Fred-Guo0422/H93_LDCU_EOL_TESTER/document/产品图纸/H93_左域控制器LDCU成品接口_20221212.pdf

版本记录 Project | H93 Product | 左域控制器 序号 | 版本 | 描述 | 作者 | 日期 1 | V1.0 | 1,初版整理输出 | 陈武/陈敏其 | 2022/12/15 小鹏汽车

| J1_J2_J4_J5_J10_J11连接器

接插件信息

| 工作电流 | 电源类型 | 常电
| 最大电流 | 持续时间
| 堵转电流(若有） | 持续时间
线束端 | TE:284972-1 TE:06-51061-1 TE:284972-2 TE:1-1718484-1 TE:06-51061-2 TE:114-18721 TE:06-51061-3 TE:284972-3 TE:936619-2 TE:2302454-1 电器端 TE:114-61045 TE:2401924-1 电气信息（12V)

PIN脚定义
序号 | PIN脚号 | 缩写功能 | 功能 | 电流 | 信号去向 | 信号类型 | 备注
Pressfit：2323854-2 连接器：06-51061-1 线端：284972-1(0.64*52)
1 | J1-1 | J_DO_LS_12VPWR2RLY | 500mA | 低边输出
2 | J1-2 | J_DO_LS_REOPRly | 500mA | 低边输出
3 | J1-3 | J_ECANH | 100mA | CAN
4 | J1-4 | J_ECANL | 100mA | CAN
5 | J1-5 | J_DI_SlowChargeWake_HS | 10mA | 高边输入
6 | J1-6 | J_DI_BrakeSw1_HS | 10mA | 高边输入
7 | J1-7 | J_LFDrive_IMMO_N | 2A | 低频天线驱动
8 | J1-8 | J_LFDrive_IMMO_P | 2A | 低频天线驱动
9 | J1-9 | J_LFDrive_PassengerDoor_P | 2A | 低频天线驱动
10 | J1-10 | J_LFDrive_PassengerDoor_N | 2A | 低频天线驱动
11 | J1-11 | J_LFDrive_TailBumper_N | 2A | 低频天线驱动
12 | J1-12 | J_LFDrive_TailBumper_P | 2A | 低频天线驱动
13 | J1-13 | J_LFDrive_Forward_N | 2A | 低频天线驱动
14 | J1-14 | J_DO_LS_12VPower1 | 500mA | 低边输出
15 | J1-15 | J_DO_LS_VaccumPumpRly | 500mA | 低边输出
16 | J1-16 | | 500mA | 低边输出
17 | J1-17 | J_DO_LS_CarpetLight | 500mA | 低边输出
18 | J1-18 | J_DI_QuickChargeWake_HS | 10mA | 高边输入
19 | J1-19 | Sensor_GND | 500mA | GND
20 | J1-20 | NC
21 | J1-21 | Sensor_GND | 500mA | GND
22 | J1-22 | NC
23 | J1-23 | NC
24 | J1-24 | J_LFDrive_DrvDoor_N | 2A | 低频天线驱动
25 | J1-25 | J_LFDrive_DrvDoor_P | 2A | 低频天线驱动
26 | J1-26 | J_LFDrive_Forward_P | 2A | 低频天线驱动
27 | J1-27 | J_PO_DiffuseCeilingLamp | 500mA | 低边输出
28 | J1-28 | Sensor_GND | 500mA | GND
29 | J1-29 | J_DI_DCULifeBeat_Wake_LS | 10mA | 低边输入
30 | J1-30 | J_DI_SRSCrash_LS | 10mA | 低边输入
31 | J1-31 | Sensor_GND | 500mA | GND
32 | J1-32 | Sensor_GND | 500mA | GND
33 | J1-33 | Sensor_GND | 500mA | GND
34 | J1-34 | NC
35 | J1-35 | Sensor_GND | 500mA | GND
36 | J1-36 | Sensor_GND | 500mA | GND
37 | J1-37 | Sensor_GND | 500mA | GND
38 | J1-38 | Sensor_GND | 500mA | GND
39 | J1-39 | J_LFDrive_Trunk_P | 2A | 低频天线驱动
40 | J1-40 | J_DO_LS_CWCEN | 500mA | 低边输出
41 | J1-41 | Sensor_GND | 500mA | GND
42 | J1-42 | Sensor_GND | 500mA | GND
43 | J1-43 | Sensor_GND | 500mA | GND
44 | J1-44 | J_DI_TrunkOpenSw_LS | 10mA | 低边输入
45 | J1-45 | J_DI_RLDoorReleaseSW_LS | 10mA | 低边输入
46 | J1-46 | J_DI_EmergencyAlarmSw_LS | 10mA | 低边输入
47 | J1-47 | J_DI_BrakeSw2_HS | 10mA | 高边输入
48 | J1-48 | NC
49 | J1-49 | NC
50 | J1-50 | Sensor_GND | 500mA | GND
51 | J1-51 | Sensor_GND | 500mA | GND
52 | J1-52 | J_LFDrive_Trunk_N | 2A | 低频天线驱动
Pressfit：2323854-2 连接器：06-51061-2 线端：284972-2(0.64*52)
1 | J2-1 | J_DI_KL15_BackUp_HS | 10mA | 低边输入
2 | J2-2 | J_5V_SensorPower2 | 100mA | 电源输出
3 | J2-3 | J_DO_HS_BMSEmergencyStop | 500mA | 高边输出
4 | J2-4 | J_DO_HS_KL15_BackUp | 1A | KL15电源输出
5 | J2-5 | J_DO_HS_PM2.5_FANCtr | 500mA | 高边输出
6 | J2-6 | J_DO_LS_RLDoorHandleLight | 500mA | 低边输出
7 | J2-7 | J_DI_FLTopLightSw_LS | 10mA | 低边输入
8 | J2-8 | J_AI_EmergencyPowerOff | 50mA | 模拟输入
9 | J2-9 | J_DO_HS_MainPowerWake1 | 1.5A | 高边输出
10 | J2-10 | J_DO_HS_KL15Wake1 | 1.5A | 高边输出

11 | J2-11 | J_AI_SeatRowSecLtSBRSt | 50mA | 模拟输入 12 | J2-12 | J_DO_HS_CDCUWake | 1.5A | 高边输出 13 | J2-13 | J_DO_HS_CDCWake | 1.5A | 高边输出 14 | J2-14 | J_PI_DriveHVIL_Fb | 10mA | PWM输入 15 | J2-15 | Sensor_GND | 500mA | GND 16 | J2-16 | Sensor_GND | 500mA | GND 17 | J2-17 | NC 18 | J2-18 | J_DI_RLTopLightSw_LS | 10mA | 低边输入 19 | J2-19 | J_DI_AeriaReadLampSW_LS | 10mA | 数字输入 20 | J2-20 | J_AI_ThirdRowLtSBRSt | 10mA | 模拟输入 21 | J2-21 | J_DI_BrakeFluidLevel_LS | 10mA | 低边输入 22 | J2-22 | J_DI_ThirdRowBeltMid_LS | 10mA | 数字输入 23 | J2-23 | J_DI_RLVoiceSw_LS | 10mA | 低边输入 24 | J2-24 | J_AI_DrvSeatTemp | 10mA | 模拟输入 25 | J2-25 | J_DO_HS_CameraHeated | 3A | 高边输出 26 | J2-26 | J_DO_HS_MainPowerWake2 | 1.5A | 高边输出 27 | J2-27 | J_PI_ChargeHVIL_Fb | 10mA | PWM输入 28 | J2-28 | NC 29 | J2-29 | Sensor_GND | 500mA | GND 30 | J2-30 | J_DI_RLDoorAjarSW_LS | 10mA | 低边输入 31 | J2-31 | J_DI_RLOutHandle_LS | 10mA | 低边输入 32 | J2-32 | J_DI_ThirdRowBeltLt_LS | 10mA | 数字输入 33 | J2-33 | J_AI_DrvSeatAdjSwBackInc | 10mA | 模拟输入 34 | J2-34 | J_PI_DrvSeatHeightHALLFb | 10mA | PWM输入 35 | J2-35 | J_AI_DrvSeatAdjSwSld | 10mA | 模拟输入 36 | J2-36 | J_AI_AbatVentOpenSw_LS | 10mA | 模拟输入 37 | J2-37 | J_DO_HS_ReverseLamp | 1.5A | 高边输出 38 | J2-38 | J_DO_HS_IntLgthPower | 500mA | 高边输出 39 | J2-39 | J_DO_HS_LampLimpHomeOut | 1A | 高边输出 40 | J2-40 | J_PI_DrvSeatBackIncHALLFb | 10mA | PWM输入 41 | J2-41 | J_PI_AbatVentHALLFb | 10mA | PWM输入 42 | J2-42 | J_PI_RLWindow_HallFb1 | 10mA | PWM输入 43 | J2-43 | J_DI_RLDoorPawlSW_LS | 10mA | 数字输入 44 | J2-44 | J_PI_RLWindow_HallFb2 | 10mA | PWM输入 45 | J2-45 | J_PI_DrvSeatSldHALLFb | 10mA | PWM输入 46 | J2-46 | J_AI_DrvSeatAdjSwHei | 10mA | 模拟输入 47 | J2-47 | J_AI_ASCtrSw | 10mA | 模拟输入 48 | J2-48 | J_AI_DrvSeatAdjSwFrntHei | 10mA | 模拟输入 49 | J2-49 | J_AI_SRLAbatVentSw | 10mA | 模拟输入 50 | J2-50 | J_DO_HS_LCarpetLight | 3.2A | 全桥驱动 51 | J2-51 | J_HBridge_RSHCCtr- | 3.2A | 全桥驱动 52 | J2-52 | J_DO_HS_RDCUWake | 1A | 高边输出 Pressfit：2323881-4, 2323889-2 连接器：114-18721 线端：1-1718484-1(1.5*18+2.8*7) 1 | J4-1 | J_DO_HS_BrakeLamp | 5A | 高边输出 2 | J4-2 | J_DO_HS_IMSPower | 5A | 高边输出 3 | J4-3 | J_Hbridge_DrvSeatFrntHei+ | 20A | 全桥驱动 4 | J4-4 | J_Hbridge_DrvSeatBackInc- | 20A | 全桥驱动 5 | J4-5 | SteeringWheelHeatedReturn | 20A | 全桥驱动 6 | J4-6 | J_HBridge_AbatVentCtr+ | 20A | 全桥驱动 7 | J4-7 | J_HBridge_AbatVentCtr- | 20A | 全桥驱动 8 | J4-8 | J_Hbridge_DrvSeatHei- | 30A | 全桥驱动 9 | J4-9 | J_Hbridge_DrvSeatHei+ | 30A | 全桥驱动 10 | J4-10 | J_HBridge_RLDoorLockCtr+ | 4.4A | PWM全桥驱动 11 | J4-11 | J_HBridge_RLDoorLockCtr- | 4.4A | PWM全桥驱动 12 | J4-12 | J_HBridge_RLHandleCtr- | 1.1A/12A | 全桥驱动 13 | J4-13 | J_HBridge_RLHandleCtr+ | 1.1A/12A | 全桥驱动 14 | J4-14 | Sensor_GND | 500mA | GND 15 | J4-15 | J_DO_HS_LtSlideDoor | 2A/5A | 高边输出 16 | J4-16 | J_DO_HS_MainPowerWake3 | 3A | 高边输出 17 | J4-17 | J_DO_HS_Backlight | 500mA | 高边驱动 18 | J4-18 | J_DO_HS_ATLPower | 2A | 高边驱动 19 | J4-19 | J_Hbridge_EPBCtr+ | 30A | 全桥驱动 20 | J4-20 | J_Hbridge_EPBCtr- | 30A | 全桥驱动 21 | J4-21 | Sensor_GND | 500mA | GND 22 | J4-22 | J_HBridge_FLCinchMotorCtr- | 30A | PWM全桥驱动 23 | J4-23 | J_HBridge_FLCinchMotorCtr+ | 30A | PWM全桥驱动 24 | J4-24 | J_Hbridge_RLWindowCtr+ | 12A/31A | 全桥驱动 25 | J4-25 | J_Hbridge_RLWindowCtr- | 12A/31A | 全桥驱动 Pressfit：2323854-2 连接器：06-51061-3 线端：284972-3(0.64*52) 1 | J5-1 | J_PCANH | 100mA | PCAN_H 2 | J5-2 | J_PO_LS_FLTopLight | 500mA | PWM低边输出 3 | J5-3 | J_PO_LS_FRTopLight | 500mA | PWM低边输出 4 | J5-4 | J_PO_LS_FMTopLight | 500mA | PWM低边输出 5 | J5-5 | J_PO_LS_RLTopLight | 500mA | PWM低边输出 6 | J5-6 | J_PO_LS_TLTopLight | 500mA | PWM低边输出 7 | J5-7 | J_PO_LS_TrunkLight | 500mA | PWM低边输出 8 | J5-8 | J_ICANH | 100mA | ICAN_H 9 | J5-9 | J_ICANL | 100mA | ICNA_L 10 | J5-10 | J_AI_ChargeTemp3 | 10mA | 模拟输入 11 | J5-11 | J_UWBCANH | 100mA | UWBCAN_H 12 | J5-12 | J_UWBCANL | 100mA | UWBCAN_L 13 | J5-13 | J_LIN_LSU/Heated | 50mA | LIN 通讯 14 | J5-14 | J_PCANL | 100mA | PCAN_L 15 | J5-15 | J_DO_HS_IMS_Heated | 3.2A | 全桥驱动 16 | J5-16 | J_PO_ChargeHVILOut | 500mA | PWM输出 17 | J5-17 | Sensor_GND | 500mA | GND 18 | J5-18 | NC 19 | J5-19 | NC 20 | J5-20 | J_DI_FRTopLightSw_LS | 10mA | 低边输入 21 | J5-21 | J_DI_RLChildLockOrDoorOpen_LS | 10mA | 低边输入 22 | J5-22 | NC 23 | J5-23 | J_AI_PDUTempSensor2 | 50mA | 模拟输入 24 | J5-24 | J_AI_ChargeDirectTemp4 | 50mA | 模拟输入 25 | J5-25 | J_LIN_PWS | 50mA | LIN通讯 26 | J5-26 | J_LIN_RFR | 50mA | LIN通讯

27 | J5-27 | J_HBridge_LSHCCtr- | 3.2A | 全桥驱动 28 | J5-28 | J_LIN_FKS | 50mA | LIN通讯 29 | J5-29 | NC 30 | J5-30 | NC 31 | J5-31 | J_DI_RSHCPosSW_LS | 10mA | 低边输入 32 | J5-32 | J_DI_TLTopLightSw_LS | 10mA | 数字输入 33 | J5-33 | NC 34 | J5-34 | J_AI_ChargeDirectTemp3 | 50mA | 模拟输入 35 | J5-35 | J_AI_MotorWaterTempSensorB | 50mA | 模拟输入 36 | J5-36 | J_AI_ChargeTemp2 | 50mA | 模拟输入 37 | J5-37 | J_AI_ChargeDirectTemp2 | 50mA | 模拟输入 38 | J5-38 | J_AI_PDUTempSensor1 | 50mA | 模拟输入 39 | J5-39 | J_AI_AccPositionSensor1 | 50mA | 模拟输入 40 | J5-40 | J_HBridge_LChildLockCtr- | 4.4A/6A | 全桥驱动 41 | J5-41 | J_HBridge_Reserve2- | 1.8A | 全桥驱动 42 | J5-42 | J_5V_SensorPower1 | 100mA | 电源输出 43 | J5-43 | J_DO_HS_HallPower | 500mA | 电源输出 44 | J5-44 | J_5V_SENSOR_POWER3 | 100mA | 电源输出 45 | J5-45 | J_DI_RLHandleExtSw | 10mA | 低边输入 46 | J5-46 | J_PI_PM2.5DendityFb | 10mA | PWM输入 47 | J5-47 | J_AI_AccPositionSensor2 | 50mA | 模拟输入 48 | J5-48 | J_AI_RLWindowCtrSw | 10mA | 模拟输入 49 | J5-49 | J_AI_ChargeDirectTemp1 | 50mA | 模拟输入 50 | J5-50 | J_AI_ChargeTemp1 | 50mA | 模拟输入 51 | J5-51 | J_AI_BatteryWaterTempSensorB | 10mA | 模拟输入 52 | J5-52 | J_DI_MLTopLightSw_LS | 10mA | 数字输入 Pressfit：1823524-2 连接器：114-61045 线端：936619-2(9.5*2) 1 | J10-1 | BAT | 50A | 电源输入 | KL30电源 2 | J10-2 | GND | 50A | 电源接地 | 搭铁接地 2 PIN 2401924-1 | 线端型号：2302454-1 1 | J11_1 | J_PHY_TRX_M | 50mA | 以太网 | 以太网 2 | J11_2 | J_PHY_TRX_P

| J3连接器
接插件信息 | 线束端 | TE:2321525-1
| 电器端 | TE:114-160307-1
电气信息（12V) | 工作电流 | | 电源类型 | 常电
| 最大电流 | | 持续时间
| 堵转电流(若有） | | 持续时间

PIN脚定义

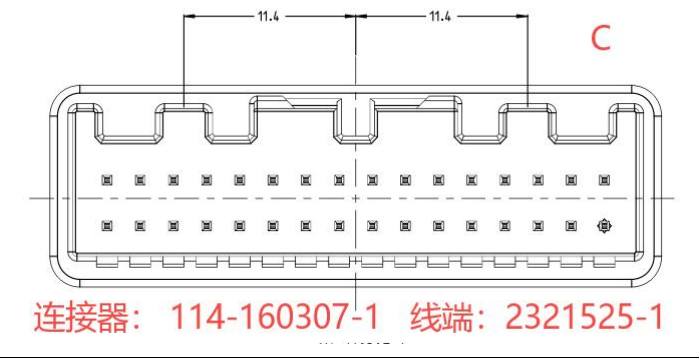
[picture p1: figure]
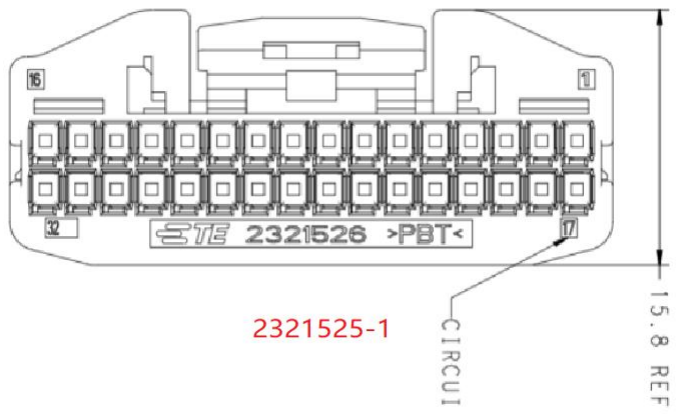
[picture p2: figure]

序号 | PIN脚号 | 缩写功能 | 功能 | 电流 | 信号去向 | 信号类型 | 备注
Pressfit：2323854-2 连接器： 114-160307-1 | 线端：2321525-1(0.64*32)
1 | J3-1 | NC
2 | J3-2 | J_LIN_AGS/EBS | 50mA | | LIN 通信
3 | J3-3 | J_AI_BatteryWaterTempSensorA | 100mA | | 模拟输入
4 | J3-4 | J_AI_VacuumPressSensor | 100mA | | 模拟输入
5 | J3-5 | Sensor_GND | 500mA | | GND
6 | J3-6 | J_5V_SENSOR_POWER2 | 100mA | | 供电输出
7 | J3-7 | J_CCANH | 100mA | | CCAN_H
8 | J3-8 | J_CCANL | 100mA | | CCAN_L
9 | J3-9 | J_AI_MotorWaterTempSensorA | 100mA | | 模拟输入
10 | J3-10 | J_DO_LS_BatteryPumpRly | 500mA | | 低边输出
11 | J3-11 | J_DO_LS_FanRly | 500mA | | 低边输出
12 | J3-12 | J_PO_LS_LCarpetLight | 500mA | | PWM低边输出
13 | J3-13 | J_DO_LS_FEOPRly | 500mA | | 低边输出
14 | J3-14 | J_DO_LS_MotorPumpRly | 500mA | | 低边输出
15 | J3-15 | J_PO_LS_FanSpeedCtr | 500mA | | PWM输出
16 | J3-16 | J_PO_LS_MotorPumpSpeedCtr | 500mA | | PWM输出
17 | J3-17 | Sensor_GND | 500mA | | GND
18 | J3-18 | NC
19 | J3-19 | J_DI_BrakeFluidLevel_LS | 10mA | 数字低边输入
20 | J3-20 | Sensor_GND | 500mA | | GND
21 | J3-21 | NC
22 | J3-22 | NC
23 | J3-23 | Sensor_GND | 500mA | | GND
24 | J3-24 | NC
25 | J3-25 | J_DO_HS_FSRRPower | 2A | | 高边输出
26 | J3-26 | J_PI_AbatVentHALLFb2 | 50mA | | PWM输入
27 | J3-27 | J_PI_FanFb | 100mA | | PWM输入
28 | J3-28 | J_PI_AbatVentHALLFb1 | 50mA | | PWM输入
29 | J3-29 | Sensor_GND | 500mA | | GND
30 | J3-30 | J_PO_DriveHVILOut | 500mA | | PWM输出
31 | J3-31 | J_DI_VacuumPumpRlyFb_HS | 50mA | | 数字输入
32 | J3-32 | J_DO_LS_DeforstrRly | 500mA | | 低边输出

| J8_J9连接器
接插件信息 | 线束端 | TE:2322347-1 TE:2325415-1
| 电器端 | TE:114-101068-1 TE:1379779
电气信息（12V) | 工作电流 | | 电源类型 | 常电
| 最大电流 | | 持续时间
| 堵转电流(若有） | | 持续时间

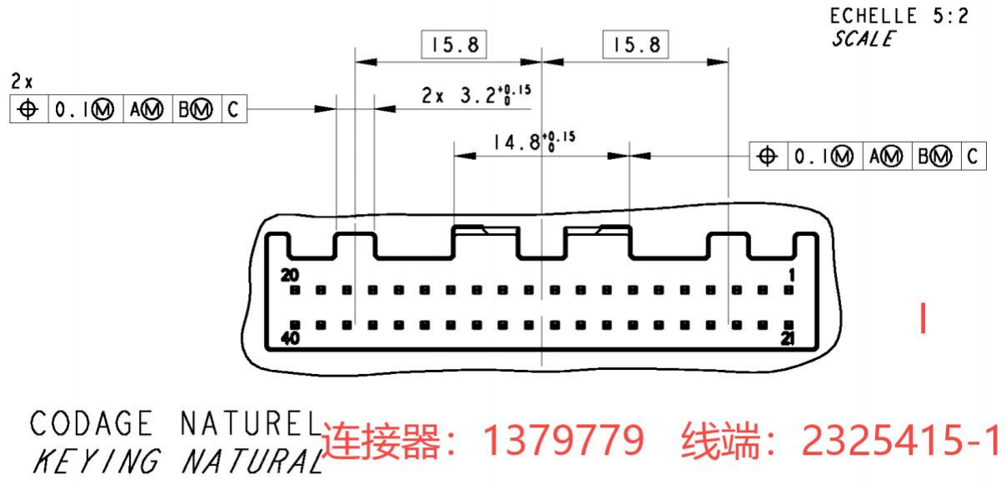
[picture p3: figure]

PIN脚定义

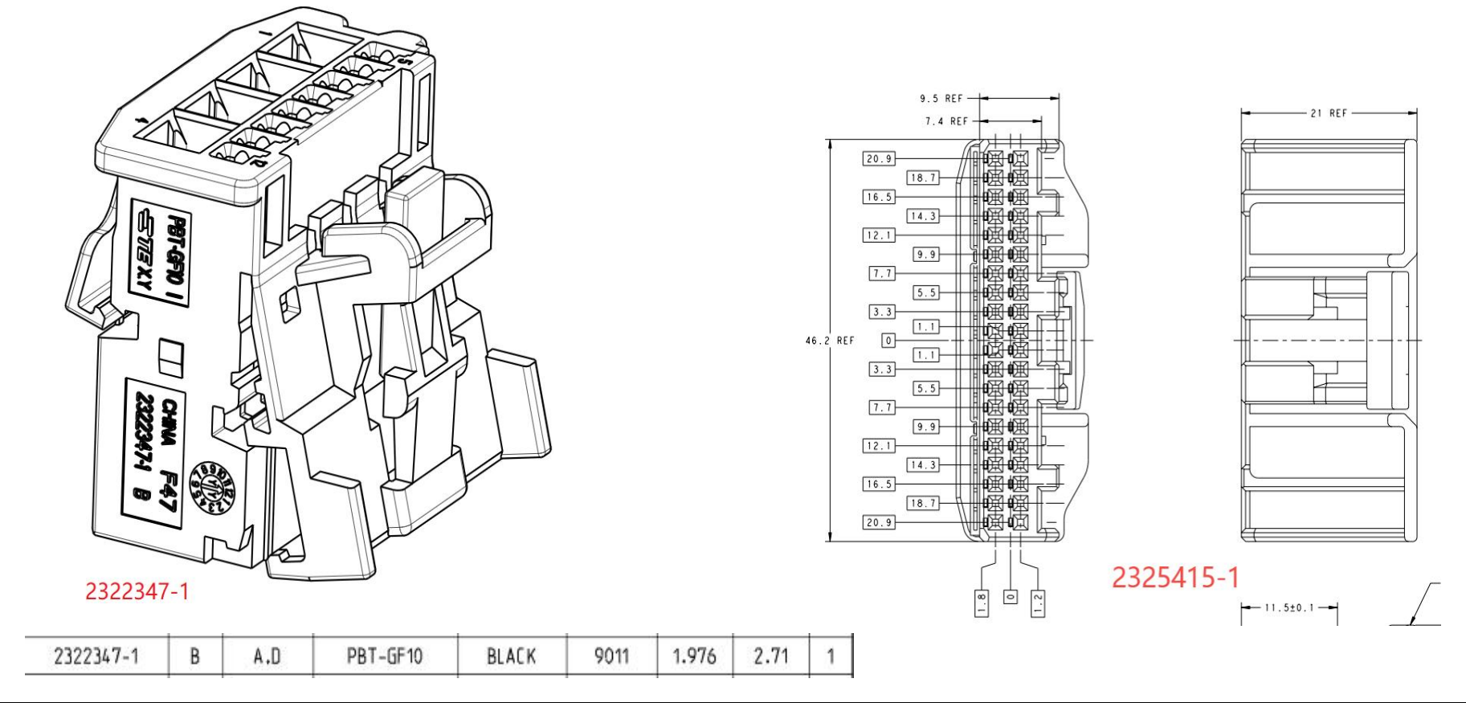
[picture p4: figure]

序号 | PIN脚号 | 缩写功能 | 功能 | 电流 | 信号去向 | 信号类型 | 备注
Pressfit：2323854-2, 2323889-2 连接器：114-101068-1 线端：2322347-1(0.64*8+2.8*4)
1 | J8-1 | J_HBridge_FLHandleCtr+ | 1.1A/12A | 全桥驱动
2 | J8-2 | J_HBridge_FLCWindowCtr- | 12A/31A | 全桥驱动
3 | J8-3 | J_HBridge_FLCWindowCtr+ | 12A/31A | 全桥驱动
4 | J8-4 | J_DO_HS_LeftMirrorHeated | 5A | 高边驱动
5 | J8-5 | J_HBridge_FLHandleCtr- | 1.1A/12A | 全桥驱动
6 | J8-6 | J_HBridge_FMirrorFoldCtr- | 2A | 全桥驱动
7 | J8-7 | J_HBridge_FMirrorFoldCtr+ | 2A | 全桥驱动
8 | J8-8 | J_DO_HS_IntLgthPower | 500mA | 高边驱动
9 | J8-9 | J_HBridge_FMirrorLRCtr- | 2A | 全桥驱动
10 | J8-10 | J_HBridge_FMirrorCtr+ | 2A | 全桥驱动
11 | J8-11 | J_DO_HS_HallPower | 500mA | 高边输出
12 | J8-12 | J_HBridge_FMirrorUDCtr- | 2A | 全桥驱动
Pressfit：2323854-2 连接器：1379779 | 线端：2325415-1(0.64*40)
1 | J9-1 | J_PI_FLWindow_HallFb2 | 10mA | PWM输入
2 | J9-2 | J_DI_FLDoorReleaseSW_LS | 10mA | 低边输入
3 | J9-3 | J_DI_FLOutHandle_LS | 10mA | 低边输入
4 | J9-4 | J_DI_FLDoorLockOrOutHandle_LS | 10mA | 低边输入
5 | J9-5 | J_DO_HS_ATLPower | 2A | 高边输出
6 | J9-6 | J_DO_LS_LBSDLight | 500mA | 低边输出
7 | J9-7 | J_DO_HS_WinLockLight | 500mA | 高边输出
8 | J9-8 | J_PO_LS_LCarpetLight | 500mA | 低边输出
9 | J9-9 | J_DO_LS_LDOWLight | 500mA | 低边输出
10 | J9-10 | J_DO_LS_LFDoorHandleLight | 500mA | 低边输出
11 | J9-11 | J_DO_HS_Backlight | 2A | 高边输出
12 | J9-12 | Sensor_GND | 500mA | GND
13 | J9-13 | Sensor_GND | 500mA | GND
14 | J9-14 | Sensor_GND | 500mA | GND
15 | J9-15 | Sensor_GND | 500mA | GND
16 | J9-16 | Sensor_GND | 500mA | GND
17 | J9-17 | J_AI_LMirrorTemp | 10mA | 模拟输入
18 | J9-18 | J_AI_DRLWindowCtrSw | 10mA | 模拟输入
19 | J9-19 | J_DI_FLGearHomeSW_LS | 10mA | 数字输入
20 | J9-20 | J_HBridge_FLDoorLockCtr+ | 4.4A | PWM全桥驱动
21 | J9-21 | J_PI_FLWindow_HallFb1 | 10mA | PWM 输入
22 | J9-22 | J_DI_FLDoorAjarSW_LS | 10mA | 低边输入
23 | J9-23 | J_5V_SensorPower3 | 100mA | 电源输出
24 | J9-24 | J_DI_CentralOpenLockSw_LS | 10mA | 低边输入
25 | J9-25 | J_DI_CentralCloseLockSw_LS | 10mA | 低边输入
26 | J9-26 | J_DI_LFHandleExtSw | 10mA | 低边输入
27 | J9-27 | J_DI_LFHandleRetSw | 10mA | 低边输入
28 | J9-28 | J_AI_MirrorDirSw | 10mA | 模拟输入
29 | J9-29 | J_DI_FLDoorHomeSwitch_LS | 10mA | 数字输入
30 | J9-30 | J_AI_MirrorSelectSw | 10mA | 模拟输入
31 | J9-31 | J_AI_LMirrorLRPositionFb | 10mA | 模拟输入
32 | J9-32 | J_AI_DRRWindowCtrSw | 10mA | 模拟输入
33 | J9-33 | J_AI_LMirrorUDPositionFb | 10mA | 模拟输入
34 | J9-34 | J_AI_DFRWindowCtrSw | 10mA | 模拟输入
35 | J9-35 | J_AI_DFLWindowCtrSw | 10mA | 模拟输入
36 | J9-36 | J_DI_WinLockSw_LS | 10mA | 低边输入
37 | J9-37 | J_DI_FLDoorPawlSW_LS | 10mA | 数字输入
38 | J9-38 | Sensor_GND | 500mA | GND
39 | J9-39 | J_DI_FLDoorOpenSw_LS | 10mA | 低边输入
40 | J9-40 | J_HBridge_FLDoorLockCtr- | 4.4A | PWM全桥驱动

| J6_J7连接器
接插件信息 | 线束端 | TE:2322347-2 TE:2329592-1
| 电器端 | TE:114-101068-2 TE:114-101074
电气信息（12V) | 工作电流 | | 电源类型 | 常电
| 最大电流 | | 持续时间
| 堵转电流(若有） | | 持续时间

PIN脚定义

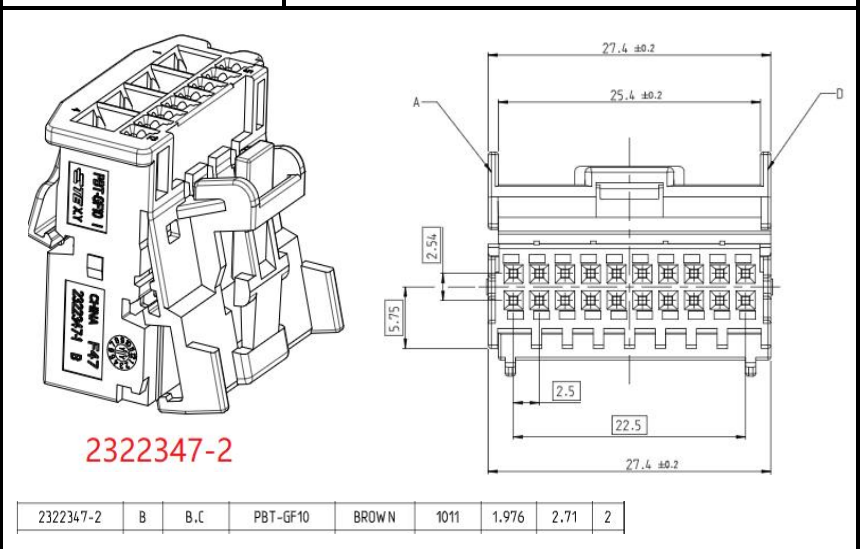
[picture p5: figure]

序号 | PIN脚号 | 缩写功能 | 功能 | 电流 | 信号去向 | 信号类型 | 备注
Pressfit：2323854-2, 2323889-2 连接器：114-101068-2 | 线端：2322347-2(0.64*8+2.8*4)
1 | J6-1 | J_DO_HS_SteeringWheelHeatedCtr | 10A | 高边输出
2 | J6-2 | J_Hbridge_ESCCUUpDown+ | 10A | 全桥驱动
3 | J6-3 | J_Hbridge_ESCCUForwardBackward+ | 10A | 全桥驱动
4 | J6-4 | J_Hbridge_ESCCUCom+ | 10A | 全桥驱动
5 | J6-5 | J_PO_LS_LFootLight | 500mA | 低边驱动
6 | J6-6 | Sensor_GND | 500mA | GND
7 | J6-7 | NC
8 | J6-8 | Sensor_GND | 500mA | GND
9 | J6-9 | J_PI_ESCCUpDown_HallFb | 100mA | PWM输入
10 | J6-10 | J_PI_ESCCUForwardBackward_HallFb | 100mA | PWM输入
11 | J6-11 | J_5V_SENSOR_POWER1 | 100mA | 电源输出
12 | J6-12 | J_AI_GearShift_N2 | 10mA | 模拟输入
Pressfit：2323854-2, 2323889-2 连接器：114-101074 | 线端：2329592-1
1 | J7-1 | J_DO_HS_HallPower | 500mA | 高边输出
2 | J7-2 | J_DO_HS_IntLgthPower | 500mA | 高边输出
3 | J7-3 | Sensor_GND | 500mA | GND
4 | J7-4 | NC
5 | J7-5 | NC
6 | J7-6 | J_AI_GearShift_R2 | 10mA | 模拟输入
7 | J7-7 | J_AI_GearShift_R1 | 10mA | 模拟输入
8 | J7-8 | J_AI_GearShift_N1 | 10mA | 模拟输入
9 | J7-9 | J_AI_GearShift_P1 | 10mA | 模拟输入
10 | J7-10 | J_AI_GearShift_D2 | 10mA | 模拟输入
11 | J7-11 | J_DO_HS_SWSPower | 3A | 高边输出
12 | J7-12 | J_DO_HS_Backlight | 1A | 高边输出
13 | J7-13 | J_DO_HS_ATLPower | 2A | 高边输出
14 | J7-14 | J_AI_SteeringWheelTemp | 10mA | 模拟输入
15 | J7-15 | J_AI_InCarTempSensor | 10mA | 模拟输入
16 | J7-16 | J_AI_AtmosphericPressSensor | 10mA | 模拟输入
17 | J7-17 | J_AI_GearShift_P2 | 10mA | 模拟输入
18 | J7-18 | Sensor_GND | 500mA | GND
19 | J7-19 | Sensor_GND | 500mA | GND
20 | J7-20 | J_AI_GearShift_D1 | 10mA | 模拟输入
