Fred-Guo0422/H93_LDCU_EOL_TESTER/document/产品图纸/H93_左域_LDCU_EOL测试通信协议_V1.5-20230414.pdf

版本记录 Project | H93
Product | 左域
序号 | 版本 | 描述 | 作者 | 日期
1 | V1.0 | 1.初版创建输出 | 陈敏其 | 2022/12/16
2 | V1.1 | 1.增加配置信息 | 陈敏其 | 2023/1/13
3 | V1.2 | 1.更新测试协议项目名称与连接器位置，更新DID内容 | 陈敏其 | 2023/2/22
4 | V1.3 | 1.根据LDCU_EMC_Protocol_SR1.0_202300403修改 | 陈敏其 | 2023/4/6
5 | V1.4 | 1.修正PO部分的start bit协议 | 陈敏其 | 2023/4/12
5 | V1.5 | 1.修正PO部分协议 | 陈敏其 | 2023/4/14

# 小鹏汽车

# H93左域程序烧录流程

小鹏汽车

# 小鹏汽车

# H93左域诊断通信为CANFD

# H93左域PCBA FCT功能测试流程


# 小鹏汽车

# 小鹏汽车

# 基于UDS on CANFD标准进行通信: 1, EOL模式进入: 分别发送10 03和10 60，分别获取到正反馈50 03 XX XX XX XX

# XX XX和50 60 XX XX XX XX XX XX后即进入EOL测试模式 2, 安全访问: 请求Seed: 27 01，正反馈67 01 XX XX XX XX 计算Key 发送Key: 27 02 XX XX XX XX，正反馈67 02

3, RoutineControl通信: 发送请求: 31 01 + RID + Cmd_Data 获取结果: 31 03 + RID 备注: 1) 对于数字输入/模拟输入/PWM 输入等获取结果的，发

# 送命令为31 03 + RID; 2) 对于数字输出/PWM输出/电机控制输

# 出等控制信号输出，发送指令为31 01 + RID + Cmd_Data，RID 和Cmd_Data参考协议部分

# 4, 产品软重启指令11 01需要在Default模式(10 01)下发送; H93左域诊断通信为CANFD

H93左域EOL功能测试流程 基于UDS on CANFD标准进行通信: 1, EOL模式进入: 分别发送10 03和10 60，分别获取到正反馈50 03 XX XX XX XX XX XX和50 60 XX XX XX XX XX XX后即进入EOL测试模式 2, 安全访问: 请求Seed: 27 01，正反馈67 01 XX XX XX XX 计算Key 发送Key: 27 02 XX XX XX XX，正反馈67 02 3, RoutineControl通信: 发送请求: 31 01 + RID + Cmd_Data 获取结果: 31 03 + RID 备注: 1) 对于数字输入/模拟输入/PWM 输入等获取结果的，发 送命令为31 03 + RID; 2) 对于数字输出/PWM输出/电机控制输 出等控制信号输出，发送指令为31 01 + RID + Cmd_Data，RID 和Cmd_Data参考协议部分 4, 产品软重启指令11 01需要在Default模式(10 01)下发送; H93左域诊断通信为CANFD

| H93左域EOL测试通信协议

# 产品参数

CANFD ID: 1,Request: 0x7E0; 2,Response: 0x7E8 参数项目 | DID | UDS服务 | 读写 | 长度(Byte) | 读写格式 (UDS) | 备注
软件版本号 | 0xF189 | 22 | 读 | 17 | 22 F1 89 | 烧录/FCT/EOL 都需要读取
硬件版本号 | 0xF17F | 22 | 读 | 17 | 22 F1 7F | 烧录/FCT/EOL 都需要读取
零件物料号 | 0xF187 | 2E/22 | 读写 | 14 | 写: 2E F1 87 [零件物料号信息 ]; 读: 22 F1 87 | 零件物料号信息只需在程序烧录台写入即可 ，FCT/EOL 不需写入
基础软件版本号 | 0xA5F0 | 22 | 读 | 10 | 22 A5 F0 | 烧录/FCT/EOL 都需要读取
Boot软件版本号 | 0xF180 | 22 | 读 | 17 | 22 F1 80 | 烧录/FCT/EOL 都需要读取
产品序列号 (PCBA条码,16位) | 0xF18C | 2E/22 | 读写 | 16 | 写: 2E F1 8C [产品序列号信息 ]; 读: 22 F1 8C | 产品序列号只需在程序烧录台写入即可 ，FCT/EOL不需写入
ECU下线日期 | 0xF18B | 2E/22 | 读写 | 4 | 写: 2E F1 8B [下线日期信息 ]; 读: 22 F1 8B | 只需在EOL台写入，其他不需要
| 0xA5F5 | 2E/22 | 读写 | 24 | 写: 2E A5 F5 [追溯编码信息 ]; 读: 22 A5 F5 | 日期信息是 BCD码，如20221016则为0x20 0x22 0x10 0x16 追溯编码 只需在EOL台写入，其他不需要
钥匙参数 | 0xCF0A | 2E/22 | 读写 | 4 | 写: 2E CF 0A [钥匙参数值]; 读: 22 CF 0A | 只需在EOL台写入，其他不需要 1,该参数从1开始(假如是第1个产品)，然后实行累加到 65535(假如是第65535个产品)后又重新从 1开 始; 2,发送顺序为 : 0x00(byte0) 0x00(byte1) 0x00(byte2) 0x00(byte3), 例如从0x00 0x00 0x00 0x01; 0x00 0x00 0x00 0x02 ; ... ;0x00 0x00 0xFF 0xFF进行累加,其中前面两个字节是预留的 ， 主要是用到后面两个字节 。
模块配置 | 0xCF08 | 2E/22 | 读写 | 16 | 写: 2E CF 08 [配置信息]; 读: 22 CF 08 | 只需要在烧录工站写入 ，其他不需要 Byte0:0x02 （车型代码：H93国内版） Byte1~Byte15:0x00 1.烧录：烧录完后写入 ，并在重启后读取检查 ； 2.FCT：开始测试时读取检查 ； 3.EOL：开始测试时读取检查 ；
| 0xA5F2 0x0A5F7 | 2E/22 2E/22 | 读写 读写 | 1 1 | 写: 2E A5 F2 [工厂模式值]; 读: 22 A5 F2 写: 2E A5 F7 [状态值]; 读: 22 A5 F7 | 备注：写指令： 2E CF 08 02 00 00 00 00 00 00 00 00 00 00 00 00 00 00 00 工厂模式 只需在FCT和EOL工位写入 1,FCT: 开始测试写入值 1F，并读取检查 ，测试完成后写入值 1E，并读取检查; 2,EOL: 开始测试写入值 1D，并读取检查 ，测试完成后写入值 10，并读取检查; 备注: 读取检查前需要断电重启或者软重启 (11 01); 电源模式状态 只需在EOL工位写入，并且需要在EOL其他功能都测试完后再写入
| | | | | | 1,EOL: 写入值0x00，并读取检查 ; 备注: 读取检查前需要断电重启或者软重启 (11 01);
DTC异常码查询 | DTC码 | 19 | 读 | 3 | 读: 19 04 xx xx xx FF | 只需在EOL工位读取
1,EOL: 读取xx xx xx（DTC码是否报异常 ）; 备注:需要在EOL其他功能都测试完后在读取 ; 0 J_ | J_ | 功能 | IO | Widgets | RID | RoutineControlTy | 长度 | 开始位 | 位长度 | 默认值 | 最小值 | 最大值 | Factor | Offset | 单位 | 周期(ms) | 互锁
0 Digital input | Digital input | Digital input | IO引脚 | pushButton | 0xC080 | 0x3 | 8 | 0 | 0 | 1 | 0 | 0 | 0 | 0 | 0 | - 0 M_DI_Win_RFRLIN_INH_HS | M_DI_Win_RFRLIN_INH_HS | 车窗/RFR LIN唤醒源识别 | J5-25/J5-26 | tableCell | 0xC080 | 0x3 | 8 | 0 | 1 | 0 | 0 | 1 | 1 | 0 | 0 | - 0 M_DI_PWSLIN_Wake_HS | M_DI_PWSLIN_Wake_HS | 左侧智能表面 LIN唤醒源识别 | U17_T642 | tableCell | 0xC080 | 0x3 | 8 | 1 | 1 | 0 | 0 | 1 | 1 | 0 | 0 | - 0 M_DI_ECAN_INH_HS | M_DI_ECAN_INH_HS | 预留CAN唤醒源识别 | J1-3/J1-4 | tableCell | 0xC080 | 0x3 | 8 | 2 | 1 | 0 | 0 | 1 | 1 | 0 | 0 | - 0 M_DI_CCAN_INH_HS | M_DI_CCAN_INH_HS | 预留CAN唤醒源识别 | J3-7/J3-8 | tableCell | 0xC080 | 0x3 | 8 | 3 | 1 | 0 | 0 | 1 | 1 | 0 | 0 | - 0 M_DI_ICAN_INH_HS | M_DI_ICAN_INH_HS | ICAN唤醒源识别 | J5_8/J5_9 | tableCell | 0xC080 | 0x3 | 8 | 4 | 1 | 0 | 0 | 1 | 1 | 0 | 0 | - 0 M_DI_UWBCAN_INH_HS | M_DI_UWBCAN_INH_HS | UWBCAN唤醒源识别 | J5_11/J5_12 | tableCell | 0xC080 | 0x3 | 8 | 5 | 1 | 0 | 0 | 1 | 1 | 0 | 0 | - 0 M_DI_ETNB_INT_LS | M_DI_ETNB_INT_LS | TJA1101中断输出 | U38_T122 | tableCell | 0xC080 | 0x3 | 8 | 6 | 1 | 0 | 0 | 1 | 1 | 0 | 0 | - 0 M_DI_ETH_INH | M_DI_ETH_INH | TJA1101唤醒识别 | U38_T623 | tableCell | 0xC080 | 0x3 | 8 | 7 | 1 | 0 | 0 | 1 | 1 | 0 | 0 | - 0 M_DI_NJJ290C0_INT_LS | M_DI_NJJ290C0_INT_LS | 低频驱动芯片 NJJ290C0中断反馈 ，芯片故障时反馈低电

平

U46_T572 | tableCell | 0xC080 | 0x3 | 8 | 8 | 1 | 0 | 0 | 1 | 1 | 0 | 0 | - 0 M_DI_FS6522_INTB_LS | M_DI_FS6522_INTB_LS | FS6522中断输出引脚 | U42_T353 | tableCell | 0xC080 | 0x3 | 8 | 9 | 1 | 0 | 0 | 1 | 1 | 0 | 0 | - 0 M_DI_L9369ACTOFFLS1A_FB | M_DI_L9369ACTOFFLS1A_FB | 关闭状态检测 | U29_T809 | tableCell | 0xC080 | 0x3 | 8 | 10 | 1 | 0 | 0 | 1 | 1 | 0 | 0 | - 0 M_DI_L9369ACTOFFLS2A_FB | M_DI_L9369ACTOFFLS2A_FB | U29_T914 | tableCell | 0xC080 | 0x3 | 8 | 11 | 1 | 0 | 0 | 1 | 1 | 0 | 0 | - 0 M_DI_RLHandleExtSw | M_DI_RLHandleExtSw | 左后门把手展开开关 | J5-45 | tableCell | 0xC080 | 0x3 | 8 | 12 | 1 | 0 | 0 | 1 | 1 | 0 | 0 | - 0 M_DI_RSHCPosSW_LS | M_DI_RSHCPosSW_LS | 预留 | J5-31 | tableCell | 0xC080 | 0x3 | 8 | 13 | 1 | 0 | 0 | 1 | 1 | 0 | 0 | - 0 M_DI_SRSCrash_LS | M_DI_SRSCrash_LS | 碰撞信号 | J1-30 | tableCell | 0xC080 | 0x3 | 8 | 14 | 1 | 0 | 0 | 1 | 1 | 0 | 0 | - 0 M_DI_AeriaReadLampSW_LS | M_DI_AeriaReadLampSW_LS | 二排左侧航空阅读灯开关 | J2-19 | tableCell | 0xC080 | 0x3 | 8 | 15 | 1 | 0 | 0 | 1 | 1 | 0 | 0 | - 0 M_DI_MLTopLightSw_LS | M_DI_MLTopLightSw_LS | 左中顶灯开关 | J5-52 | tableCell | 0xC080 | 0x3 | 8 | 16 | 1 | 0 | 0 | 1 | 1 | 0 | 0 | - 0 M_DI_DCULifeBeat_Wake_LS | M_DI_DCULifeBeat_Wake_LS | 右域心跳信号采样 | J1-29 | tableCell | 0xC080 | 0x3 | 8 | 17 | 1 | 0 | 0 | 1 | 1 | 0 | 0 | - 0 M_DI_LFHandleExtSw | M_DI_LFHandleExtSw | 左前门把手展开开关 | J9-26 | tableCell | 0xC080 | 0x3 | 8 | 18 | 1 | 0 | 0 | 1 | 1 | 0 | 0 | - 0 M_DI_LFHandleRetSw | M_DI_LFHandleRetSw | 左前门把手回收开关 | J9-27 | tableCell | 0xC080 | 0x3 | 8 | 19 | 1 | 0 | 0 | 1 | 1 | 0 | 0 | - 0 M_DI_VacuumPumpRlyFb_HS | M_DI_VacuumPumpRlyFb_HS | 真空泵继电器反馈 | J3-31 | tableCell | 0xC080 | 0x3 | 8 | 20 | 1 | 0 | 0 | 1 | 1 | 0 | 0 | - 0 M_DI_FLDoorHomeSwitch_LS | M_DI_FLDoorHomeSwitch_LS | 左前门HomeSwitch( 电吸门) | J9-29 | tableCell | 0xC080 | 0x3 | 8 | 21 | 1 | 0 | 0 | 1 | 1 | 0 | 0 | - 0 M_DI_TLTopLightSw_LS | M_DI_TLTopLightSw_LS | 三排顶灯开关 | J5-32 | tableCell | 0xC080 | 0x3 | 8 | 22 | 1 | 0 | 0 | 1 | 1 | 0 | 0 | - 0 M_DI_BrakeFluidLevel_LS | M_DI_BrakeFluidLevel_LS | 制动液位传感器 | J3-19/J2-21 | tableCell | 0xC080 | 0x3 | 8 | 23 | 1 | 0 | 0 | 1 | 1 | 0 | 0 | - 0 M_DI_KL15_BackUp_HS | M_DI_KL15_BackUp_HS | 左域KL15电冗余采样 | J2-1 | tableCell | 0xC080 | 0x3 | 8 | 24 | 1 | 0 | 0 | 1 | 1 | 0 | 0 | - 0 M_DI_CentralOpenLockSw_LS | M_DI_CentralOpenLockSw_LS | 中控解锁开关 | J9-24 | tableCell | 0xC080 | 0x3 | 8 | 25 | 1 | 0 | 0 | 1 | 1 | 0 | 0 | - 0 M_DI_CentralCloseLockSw_LS | M_DI_CentralCloseLockSw_LS | 中控闭锁开关 | J9-25 | tableCell | 0xC080 | 0x3 | 8 | 26 | 1 | 0 | 0 | 1 | 1 | 0 | 0 | - 0 M_DI_FLDoorAjarSW_LS | M_DI_FLDoorAjarSW_LS | 左前门开关状态 或
M_DI_FLDoorLockOrOutHandle_LS | 左前门锁状态 或 左前门半开状态 （电吸门配置 ） | J9-22 | tableCell | 0xC080 | 0x3 | 8 | 27 | 1 | 0 | 0 | 1 | 1 | 0 | 0 | - 0 M_DI_FLDoorLockOrOutHandle_LS
| 左前门外开门把手状态 （电吸门配置 ）
J9-4 | tableCell | 0xC080 | 0x3 | 8 | 28 | 1 | 0 | 0 | 1 | 1 | 0 | 0 | - 0 M_DI_FLDoorReleaseSW_LS | M_DI_FLDoorReleaseSW_LS | 主驾电释放开关信号 | J9-2 | tableCell | 0xC080 | 0x3 | 8 | 29 | 1 | 0 | 0 | 1 | 1 | 0 | 0 | - 0 M_DI_WinLockSwInput_LS | M_DI_WinLockSwInput_LS | 车窗锁止开关 | J9-36 | tableCell | 0xC080 | 0x3 | 8 | 30 | 1 | 0 | 0 | 1 | 1 | 0 | 0 | - 0 M_DI_FLGearHomeSW_LS | M_DI_FLGearHomeSW_LS | 左前门GearHome（电吸门） | J9-19 | tableCell | 0xC080 | 0x3 | 8 | 31 | 1 | 0 | 0 | 1 | 1 | 0 | 0 | - 0 M_DI_BrakeSw1_HS | M_DI_BrakeSw1_HS | 刹车开关 1 | J1-6 | tableCell | 0xC080 | 0x3 | 8 | 32 | 1 | 0 | 0 | 1 | 1 | 0 | 0 | - 0 M_DI_BrakeSw2_HS | M_DI_BrakeSw2_HS | 刹车开关 2 | J1-47 | tableCell | 0xC080 | 0x3 | 8 | 33 | 1 | 0 | 0 | 1 | 1 | 0 | 0 | - 0 M_DI_EmergencyAlarmSw_LS | M_DI_EmergencyAlarmSw_LS | 紧急报警开关 | J1-46 | tableCell | 0xC080 | 0x3 | 8 | 34 | 1 | 0 | 0 | 1 | 1 | 0 | 0 | - 0 M_DI_ThirdRowBeltLt_LS | M_DI_ThirdRowBeltLt_LS | 第三排左侧安全带检测 | J2-32 | tableCell | 0xC080 | 0x3 | 8 | 35 | 1 | 0 | 0 | 1 | 1 | 0 | 0 | - 0 M_DI_RLVoiceSw_LS | M_DI_RLVoiceSw_LS | 预留 | J2-23 | tableCell | 0xC080 | 0x3 | 8 | 36 | 1 | 0 | 0 | 1 | 1 | 0 | 0 | - 0 M_DI_FLTopLightSw_LS | M_DI_FLTopLightSw_LS | 左前顶灯开关 | J2-7 | tableCell | 0xC080 | 0x3 | 8 | 37 | 1 | 0 | 0 | 1 | 1 | 0 | 0 | - 0 M_DI_RLTopLightSw_LS | M_DI_RLTopLightSw_LS | 左后顶灯开关 | J2-18 | tableCell | 0xC080 | 0x3 | 8 | 38 | 1 | 0 | 0 | 1 | 1 | 0 | 0 | - 0 M_DI_FRTopLightSw_LS | M_DI_FRTopLightSw_LS | 右前顶灯开关 | J5-20 | tableCell | 0xC080 | 0x3 | 8 | 39 | 1 | 0 | 0 | 1 | 1 | 0 | 0 | - 0 M_DI_RLDoorReleaseSW_LS | M_DI_RLDoorReleaseSW_LS | 左后内开释放开关 | J1-45 | tableCell | 0xC080 | 0x3 | 8 | 40 | 1 | 0 | 0 | 1 | 1 | 0 | 0 | - 0 M_DI_TrunkOpenSw_LS | M_DI_TrunkOpenSw_LS | 尾门开启开关 | J1-44 | tableCell | 0xC080 | 0x3 | 8 | 41 | 1 | 0 | 0 | 1 | 1 | 0 | 0 | - 0 M_DI_ThirdRowBeltMid_LS | M_DI_ThirdRowBeltMid_LS | 第三排中间安全带检测 | J2-22 | tableCell | 0xC080 | 0x3 | 8 | 42 | 1 | 0 | 0 | 1 | 1 | 0 | 0 | - 0 M_DI_RLDoorAjarSW_LS | M_DI_RLDoorAjarSW_LS | 左后滑移门开关状态 | J2-30 | tableCell | 0xC080 | 0x3 | 8 | 43 | 1 | 0 | 0 | 1 | 1 | 0 | 0 | - 0 M_DI_RLOutHandle_LS | M_DI_RLOutHandle_LS | 左后门外开门把手状态 | J2-31 | tableCell | 0xC080 | 0x3 | 8 | 44 | 1 | 0 | 0 | 1 | 1 | 0 | 0 | - 0 M_DI_RLChildLockOrDoorOpen_LS | M_DI_RLChildLockOrDoorOpen_LS | 儿童锁状态反馈 或

门全开状态 （电吸门 ）

J5-21 | tableCell | 0xC080 | 0x3 | 8 | 45 | 1 | 0 | 0 | 1 | 1 | 0 | 0 | - 0 M_DI_RLDoorPawlSW_LS | M_DI_RLDoorPawlSW_LS | 左后门Pawl（电吸门） | J2-43 | tableCell | 0xC080 | 0x3 | 8 | 46 | 1 | 0 | 0 | 1 | 1 | 0 | 0 | - 0 M_DI_QuickChargeWake_HS | M_DI_QuickChargeWake_HS | 快充唤醒 | J1-18 | tableCell | 0xC080 | 0x3 | 8 | 47 | 1 | 0 | 0 | 1 | 1 | 0 | 0 | - 0 M_DI_SlowChargeWake_HS | M_DI_SlowChargeWake_HS | 慢充唤醒 | J1-5 | tableCell | 0xC080 | 0x3 | 8 | 48 | 1 | 0 | 0 | 1 | 1 | 0 | 0 | - 0 M_DI_FLDoorOpenSw_LS | M_DI_FLDoorOpenSw_LS | 左前门全开状态 （电吸门 ） | J9-39 | tableCell | 0xC080 | 0x3 | 8 | 49 | 1 | 0 | 0 | 1 | 1 | 0 | 0 | - 0 M_DI_FLOutHandle_LS | M_DI_FLOutHandle_LS | 左外门把手开关检测 | J9-3 | tableCell | 0xC080 | 0x3 | 8 | 50 | 1 | 0 | 0 | 1 | 1 | 0 | 0 | - 0 M_DI_FLDoorPawlSW_LS | M_DI_FLDoorPawlSW_LS | 左前门Pawl（电吸门） | J9-37 | tableCell | 0xC080 | 0x3 | 8 | 51 | 1 | 0 | 0 | 1 | 1 | 0 | 0 | - 0 M_DI_MainPowerWake2Fb | M_DI_MainPowerWake2Fb | MainPower2 反馈采样 | J2-26 | tableCell | 0xC080 | 0x3 | 8 | 52 | 1 | 0 | 0 | 1 | 1 | 0 | 0 | - 0 M_DI_MainPowerWake1Fb | M_DI_MainPowerWake1Fb | MainPower1 反馈采样 | J2-9 | tableCell | 0xC080 | 0x3 | 8 | 53 | 1 | 0 | 0 | 1 | 1 | 0 | 0 | - 0
0 Digital output | Digital output | Digital output | IO引脚 | pushButton | 0xC081 | 0x1 | 12 | 0 | 0 | 0 | 0 | 0 | 0 | 0 | 0 | - 0 M_DO_BrakeLampCtr_HS | M_DO_BrakeLampCtr_HS | 制动灯控制 | J4-1 | checkBox | 0xC081 | 0x1 | 12 | 0 | 1 | 0 | 0 | 1 | 1 | 0 | 0 | - 0 M_DO_HS_IMS | M_DO_HS_IMS | 内流媒体后视镜供电 | J4-2 | checkBox | 0xC081 | 0x1 | 12 | 1 | 1 | 0 | 0 | 1 | 1 | 0 | 0 | - 0 M_PO_SteeringWheelHeatedCtr | M_PO_SteeringWheelHeatedCtr | 方向盘加热控制 | J6-1 | checkBox | 0xC081 | 0x1 | 12 | 2 | 1 | 0 | 0 | 1 | 1 | 0 | 0 | - 0 M_DO_SENSOR_POWER1_Disable_HS | M_DO_SENSOR_POWER1_Disable_HS | 加速踏板 1/档位执行器供电控制 | J5-42/J6-11 | checkBox | 0xC081 | 0x1 | 12 | 3 | 1 | 0 | 0 | 1 | 1 | 0 | 0 | - 0 M_DO_SENSOR_POWER2_Disable_HS | M_DO_SENSOR_POWER2_Disable_HS | 加速踏板 2/档位执行器供电控制 | J2-2/J3-6 | checkBox | 0xC081 | 0x1 | 12 | 4 | 1 | 0 | 0 | 1 | 1 | 0 | 0 | - 0 M_DO_SENSOR_POWER3_Disable_HS | M_DO_SENSOR_POWER3_Disable_HS | 后视镜/PM2.5供电控制 | J9-23/J5-44 | checkBox | 0xC081 | 0x1 | 12 | 5 | 1 | 0 | 0 | 1 | 1 | 0 | 0 | - 0 J_DO_HS_MainPowerWake1 | J_DO_HS_MainPowerWake1 | MainPower1 | J2-9 | checkBox | 0xC081 | 0x1 | 12 | 6 | 1 | 0 | 0 | 1 | 1 | 0 | 0 | - 0 J_DO_HS_KL15Wake1 | J_DO_HS_KL15Wake1 | BLS2\MSB\ACU 唤醒 | J2-10 | checkBox | 0xC081 | 0x1 | 12 | 7 | 1 | 0 | 0 | 1 | 1 | 0 | 0 | - 0 J_DO_HS_CDCUWake | J_DO_HS_CDCUWake | CDCU唤醒 | J2-12 | checkBox | 0xC081 | 0x1 | 12 | 8 | 1 | 0 | 0 | 1 | 1 | 0 | 0 | - 0 J_DO_HS_CDCWake | J_DO_HS_CDCWake | CDC唤醒 | J2-13 | checkBox | 0xC081 | 0x1 | 12 | 9 | 1 | 0 | 0 | 1 | 1 | 0 | 0 | - 0 J_DO_SWSPower | J_DO_SWSPower | SWS、EPB开关、阳光传感器供电 | J7-11 | checkBox | 0xC081 | 0x1 | 12 | 10 | 1 | 0 | 0 | 1 | 1 | 0 | 0 | - 0 J_DO_HS_MainPowerWake2 | J_DO_HS_MainPowerWake2 | MainPower2 | J2-26 | checkBox | 0xC081 | 0x1 | 12 | 11 | 1 | 0 | 0 | 1 | 1 | 0 | 0 | - 0 J_DO_HS_CameraHeated | J_DO_HS_CameraHeated | 摄像头加热 | J2-25 | checkBox | 0xC081 | 0x1 | 12 | 12 | 1 | 0 | 0 | 1 | 1 | 0 | 0 | - 0 J_DO_HS_ReverseLamp | J_DO_HS_ReverseLamp | 倒车灯 | J2-37 | checkBox | 0xC081 | 0x1 | 12 | 13 | 1 | 0 | 0 | 1 | 1 | 0 | 0 | - 0 J_DO_HS_IntLgthPower | J_DO_HS_IntLgthPower | 节能输出 | J2-38/J8-8/J7-2 | checkBox | 0xC081 | 0x1 | 12 | 14 | 1 | 0 | 0 | 1 | 1 | 0 | 0 | - 0 J_DO_HS_LampLimpHomeOut | J_DO_HS_LampLimpHomeOut | 近光灯LimpHome | J2-39 | checkBox | 0xC081 | 0x1 | 12 | 15 | 1 | 0 | 0 | 1 | 1 | 0 | 0 | - 0 J_PO_HS_RDCUWake | J_PO_HS_RDCUWake | 右域硬线唤醒 | J2-52 | checkBox | 0xC081 | 0x1 | 12 | 16 | 1 | 0 | 0 | 1 | 1 | 0 | 0 | - 0 J_DO_HS_LtSlideDoor | J_DO_HS_LtSlideDoor | 左侧侧滑门供电 | J4-15 | checkBox | 0xC081 | 0x1 | 12 | 17 | 1 | 0 | 0 | 1 | 1 | 0 | 0 | - 0 J_DO_HS_SeatVentPower | J_DO_HS_SeatVentPower | 座椅通风供电 | J4-16 | checkBox | 0xC081 | 0x1 | 12 | 18 | 1 | 0 | 0 | 1 | 1 | 0 | 0 | - 0 J_DO_HS_ATLPower | J_DO_HS_ATLPower | ATL配电
J_DO_HS_Backlight | 背景灯 | J9-5/J7-13/J4-18 | checkBox | 0xC081 | 0x1 | 12 | 19 | 1 | 0 | 0 | 1 | 1 | 0 | 0 | - 0 J_DO_HS_Backlight
| | J9-11/J7-12/J4-17
J_DO_HS_FSRRPower J_DO_HS_HallPower | 霍尔传感器供电 前毫米波雷达 | J3-25 | checkBox checkBox | 0xC081 0xC081 | 0x1 0x1 | 12 12 | 20 21 | 1 1 | 0 0 | 0 0 | 1 1 | 1 1 | 0 0 | 0 0 | - 0 J_DO_HS_FSRRPower - 0 J_DO_HS_HallPower

J5-43/J8-11/J7-1
checkBox | 0xC081 | 0x1 | 12 | 22 | 1 | 0 | 0 | 1 | 1 | 0 | 0 | - 0 J_DO_HS_LeftMirrorHeated | J_DO_HS_LeftMirrorHeated | 后视镜加热 | J8-4 | checkBox | 0xC081 | 0x1 | 12 | 23 | 1 | 0 | 0 | 1 | 1 | 0 | 0 | - 0 J_DO_LS_7754_Reserve1 | J_DO_LS_7754_Reserve1 | 后油泵继电器 ，预留1 | J1-2 | checkBox | 0xC081 | 0x1 | 12 | 24 | 1 | 0 | 0 | 1 | 1 | 0 | 0 | - 0 J_DO_LS_7754_Reserve2 | J_DO_LS_7754_Reserve2 | 12V取电口（副IP台前），预留2 | J1-16 | checkBox | 0xC081 | 0x1 | 12 | 25 | 1 | 0 | 0 | 1 | 1 | 0 | 0 | - 0 J_DO_LS_12VPWR2RLY | J_DO_LS_12VPWR2RLY | 12V取电口（副IP台后） | J1-1 | checkBox | 0xC081 | 0x1 | 12 | 26 | 1 | 0 | 0 | 1 | 1 | 0 | 0 | - 0 J_DO_LS_7754_Reserve4 | J_DO_LS_7754_Reserve4 | 12V取电口（行李箱），预留4 | J1-14 | checkBox | 0xC081 | 0x1 | 12 | 27 | 1 | 0 | 0 | 1 | 1 | 0 | 0 | - 0 J_DO_LS_VaccumPumpRly | J_DO_LS_VaccumPumpRly | 真空泵继电器 | J1-15 | checkBox | 0xC081 | 0x1 | 12 | 28 | 1 | 0 | 0 | 1 | 1 | 0 | 0 | - 0 J_DO_LS_CarpetLight | J_DO_LS_CarpetLight | 迎宾光毯 | J1-17 | checkBox | 0xC081 | 0x1 | 12 | 29 | 1 | 0 | 0 | 1 | 1 | 0 | 0 | - 0 J_DO_LS_CWCEN | J_DO_LS_CWCEN | CWC使能 | J1-40 | checkBox | 0xC081 | 0x1 | 12 | 30 | 1 | 0 | 0 | 1 | 1 | 0 | 0 | - 0 J_DO_HS_BMSEmergencyStop | J_DO_HS_BMSEmergencyStop | BMS紧急下电 | J2-3 | checkBox | 0xC081 | 0x1 | 12 | 31 | 1 | 0 | 0 | 1 | 1 | 0 | 0 | - 0 J_DO_HS_KL15_BackUp | J_DO_HS_KL15_BackUp | 右域KL15电冗余控制 | J2-4 | checkBox | 0xC081 | 0x1 | 12 | 32 | 1 | 0 | 0 | 1 | 1 | 0 | 0 | - 0 J_DO_HS_PM25FanPower | J_DO_HS_PM25FanPower | PM2.5风扇控制 | J2-5 | checkBox | 0xC081 | 0x1 | 12 | 33 | 1 | 0 | 0 | 1 | 1 | 0 | 0 | - 0 J_DO_LS_REOPRly | J_DO_LS_REOPRly | 后油泵继电器 | J2-6 | checkBox | 0xC081 | 0x1 | 12 | 34 | 1 | 0 | 0 | 1 | 1 | 0 | 0 | - 0 J_DO_LS_FEOPRly | J_DO_LS_FEOPRly | 前油泵继电器 (应该是J_DO_LS_FEOPRly) | J3-13 | checkBox | 0xC081 | 0x1 | 12 | 35 | 1 | 0 | 0 | 1 | 1 | 0 | 0 | - 0 J_DO_LS_12VPower2 | J_DO_LS_12VPower2 | 12V取电口(副IP台前) | J3-16 | checkBox | 0xC081 | 0x1 | 12 | 36 | 1 | 0 | 0 | 1 | 1 | 0 | 0 | - 0 J_DO_LS_FanRly | J_DO_LS_FanRly | 风扇继电器 | J3-11 | checkBox | 0xC081 | 0x1 | 12 | 37 | 1 | 0 | 0 | 1 | 1 | 0 | 0 | - 0 J_DO_LS_BatteryPumpRly | J_DO_LS_BatteryPumpRly | 电池水泵继电器 | J3-10 | checkBox | 0xC081 | 0x1 | 12 | 38 | 1 | 0 | 0 | 1 | 1 | 0 | 0 | - 0 J_DO_LS_MotorPumpRly | J_DO_LS_MotorPumpRly | 电机水泵继电器 | J3-14 | checkBox | 0xC081 | 0x1 | 12 | 39 | 1 | 0 | 0 | 1 | 1 | 0 | 0 | - 0 J_DO_LS_DeforstrRly | J_DO_LS_DeforstrRly | 后除霜继电器 | J3-32 | checkBox | 0xC081 | 0x1 | 12 | 40 | 1 | 0 | 0 | 1 | 1 | 0 | 0 | - 0 J_DO_HS_WinLockLight | J_DO_HS_WinLockLight | 车窗锁止指示灯 | J9-7 | checkBox | 0xC081 | 0x1 | 12 | 41 | 1 | 0 | 0 | 1 | 1 | 0 | 0 | - 0 J_DO_LS_LBSDLight | J_DO_LS_LBSDLight | 左侧BSD灯 | J9-6 | checkBox | 0xC081 | 0x1 | 12 | 42 | 1 | 0 | 0 | 1 | 1 | 0 | 0 | - 0 J_DO_LS_LFDoorHandleLight | J_DO_LS_LFDoorHandleLight | 前门把手灯 | J9-10 | checkBox | 0xC081 | 0x1 | 12 | 43 | 1 | 0 | 0 | 1 | 1 | 0 | 0 | - 0 J_DO_LS_LDOWLight | J_DO_LS_LDOWLight | 左侧DOW灯 | J9-9 | checkBox | 0xC081 | 0x1 | 12 | 44 | 1 | 0 | 0 | 1 | 1 | 0 | 0 | - 0 J_DO_LS_12VPower1 | J_DO_LS_12VPower1 | 12V取电口（行李箱） | J6-5 | checkBox | 0xC081 | 0x1 | 12 | 45 | 1 | 0 | 0 | 1 | 1 | 0 | 0 | - 0 J_PO_DiffuseCeilingLamp | J_PO_DiffuseCeilingLamp | 环绕式漫反射顶棚灯 | J1-27 | checkBox | 0xC081 | 0x1 | 12 | 46 | 1 | 0 | 0 | 1 | 1 | 0 | 0 | - 0
0 Pwm input | Pwm input | Pwm input | IO引脚 | pushButton | 0xC082 | 0x3 | 80 | 0 | 0 | 1 | 0 | 0 | 0 | 0 | 0 | - 0 M_PI_DriveHVILOutFb_Freq | M_PI_DriveHVILOutFb_Freq | 驱动回路高压互锁诊断反馈 _Freq | J3-30 | lineEdit | 0xC082 | 0x3 | 80 | 8 | 16 | 0 | 0 | 65535 | 1.00 | 0 | 0 | - 0 M_PI_DriveHVILOutFb_Duty | M_PI_DriveHVILOutFb_Duty | 驱动回路高压互锁诊断反馈 _Duty | lineEdit | 0xC082 | 0x3 | 80 | 24 | 16 | 0 | 0 | 65535 | 0.10 | 0 | % | 0 | - 0 M_PI_DriveHVIL_Fb_Freq | M_PI_DriveHVIL_Fb_Freq | 驱动回路互锁输入 _Freq | J2-14 | lineEdit | 0xC082 | 0x3 | 80 | 40 | 16 | 0 | 0 | 65535 | 1.00 | 0 | 0 | - 0 M_PI_DriveHVIL_Fb_Duty | M_PI_DriveHVIL_Fb_Duty | 驱动回路互锁输入 _Duty | lineEdit | 0xC082 | 0x3 | 80 | 56 | 16 | 0 | 0 | 65535 | 0.10 | 0 | % | 0 | - 0 M_PI_ChargeHVIL_Fb_Freq | M_PI_ChargeHVIL_Fb_Freq | 充电回路互锁输入 _Freq | J2-27 | lineEdit | 0xC082 | 0x3 | 80 | 72 | 16 | 0 | 0 | 65535 | 1.00 | 0 | 0 | - 0 M_PI_ChargeHVIL_Fb_Duty | M_PI_ChargeHVIL_Fb_Duty | 充电回路互锁输入 _Duty | lineEdit | 0xC082 | 0x3 | 80 | 88 | 16 | 0 | 0 | 65535 | 0.10 | 0 | % | 0 | - 0 M_PI_FanFb_Freq | M_PI_FanFb_Freq | 风扇反馈_Freq | J3-27 | lineEdit | 0xC082 | 0x3 | 80 | 104 | 16 | 0 | 0 | 65535 | 1.00 | 0 | 0 | - 0 M_PI_FanFb_Duty | M_PI_FanFb_Duty | 风扇反馈_Duty | lineEdit | 0xC082 | 0x3 | 80 | 120 | 16 | 0 | 0 | 65535 | 0.10 | 0 | % | 0 | - 0 M_PI_RearAbatVentHALLFb2_Freq | M_PI_RearAbatVentHALLFb2_Freq | 遮阳帘HALL传感器信号2_Freq | J3-26 | lineEdit | 0xC082 | 0x3 | 80 | 136 | 16 | 0 | 0 | 65535 | 1.00 | 0 | 0 | - 0 M_PI_RearAbatVentHALLFb2_Duty | M_PI_RearAbatVentHALLFb2_Duty | 遮阳帘HALL传感器信号2_Duty | lineEdit | 0xC082 | 0x3 | 80 | 152 | 16 | 0 | 0 | 65535 | 0.10 | 0 | % | 0 | - 0 M_PI_RearAbatVentHALLFb1_Freq | M_PI_RearAbatVentHALLFb1_Freq | 遮阳帘HALL传感器信号1_Freq | J3-28 | lineEdit | 0xC082 | 0x3 | 80 | 168 | 16 | 0 | 0 | 65535 | 1.00 | 0 | 0 | - 0 M_PI_RearAbatVentHALLFb1_Duty | M_PI_RearAbatVentHALLFb1_Duty | 遮阳帘HALL传感器信号1_Duty | lineEdit | 0xC082 | 0x3 | 80 | 184 | 16 | 0 | 0 | 65535 | 0.10 | 0 | % | 0 | - 0 M_PI_RLWindow_HallFb1_Freq | M_PI_RLWindow_HallFb1_Freq | 左后玻璃升降电机霍尔反馈 1_Freq | J2-42 | lineEdit | 0xC082 | 0x3 | 80 | 200 | 16 | 0 | 0 | 65535 | 1.00 | 0 | 0 | - 0 M_PI_RLWindow_HallFb1_Duty | M_PI_RLWindow_HallFb1_Duty | 左后玻璃升降电机霍尔反馈 1_Duty | lineEdit | 0xC082 | 0x3 | 80 | 216 | 16 | 0 | 0 | 65535 | 0.10 | 0 | % | 0 | - 0 M_PI_RLWindow_HallFb2_Freq | M_PI_RLWindow_HallFb2_Freq | 左后玻璃升降电机霍尔反馈 2_Freq | J2-44 | lineEdit | 0xC082 | 0x3 | 80 | 232 | 16 | 0 | 0 | 65535 | 1.00 | 0 | 0 | - 0 M_PI_RLWindow_HallFb2_Duty | M_PI_RLWindow_HallFb2_Duty | 左后玻璃升降电机霍尔反馈 2_Duty | lineEdit | 0xC082 | 0x3 | 80 | 248 | 16 | 0 | 0 | 65535 | 0.10 | 0 | % | 0 | - 0 M_PI_PM2_5DendityFb_Freq | M_PI_PM2_5DendityFb_Freq | PM2.5传感器采样 _Freq | J5-46 | lineEdit | 0xC082 | 0x3 | 80 | 264 | 16 | 0 | 0 | 65535 | 1.00 | 0 | 0 | - 0 M_PI_PM2_5DendityFb_Duty | M_PI_PM2_5DendityFb_Duty | PM2.5传感器采样 _Duty | lineEdit | 0xC082 | 0x3 | 80 | 280 | 16 | 0 | 0 | 65535 | 0.10 | 0 | % | 0 | - 0 M_PI_DrvSeatSldHALLFb_Freq | M_PI_DrvSeatSldHALLFb_Freq | 主驾座椅滑轨调节位置采样 _Freq | J2-45 | lineEdit | 0xC082 | 0x3 | 80 | 296 | 16 | 0 | 0 | 65535 | 1.00 | 0 | 0 | - 0 M_PI_DrvSeatSldHALLFb_Duty | M_PI_DrvSeatSldHALLFb_Duty | 主驾座椅滑轨调节位置采样 _Duty | lineEdit | 0xC082 | 0x3 | 80 | 312 | 16 | 0 | 0 | 65535 | 0.10 | 0 | % | 0 | - 0 M_PI_DrvSeatHeightHALLFb_Freq | M_PI_DrvSeatHeightHALLFb_Freq | 主驾座椅高度调节位置采样 _Freq | J2-34 | lineEdit | 0xC082 | 0x3 | 80 | 328 | 16 | 0 | 0 | 65535 | 1.00 | 0 | 0 | - 0 M_PI_DrvSeatHeightHALLFb_Duty | M_PI_DrvSeatHeightHALLFb_Duty | 主驾座椅高度调节位置采样 _Duty | lineEdit | 0xC082 | 0x3 | 80 | 344 | 16 | 0 | 0 | 65535 | 0.10 | 0 | % | 0 | - 0 M_PI_DrvSeatBackIncHALLFb_Freq | M_PI_DrvSeatBackIncHALLFb_Freq | 主驾座椅靠背角度调节位置采样 _Freq | J2-40 | lineEdit | 0xC082 | 0x3 | 80 | 360 | 16 | 0 | 0 | 65535 | 1.00 | 0 | 0 | - 0 M_PI_DrvSeatBackIncHALLFb_Duty | M_PI_DrvSeatBackIncHALLFb_Duty | 主驾座椅靠背角度调节位置采样 _Duty | lineEdit | 0xC082 | 0x3 | 80 | 376 | 16 | 0 | 0 | 65535 | 0.10 | 0 | % | 0 | - 0 M_PI_AbatVentHALLFb_Freq | M_PI_AbatVentHALLFb_Freq | HALL传感器信号 （预留1）_Freq | J2-41 | lineEdit | 0xC082 | 0x3 | 80 | 392 | 16 | 0 | 0 | 65535 | 1.00 | 0 | 0 | - 0 M_PI_AbatVentHALLFb_Duty | M_PI_AbatVentHALLFb_Duty | HALL传感器信号 （预留1）_Duty | lineEdit | 0xC082 | 0x3 | 80 | 408 | 16 | 0 | 0 | 65535 | 0.10 | 0 | % | 0 | - 0 M_PI_ESCCUForwardBackward_HallFb_Freq | M_PI_ESCCUForwardBackward_HallFb_Freq | 电调管柱前后调节电机霍尔反馈 _Freq | J6-10 | lineEdit | 0xC082 | 0x3 | 80 | 424 | 16 | 0 | 0 | 65535 | 1.00 | 0 | 0 | - 0 M_PI_ESCCUForwardBackward_HallFb_Duty | M_PI_ESCCUForwardBackward_HallFb_Duty | 电调管柱前后调节电机霍尔反馈 _Duty | lineEdit | 0xC082 | 0x3 | 80 | 440 | 16 | 0 | 0 | 65535 | 0.10 | 0 | % | 0 | - 0 M_PI_ESCCUpDown_HallFb_Freq | M_PI_ESCCUpDown_HallFb_Freq | 电调管柱上下调节电机霍尔反馈 _Freq | J6-9 | lineEdit | 0xC082 | 0x3 | 80 | 456 | 16 | 0 | 0 | 65535 | 1.00 | 0 | 0 | - 0 M_PI_ESCCUpDown_HallFb_Duty | M_PI_ESCCUpDown_HallFb_Duty | 电调管柱上下调节电机霍尔反馈 _Duty | lineEdit | 0xC082 | 0x3 | 80 | 472 | 16 | 0 | 0 | 65535 | 0.10 | 0 | % | 0 | - 0 M_PI_FLWindow_HallFb1_Freq | M_PI_FLWindow_HallFb1_Freq | 主驾玻璃升降电机霍尔反馈 1_Freq | J9-21 | lineEdit | 0xC082 | 0x3 | 80 | 488 | 16 | 0 | 0 | 65535 | 1.00 | 0 | 0 | - 0 M_PI_FLWindow_HallFb1_Duty | M_PI_FLWindow_HallFb1_Duty | 主驾玻璃升降电机霍尔反馈 1_Duty | lineEdit | 0xC082 | 0x3 | 80 | 504 | 16 | 0 | 0 | 65535 | 0.10 | 0 | % | 0 | - 0 M_PI_FLWindow_HallFb2_Freq | M_PI_FLWindow_HallFb2_Freq | 主驾玻璃升降电机霍尔反馈 2_Freq | J9-1 | lineEdit | 0xC082 | 0x3 | 80 | 520 | 16 | 0 | 0 | 65535 | 1.00 | 0 | 0 | - 0 M_PI_FLWindow_HallFb2_Duty | M_PI_FLWindow_HallFb2_Duty | 主驾玻璃升降电机霍尔反馈 2_Duty | lineEdit | 0xC082 | 0x3 | 80 | 536 | 16 | 0 | 0 | 65535 | 0.10 | 0 | % | 0 | - 0 M_PI_ChargeHVILOutFb_Freq | M_PI_ChargeHVILOutFb_Freq | 充电回路互锁霍尔反馈 _Freq | J5-16 | lineEdit | 0xC082 | 0x3 | 80 | 552 | 16 | 0 | 0 | 65535 | 1.00 | 0 | 0 | - 0 M_PI_ChargeHVILOutFb_Duty | M_PI_ChargeHVILOutFb_Duty | 充电回路互锁霍尔反馈 _Duty | lineEdit | 0xC082 | 0x3 | 80 | 568 | 16 | 0 | 0 | 65535 | 0.10 | 0 | % | 0 | - 0
0 Pwm output | Pwm output | Pwm output | IO引脚 | pushButton | 0xC083 | 0x1 | 70 | 0 | 0 | 0 | 0 | 0 | 0 | 0 | 0 | - 0 J_PO_LS_LCarpetLight_Freq | J_PO_LS_LCarpetLight_Freq | 左侧迎宾光毯 _Freq | J3-12 | horizontalSlider | 0xC083 | 0x1 | 70 | 8 | 16 | 0 | 0 | 65535 | 1 | 0 | Hz | 0 | - 0 J_PO_LS_LCarpetLight_Duty | J_PO_LS_LCarpetLight_Duty | 左侧迎宾光毯 _Duty | horizontalSlider | 0xC083 | 0x1 | 70 | 16 | 8 | 0 | 0 | 255 | 1 | 0 | % | 0 | - 0 J_PO_LS_FanSpeedCtr_Freq | J_PO_LS_FanSpeedCtr_Freq | 风扇转速控制 _Freq | J3-15 | horizontalSlider | 0xC083 | 0x1 | 70 | 56 | 16 | 0 | 0 | 65535 | 1 | 0 | Hz | 0 | - 0 J_PO_LS_FanSpeedCtr_Duty | J_PO_LS_FanSpeedCtr_Duty | 风扇转速控制 _Duty | horizontalSlider | 0xC083 | 0x1 | 70 | 64 | 8 | 0 | 0 | 255 | 1 | 0 | % | 0 | - 0 J_PO_LS_BatteryPumpSpeedCtr_Freq | J_PO_LS_BatteryPumpSpeedCtr_Freq | 电池水泵转速控制 _Freq | J9-8 | horizontalSlider | 0xC083 | 0x1 | 70 | 80 | 16 | 0 | 0 | 65535 | 1 | 0 | Hz | 0 | - 0 J_PO_LS_BatteryPumpSpeedCtr_Duty | J_PO_LS_BatteryPumpSpeedCtr_Duty | 电池水泵转速控制 _Duty | horizontalSlider | 0xC083 | 0x1 | 70 | 88 | 8 | 0 | 0 | 255 | 1 | 0 | % | 0 | - 0 J_PO_TLTopLightt_Freq | J_PO_TLTopLightt_Freq | 三排左顶灯 _Freq | J5-6 | horizontalSlider | 0xC083 | 0x1 | 70 | 104 | 16 | 0 | 0 | 65535 | 1 | 0 | Hz | 0 | - 0 J_PO_TLTopLight_Duty | J_PO_TLTopLight_Duty | 三排左顶灯 _Duty | horizontalSlider | 0xC083 | 0x1 | 70 | 112 | 8 | 0 | 0 | 255 | 1 | 0 | % | 0 | - 0 J_PO_LS_FMTopLight_Freq | J_PO_LS_FMTopLight_Freq | 中前顶灯_Freq | J5-4 | horizontalSlider | 0xC083 | 0x1 | 70 | 128 | 16 | 0 | 0 | 65535 | 1 | 0 | Hz | 0 | - 0 J_PO_LS_FMTopLight_Duty | J_PO_LS_FMTopLight_Duty | 中前顶灯_Duty | horizontalSlider | 0xC083 | 0x1 | 70 | 136 | 8 | 0 | 0 | 255 | 1 | 0 | % | 0 | - 0 J_PO_LS_FRTopLight_Freq | J_PO_LS_FRTopLight_Freq | 右前顶灯控制 _Freq | J5-3 | horizontalSlider | 0xC083 | 0x1 | 70 | 152 | 16 | 0 | 0 | 65535 | 1 | 0 | Hz | 0 | - 0 J_PO_LS_FRTopLight_Duty | J_PO_LS_FRTopLight_Duty | 右前顶灯控制 _Duty | horizontalSlider | 0xC083 | 0x1 | 70 | 160 | 8 | 0 | 0 | 255 | 1 | 0 | % | 0 | - 0 J_PO_LS_TrunkLight_Freq | J_PO_LS_TrunkLight_Freq | 行李箱灯控制 _Freq | J5-7 | horizontalSlider | 0xC083 | 0x1 | 70 | 176 | 16 | 0 | 0 | 65535 | 1 | 0 | Hz | 0 | - 0 J_PO_LS_TrunkLight_Duty | J_PO_LS_TrunkLight_Duty | 行李箱灯控制 _Duty | horizontalSlider | 0xC083 | 0x1 | 70 | 184 | 8 | 0 | 0 | 255 | 1 | 0 | % | 0 | - 0 J_PO_LS_RLTopLight_Freq | J_PO_LS_RLTopLight_Freq | 左后顶灯控制 _Freq | J5-5 | horizontalSlider | 0xC083 | 0x1 | 70 | 200 | 16 | 0 | 0 | 65535 | 1 | 0 | Hz | 0 | - 0 J_PO_LS_RLTopLight_Duty | J_PO_LS_RLTopLight_Duty | 左后顶灯控制 _Duty | horizontalSlider | 0xC083 | 0x1 | 70 | 208 | 8 | 0 | 0 | 255 | 1 | 0 | % | 0 | - 0 J_PO_LS_FLTopLight_Freq | J_PO_LS_FLTopLight_Freq | 左前顶灯控制 _Freq | J5-2 | horizontalSlider | 0xC083 | 0x1 | 70 | 224 | 16 | 0 | 0 | 65535 | 1 | 0 | Hz | 0 | - 0 J_PO_LS_FLTopLight_Duty | J_PO_LS_FLTopLight_Duty | 左前顶灯控制 _Duty | horizontalSlider | 0xC083 | 0x1 | 70 | 232 | 8 | 0 | 0 | 255 | 1 | 0 | % | 0 | - 0 M_PO_DriveHVILCtr_Freq | M_PO_DriveHVILCtr_Freq | 驱动回路高压互锁输出 _Freq | J3-30 | horizontalSlider | 0xC083 | 0x1 | 70 | 248 | 16 | 0 | 0 | 65535 | 1 | 0 | Hz | 0 | - 0 M_PO_DriveHVILCtr_Duty | M_PO_DriveHVILCtr_Duty | 驱动回路高压互锁输出 _Duty | horizontalSlider | 0xC083 | 0x1 | 70 | 256 | 8 | 0 | 0 | 255 | 1 | 0 | % | 0 | - 0 M_PO_ChargeHVILOut_Freq | M_PO_ChargeHVILOut_Freq | 充电回路互锁输出使能 _Freq | J5-16 | horizontalSlider | 0xC083 | 0x1 | 70 | 272 | 16 | 0 | 0 | 65535 | 1 | 0 | Hz | 0 | - 0 M_PO_ChargeHVILOut_Duty | M_PO_ChargeHVILOut_Duty | 充电回路互锁输出使能 _Duty | horizontalSlider | 0xC083 | 0x1 | 70 | 280 | 8 | 0 | 0 | 255 | 1 | 0 | % | 0 | - 0
0 | 小鹏汽车

0 Analog input | Analog input | Analog input | IO引脚 | pushButton | 0xC084 | 0x3 | 220 | 0 | 0 | 1 | 0 | 0 | 0 | 0 | 0 | - 0 M_AI_FS6522_MUXOUT | M_AI_FS6522_MUXOUT | 通过SPI配置反馈不同状态 | U42_T355 | lineEdit | 0xC084 | 0x3 | 220 | 8 | 16 | 0 | 0 | 65535 | 1 | 0 | 100 | - 0 M_AI_Seat_CSO1 | M_AI_Seat_CSO1 | 主驾座椅控制电流反馈采样 1 | U45_T416 | lineEdit | 0xC084 | 0x3 | 220 | 24 | 16 | 0 | 0 | 65535 | 1 | 0 | 100 | - 0 M_AI_ESCCU_CSO2 | M_AI_ESCCU_CSO2 | 电调管柱电流反馈采样 | U45_T418 | lineEdit | 0xC084 | 0x3 | 220 | 40 | 16 | 0 | 0 | 65535 | 1 | 0 | 100 | - 0 M_AI_TLE92108_CSO1 | M_AI_TLE92108_CSO1 | 遮阳帘/左前车窗控制电流反馈 | U63_T468 | lineEdit | 0xC084 | 0x3 | 220 | 56 | 16 | 0 | 0 | 65535 | 1 | 0 | 100 | - 0 M_AI_TLE92108_CSO2 | M_AI_TLE92108_CSO2 | 电吸门/左后车窗控制电流反馈 | U63_T470 | lineEdit | 0xC084 | 0x3 | 220 | 72 | 16 | 0 | 0 | 65535 | 1 | 0 | 100 | - 0 M_AI_BrakeLamp_HeatCurrent | M_AI_BrakeLamp_HeatCurrent | 制动灯/摄像头加热电流检测 | U43_T752 | lineEdit | 0xC084 | 0x3 | 220 | 88 | 16 | 0 | 0 | 65535 | 1 | 0 | 100 | - 0 M_AI_SteeringWheelHeated_CurrentFb | M_AI_SteeringWheelHeated_CurrentFb | 方向盘加热电流检测 | U8_T28 | lineEdit | 0xC084 | 0x3 | 220 | 104 | 16 | 0 | 0 | 65535 | 1 | 0 | 100 | - 0 M_AI_5V_SENSOR_POWER1_FB | M_AI_5V_SENSOR_POWER1_FB | 加速踏板 1/档位执行器供电反馈 | J5-42或J6-11 | lineEdit | 0xC084 | 0x3 | 220 | 120 | 16 | 0 | 0 | 65535 | 1 | 0 | 100 | - 0 M_AI_5V_SENSOR_POWER2_FB | M_AI_5V_SENSOR_POWER2_FB | 加速踏板 2/档位执行器供电反馈 | J2-2或J3-6 | lineEdit | 0xC084 | 0x3 | 220 | 136 | 16 | 0 | 0 | 65535 | 1 | 0 | 100 | - 0 M_AI_5V_SENSOR_POWER3_FB | M_AI_5V_SENSOR_POWER3_FB | 后视镜/PM2.5供电反馈 | J9-23或J5-44 | lineEdit | 0xC084 | 0x3 | 220 | 152 | 16 | 0 | 0 | 65535 | 1 | 0 | 100 | - 0 M_AI_DoorLock_Current | M_AI_DoorLock_Current | 诊断反馈 | J4-10/J4-11 | lineEdit | 0xC084 | 0x3 | 220 | 168 | 16 | 0 | 0 | 65535 | 1 | 0 | 100 | - 0 M_AI_LSHCCtr_Current | M_AI_LSHCCtr_Current | 诊断反馈 | J5-15 | lineEdit | 0xC084 | 0x3 | 220 | 184 | 16 | 0 | 0 | 65535 | 1 | 0 | 100 | - 0 M_AI_RSHCCtr_Current | M_AI_RSHCCtr_Current | 诊断反馈 | J2-50 | lineEdit | 0xC084 | 0x3 | 220 | 200 | 16 | 0 | 0 | 65535 | 1 | 0 | 100 | - 0 M_AI_ChildLock_Current | M_AI_ChildLock_Current | 诊断反馈 | J5-40/J5-41 | lineEdit | 0xC084 | 0x3 | 220 | 216 | 16 | 0 | 0 | 65535 | 1 | 0 | 100 | - 0 M_AI_FLHandle_Current | M_AI_FLHandle_Current | 诊断反馈 | J8-1/J8-5 | lineEdit | 0xC084 | 0x3 | 220 | 232 | 16 | 0 | 0 | 65535 | 1 | 0 | 100 | - 0 M_AI_RLHandle_Current | M_AI_RLHandle_Current | 诊断反馈 | J4-12/J4-13 | lineEdit | 0xC084 | 0x3 | 220 | 248 | 16 | 0 | 0 | 65535 | 1 | 0 | 100 | - 0 M_AI_FMirrorFold_Current | M_AI_FMirrorFold_Current | 诊断反馈 | J8-6/J8-7 | lineEdit | 0xC084 | 0x3 | 220 | 264 | 16 | 0 | 0 | 65535 | 1 | 0 | 100 | - 0 M_AI_FLDoorLock_Current | M_AI_FLDoorLock_Current | 诊断反馈 | J9-20/J9-40 | lineEdit | 0xC084 | 0x3 | 220 | 280 | 16 | 0 | 0 | 65535 | 1 | 0 | 100 | - 0 M_AI_VBAT | M_AI_VBAT | BAT电池电压反馈 | T823 | lineEdit | 0xC084 | 0x3 | 220 | 296 | 16 | 0 | 0 | 65535 | 1 | 0 | 100 | - 0 M_AI_DrvSeatAdjSwSld | M_AI_DrvSeatAdjSwSld | 主驾座椅滑轨调节开关 | J2-35 | lineEdit | 0xC084 | 0x3 | 220 | 312 | 16 | 0 | 0 | 65535 | 1 | 0 | 100 | - 0 M_AI_DrvSeatAdjSwHei | M_AI_DrvSeatAdjSwHei | 主驾座椅高度调节开关 | J2-46 | lineEdit | 0xC084 | 0x3 | 220 | 328 | 16 | 0 | 0 | 65535 | 1 | 0 | 100 | - 0 M_AI_DrvSeatAdjSwBackInc | M_AI_DrvSeatAdjSwBackInc | 主驾座椅靠背调节开关 | J2-33 | lineEdit | 0xC084 | 0x3 | 220 | 344 | 16 | 0 | 0 | 65535 | 1 | 0 | 100 | - 0 M_AI_AbatVentOpenSw_LS | M_AI_AbatVentOpenSw_LS | 遮阳帘打开开关信号 | J2-36 | lineEdit | 0xC084 | 0x3 | 220 | 360 | 16 | 0 | 0 | 65535 | 1 | 0 | 100 | - 0 M_AI_SteeringWheelTemp | M_AI_SteeringWheelTemp | 方向盘加热温度检测 | J7-14 | lineEdit | 0xC084 | 0x3 | 220 | 376 | 16 | 0 | 0 | 65535 | 1 | 0 | 100 | - 0 M_AI_InCarTempSensoR | M_AI_InCarTempSensoR | 车内温度传感器 | J7-15 | lineEdit | 0xC084 | 0x3 | 220 | 392 | 16 | 0 | 0 | 65535 | 1 | 0 | 100 | - 0 M_AI_MotorWaterTempSensorA | M_AI_MotorWaterTempSensorA | 电驱回路水温传感器 | J3-9 | lineEdit | 0xC084 | 0x3 | 220 | 408 | 16 | 0 | 0 | 65535 | 1 | 0 | 100 | - 0 M_AI_ThirdRowLtSBRSt | M_AI_ThirdRowLtSBRSt | 三排左侧 SBR检测 | J2-20 | lineEdit | 0xC084 | 0x3 | 220 | 424 | 16 | 0 | 0 | 65535 | 1 | 0 | 100 | - 0 M_AI_SeatRowSecLtSBRSt | M_AI_SeatRowSecLtSBRSt | 左后座占位开关 | J2-11 | lineEdit | 0xC084 | 0x3 | 220 | 440 | 16 | 0 | 0 | 65535 | 1 | 0 | 100 | - 0 M_AI_BatteryWaterTempSensorA | M_AI_BatteryWaterTempSensorA | 电池回路水温传感器 | J3-3 | lineEdit | 0xC084 | 0x3 | 220 | 456 | 16 | 0 | 0 | 65535 | 1 | 0 | 100 | - 0 M_AI_VacuumPressSensor | M_AI_VacuumPressSensor | 预留 | J3-4 | lineEdit | 0xC084 | 0x3 | 220 | 472 | 16 | 0 | 0 | 65535 | 1 | 0 | 100 | - 0 M_AI_EmergencyPowerOff | M_AI_EmergencyPowerOff | 紧急下电检测 | J2-8 | lineEdit | 0xC084 | 0x3 | 220 | 488 | 16 | 0 | 0 | 65535 | 1 | 0 | 100 | - 0 M_AI_BAT_VBATPullUp_FB | M_AI_BAT_VBATPullUp_FB | 上拉电压检测 | T896 | lineEdit | 0xC084 | 0x3 | 220 | 504 | 16 | 0 | 0 | 65535 | 1 | 0 | 100 | - 0 M_AI_GearShift_P1 | M_AI_GearShift_P1 | P档 | J7-9 | lineEdit | 0xC084 | 0x3 | 220 | 520 | 16 | 0 | 0 | 65535 | 1 | 0 | 100 | - 0 M_AI_GearShift_P2 | M_AI_GearShift_P2 | P档 | J7-17 | lineEdit | 0xC084 | 0x3 | 220 | 536 | 16 | 0 | 0 | 65535 | 1 | 0 | 100 | - 0 M_AI_GearShift_N1 | M_AI_GearShift_N1 | N档 | J7-8 | lineEdit | 0xC084 | 0x3 | 220 | 552 | 16 | 0 | 0 | 65535 | 1 | 0 | 100 | - 0 M_AI_GearShift_N2 | M_AI_GearShift_N2 | N档 | J6-12 | lineEdit | 0xC084 | 0x3 | 220 | 568 | 16 | 0 | 0 | 65535 | 1 | 0 | 100 | - 0 M_AI_GearShift_R1 | M_AI_GearShift_R1 | R档 | J7-7 | lineEdit | 0xC084 | 0x3 | 220 | 584 | 16 | 0 | 0 | 65535 | 1 | 0 | 100 | - 0 M_AI_GearShift_R2 | M_AI_GearShift_R2 | R档 | J7-6 | lineEdit | 0xC084 | 0x3 | 220 | 600 | 16 | 0 | 0 | 65535 | 1 | 0 | 100 | - 0 M_AI_GearShift_D1 | M_AI_GearShift_D1 | D档 | J7-20 | lineEdit | 0xC084 | 0x3 | 220 | 616 | 16 | 0 | 0 | 65535 | 1 | 0 | 100 | - 0 M_AI_GearShift_D2 | M_AI_GearShift_D2 | D档 | J7-10 | lineEdit | 0xC084 | 0x3 | 220 | 632 | 16 | 0 | 0 | 65535 | 1 | 0 | 100 | - 0 M_AI_AtmosphericPressSensor | M_AI_AtmosphericPressSensor | 预留 | J7-16 | lineEdit | 0xC084 | 0x3 | 220 | 648 | 16 | 0 | 0 | 65535 | 1 | 0 | 100 | - 0 M_AI_MirrorSelectSw | M_AI_MirrorSelectSw | 后视镜选择开关 | J9-30 | lineEdit | 0xC084 | 0x3 | 220 | 664 | 16 | 0 | 0 | 65535 | 1 | 0 | 100 | - 0 M_AI_LMirrorUDPositionFb | M_AI_LMirrorUDPositionFb | 左外后视镜上下位置采样 | J9-33 | lineEdit | 0xC084 | 0x3 | 220 | 680 | 16 | 0 | 0 | 65535 | 1 | 0 | 100 | - 0 M_AI_LMirrorLRPositionFb | M_AI_LMirrorLRPositionFb | 左外后视镜左右位置采样 | J9-31 | lineEdit | 0xC084 | 0x3 | 220 | 696 | 16 | 0 | 0 | 65535 | 1 | 0 | 100 | - 0 M_AI_MirrorDirSw | M_AI_MirrorDirSw | 后视镜方向调节开关 | J9-28 | lineEdit | 0xC084 | 0x3 | 220 | 712 | 16 | 0 | 0 | 65535 | 1 | 0 | 100 | - 0 M_AI_DFLWindowCtrSw | M_AI_DFLWindowCtrSw | 主驾玻璃升降开关 -左前 | J9-35 | lineEdit | 0xC084 | 0x3 | 220 | 728 | 16 | 0 | 0 | 65535 | 1 | 0 | 100 | - 0 M_AI_DRLWindowCtrSw | M_AI_DRLWindowCtrSw | 主驾玻璃升降开关 -左后 | J9-18 | lineEdit | 0xC084 | 0x3 | 220 | 744 | 16 | 0 | 0 | 65535 | 1 | 0 | 100 | - 0 M_AI_DRRWindowCtrSw | M_AI_DRRWindowCtrSw | 主驾玻璃升降开关 -右后 | J9-32 | lineEdit | 0xC084 | 0x3 | 220 | 760 | 16 | 0 | 0 | 65535 | 1 | 0 | 100 | - 0 M_AI_DFRWindowCtrSw | M_AI_DFRWindowCtrSw | 主驾玻璃升降开关 -右前 | J9-34 | lineEdit | 0xC084 | 0x3 | 220 | 776 | 16 | 0 | 0 | 65535 | 1 | 0 | 100 | - 0 M_AI_SRLAbatVentSw | M_AI_SRLAbatVentSw | 二排左侧遮阳帘升降开关 | J2-49 | lineEdit | 0xC084 | 0x3 | 220 | 792 | 16 | 0 | 0 | 65535 | 1 | 0 | 100 | - 0 M_AI_DrvSeatAdjSwFrntHei | M_AI_DrvSeatAdjSwFrntHei | 主驾座椅俯仰调节开关 | J2-48 | lineEdit | 0xC084 | 0x3 | 220 | 808 | 16 | 0 | 0 | 65535 | 1 | 0 | 100 | - 0 M_AI_ASCtrSw | M_AI_ASCtrSw | 悬挂开关 | J2-47 | lineEdit | 0xC084 | 0x3 | 220 | 824 | 16 | 0 | 0 | 65535 | 1 | 0 | 100 | - 0 M_AI_RLWindowCtrSw | M_AI_RLWindowCtrSw | 左后玻璃升降开关 | J5-48 | lineEdit | 0xC084 | 0x3 | 220 | 840 | 16 | 0 | 0 | 65535 | 1 | 0 | 100 | - 0 M_AI_ChargeDirectTemp1 | M_AI_ChargeDirectTemp1 | 直流充电口温度 1 | J5-49 | lineEdit | 0xC084 | 0x3 | 220 | 856 | 16 | 0 | 0 | 65535 | 1 | 0 | 100 | - 0 M_AI_ChargeDirectTemp2 | M_AI_ChargeDirectTemp2 | 直流充电口温度 2 | J5-37 | lineEdit | 0xC084 | 0x3 | 220 | 872 | 16 | 0 | 0 | 65535 | 1 | 0 | 100 | - 0 M_AI_ChargeDirectTemp3 | M_AI_ChargeDirectTemp3 | 直流充电口温度 3 | J5-34 | lineEdit | 0xC084 | 0x3 | 220 | 888 | 16 | 0 | 0 | 65535 | 1 | 0 | 100 | - 0 M_AI_ChargeDirectTemp4 | M_AI_ChargeDirectTemp4 | 直流充电口温度 4 | J5-24 | lineEdit | 0xC084 | 0x3 | 220 | 904 | 16 | 0 | 0 | 65535 | 1 | 0 | 100 | - 0 M_AI_PDUTempSensor1 | M_AI_PDUTempSensor1 | PDU温度传感器 1 | J5-38 | lineEdit | 0xC084 | 0x3 | 220 | 920 | 16 | 0 | 0 | 65535 | 1 | 0 | 100 | - 0 M_AI_PDUTempSensor2 | M_AI_PDUTempSensor2 | PDU温度传感器 2 | J5-23 | lineEdit | 0xC084 | 0x3 | 220 | 936 | 16 | 0 | 0 | 65535 | 1 | 0 | 100 | - 0 M_AI_ChargeTemp1 | M_AI_ChargeTemp1 | 交流充电口温度 1 | J5-50 | lineEdit | 0xC084 | 0x3 | 220 | 952 | 16 | 0 | 0 | 65535 | 1 | 0 | 100 | - 0 M_AI_ChargeTemp2 | M_AI_ChargeTemp2 | 交流充电口温度 2 | J5-36 | lineEdit | 0xC084 | 0x3 | 220 | 968 | 16 | 0 | 0 | 65535 | 1 | 0 | 100 | - 0 M_AI_RLSeatTemp | M_AI_RLSeatTemp | 交流充电口温度 3 | J5-10 | lineEdit | 0xC084 | 0x3 | 220 | 984 | 16 | 0 | 0 | 65535 | 1 | 0 | 100 | - 0 M_AI_AccPositionSensor1 | M_AI_AccPositionSensor1 | 加速踏板位置采样 1 | J5-39 | lineEdit | 0xC084 | 0x3 | 220 | 1000 | 16 | 0 | 0 | 65535 | 1 | 0 | 100 | - 0 M_AI_AccPositionSensor2 | M_AI_AccPositionSensor2 | 加速踏板位置采样 2 | J5-47 | lineEdit | 0xC084 | 0x3 | 220 | 1016 | 16 | 0 | 0 | 65535 | 1 | 0 | 100 | - 0 M_AI_BatteryWaterTempSensorB | M_AI_BatteryWaterTempSensorB | 电池水温传感器信号 B | J5-51 | lineEdit | 0xC084 | 0x3 | 220 | 1032 | 16 | 0 | 0 | 65535 | 1 | 0 | 100 | - 0 M_AI_MotorWaterTempSensorB | M_AI_MotorWaterTempSensorB | 电机水温传感器信号 B | J5-35 | lineEdit | 0xC084 | 0x3 | 220 | 1048 | 16 | 0 | 0 | 65535 | 1 | 0 | 100 | - 0 M_AI_DrvSeatTemp | M_AI_DrvSeatTemp | 主驾座椅温度采样 | J2-24 | lineEdit | 0xC084 | 0x3 | 220 | 1064 | 16 | 0 | 0 | 65535 | 1 | 0 | 100 | - 0 M_AI_WINDOW_CURRENT1 | M_AI_WINDOW_CURRENT1 | 左前车窗电流检测 | J8-2/J8-3 | lineEdit | 0xC084 | 0x3 | 220 | 1080 | 16 | 0 | 0 | 65535 | 1 | 0 | 100 | - 0 M_AI_WINDOW_CURRENT2 | M_AI_WINDOW_CURRENT2 | 左后车窗电流检测 | J4-24/J4-25 | lineEdit | 0xC084 | 0x3 | 220 | 1096 | 16 | 0 | 0 | 65535 | 1 | 0 | 100 | - 0 Hardware_version_AI1 | Hardware_version_AI1 | 硬件版本识别 | T933 | lineEdit | 0xC084 | 0x3 | 220 | 1112 | 16 | 0 | 0 | 65535 | 1 | 0 | 100 | - 0 Hardware_version_AI2 | Hardware_version_AI2 | 硬件版本识别 | T935 | lineEdit | 0xC084 | 0x3 | 220 | 1128 | 16 | 0 | 0 | 65535 | 1 | 0 | 100 | - 0 M_AI_LMirrorTemp | M_AI_LMirrorTemp | 后视镜加热温度检测 | J9-17 | lineEdit | 0xC084 | 0x3 | 220 | 1144 | 16 | 0 | 0 | 65535 | 1 | 0 | 100 | - 0000 Motor Control | Motor Control | Motor Control | IO引脚 | pushButton | 0xC085 | 0x1 | 8 | 0 | 0 | 0 | 0 | 0 | 0 | 0 | 500 | - 0 J_Hbridge_EPBCtr | J_Hbridge_EPBCtr | EPB电机 | J4-19/J4 -20 | interlockCheckBox | 0xC085 | 0x1 | 8 | 0 | 2 | 0 | 0 | 3 | 1 | 0 | 500 | Lock 0 J_HBridge_RLDoorLockCtr | J_HBridge_RLDoorLockCtr | 左后门锁电机 | J4-10/J4 -11 | interlockCheckBox | 0xC085 | 0x1 | 8 | 2 | 2 | 0 | 0 | 3 | 1 | 0 | 500 | Lock 0 J_HBridge_LChildLockCtr | J_HBridge_LChildLockCtr | 左儿童锁电机 | J5-40/J5 -41 | interlockCheckBox | 0xC085 | 0x1 | 8 | 4 | 2 | 0 | 0 | 3 | 1 | 0 | 500 | - 0 J_HBridge_FLHandleCtr | J_HBridge_FLHandleCtr | 左前门把手电机 | J8-1/J8-5 | interlockCheckBox | 0xC085 | 0x1 | 8 | 6 | 2 | 0 | 0 | 3 | 1 | 0 | 500 | - 0 J_HBridge_FLDoorLockCtr | J_HBridge_FLDoorLockCtr | 左前门锁电机 | J9-20/J9 -40 | interlockCheckBox | 0xC085 | 0x1 | 8 | 8 | 2 | 0 | 0 | 3 | 1 | 0 | 500 | - 0 J_HBridge_RLHandleCtr | J_HBridge_RLHandleCtr | 左后门把手电机 (RLHandle) | J4-12/J4 -13 | interlockCheckBox | 0xC085 | 0x1 | 8 | 10 | 2 | 0 | 0 | 3 | 1 | 0 | 500 | - 0 J_HBridge_FMirrorFoldCtr | J_HBridge_FMirrorFoldCtr | 后视镜折叠电机 (FMirrorFold) | J8-6/J8-7 | interlockCheckBox | 0xC085 | 0x1 | 8 | 12 | 2 | 0 | 0 | 3 | 1 | 0 | 500 | - 0 J_HBridge_LCarpetLight | J_HBridge_LCarpetLight | 迎宾光毯 | J2-50 | interlockCheckBox | 0xC085 | 0x1 | 8 | 14 | 2 | 0 | 0 | 3 | 1 | 0 | 500 | Lock 0 J_HBridge_IMS_Heated | J_HBridge_IMS_Heated | IMS加热 | J5-15 | interlockCheckBox | 0xC085 | 0x1 | 8 | 16 | 2 | 0 | 0 | 3 | 1 | 0 | 500 | Lock 0 J_HBridge_FMirrorUDCtr | J_HBridge_FMirrorUDCtr | 左外后视镜上下调节 | J8-10/J8-12 | interlockCheckBox | 0xC085 | 0x1 | 8 | 18 | 2 | 0 | 0 | 3 | 1 | 0 | 500 | - 0 J_HBridge_FMirrorLRCtr | J_HBridge_FMirrorLRCtr | 左外后视镜左右调节 | J8-9/J8-10 | interlockCheckBox | 0xC085 | 0x1 | 8 | 20 | 2 | 0 | 0 | 3 | 1 | 0 | 500 | - 0 J_Hbridge_RearAbatVentCtr | J_Hbridge_RearAbatVentCtr | 电动遮阳帘调节 | J4-6/J4-7 | interlockCheckBox | 0xC085 | 0x1 | 8 | 22 | 2 | 0 | 0 | 3 | 1 | 0 | 500 | - 0 J_Hbridge_ESCCUForwardBackward | J_Hbridge_ESCCUForwardBackward | 电调管柱上下 | J6-2/J6-4 | interlockCheckBox | 0xC085 | 0x1 | 8 | 24 | 2 | 0 | 0 | 3 | 1 | 0 | 500 | - 0 J_Hbridge_ESCCUUpDown | J_Hbridge_ESCCUUpDown | 电调管柱左右 | J6-4/J4-3 | interlockCheckBox | 0xC085 | 0x1 | 8 | 26 | 2 | 0 | 0 | 3 | 1 | 0 | 500 0 J_Hbridge_SteeringWheelHeatedReturn | J_Hbridge_SteeringWheelHeatedReturn | 座椅加热反馈 | J4-5(预留)/J6-3 | interlockCheckBox | 0xC085 | 0x1 | 8 | 28 | 2 | 0 | 0 | 3 | 1 | 0 | 500 0 J_Hbridge_SteeringWheelHeatedReturn_Reverse | J_Hbridge_SteeringWheelHeatedReturn_Reverse | 预留 | interlockCheckBox | 0xC085 | 0x1 | 8 | 30 | 2 | 0 | 0 | 3 | 1 | 0 | 500 0 J_Hbridge_DrvSeatBackInc | J_Hbridge_DrvSeatBackInc | 预留 | interlockCheckBox | 0xC085 | 0x1 | 8 | 32 | 2 | 0 | 0 | 3 | 1 | 0 | 500 | - 0 J_Hbridge_DrvSeatHei | J_Hbridge_DrvSeatHei | 预留 | J4-8/J4-9 | interlockCheckBox | 0xC085 | 0x1 | 8 | 34 | 2 | 0 | 0 | 3 | 1 | 0 | 500 | - 0 J_HBridge_FLCWindowCtr | J_HBridge_FLCWindowCtr | 左前车窗调节 | J8-2/J8-3 | interlockCheckBox | 0xC085 | 0x1 | 8 | 36 | 2 | 0 | 0 | 3 | 1 | 0 | 500 | - 0 J_HBridge_FLCinchMotorCtr | J_HBridge_FLCinchMotorCtr | 主驾电吸门控制 | J4-22/J4 -23 | interlockCheckBox | 0xC085 | 0x1 | 8 | 38 | 2 | 0 | 0 | 3 | 1 | 0 | 500 | - 0 J_Hbridge_RLWindowCtr | J_Hbridge_RLWindowCtr | 左后车窗控制 | J4-24/J4 -25 | interlockCheckBox | 0xC085 | 0x1 | 8 | 40 | 2 | 0 | 0 | 3 | 1 | 0 | 500 | - 0 FMirrorUDCtr_EN | FMirrorUDCtr_EN | 控制左外后视镜上下调节使能 | J8-10/J8-12 | checkBox | 0xC085 | 0x1 | 8 | 60 | 1 | 0 | 0 | 1 | 1 | 0 | 500 | - 0 FMirrorLRCtr_EN | FMirrorLRCtr_EN | 控制左外后视镜左右调节使能 | J8-9/J8-10 | checkBox | 0xC085 | 0x1 | 8 | 61 | 1 | 0 | 0 | 1 | 1 | 0 | 500 | - 0 ESCCUUDCtrl_EN | ESCCUUDCtrl_EN | 控制电调管柱上下使能 （使能为1） | J6-2/J6-4 | checkBox | 0xC085 | 0x1 | 8 | 62 | 1 | 0 | 0 | 1 | 1 | 0 | 500 | - 0 ESCCULRCtrl_EN | ESCCULRCtrl_EN | 控制电调管柱左右使能 （使能为1） | J6-4/J4-3 | checkBox | 0xC085 | 0x1 | 8 | 63 | 1 | 0 | 0 | 1 | 1 | 0 | 500 | - 000 Eeprom write | Eeprom write | Eeprom write | IO引脚 | pushButton | 0xC086 | 0x1 | 1 | 0 | 0 | 0 | 0 | 0 | 0 | 0 | 0 | - 0 Eeprom Write | Eeprom Write | Eeprom write | horizontalSlider | 0xC086 | 0x1 | 1 | 0 | 8 | 0 | 0 | 255 | 1 | 0 | 0 | Lock 00 Eeprom read | Eeprom read | Eeprom read | IO引脚 | pushButton | 0xC086 | 0x3 | 1 | 0 | 0 | 0 | 0 | 0 | 0 | 0 | 0 | - 0 Eeprom Read | Eeprom Read | Eeprom read | lineEdit | 0xC086 | 0x3 | 1 | 0 | 8 | 0 | 0 | 255 | 1 | 0 | 0 | Lock 00 EMMC write | EMMC write | EMMC write | IO引脚 | pushButton | 0xC087 | 0x1 | 1 | 0 | 0 | 0 | 0 | 0 | 0 | 0 | 0 | - 0 EMMC Write | EMMC Write | EMMC write | horizontalSlider | 0xC087 | 0x1 | 1 | 0 | 8 | 0 | 0 | 255 | 1 | 0 | 0 | Lock 00 EMMC read | EMMC read | EMMC read | IO引脚 | pushButton | 0xC087 | 0x3 | 1 | 0 | 0 | 0 | 0 | 0 | 0 | 0 | 0 | - 0 EMMC Read | EMMC Read | EMMC read | lineEdit | 0xC087 | 0x3 | 1 | 0 | 8 | 0 | 0 | 255 | 1 | 0 | 0 | Lock 00 Dac Control | Dac Control | Dac Control | IO引脚 | pushButton | 0xC088 | 0x1 | 2 | 0 | 0 | 0 | 0 | 0 | 0 | 0 | 0 | - 0 DAC Control | DAC Control | DAC Control | horizontalSlider | 0xC088 | 0x1 | 2 | 8 | 16 | 0 | 0 | 1023 | 1 | 0 | 0 | Lock 00 RKE Control | RKE Control | RKE Control | IO引脚 | pushButton | 0xC089 | 0x1 | 1 | 0 | 0 | 0 | 0 | 0 | 0 | 0 | 0 | - 0 RKE_Channel_1 | RKE_Channel_1 | 低频通道1 | checkBox | 0xC089 | 0x1 | 1 | 0 | 1 | 0 | 0 | 1 | 1 | 0 | 0 | - 0 RKE_Channel_2 | RKE_Channel_2 | 低频通道2 | checkBox | 0xC089 | 0x1 | 1 | 1 | 1 | 0 | 0 | 1 | 1 | 0 | 0 | - 0 RKE_Channel_3 | RKE_Channel_3 | 低频通道3 | checkBox | 0xC089 | 0x1 | 1 | 2 | 1 | 0 | 0 | 1 | 1 | 0 | 0 | - 0 RKE_Channel_4 | RKE_Channel_4 | 低频通道4 | checkBox | 0xC089 | 0x1 | 1 | 3 | 1 | 0 | 0 | 1 | 1 | 0 | 0 | - 0 RKE_Channel_5 | RKE_Channel_5 | 低频通道5 | checkBox | 0xC089 | 0x1 | 1 | 4 | 1 | 0 | 0 | 1 | 1 | 0 | 0 | - 0 RKE_Channel_6 | RKE_Channel_6 | 低频通道6 | checkBox | 0xC089 | 0x1 | 1 | 5 | 1 | 0 | 0 | 1 | 1 | 0 | 0 | - 00 Lin Control | Lin Control | Lin Control | IO引脚 | 0xC08A | 0x1 | 1 | 0 | 0 | 0 | 0 | 0 | 0 | 0 | 0 | - 0 Lin channel 1 Control | Lin channel 1 Control | Lin通道1开关 | 0xC08A | 0x1 | 1 | 0 | 1 | 0 | 0 | 1 | 1 | 0 | 0 | - 0 Lin channel 2 Control | Lin channel 2 Control | Lin通道2开关 | 0xC08A | 0x1 | 1 | 1 | 1 | 0 | 0 | 1 | 1 | 0 | 0 | - 0 Lin channel 3 Control | Lin channel 3 Control | Lin通道3开关 | 0xC08A | 0x1 | 1 | 2 | 1 | 0 | 0 | 1 | 1 | 0 | 0 | - 0 Lin channel 4 Control | Lin channel 4 Control | Lin通道4开关 | 0xC08A | 0x1 | 1 | 3 | 1 | 0 | 0 | 1 | 1 | 0 | 0 | - 0 Lin channel 5 Control | Lin channel 5 Control | Lin通道5开关 | 0xC08A | 0x1 | 1 | 4 | 1 | 0 | 0 | 1 | 1 | 0 | 0 | - 0 Lin channel 6 Control | Lin channel 6 Control | Lin通道6开关 | 0xC08A | 0x1 | 1 | 5 | 1 | 0 | 0 | 1 | 1 | 0 | 0 | - 00 Lin Result | Lin Result | Lin Result | IO引脚 | 0xC08A | 0x3 | 1 | 0 | 0 | 0 | 0 | 0 | 0 | 0 | 0 | - 0 Lin channel 1 Result | Lin channel 1 Result | Lin通道1结果 | 0xC08A | 0x3 | 1 | 0 | 1 | 0 | 0 | 3 | 1 | 0 | 0 | - 0 Lin channel 2 Result | Lin channel 2 Result | Lin通道2结果 | 0xC08A | 0x3 | 1 | 1 | 1 | 0 | 0 | 3 | 1 | 0 | 0 | - 0 Lin channel 3 Result | Lin channel 3 Result | Lin通道3结果 | 0xC08A | 0x3 | 1 | 2 | 1 | 0 | 0 | 3 | 1 | 0 | 0 | - 0 Lin channel 4 Result | Lin channel 4 Result | Lin通道4结果 | 0xC08A | 0x3 | 1 | 3 | 1 | 0 | 0 | 3 | 1 | 0 | 0 | - 0 Lin channel 5 Result | Lin channel 5 Result | Lin通道5结果 | 0xC08A | 0x3 | 1 | 4 | 1 | 0 | 0 | 3 | 1 | 0 | 0 | - 0 Lin channel 6 Result | Lin channel 6 Result | Lin通道6结果 | 0xC08A | 0x3 | 1 | 5 | 1 | 0 | 0 | 3 | 1 | 0 | 0 | - 00 LIN1_set_id | LIN1_set_id | tableCell | 0xC080 | 0x3 | 8 | 0 | 1 | 0 | 0 | 1 | 1 | 0 | 0 | - 0 LIN1_set_data | LIN1_set_data | tableCell | 0xC080 | 0x3 | 8 | 0 | 1 | 0 | 0 | 1 | 1 | 0 | 0 | - 0 LIN2_set_id | LIN2_set_id | tableCell | 0xC080 | 0x3 | 8 | 0 | 1 | 0 | 0 | 1 | 1 | 0 | 0 | - 0 LIN2_set_data | LIN2_set_data | tableCell | 0xC080 | 0x3 | 8 | 0 | 1 | 0 | 0 | 1 | 1 | 0 | 0 | - 0 LIN1_get_data | LIN1_get_data | tableCell | 0xC080 | 0x3 | 8 | 0 | 1 | 0 | 0 | 1 | 1 | 0 | 0 | - 0 LIN2_get_data | LIN2_get_data | tableCell | 0xC080 | 0x3 | 8 | 0 | 1 | 0 | 0 | 1 | 1 | 0 | 0 | - 0 CAN2_set_id1 | CAN2_set_id1 | tableCell | 0xC080 | 0x3 | 8 | 0 | 1 | 0 | 0 | 1 | 1 | 0 | 0 | - 0 CAN2_set_id2 | CAN2_set_id2 | tableCell | 0xC080 | 0x3 | 8 | 0 | 1 | 0 | 0 | 1 | 1 | 0 | 0 | - 0 CAN2_have_id1 | CAN2_have_id1 | tableCell | 0xC080 | 0x3 | 8 | 0 | 1 | 0 | 0 | 1 | 1 | 0 | 0 | - 0 CAN2_have_id2 | CAN2_have_id2 | tableCell | 0xC080 | 0x3 | 8 | 0 | 1 | 0 | 0 | 1 | 1 | 0 | 0 | - 0 Internet_UDP_data | Internet_UDP_data | tableCell | 0xC080 | 0x3 | 8 | 0 | 1 | 0 | 0 | 1 | 1 | 0 | 0 | -
