Fred-Guo0422/H93_LDCU_EOL_TESTER/document/H93_LDCU/H93_LDCU_负载板原理图/XP-LRCU-L LoadBox(20230307_zb)BOM.xls

Sheet: BOM Report
Bill of Materials |  |  | XP-LRCU-L LoadBox(20230307_zb))).PcbDoc]
Source Data From: |  | XP-LRCU-L LoadBox(20230307_zb)
Project: |  | XP-LRCU-L LoadBox(20230307_zb).PrjPcb
Variant: |  | None
Creation Date: | 2023/3/8 | 11:21:13
Print Date:
 |  |  |  |  |  | 备注 | 采购数量
Footprint | Comment | LibRef | Designator | Description | Quantity
5.08mm-2-bend | 5.08mm | CON2-3.81 | J1, J2, J4 |  | 3 | 采购 | 10
T24X2-bend | T24X2 | T24X2 | J1-1 |  | 1 | 采购 | 2
T2X2-bend | T2X2 | T2X2 | J1-2 |  | 1 | 采购 | 2
T18X2-bend | T18X2 | T18X2 | J2-1 |  | 1 | 采购 | 2
T8X2-BEND | T8X2 | T8X2 | J2-2 |  | 1 | 采购 | 2
3.81mm-12 | CON 3.81 | CON12-2.54 | J3 |  | 1 | 采购 | 20
T16X2-BEND | T16X2 | T16X2 | J3-1 |  | 1 | 采购 | 2
3.81mm-5 | 3.81mm connector | CON5-3.81 | J3-2 |  | 1 | 采购 | 10
T13X2-bend | T13X2 | IDC13X2 | J4-1 |  | 1 | 采购 | 2
3.81mm-3 | 3.81 connector | CON3-3.81 | J5 |  | 1 | 采购 | 10
T14X2-bend | T14X2 | T14X2 | J5-1 |  | 1 | 采购 | 2
T12X2-bend | T12X2 | T12X2 | J5-2, JP5 |  | 2 | 采购 | 4
3.81mm-4-bend | 3.81MM | CON4-3.81 | J5-3 |  | 1 | 采购 | 2
T6X2-bend | T6X2 | T6X2 | J6 |  | 1 | 采购 | 2
T10X2-bend | T10X2 | IDC10X2 | J7 |  | 1 | 采购 | 2
3.81MM-10 | 3.81mm CONN | CON10-3.81 | J8, J12 |  | 2 | 采购 | 20
T7X2-bend | T7X2 | IDC7X2 | J8-1 |  | 1 | 采购 | 2
T20X2-bend | T20X2 | IDC20X2 | J9 |  | 1 | 采购 | 2
5.08mm-2-bend | 3.81mm | CON2-3.81 | J10 |  | 1 | 采购 | 10
3.81mm-6 | 3.81mm connector | CON6-3.81 | J11 |  | 1 | 采购 | 10
3.81mm-7 | 3.81 | CON7-3.96 | J13 |  | 1 | 采购 | 10
3.81mm-9 | 3.81MM | CON9-3.81 | J14 |  | 1 | 采购 | 10
IDC20 | IDC10X2 | IDC10X2 | JP1, JP3, JP4, JP7, JP10 |  | 5 | 采购 | 12
IDC34 | IDC17X2 | IDC17X2 | JP2, JP8 |  | 2 | 采购 | 5
IDC14 | IDC7X2 | IDC7X2 | JP6 |  | 1 | 采购 | 5
IDC30 | IDC15X2 | IDC15X2 | JP9, JP11 |  | 2 | 采购 | 5
3.81mm-2 | 3.81mm | CON2-3.81 | JP12 |  | 1 | 库存 | /
3.81mm-3 | Comment |  | P1 |  | 1 | 库存 | /
d2pak | NTD3055L104T4G | MOSFT-N | Q1 |  | 1 | 采购 | 3
AXIAL-1W | 1K | RES1 | R1 |  | 1 | 采购 | 100
AXIAL-0.25W | 2.7K/1% | RES1 | R2, R3, R4, R5, R6, R16, R29, R30, R41, R46, R50, R57, R65, R80, R81, R82, R83, R84, R85, R86, R120, R121, R122, R123, R124, R125, R126, R127, R127A, R142, R143, R144, R145, R146, R147, R148, R149, R150, R151, R152, R153, R153a, R153b, R153c, R180 |  | 45 | 采购 | 100
AXIAL-0.25W | 1K/1% | RES1 | R7, R14, R17, R31, R32, R33, R34, R38, R39, R43, R44, R48, R53, R61, R68, R87, R88, R91, R94, R96, R99, R102, R105, R107, R109, R111, R114, R116, R118, R119, R134, R136, R154, R159, R164, R166, R168a, R170, R172, R174, R181 |  | 41 | 采购 | 100
立式1 | 60R/10W | R | R8, R9, R10, R11, R19, R20, R21, R22, R23, R24, R25, R26, R27, R28, R76, R77, R78, R79, R89, R90, R90a, R128, R129, R130, R131, R132, R155, R156 |  | 28 | 采购 | 56
AXIAL-0.25W | 0R | RES1 | R12, R52, R54, R56, R58, R60, R62, R64, R110, R139, R140, R141, R160, R161, R162, R163 |  | 16 | 采购 | 50
AXIAL-1W | 390R/1W | RES1 | R13 |  | 1 | 采购 | 10
AXIAL-0.25W | 10K | RES1 | R15 |  | 1 | 采购 | 100
AXIAL-0.25W | 499R | RES1 | R35, R36, R40, R92, R112, R165, R167, R168b, R169, R171, R173, R175 |  | 12 | 采购 | 50
AXIAL-0.25W | 2.7K/1% | RES1 | R37 |  | 1 | 采购 | /
AXIAL-0.25W | 5.1K | RES1 | R42, R101, R117, R133, R135 |  | 5 | 采购 | 30
AXIAL-0.25W | 1.2K | RES1 | R45, R49, R55, R63, R70, R72, R74, R168 |  | 8 | 采购 | 30
AXIAL-0.25W | 634R | RES1 | R47, R51, R59, R66, R71, R73, R75 |  | 7 | 采购 | 30
AXIAL-0.25W | 3.3K | RES1 | R93, R95, R97, R104, R106, R108, R113, R115 |  | 8 | 采购 | 30
AXIAL-0.25W | 2.47K | RES1 | R158 |  | 1 | 采购 | 20
 |  |  |  |  | 214
Approved |  | Notes

Sheet: Project Information
Project Full Path | F:\工作\方案\上海捷普\202212\Covidien_Polaris\MT9S6NNV01_LVDS_Adapter_REV1\LVDS adapter board\optimize version-v2\LVDS adapter board_v2.PrjPcb
Project Filename | LVDS adapter board_v2.PrjPcb
Variant Name | None
Data-Source Filename | MT9S6(20221203_ZB).PcbDoc
Data-Source Full Path | F:\工作\方案\上海捷普\202212\Covidien_Polaris\MT9S6NNV01_LVDS_Adapter_REV1\LVDS adapter board\optimize version-v2\MT9S6(20221203_ZB).PcbDoc
Title | Bill of Materials For PCB Document [MT9S6(20221203_ZB).PcbDoc]
Total Quantity | 69
Report Time | 16:21:17
Report Date | 2022/12/5
Report Date & Tine | 2022/12/5 16:21:17
Output Name | Bill of Materials
Output Type | BOM_PartType
Output Generator Name | BOM
Output Generator Description | Bill of Materials
