Fred-Guo0422/H93_LDCU_EOL_TESTER/ConfigFiles/H93_LDCU_V1.4_0416.xlsx

Sheet: All PIN
PIN | Function | Current | singal type | remark | 负载信息 | 备注 | 电流 (A) | DUT测试状态 | 状态1下限 | 状态1上限 | 状态2下限 | 状态2上限 | 状态3下限 | 状态3上限 | 状态4下限 | 状态4上限 | 状态5下限 | 状态5上限 | VAVE删除信号测试
J1-01 | J_DO_LS_ 12VPWR2RLY | 500mA | DO-L | 预留 | 2.74K 上拉至VBAT | 检测输出： 低有效 | 0.004 | 状态1： 输出关断 状态2： 输出打开 | VBAT-0.5 | VBAT+0.5 | 0 | 0.5 | V
J1-02 | J_DO_LS_REOPRly | 500mA | DO-L | 后油泵继电器 | 2.74K 上拉至VBAT | 检测输出： 低有效 | 0.004 | 状态1： 输出打开 状态2： 输出关断 | 0 | 0.5 | VBAT-0.5 | VBAT+0.5 | V
J1-03 | J_ECANH | 100mA | CAN | ICAN（FD） | CAN卡 CAN1H
J1-04 | J ECANL | 100mA | CAN |  | CAN卡 CAN1L
J1-05 | J_DI_SlowChargeWake_HS | 10mA | DI-H | 预留 | 状态1： 悬空 状态2： VBAT | 提供数字量 |  | 状态1： 悬空 状态2： VBAT | 0 | 0 | 1 | 1 | 状态值
J1-06 | J_DI_BrakeSw 1_HS | 10mA | DI-H | 制动开关信号1 | 状态1： VBAT 状态2： 悬空 | 提供数字量 |  | 状态1： VBAT 状态2： 悬空 | 1 | 1 | 0 | 0 | 状态值
J1-07 | J LFDrive IMMO N | 2A | 低频天线驱动 | 预留
J1-08 | J_LFDrive_IMMO_P | 2A | 低频天线驱动 | 预留
J1-09 | J LFDrive PassengerDoor P | 2A | 低频天线驱动 | 预留
J1-010 | J_LFDrive_PassengerDoor_N | 2A | 低频天线驱动 | 预留
J1-011 | J_LFDrive_TailBumper_N | 2A | 低频天线驱动 | 预留
J1-012 | J LFDrive TailBumper P | 2A | 低频天线驱动 | 预留
J1-013 | J_LFDrive_Forward_N | 2A | 低频天线驱动 | 预留
J1-014 | J_DO_LS_ 12VPower1 | 500mA | DO-L | 12V取电口（行李箱） | 2.74K 上拉至VBAT | 检测输出： 低有效 | 0.004 | 状态1： 输出打开 状态2： 输出关断 | 0 | 0.5 | VBAT-0.5 | VBAT+0.5 | V
J1-015 | J_DO_LS_VaccumPumpRly | 500mA | DO-L | 预留 | 2.74K 上拉至VBAT | 检测输出： 低有效 | 0.004 | 状态1： 输出关断 状态2： 输出打开 | VBAT-0.5 | VBAT+0.5 | 0 | 0.5 | V
J1-016 | J_DO_LS_ 12VPower2 | 500mA | DO-L | 12V取电口（副IP台前） | 2.74K 上拉至VBAT | 检测输出： 低有效 | 0.004 | 状态1： 输出打开 状态2： 输出关断 | 0 | 0.5 | VBAT-0.5 | VBAT+0.5 | V
J1-017 | J_DO_LS_CarpetLight | 500mA | DO-L | 预留 | 2.74K 上拉至VBAT | 检测输出： 低有效 | 0.004 | 状态1： 输出关断 状态2： 输出打开 | VBAT-0.5 | VBAT+0.5 | 0 | 0.5 | V
J1-018 | J_DI_QuickChargeWake_HS | 10mA | DI-H | 预留 | 状态1： 悬空 状态2： VBAT | 提供数字量 |  | 状态1： 悬空 状态2： VBAT | 0 | 0 | 1 | 1 | 状态值
J1-019 | Sensor_GND | 500mA | GND | 预留
J1 21 | Sensor GND | 500mA | GND | 预留
J1-024 | J LFDrive DrvDoor N | 2A | 低频天线驱动 | 预留
J1-025 | J_LFDrive_DrvDoor_P | 2A | 低频天线驱动 | 预留
J1-026 | J LFDrive Forward P | 2A | 低频天线驱动 | 预留
J1-027 | J_PO_DiffuseCeilingLamp | 500mA | PWM-OUT | 预留 | 2.74K 上拉至VBAT | 检测输出： 占空比与频率 | 0.004 | 状态1： 25% 状态2： 75% | 99 | 101 | 99 | 101 | （频率）
J1-028 | Sensor_GND | 500mA | GND | 预留
J1-029 | J_DI_DCULifeBeat_Wake | 10mA | DI-L | 右域唤醒/心跳采样 | 状态1： GND 状态2： 悬空 | 提供数字量 |  | 状态1： GND 状态2： 悬空 | 0 | 0 | 1 | 1 | 状态值
J1-030 | J_DI_SRSCrash | 10mA | DI-L | 碰撞信号采集 | 状态1： 悬空 状态2： GND | 提供数字量 |  | 状态1： 悬空 状态2： GND | 1 | 1 | 0 | 0 | 状态值
J1-031 | Sensor_GND | 500mA | GND | 预留
J1-032 | Sensor GND | 500mA | GND | 预留
J1-033 | Sensor_GND | 500mA | GND | 预留
J1-035 | Sensor_GND | 500mA | GND | 预留
J1-036 | Sensor GND | 500mA | GND | 预留
J1-037 | Sensor_GND | 500mA | GND | 预留
J1 38 | Sensor GND | 500mA | GND | 紧急下电开关地
J1-039 | J LFDrive Trunk P | 2A | 低频天线驱动 | 预留
J1-040 | J_DO_LS_CWCEN | 500mA | DO-L | 预留 | 2.74K 上拉至VBAT | 检测输出： 低有效 | 0.004 | 状态1： 输出关断 状态2： 输出打开 | VBAT-0.5 | VBAT+0.5 | 0 | 0.5 | V
J1 41 | Sensor GND | 500mA | GND | 预留
J1-042 | Sensor_GND | 500mA | GND | 预留
J1-043 | Sensor_GND | 500mA | GND | 预留
J1-044 | J_DI_TrunkOpenSw_LS | 10mA | DI-L | 尾门开启开关 | 状态1： 悬空 状态2： GND | 提供数字量 |  | 状态1： 悬空 状态2： GND | 1 | 1 | 0 | 0 | 状态值
J1-045 | J_DI_RLDoorReleaseSW_LS | 10mA | DI-L | 预留 | 状态1： GND 状态2： 悬空 | 提供数字量 |  | 状态1： GND 状态2： 悬空 | 0 | 0 | 1 | 1 | 状态值
J1-046 | J_DI_EmergencyAlarmSw_LS | 10mA | DI-L | 紧急报警开关信号采集 | 状态1： 悬空 状态2： GND | 提供数字量 |  | 状态1： 悬空 状态2： GND | 1 | 1 | 0 | 0 | 状态值
J1-047 | J_DI_BrakeSw2_HS | 10mA | DI-H | 制动开关信号2 | 状态1： 悬空 状态2： VBAT | 提供数字量 |  | 状态1： 悬空 状态2： VBAT | 0 | 0 | 1 | 1 | 状态值
J1-050 | Sensor_GND | 500mA | GND | 预留
J1-051 | Sensor_GND | 500mA | GND | 预留
J1-052 | J LFDrive Trunk N | 2A | 低频天线驱动 | 预留
J2-01 | J_DI_KL15_BackUp_HS | 10mA | DI-H | 左域KL15电控制冗余采样 | 状态1： 悬空 状态2： VBAT | 提供数字量 |  | 状态1： 悬空 状态2： VBAT | 0 | 0 | 1 | 1 | 状态值
J2-02 | J_5V_SensorPower2 | 100mA | 5V-OUT | 加速踏板传感器2电源5V+ | 1K 下拉至GND | 检测输出： 5V有效 |  | 状态1： 输出打开 状态2： 输出关断 | 4.9 | 5.1 | 0 | 0.1 | V
回采 | M_AI_5V_SENSOR_POWER2_FB
J2-03 | J_DO_HS_BMSEmergencyStop | 500mA | DO-H | BMS紧急下电 | 2.74K 下拉至GND | 检测输出： 高有效 | 0.004 | 状态1： 输出打开 状态2： 输出关断 | VBAT-0.5 | VBAT+0.5 | 0 | 0.5 | V
J2-04 | J_DO_HS_KL15_BackUp | 1A | DO-H | 右域KL15电控制冗余 | 2.74K 下拉至GND | 检测输出： 高有效 | 0.004 | 状态1： 输出关断 状态2： 输出打开 | 0 | 0.5 | VBAT-0.5 | VBAT+0.5 | V
J2-05 | J_DO_HS_PM25FanPower | 500mA | DO-H | 预留 | 2.74K 下拉至GND | 检测输出： 高有效 | 0.004 | 状态1： 输出打开 状态2： 输出关断 | VBAT-0.5 | VBAT+0.5 | 0 | 0.5 | V
J2-06 | J_DO_LS_RLDoorHandleLight | 500mA | DO-L | 预留 | 2.74K 上拉至VBAT | 检测输出： 低有效 | 0.004 | 状态1： 输出打开 状态2： 输出关断 | 0 | 0.5 | VBAT-0.5 | VBAT+0.5 | V
J2-07 | J_DI_FLTopLightSw_LS | 10mA | DI-L | 左前顶灯开关 | 状态1： 悬空 状态2： GND | 提供数字量 |  | 状态1： 悬空 状态2： GND | 1 | 1 | 0 | 0 | 状态值
J2-08 | J_AI_EmergencyPowerOff | 50mA | AI | 紧急下电开关 | 电阻型： 状态1： 2.74K 下拉至GND 状态2： 1K 下拉至GND | 提供模拟量 |  | 状态1： 2.74K 下拉至GND 状态2： 1K 下拉至GND | 1.55 | 1.75 | 0.78 | 0.98 | V
J2-09 | J_DO_HS_MainPowerWake 1 | 1.5A | DO-H | MainPower1 | 60R/50W 下拉至GND | 检测输出： 高有效 | 0.2 | 状态1： 输出关断 状态2： 输出打开 | 0 | 0.5 | VBAT-0.5 | VBAT+0.5 | V
回采 | M_DI_MainPowerWake 1Fb |  |  |  |  |  |  | 状态1： 输出关断 状态2： 输出打开 | 0 | 0 | 1 | 1 | 状态值
J2-010 | J_DO_HS_KL15Wake 1 | 1.5A | DO-H | BLS2/MSB/ACU 唤醒 | 60R/50W 下拉至GND | 检测输出： 高有效 | 0.2 | 状态1： 输出打开 状态2： 输出关断 | VBAT-0.5 | VBAT+0.5 | 0 | 0.5 | V
J2-011 | J_AI_SeatRowSecLtSBRSt | 50mA | AI | 预留 | 电阻型： 状态1： 1K 下拉至GND 状态2： 499R 下拉至GND | 提供模拟量 |  | 状态1： 1K 下拉至GND 状态2： 499R 下拉至GND | 1.55 | 1.75 | 1 | 1.2 | V
J2-012 | J_DO_HS_CDCUWake | 1.5A | DO-H | CDCU唤醒 | 60R/50W 下拉至GND | 检测输出： 高有效 | 0.2 | 状态1： 输出打开 状态2： 输出关断 | VBAT-0.5 | VBAT+0.5 | 0 | 0.5 | V
J2-013 | J_DO_HS_CDCWake | 1.5A | DO-H | CDC唤醒 | 60R/50W 下拉至GND | 检测输出： 高有效 | 0.2 | 状态1： 输出关断 状态2： 输出打开 | 0 | 0.5 | VBAT-0.5 | VBAT+0.5 | V
J2-014 | J_PI_DriveHVIL_Fb | 10mA | PWM-IN | 驱动回路HVIL反馈采样 | PWM 高驱 0-VBAT | 提供PWM | 0.02 | 状态1： 25% 状态2： 75% | 99 | 101 | 99 | 101 | （频率Hz）
 |  |  |  |  |  |  |  |  | 24 | 26 | 74 | 76 | （占空比%）
J2-015 | Sensor GND | 500mA | GND | 加速踏板地2
J2-016 | Sensor_GND | 500mA | GND | 传感器GND
J2-018 | J_DI_RLTopLightSw_LS | 10mA | DI-L | 左后顶灯开关 | 状态1： GND 状态2： 悬空 | 提供数字量 |  | 状态1： GND 状态2： 悬空 | 0 | 0 | 1 | 1 | 状态值
J2-019 | J_DI_AeriaReadLampSW_LS | 10mA | DI-L | 预留 | 状态1： 悬空 状态2： GND | 提供数字量 |  | 状态1： 悬空 状态2： GND | 1 | 1 | 0 | 0 | 状态值
J2-020 | J_AI_ThirdRowLtSBRSt | 10mA | AI | 三排左侧SBR检测 | 电阻型： 状态1： 1K 下拉至GND 状态2： 499R 下拉至GND | 提供模拟量 |  | 状态1： 1K 下拉至GND 状态2： 499R 下拉至GND | 2.6 | 2.7 | 1.56 | 1.76 | V
J2-021 | J_DI_BrakeFluidLevel_LS | 10mA | DI-L | 预留 | 状态1： GND 状态2： 悬空 | 提供数字量 |  | 状态1： GND 状态2： 悬空 | 0 | 0 | 1 | 1 | 状态值
J2-022 | J_DI_ThirdRowBeltMid_LS | 10mA | DI-L | 三排中间安全带未系检测 | 状态1： 悬空 状态2： GND | 提供数字量 |  | 状态1： 悬空 状态2： GND | 1 | 1 | 0 | 0 | 状态值
J2-023 | J_DI_RLVoiceSw_LS | 10mA | DI-L | 预留 | 状态1： GND 状态2： 悬空 | 提供数字量 |  | 状态1： GND 状态2： 悬空 | 0 | 0 | 1 | 1 | 状态值
J2-024 | J_AI_DrvSeatTemp | 10mA | AI | 预留 | 电阻型： 状态1： 5.1K 下拉至GND 状态2： 1K 下拉至GND | 提供模拟量 |  | 状态1： 5.1K 下拉至GND 状态2： 1K 下拉至GND | 2.4 | 2.6 | 0.71 | 0.92 | V
J2-025 | J_DO_HS_CameraHeated | 3A | DO-H | 摄像头加热 | 60R/50W 下拉至GND | 检测输出： 高有效 | 0.2 | 状态1： 输出关断 状态2： 输出打开 | 0 | 0.5 | VBAT-0.5 | VBAT+0.5 | V
J2-026 | J_DO_HS_MainPowerWake2 | 1.5A | DO-H | MainPower2 (DC&OBC/EVCC/IPU- F/IPU-R/电子风扇KL87) | 60R/50W 下拉至GND | 检测输出： 高有效 | 0.2 | 状态1： 输出打开 状态2： 输出关断 | VBAT-0.5 | VBAT+0.5 | 0 | 0.5 | V
J2-027 | J_PI_ChargeHVIL_Fb | 10mA | PWM-IN | 预留
回采 | M_DI_MainPowerWake2Fb |  |  |  |  |  |  | 状态1： 输出打开 状态2： 输出关断 | 1 | 1 | 0 | 0 | 状态值
J2-028 | NC |  | NC
J2-029 | Sensor_GND |  | GND
J2-030 | J_DI_RLDoorAjarSW_LS | 10mA | DI-L | 左侧滑门锁状态 | 状态1： GND 状态2： 悬空 | 提供数字量 |  | 状态1： GND 状态2： 悬空 | 0 | 0 | 1 | 1 | 状态值
J2-031 | J_DI_RLOutHandleSW_LS | 10mA | DI-L | 预留 | 状态1： 悬空 状态2： GND | 提供数字量 |  | 状态1： 悬空 状态2： GND | 1 | 1 | 0 | 0 | 状态值
J2-032 | J_DI_RLDoorGearHomeSW_LS | 10mA | DI-L | 三排左侧安全带未系检测 | 状态1： GND 状态2： 悬空 | 提供数字量 |  | 状态1： GND 状态2： 悬空 | 0 | 0 | 1 | 1 | 状态值
J2-033 | J_AI_DrvSeatAdjSwBackInc | 10mA | AI | 预留 | 电阻型： 默认悬空 状态1： 1.2K 下拉至GND 状态2： 634R 下拉至GND | 提供模拟量 |  | 状态1： 1.2K 下拉至GND 状态2： 634R 下拉至GND | 1.85 | 2.05 | 1.33 | 1.53 | V
J2-034 | J_PI_DrvSeatHeightHALLFb | 10mA | PWM-IN | 预留 | PWM 高驱 上拉电阻为392R | 提供PWM 0-VBAT | 0.04 | 状态1： 25% 状态2： 75% | 99 | 101 | 99 | 101 | （频率）
 |  |  |  |  |  |  |  |  | 24 | 26 | 74 | 76 | （占空比）
 |  |  |  |  |  |  |  |  | VBAT-0.5 | VBAT+0.5 | VBAT-0.5 | VBAT+0.5 | （高电平）
 |  |  |  |  |  |  |  |  | 0 | 0.5 | 0 | 0.5 | （低电平）
J2-035 | J_AI_DrvSeatAdjSwSld | 10mA | AI | 预留 | 电阻型： 默认悬空 状态1： 1.2K 下拉至GND 状态2： 634R 下拉至GND | 提供模拟量 |  | 状态1： 1.2K 下拉至GND 状态2： 634R 下拉至GND | 1.85 | 2.05 | 1.33 | 1.53 | V
J2-036 | J_AI_AbatVentOpenSw_LS | 10mA | AI | 预留 | 电阻型： 默认悬空 状态1： 1.2K 下拉至GND 状态2： 634R 下拉至GND | 提供模拟量 |  | 状态1： 1.2K 下拉至GND 状态2： 634R 下拉至GND | 1.85 | 2.05 | 1.33 | 1.53 | V
J2-037 | J_DO_HS_ReverseLamp | 1.5A | DO-H | 倒车灯控制 | 60R/50W 下拉至GND | 检测输出： 高有效 | 0.2 | 状态1： 输出打开 状态2： 输出关断 | VBAT-0.5 | VBAT+0.5 | 0 | 0.5 | V
J2-038 | J_DO_HS_IntLgthPower | 500mA | DO-H | 行李箱灯节能输出、 中前顶灯节能 输出 | 60R/50W 下拉至GND | 检测输出： 高有效 | 0.2 | 状态1： 输出关断 状态2： 输出打开 | 0 | 0.5 | VBAT-0.5 | VBAT+0.5 | V
J2-039 | J_DO_HS_LampLimpHomeOut | 1A | DO-H | 近光灯LimpHome控制 | 60R/50W 下拉至GND | 检测输出： 高有效 | 0.2 | 状态1： 输出打开 状态2： 输出关断 | VBAT-0.5 | VBAT+0.5 | 0 | 0.5 | V
J2-040 | J_PI_DrvSeatBackIncHALLFb | 10mA | PWM-IN | 预留 | PWM 高驱 上拉电阻为392R | 提供PWM 0-VBAT | 0.02 | 状态1： 25% 状态2： 75% | 99 | 101 | 99 | 101 | （频率）
 |  |  |  |  |  |  |  |  | 24 | 26 | 74 | 76 | （占空比）
J2-041 | J_PI_AbatVentHALLFb | 10mA | PWM-IN | 预留 | PWM 高驱 上拉电阻为392R | 提供PWM 0-VBAT | 0.02 | 状态1： 25% 状态2： 75% | 99 | 101 | 99 | 101 | （频率）
 |  |  |  |  |  |  |  |  | 24 | 26 | 74 | 76 | （占空比）
J2-042 | J_PI_RLWindow_HallFb 1 | 10mA | PWM-IN | 左后玻璃升降电机霍尔反馈1 | PWM 高驱 0-VBAT (三线霍尔） | 提供PWM 0-VBAT | 0.02 | 状态1： 25% 状态2： 75% | 99 | 101 | 99 | 101 | （频率）
 |  |  |  |  |  |  |  |  | 24 | 26 | 74 | 76 | （占空比）
J2-043 | J_DI_RLDoorPawlSW_LS | 10mA | DI-L | 预留 | 状态1： 悬空 状态2： GND | 提供数字量 |  | 状态1： 悬空 状态2： GND | 1 | 1 | 0 | 0 | 状态值
J2-044 | J_PI_RLWindow_HallFb2 | 10mA | PWM-IN | 左后玻璃升降电机霍尔反馈2 | PWM 高驱 0-VBAT (三线霍尔） | 提供PWM 0-VBAT | 0.02 | 状态1： 25% 状态2： 75% | 99 | 101 | 99 | 101 | （频率）
 |  |  |  |  |  |  |  |  | 24 | 26 | 74 | 76 | （占空比）
J2-045 | J_PI_DrvSeatSldHALLFb | 10mA | PWM-IN | 预留 | PWM 高驱 上拉电阻为392R | 提供PWM 0-VBAT | 0.04 | 状态1： 25% 状态2： 75% | 99 | 101 | 99 | 101 | （频率）
 |  |  |  |  |  |  |  |  | 24 | 26 | 74 | 76 | （占空比）
 |  |  |  |  |  |  |  |  | VBAT-0 5 | VBAT+0 5 | VBAT-0 5 | VBAT+0 5 | （高电平）
 |  |  |  |  |  |  |  |  | 0 | 0.5 | 0 | 0.5 | （低电平）
J2-046 | J_AI_DrvSeatAdjSwHei | 10mA | AI | 预留 | 电阻型： 默认悬空 状态1： 1.2K 下拉至GND 状态2： 634R 下拉至GND | 提供模拟量 |  | 状态1： 1.2K 下拉至GND 状态2： 634R 下拉至GND | 1.85 | 2.05 | 1.33 | 1.53 | V
J2-047 | J_AI_ASCtrSw | 10mA | AI | 悬架升降开关信号 | 电阻型： 默认悬空 状态1： 1.2K 下拉至GND 状态2： 634R 下拉至GND | 提供模拟量 |  | 状态1： 1.2K 下拉至GND 状态2： 634R 下拉至GND | 1.85 | 2.05 | 1.33 | 1.53 | V
J2-048 | J_AI_DrvSeatAdjSwFrntHei | 10mA | AI | 预留 | 电阻型： 默认悬空 状态1： 1.2K 下拉至GND 状态2： 634R 下拉至GND | 提供模拟量 |  | 状态1： 1.2K 下拉至GND 状态2： 634R 下拉至GND | 1.85 | 2.05 | 1.33 | 1.53 | V
J2-049 | J_AI_SRLAbatVentSw | 10mA | AI | 预留 | 电阻型： 默认悬空 状态1： 1.2K 下拉至GND 状态2： 634R 下拉至GND | 提供模拟量 |  | 状态1： 1.2K 下拉至GND 状态2： 634R 下拉至GND | 1.85 | 2.05 | 1.33 | 1.53 | V
J2-050 | J_DO_HS_LCarpetLight | 3.2A | 全桥驱动 | 左侧迎宾光毯供电 | 10R/100W 下拉至GND | 检测输出： 高有效 | 1.2 | 状态1： 输出打开 状态2： 输出关断 | VBAT-0.5 | VBAT+0.5 | 0 | 0.5 | V
J2-051 | J_HBridge_RSHCCtr- | 3.2A | 全桥驱动 | 预留
J2-052 | J_DO_HS_RDCUWake | 1A | DO-H | 右域硬线唤醒/Lifebeat | 10R/100W 下拉至GND | 检测输出： 高有效 | 1.2 | 状态1： 输出关断 状态2： 输出打开 | 0 | 0.5 | VBAT-0.5 | VBAT+0.5 | V
J4-01 | J_DO_HS_BrakeLamp | 5A | DO-H | 制动灯控制 | 10R/100W 下拉至GND | 检测输出： 高有效 | 1.2 | 状态1： 输出打开 状态2： 输出关断 | VBAT-0.5 | VBAT+0.5 | 0 | 0.5 | V
回采 | M_AI_BrakeLamp_HeatCurrent
J4-02 | J_DO_HS_IMSPower | 5A | DO-H | 内流媒体后视镜供电 | 10R/100W 下拉至GND | 检测输出： 高有效 | 1.2 | 状态1： 输出关断 状态2： 输出打开 | 0 | 0.5 | VBAT-0.5 | VBAT+0.5 | V
J4-03 | J_Hbridge_ESCCUForwardBackward+ | 20A | 全桥驱动 | 管柱前后调节电机正
J4-04 | J_Hbridge_DrvSeatBackInc- | 20A | 全桥驱动 | 预留
J4-05 | SteeringWheelHeatedReturn | 20A | 全桥驱动 | 预留 | 10R/100W 下拉至GND | 检测输出： 高有效 | 1.2 | 状态1： 输出打开 状态2： 输出关断 | VBAT-0.5 | VBAT+0.5 | 0 | 0.5 | V
J4-06 | J_HBridge_RearAbatVentCtr+ | 20A | 全桥驱动 | 后遮阳帘电机正 | 10R/100W | 检测输出： 状态1： 高电平 状态2： 低电平 状态3： 低电平 | 1.2 | 状态1： 正转 状态2： 反转 状态3： 刹车 | VBAT-0.5 | VBAT+0.5 | 0 | 0.5 | 0 | 0.5 | V
J4-07 | J_HBridge_RearAbatVentCtr- | 20A | 全桥驱动 | 后遮阳帘电机负 |  | 检测输出： 状态1： 低电平 状态2： 高电平 状态3： 低电平 | 1.2 |  | 0 | 0.5 | VBAT-0.5 | VBAT+0.5 | 0 | 0.5 | V
回采 | M_AI_Seat_CSO1
J4-08 | J_Hbridge_DrvSeatHe | 30A | 全桥驱动 | 预留 | 10R/100W | 检测输出： 状态1： 低电平 状态2： 高电平 状态3： 低电平 | 1.2 | 状态1： 正转 状态2： 刹车 状态3： 反转 | 0 | 0.5 | 0 | 0.5 | VBAT-0.5 | VBAT+0.5 | V
J4-09 | J_Hbridge_DrvSeatHei+ | 30A | 全桥驱动 | 预留 |  | 检测输出： 状态1： 高电平 状态2： 低电平 状态3： 低电平 |  |  | VBAT-0.5 | VBAT+0.5 | 0 | 0.5 | 0 | 0.5 | V
回采 | M_AI_TLE92108_CSO1
J4-010 | J_HBridge_RLDoorLockCtr+ | 4.4A | PWM全桥驱动 | 左后门锁电机正 | 10R/100W | 检测输出： 状态1： 高电平 状态2： 低电平 状态3： 低电平 | 1.2 | 状态1： 门锁正转 状态2： 门锁反转 状态3： 刹车 | VBAT-0.5 | VBAT+0.5 | 0 | 0.5 | 0 | 0.5 | V
J4-011 | J_HBridge_RLDoorLockCtr- | 4.4A | PWM全桥驱动 | 左后门锁电机负 |  | 检测输出： 状态1： 低电平 状态2： 高电平 状态3： 低电平 |  |  | 0 | 0.5 | VBAT-0.5 | VBAT+0.5 | 0 | 0.5 | V
回采 | M_AI_DoorLock_Current
J4-012 | J_HBridge_RLHandleCtr- | 1. 1A/ 12A | 全桥驱动 | 预留 | 10R/100W | 检测输出： 状态1： 低电平 状态2： 高电平 状态3： 低电平 | 1.2 | 状态1： 正转 状态2： 刹车 状态3： 反转 | 0 | 0.5 | 0 | 0.5 | VBAT-0.5 | VBAT+0.5 | V
J4-013 | J_HBridge_RLHandleCtr+ | 1. 1A/ 12A | 全桥驱动 | 预留 |  | 检测输出： 状态1： 高电平 状态2： 低电平 状态3： 低电平 |  |  | VBAT-0.5 | VBAT+0.5 | 0 | 0.5 | 0 | 0.5 | V
回采 | M AI RLHandle Current
J4-014 | Sensor_GND | 500mA | GND | 传感器地
J4-015 | J_DO_HS_LtSlideDoor | 2A/5A | DO-H | 预留 | 60R/50W 下拉至GND | 检测输出： 高有效 | 0.2 | 状态1： 输出打开 状态2： 输出关断 | VBAT-0.5 | VBAT+0.5 | 0 | 0.5 | V
J4-016 | J_DO_HS_SeatVentPower | 3A | DO-H | 预留 | 60R/50W 下拉至GND | 检测输出： 高有效 | 0.2 | 状态1： 输出关断 状态2： 输出打开 | 0 | 0.5 | VBAT-0.5 | VBAT+0.5 | V
J4-017 | J_DO_HS_Backlight | 500mA | DO-H | 紧急报警开关背景灯/前顶灯背光/ 左后顶灯背光 | 60R/50W 下拉至GND | 检测输出： 高有效 | 0.2 | 状态1： 输出打开 状态2： 输出关断 | VBAT-0.5 | VBAT+0.5 | 0 | 0.5 | V
J4-018 | J_DO_HS_ATLPower | 2A | DO-H | ATL供电 | 60R/50W 下拉至GND | 检测输出： 高有效 | 0.2 | 状态1： 输出关断 状态2： 输出打开 | 0 | 0.5 | VBAT-0.5 | VBAT+0.5 | V
J4-019 | J_Hbridge_EPBCtr+ | 30A | 全桥驱动 | EPB左侧卡钳电机正 | 10R/100W | 检测输出： 状态1： 高电平 状态2： 低电平 状态3： 低电平 状态4： 低电平 | 1 2 | 状态1： EPB锁车 状态2： EPB解锁 状态3： EPB刹车 状态4： EPB OFF | VBAT-0.5 | VBAT+0.5 | 0 | 0.5 | 0 | 0.5 | 0 | 0.5 | V
J4-020 | J_Hbridge_EPBCtr- | 30A | 全桥驱动 | EPB左侧卡钳电机负 |  | 检测输出： 状态1： 低电平 状态2： 高电平 状态3： 低电平 状态4： 低电平 |  |  | 0 | 0.5 | VBAT-0.5 | VBAT+0.5 | 0 | 0.5 | 0 | 0.5 | V
J4-021 | Sensor_GND | 500mA | GND | 预留
J4-022 | J_HBridge_FLCinchMotorCt | 30A | 全桥驱动 | 预留 | 6R/50W | 检测输出： 状态1： 高电平 状态2： 低电平 状态3： 低电平 | 2 | 状态1： 反转 状态2： 正转 状态3： 刹车 | VBAT-0.5 | VBAT+0.5 | 0 | 0.5 | 0 | 0.5 | V
J4-023 | J_HBridge_FLCinchMotorCtr+ | 30A | 全桥驱动 |  |  | 检测输出： 状态1： 低电平 状态2： 高电平 状态3： 低电平 |  |  | 0 | 0.5 | VBAT-0.5 | VBAT+0.5 | 0 | 0.5 | V
J4-024 | J_Hbridge_RLWindowCtr+ | 12A/31A | 全桥驱动 | 左后车窗控制正 | 6R/50W | 检测输出： 状态1： 高电平 状态2： 低电平 状态3： 低电平 | 2 | 状态1： 正转 状态2： 反转 状态3： 刹车 | VBAT-0.5 | VBAT+0.5 | 0 | 0.5 | 0 | 0.5 | V
J4-025 | J_Hbridge_RLWindowCtr- | 12A/31A | 全桥驱动 | 左后车窗控制负 |  | 检测输出： 状态1： 低电平 状态2： 高电平 状态3： 低电平 |  |  | 0 | 0.5 | VBAT-0.5 | VBAT+0.5 | 0 | 0.5 | V
回采 | M_AI_WINDOW_CURRENT2
回采 | M AI TLE92108 CSO2
J5-01 | J_PCANH | 100mA | CAN | 预留
J5-02 | J_PO_LS_FLTopLight | 100mA | PWM-OUT | 左前顶灯 | 2.74K 上拉至VBAT | 检测输出： 低有效 | 0.004 | 状态1： 25% 状态2： 75% | 99 | 101 | 99 | 101 | （频率Hz）
 |  |  |  |  |  |  |  |  | 24 | 26 | 74 | 76 | （占空比%）
 |  |  |  |  |  |  |  |  | VBAT-0.5 | VBAT+0.5 | VBAT-0.5 | VBAT+0.5 | （高电平V）
 |  |  |  |  |  |  |  |  | 0 | 0 5 | 0 | 0 5 | （低电平V）
J5-03 | J_PO_LS_FRTopLight | 100mA | PWM-OUT | 右前顶灯 | 2.74K 上拉至VBAT | 检测输出： 低有效 | 0.004 | 状态1： 75% 状态2： 25% | 99 | 101 | 99 | 101 | （频率Hz）
 |  |  |  |  |  |  |  |  | 74 | 76 | 24 | 26 | （占空比%）
 |  |  |  |  |  |  |  |  | VBAT-0 5 | VBAT+0 5 | VBAT-0 5 | VBAT+0 5 | （高电平V）
 |  |  |  |  |  |  |  |  | 0 | 0.5 | 0 | 0.5 | （低电平V）
J5-04 | J_PO_LS_FMTopLight | 500mA | PWM-OUT | 中前顶灯 | 2.74K 上拉至VBAT | 检测输出： 低有效 | 0.004 | 状态1： 25% 状态2： 75% | 99 | 101 | 99 | 101 | （频率Hz）
 |  |  |  |  |  |  |  |  | 24 | 26 | 74 | 76 | （占空比%）
 |  |  |  |  |  |  |  |  | VBAT-0.5 | VBAT+0.5 | VBAT-0.5 | VBAT+0.5 | （高电平V）
 |  |  |  |  |  |  |  |  | 0 | 0 5 | 0 | 0 5 | （低电平V）
J5-05 | J_PO_LS_RLTopLight | 500mA | PWM-OUT | 左后顶灯 | 2.74K 上拉至VBAT | 检测输出： 低有效 | 0.004 | 状态1： 75% 状态2： 25% | 99 | 101 | 99 | 101 | （频率Hz）
 |  |  |  |  |  |  |  |  | 74 | 76 | 24 | 26 | （占空比%）
 |  |  |  |  |  |  |  |  | VBAT-0 5 | VBAT+0 5 | VBAT-0 5 | VBAT+0 5 | （高电平V）
 |  |  |  |  |  |  |  |  | 0 | 0.5 | 0 | 0.5 | （低电平V）
J5-06 | J_PO_LS_TLTopLight | 500mA | PWM-OUT | 三排左顶灯 | 2.74K 上拉至VBAT | 检测输出： 低有效 | 0.004 | 状态1： 25% 状态2： 75% | 99 | 101 | 99 | 101 | （频率Hz）
 |  |  |  |  |  |  |  |  | 24 | 26 | 74 | 76 | （占空比%）
 |  |  |  |  |  |  |  |  | VBAT-0.5 | VBAT+0.5 | VBAT-0.5 | VBAT+0.5 | （高电平V）
 |  |  |  |  |  |  |  |  | 0 | 0.5 | 0 | 0.5 | （低电平V）
J5-07 | J_PO_LS_TrunkLight | 500mA | PWM-OUT | 行李箱灯 | 2.74K 上拉至VBAT | 检测输出： 低有效 | 0.004 | 状态1： 75% 状态2： 25% | 99 | 101 | 99 | 101 | （频率Hz）
 |  |  |  |  |  |  |  |  | 74 | 76 | 24 | 26 | （占空比%）
 |  |  |  |  |  |  |  |  | VBAT-0 5 | VBAT+0 5 | VBAT-0 5 | VBAT+0 5 | （高电平V）
 |  |  |  |  |  |  |  |  | 0 | 0.5 | 0 | 0.5 | （低电平V）
J5-08 | J_ICANH | 100mA | CAN | ICAN（FD） | CAN卡 CAN2H
J5-09 | J ICANL | 100mA | CAN |  | CAN卡 CAN2L
J5-010 | J_AI_ChargeTemp3 | 10mA | AI | 预留 | 电阻型： 状态1： 3.3K 下拉至GND 状态2： 1K 下拉至GND | 提供模拟量 |  | 状态1： 3.3K 下拉至GND 状态2： 1K 下拉至GND | 2.4 | 2.6 | 1.06 | 1.26 | V
J5-011 | J UWBCANH | 100mA | CAN | UWBCAN（FD）
J5-012 | J_UWBCANL | 100mA | CAN
J5-013 | J_LIN_LSU/Heated | 50mA | LIN
J5-014 | J PCANL | 100mA | CAN | PCAN低
J5-015 | J_DO_HS_IMS_Heated | 3.2A | 全桥驱动 | 内流媒体后视镜摄像头加热 | 60R/50W 下拉至GND | 检测输出： 高有效 | 0.2 | 状态1： 输出关断 状态2： 输出打开 | 0 | 0.5 | VBAT-0.5 | VBAT+0.5 | V
J5-016 | J_PO_ChargeHVILOut | 500mA | PWM-OUT | 预留 | 2.74K 下拉至GND | 检测输出： 高有效 | 0.02 | 状态1： 25% 状态2： 75% | 99 | 101 | 99 | 101 | （频率）
J5-017 | Sensor GND | 500mA | GND | 预留
J5-018 | NC |  | NC
J5-019 | NC |  | NC
J5-020 | J_DI_FRTopLightSw_LS | 10mA | DI-L | 右前顶灯开关 | 状态1： GND 状态2： 悬空 | 提供数字量 |  | 状态1： GND 状态2： 悬空 | 0 | 0 | 1 | 1 | 状态值
J5-021 | J_DI_RLChildLockOrDoorOpen_LS | 10mA | DI-L | 预留 | 状态1： 悬空 状态2： GND | 提供数字量 |  | 状态1： 悬空 状态2： GND | 1 | 1 | 0 | 0 | 状态值
J5-022 | NC |  | NC
J5-023 | J_AI_PDUTempSensor2 | 50mA | AI | 预留 | 电阻型： 状态1： 3.3K 下拉至GND 状态2： 1K 下拉至GND | 提供模拟量 |  | 状态1： 3.3K 下拉至GND 状态2： 1K 下拉至GND | 2.4 | 2.6 | 1.06 | 1.26 | V
J5-024 | J_AI_ChargeDirectTemp4 | 50mA | AI | 预留 | 电阻型： 状态1： 3.3K 下拉至GND 状态2： 1K 下拉至GND | 提供模拟量 |  | 状态1： 3.3K 下拉至GND 状态2： 1K 下拉至GND | 2.4 | 2.6 | 1.06 | 1.26 | V
J5-025 | J LIN PWS | 50mA | LIN | 左侧智能表面LIN
J5-026 | J_LIN_RFR | 50mA | LIN | RFR LIN | 接RFR测试模块
J5-027 | J HBridge LSHCCtr- | 3 2A | 全桥驱动 | 预留
J5-028 | J_LIN_FKS | 50mA | LIN | 脚踢传感器LIN
J5-029 | NC |  | NC
J5-030 | NC |  | NC
J5-031 | J_DI_RSHCPosSW_LS | 10mA | DI-L | 预留 | 状态1： 悬空 状态2： GND | 提供数字量 |  | 状态1： 悬空 状态2： GND | 1 | 1 | 0 | 0 | 状态值
J5-032 | J_DI_TLTopLightSw_LS | 10mA | DI-L | 三排左顶灯开关 | 状态1： GND 状态2： 悬空 | 提供数字量 |  | 状态1： GND 状态2： 悬空 | 0 | 0 | 1 | 1 | 状态值
J5-034 | J_AI_ChargeDirectTemp3 | 50mA | AI | 预留 | 电阻型： 状态1： 3.3K 下拉至GND 状态2： 1K 下拉至GND | 提供模拟量 |  | 状态1： 3.3K 下拉至GND 状态2： 1K 下拉至GND | 2.4 | 2.6 | 1.06 | 1.26 | V
J5-035 | J_AI_MotorWaterTempSensorB | 50mA | AI | 电机水温传感器信号B | 电阻型： 状态1： 5.1K 下拉至GND 状态2： 1K 下拉至GND | 提供模拟量 |  | 状态1： 5.1K 下拉至GND 状态2： 1K 下拉至GND | 2.4 | 2.6 | 0.71 | 0.91 | V
J5-036 | J_AI_ChargeTemp2 | 50mA | AI | 交流充电口温度2 | 电阻型： 状态1： 3.3K 下拉至GND 状态2： 1K 下拉至GND | 提供模拟量 |  | 状态1： 3.3K 下拉至GND 状态2： 1K 下拉至GND | 2.4 | 2.6 | 1.06 | 1.26 | V
J5-037 | J_AI_ChargeDirectTemp2 | 50mA | AI | 直流充电口温度2 | 电阻型： 状态1： 3.3K 下拉至GND 状态2： 1K 下拉至GND | 提供模拟量 |  | 状态1： 3.3K 下拉至GND 状态2： 1K 下拉至GND | 2.4 | 2.6 | 1.06 | 1.26 | V
J5-038 | J_AI_PDUTempSensor1 | 50mA | AI | 预留 | 电阻型： 状态1： 3.3K 下拉至GND 状态2： 1K 下拉至GND | 提供模拟量 |  | 状态1： 3.3K 下拉至GND 状态2： 1K 下拉至GND | 2.4 | 2.6 | 1.06 | 1.26 | V
J5-039 | J_AI_AccPositionSensor1 | 50mA | AI | 加速踏板位置采样1 | 电压型： DUT内部330k下拉 状态1： 3.3V 状态2 :1.8V | 提供模拟量 |  | 状态1： 3.3V 状态2 :1.8V | 3.2 | 3.4 | 1.7 | 1.9 | V
J5-040 | J_HBridge_LChildLockCtr- | 1.8A | 全桥驱动 | 预留 | 60R/50W | 检测输出： 状态1： 低电平 状态2： 高电平 状态3： 低电平 | 0.2 | 状态1： 正转 状态2： 刹车 状态3： 反转 | 0 | 0.5 | 0 | 0.5 | VBAT-0.5 | VBAT+0.5 | V
J5-041 | J_HBridge_Reserve2- | 1.8A | 全桥驱动 | 预留 |  | 检测输出： 状态1： 高电平 状态2： 低电平 状态3： 低电平 |  |  | VBAT-0.5 | VBAT+0.5 | 0 | 0.5 | 0 | 0.5 | V
J5-042 | J_5V_SensorPower1 | 100mA | 5V-OUT | 传感器电源1 | 1K 下拉至GND | 检测输出： 5V有效 |  | 状态1： 输出打开 状态2： 输出关断 | 4.9 | 5.1 | 0 | 0.1 | V
J5-043 | J_DO_HS_HallPower | 500mA | DO-H | 左后电动窗/遮阳帘HALL传感器电 源 | 60R/50W 下拉至GND | 检测输出： 高有效 | 0.2 | 状态1： 输出关断 状态2： 输出打开 | 0 | 0.5 | VBAT-0.5 | VBAT+0.5 | V
J5-044 | J_5V_SensorPower3 | 100mA | 5V-OUT | 预留 | 1K 下拉至GND | 检测输出： 5V有效 |  | 状态1： 输出打开 状态2： 输出关断 | 4.9 | 5.1 | 0 | 0.1 | V
J5-045 | J_DI_RLHandleExtSw | 10mA | DI-L | 预留 | 状态1： GND 状态2： 悬空 | 提供数字量 |  | 状态1： GND 状态2： 悬空 | 0 | 0 | 1 | 1 | 状态值
J5-046 | J_PI_PM2.5DendityFb | 10mA | PWM-IN | 预留 | PWM 低驱 | 提供周期1s的PWM波形 | 0.02 | 状态1： 25% 状态2： 75% | 1 | 1 | 1 | 1 | （频率Hz）
 |  |  |  |  |  |  |  |  | 24 | 26 | 74 | 76 | （占空比%）
 |  |  |  |  |  |  |  |  | VBAT-0.5 | VBAT+0.5 | VBAT-0.5 | VBAT+0.5 | （高电平V）
 |  |  |  |  |  |  |  |  | 0 | 0.5 | 0 | 0.5 | （低电平V）
J5-047 | J_AI_AccPositionSensor2 | 50mA | AI | 加速踏板位置采样2 | 电压型： DUT内部330k下拉 状态1： 3.3V 状态2 :1.8V | 提供模拟量 |  | 状态1： 3.3V 状态2 :1.8V | 3.2 | 3.4 | 1.7 | 1.9 | V
J5-048 | J_AI_RLWindowCtrSw | 10mA | AI | 预留 | 电阻型： 状态1： 1K 下拉至GND 状态2： 499R 下拉至GND | 提供模拟量 |  | 状态1： 1K 下拉至GND 状态2： 499R 下拉至GND | 2.4 | 2.6 | 1.56 | 1.76 | V
J5-049 | J_AI_ChargeDirectTemp1 | 50mA | AI | 直流充电口温度1 | 电阻型： 状态1： 3.3K 下拉至GND 状态2： 1K 下拉至GND | 提供模拟量 |  | 状态1： 3.3K 下拉至GND 状态2： 1K 下拉至GND | 2.4 | 2.6 | 1.06 | 1.26 | V
J5-050 | J_AI_ChargeTemp1 | 50mA | AI | 交流充电口温度1 | 电阻型： 状态1： 3.3K 下拉至GND 状态2： 1K 下拉至GND | 提供模拟量 |  | 状态1： 3.3K 下拉至GND 状态2： 1K 下拉至GND | 2.4 | 2.6 | 1.06 | 1.26 | V
J5-051 | J_AI_BatteryWaterTempSensorB | 50mA | AI | 电池水温传感器信号B | 电阻型： 状态1： 5.1K 下拉至GND 状态2： 1K 下拉至GND | 提供模拟量 |  | 状态1： 5.1K 下拉至GND 状态2： 1K 下拉至GND | 2.4 | 2.6 | 0.71 | 0.91 | V
J5-052 | J_DI_MLTopLightSw_LS | 10mA | DI-L | 预留 | 状态1： GND 状态2： 悬空 | 提供数字量 |  | 状态1： GND 状态2： 悬空 | 0 | 0 | 1 | 1 | 状态值
J3-1 | NC |  | NC
J3-2 | J_LIN_AGS/EBS | 50mA | LIN | AGS/EBS/Mot_Pump/Bat_Pump LIN | LIN卡 LIN1
J3-3 | J_AI_BatteryWaterTempSensorA | 100mA | AI | 电池水温传感器信号A | 电阻型： 状态1： 5.1K 下拉至GND 状态2： 1K 下拉至GND | 提供模拟量 |  | 状态1： 5.1K 下拉至GND 状态2： 1K 下拉至GND | 2.4 | 2.6 | 0.71 | 0.91 | V
J3-4 | J_AI_VacuumPressSensor | 100mA | AI | 预留 | 电压型： DUT内部330k下拉 状态1： 3.3V 状态2 :1.8V | 提供模拟量 |  | 状态1： 3.3V 状态2 :1.8V | 3.2 | 3.4 | 1.7 | 1.9 | V
J3 5 | Sensor GND | 500mA | GND | 传感器地
J3-6 | J_5V_SensorPower2 | 100mA | 5V-OUT | 预留 | 1K 下拉至GND | 检测输出： 5V有效 |  | 状态1： 输出打开 状态2： 输出关断 | 4.9 | 5.1 | 0 | 0.1 | V
J3-7 | J_CCANH | 100mA | CAN | ICAN（FD） | CAN卡 CAN3H
J3-8 | J CCANL | 100mA | CAN |  | CAN卡 CAN3L
J3-9 | J_AI_MotorWaterTempSensorA | 100mA | AI | 电机水温传感器信号A | 电阻型： 状态1： 5.1K 下拉至GND 状态2： 1K 下拉至GND | 提供模拟量 |  | 状态1： 5.1K 下拉至GND 状态2： 1K 下拉至GND | 2.4 | 2.6 | 0.71 | 0.91 | V
J3-10 | J_DO_LS_BatteryPumpRly | 500mA | DO-L | 电池水泵继电器 | 2.74K 上拉至VBAT | 检测输出： 低有效 | 0.004 | 状态1： 输出关断 状态2： 输出打开 | VBAT-0.5 | VBAT+0.5 | 0 | 0.5 | V
J3-11 | J_DO_LS_FanRly | 500mA | DO-L | 电子风扇继电器控制 | 2.74K 上拉至VBAT | 检测输出： 低有效 | 0.004 | 状态1： 输出打开 状态2： 输出关断 | 0 | 0.5 | VBAT-0.5 | VBAT+0.5 | V
J3-12 | J_PO_LS_LCarpetLight | 500mA | PWM-OUT | 左侧迎宾光毯 | 2.74K 上拉至VBAT | 检测输出： 占空比与频率 | 0.004 | 状态1： 25% 状态2： 75% | 99 | 101 | 99 | 101 | （频率）
 |  |  |  |  |  |  |  |  | 24 | 26 | 74 | 76 | （占空比）
 |  |  |  |  |  |  |  |  | VBAT-0.5 | VBAT+0.5 | VBAT-0.5 | VBAT+0.5 | （高电平）
 |  |  |  |  |  |  |  |  | 0 | 0 5 | 0 | 0 5 | （低电平）
J3-13 | J_DO_LS_FEOPRly | 500mA | DO-L | 前油泵继电器 | 2.74K 上拉至VBAT | 检测输出： 低有效 | 0.004 | 状态1： 输出打开 状态2： 输出关断 | 0 | 0.5 | VBAT-0.5 | VBAT+0.5 | V
J3-14 | J_DO_LS_MotorPumpRly | 500mA | DO-L | 电机水泵继电器 | 2.74K 上拉至VBAT | 检测输出： 低有效 | 0.004 | 状态1： 输出关断 状态2： 输出打开 | VBAT-0.5 | VBAT+0.5 | 0 | 0.5 | V
J3-15 | J_PO_LS_FanSpeedCtr | 500mA | PWM-OUT | 电子风扇PWM控制 | 2.74K 上拉至VBAT | 检测输出： 占空比与频率 | 0.004 | 状态1： 25% 状态2： 75% | 99 | 101 | 99 | 101 | （频率）
 |  |  |  |  |  |  |  |  | 24 | 26 | 74 | 76 | （占空比）
 |  |  |  |  |  |  |  |  | VBAT-0.5 | VBAT+0.5 | VBAT-0.5 | VBAT+0.5 | （高电平）
 |  |  |  |  |  |  |  |  | 0 | 0.5 | 0 | 0.5 | （低电平）
J3-16 | J_PO_LS_MotorPumpSpeedCtr | 500mA | PWM-OUT | 预留 | 2.74K 上拉至VBAT | 检测输出： 占空比与频率 | 0.004 | 状态1： 25% 状态2： 75% | 99 | 101 | 99 | 101 | （频率）
 |  |  |  |  |  |  |  |  | 24 | 26 | 74 | 76 | （占空比）
 |  |  |  |  |  |  |  |  | VBAT-0.5 | VBAT+0.5 | VBAT-0.5 | VBAT+0.5 | （高电平）
 |  |  |  |  |  |  |  |  | 0 | 0.5 | 0 | 0.5 | （低电平）
J3-17 | Sensor GND | 500mA | GND | 电驱水温传感器地
J3-18 | NC |  | NC
J3-19 | J_DI_BrakeFluidLevel_LS | 10mA | DI-L | 预留 | 状态1： GND 状态2： 悬空 | 提供数字量 |  | 状态1： GND 状态2： 悬空 | 0 | 0 | 1 | 1 | 状态值
J3-20 | Sensor GND | 500mA | GND | 预留
J3-21 | NC |  | NC
J3-22 | NC |  | NC
J3-23 | Sensor_GND | 500mA | GND | 真空压力传感器地
J3-25 | J_DO_HS_FSRRPower | 2A | DO-H | 左前、右前短距毫米波雷达SRR_FL 、 SRR_FR | 60R/50W 下拉至GND | 检测输出： 高有效 | 0.2 | 状态1： 输出关断 状态2： 输出打开 | 0 | 0.5 | VBAT-0.5 | VBAT+0.5 | V
J3-26 | J_PI_RearAbatVentHALLFb2 | 50mA | PWM-IN | 后遮阳帘HALL传感器信号2 | PWM 低驱 | 提供PWM | 0.02 | 状态1： 75% 状态2： 25% | 99 | 101 | 99 | 101 | （频率）
 |  |  |  |  |  |  |  |  | 74 | 76 | 24 | 26 | （占空比）
J3-27 | J_PI_FanFb | 100mA | PWM-IN | 电子风扇诊断 | PWM 低驱 | 提供PWM | 0.02 | 状态1： 25% 状态2： 75% | 99 | 101 | 99 | 101 | （频率）
 |  |  |  |  |  |  |  |  | 24 | 26 | 74 | 76 | （占空比）
J3-28 | J_PI_RearAbatVentHALLFb 1 | 50mA | PWM-IN | 后遮阳帘HALL传感器信号1 | PWM 低驱 | 提供PWM | 0.02 | 状态1： 75% 状态2： 25% | 99 | 101 | 99 | 101 | （频率）
 |  |  |  |  |  |  |  |  | 74 | 76 | 24 | 26 | （占空比）
J3-29 | Sensor_GND | 500mA | GND | 电池水温传感器地
J3-30 | J_PO_DriveHVILOut | 500mA | PWM-OUT | 驱动回路互锁输出 | 2.74K 下拉至GND | 检测输出： 高有效 | 0.02 | 状态1： 25% 状态2： 75% | 99 | 101 | 99 | 101 | （频率）
 |  |  |  |  |  |  |  |  | 24 | 26 | 74 | 76 | （占空比）
回采 | M_PI_DriveHVILOutFb |  |  |  |  |  |  | 状态1： 25% 状态2： 75% | 99 | 101 | 99 | 101 | （频率）
 |  |  |  |  |  |  |  |  | 24 | 26 | 74 | 76 | （占空比）
J3-31 | J_DI_VacuumPumpRlyFb_HS | 50mA | DI-H | 预留 | 状态1： 悬空 状态2： VBAT | 提供数字量 |  | 状态1： 悬空 状态2： VBAT | 0 | 0 | 1 | 1 | 状态值
J3-32 | J_DO_LS_DeforstrRly | 500mA | DO-L | 后除霜继电器 | 2.74K 上拉至VBAT | 检测输出： 低有效 | 0.004 | 状态1： 输出关断 状态2： 输出打开 | VBAT-0.5 | VBAT+0.5 | 0 | 0.5 | V
J8-01 | J_HBridge_FLHandleCtr+ | 1. 1A/ 12A | 全桥驱动 | 左前门把手电机正 | 10R/100W J8_1与J8_5分别接两端 | 检测输出： 状态1： 高电平 状态2： 低电平 状态3： 低电平 | 1.2 | 状态1： 正转 状态2： 刹车 状态3： 反转 | VBAT-0.5 | VBAT+0.5 | 0 | 0.5 | 0 | 0.5 | V
J8-02 | J_HBridge_FLCWindowCtr- | 12A/31A | 全桥驱动 | 左前车窗控制负 | 6R/50W | 检测输出： 状态1： 低电平 状态2： 高电平 状态3： 低电平 | 2 | 监控纹波电流 | 0 | 0.5 | VBAT-0.5 | VBAT+0.5 | 0 | 0.5 | V
J8-03 | J_HBridge_FLCWindowCtr+ | 12A/31A | 全桥驱动 | 左前车窗控制正 |  | 检测输出： 状态1： 高电平 状态2： 低电平 状态3： 低电平 |  |  | VBAT-0.5 | VBAT+0.5 | 0 | 0.5 | 0 | 0.5 | V
回采 | M_AI_WINDOW_CURRENT1
J8-04 | J_DO_HS_LeftMirrorHeated | 5A | DO-H | 左外后视镜加热 | 60R/50W 下拉至GND | 检测输出： 高有效 | 0.2 | 状态1： 输出打开 状态2： 输出关断 | VBAT-0.5 | VBAT+0.5 | 0 | 0.5 | V
J8-05 | J_HBridge_FLHandleCtr- | 1. 1A/ 12A | 全桥驱动 | 左前门把手电机负 | 10R/100W J8_1与J8_5分别接两端 | 检测输出： 状态1： 低电平 状态2： 高电平 状态3： 低电平 | 1.2 | 0 | 0.5 | 0 | 0.5 | VBAT-0.5 | VBAT+0.5 | V
回采 | M AI FLHandle Current
J8-06 | J_HBridge_FMirrorFoldCtr- | 2A | 全桥驱动 | 左外后视镜折叠电机负 | 60R/50W | 检测输出： 状态1： 低电平 状态2： 高电平 状态3： 低电平 | 0.2 | 状态1： 正转 状态2： 刹车 状态3： 反转 | 0 | 0.5 | 0 | 0.5 | VBAT-0.5 | VBAT+0.5 | V
J8-07 | J_HBridge_FMirrorFoldCtr+ | 2A | 全桥驱动 | 左外后视镜折叠电机正 |  | 检测输出： 状态1： 高电平 状态2： 低电平 状态3： 低电平 |  |  | VBAT-0.5 | VBAT+0.5 | 0 | 0.5 | 0 | 0.5 | V
回采 | M AI FMirrorFold Current
J8-08 | J_DO_HS_IntLgthPower | 500mA | DO-H | 左侧BSD灯节能输出 | 60R/50W 下拉至GND | 检测输出： 高有效 | 0.2 | 状态1： 输出打开 状态2： 输出关断 | VBAT-0.5 | VBAT+0.5 | 0 | 0.5 | V
J8-09 | J_HBridge_FMirrorLRCtr- | 2A | 全桥驱动 | 左外后视镜面左右调节 | 2.74K J8_10与J8-09分别接两端 | 检测输出： 状态1： 上下正转 高电平 状态2： 刹车 低电平 状态3： 上下反转 低电平 状态4： 左右正转 低电平 状态5： 左右反转 高电平 | 0.2 | 建议测试状态流程： 1>2>3>2>4>2>5 状态1： 上下正转 状态2： 上下反转 状态3： 刹车 状态4： 左右正转 状态5： 左右反转 | VBAT-0.5 | VBAT+0.5 | 0 | 0.5 | 0 | 0.5 | 0 | 0.5 | VBAT-0.5 | VBAT+0.5 | V
J8-010 | J_HBridge_FMirrorCtr+ | 2A | 全桥驱动 | 左外后视镜面调节公共端 | 2.74K J8_10与J8_19/J8_12分别接两端 | 检测输出： 状态1： 上下正转 高电平 状态2： 刹车 低电平 状态3： 上下反转 低电平 状态4： 左右正转 高电平 状态5： 左右反转 低电平 |  |  | VBAT-0.5 | VBAT+0.5 | 0 | 0.5 | 0 | 0.5 | VBAT-0.5 | VBAT+0.5 | 0 | 0.5 | V
J8-012 | J_HBridge_FMirrorUDCtr- | 2A | 全桥驱动 | 左外后视镜上下调节 | 2.74K J8_10与J8-012分别接两端 | 检测输出： 状态1： 上下正转 低电平 状态2： 刹车 低电平 状态3： 上下反转 高电平 状态4： 左右正转 高电平 状态5： 左右反转 低电平 | 0.2 |  | 0 | 0.5 | 0 | 0.5 | VBAT-0.5 | VBAT+0.5 | VBAT-0.5 | VBAT+0.5 | 0 | 0.5 | V
J8-011 | J_DO_HS_HallPower | 500mA | DO-H | 主驾电动窗霍尔传感器供电 | 60R/50W 下拉至GND | 检测输出： 高有效 | 0.2 | 状态1： 输出打开 状态2： 输出关断 | VBAT-0.5 | VBAT+0.5 | 0 | 0.5 | V
J9-01 | J_PI_FLWindow_HallFb2 | 10mA | PWM-IN | 主驾玻璃升降电机霍尔反馈2 | PWM 高驱 0-VBAT (三线霍尔） | 提供PWM 0-VBAT | 0.02 | 状态1： 25% 状态2： 75% | 99 | 101 | 99 | 101 | （频率）
 |  |  |  |  |  |  |  |  | 24 | 26 | 74 | 76 | （占空比）
J9-02 | J_DI_FLDoorReleaseSW_LS | 10mA | DI-L | 主驾电释放开关信号 | 状态1： GND 状态2： 悬空 | 提供数字量 |  | 状态1： GND 状态2： 悬空 | 0 | 0 | 1 | 1 | 状态值
J9-03 | J_DI_FLOutHandle_LS | 10mA | DI-L | 左外开门把手开关 | 状态1： 悬空 状态2： GND | 提供数字量 |  | 状态1： 悬空 状态2： GND | 1 | 1 | 0 | 0 | 状态值
J9-04 | J_DI_FLDoorUnlockSW_LS | 10mA | DI-L | 主驾Unlock信号 | 状态1： GND 状态2： 悬空 | 提供数字量 |  | 状态1： GND 状态2： 悬空 | 0 | 0 | 1 | 1 | 状态值
J9-05 | J_DO_HS_ATLPower | 2A | DO-H | ATL供电 | 60R/50W 下拉至GND | 检测输出： 高有效 | 0.2 | 状态1： 输出打开 状态2： 输出关断 | VBAT-0.5 | VBAT+0.5 | 0 | 0.5 | V
J9-06 | J_DO_LS_LBSDLight | 500mA | DO-L | 左侧BSD灯 | 2.74K 上拉至VBAT | 检测输出： 低有效 | 0.004 | 状态1： 输出打开 状态2： 输出关断 | 0 | 0.5 | VBAT-0.5 | VBAT+0.5 | V
J9-07 | J_DO_HS_WinLockLight | 500mA | DO-H | 中控车窗锁止指示灯 | 2.74K 下拉至GND | 检测输出： 高有效 | 0.004 | 状态1： 输出打开 状态2： 输出关断 | VBAT-0.5 | VBAT+0.5 | 0 | 0.5 | V
J9-09 | J_DO_LS_LDOWLight | 500mA | DO-L | 预留 | 2.74K 上拉至VBAT | 检测输出： 低有效 | 0.004 | 状态1： 输出关断 状态2： 输出打开 | VBAT-0.5 | VBAT+0.5 | 0 | 0.5 | V
J9-010 | J_DO_LS_LFDoorHandleLight | 500mA | DO-L | 预留 | 2.74K 上拉至VBAT | 检测输出： 低有效 | 0.004 | 状态1： 输出打开 状态2： 输出关断 | 0 | 0.5 | VBAT-0.5 | VBAT+0.5 | V
J9-011 | J_DO_HS_Backlight | 2A | DO-H | 背主驾电动窗开关背光 | 60R/50W 下拉至GND | 检测输出： 高有效 | 0.2 | 状态1： 输出关断 状态2： 输出打开 | 0 | 0.5 | VBAT-0.5 | VBAT+0.5 | V
J9-012 | Sensor_GND | 500mA | GND | 主驾电动窗霍尔传感器共地
J9-013 | Sensor_GND | 500mA | GND | 左前门把手开关共地
J9-014 | Sensor_GND | 500mA | GND | 左后视镜模拟地
J9-015 | Sensor GND | 500mA | GND
J9-016 | Sensor_GND | 500mA | GND
J9-017 | J_AI_LMirrorTemp | 10mA | AI | 左外后视镜加热温度反馈 | 电阻型： 状态1： 1K 下拉至GND 状态2： 499R 下拉至GND | 提供模拟量 |  | 状态1： 1K 下拉至GND 状态2： 499R 下拉至GND | 1.55 | 1.75 | 1 | 1.2 | V
J9-018 | J_AI_DRLWindowCtrSw | 10mA | AI | 主驾玻璃升降开关_左后 | 电阻型： 状态1： 1K 下拉至GND 状态2： 499R 下拉至GND | 提供模拟量 |  | 状态1： 1K 下拉至GND 状态2： 499R 下拉至GND | 2.4 | 2.6 | 1.56 | 1.76 | V
J9-019 | J_DI_FLDoorGearUnlockSW_LS | 10mA | DI-L | 主驾GearUnlock信号 | 状态1： 悬空 状态2： GND | 提供数字量 |  | 状态1： 悬空 状态2： GND | 1 | 1 | 0 | 0 | 状态值
J9-020 | J_HBridge_FLDoorLockCtr+ | 4.4A | 全桥驱动 | 左前门锁电机正 | 10R/100W | 检测输出： 状态1： 高电平 状态2： 低电平 状态3： 低电平 | 1 2 | 状态1： 正转 状态2： 刹车 状态3： 反转 | VBAT-0.5 | VBAT+0.5 | 0 | 0.5 | VBAT-0.5 | VBAT+0.5 | V
J9-040 | J_HBridge_FLDoorLockCtr- | 4.4A | 全桥驱动 | 左前门锁电机负 |  | 检测输出： 状态1： 低电平 状态2： 高电平 状态3： 低电平 |  |  | 0 | 0.5 | 0 | 0.5 | 0 | 0.5 | V
回采 | M_AI_FLDoorLock_Current
J9-021 | J_PI_FLWindow_HallFb 1 | 10mA | PWM-IN | 主驾玻璃升降电机霍尔反馈1 | PWM 高驱 0-VBAT (三线霍尔） | 提供PWM 0-VBAT | 0.02 | 状态1： 25% 状态2： 75% | 99 | 101 | 99 | 101 | （频率）
 |  |  |  |  |  |  |  |  | 24 | 26 | 74 | 76 | （占空比）
J9-022 | J_DI_FLDoorAjarSW_LS | 10mA | DI-L | 主驾Ajar信号 | 状态1： GND 状态2： 悬空 | 提供数字量 |  | 状态1： GND 状态2： 悬空 | 0 | 0 | 1 | 1 | 状态值
J9-023 | J_5V_SensorPower3 | 100mA | 5V-OUT | 传感器电源3 | 1K 下拉至GND | 检测输出： 5V有效 |  | 状态1： 输出打开 状态2： 输出关断 | 4.9 | 5.1 | 0 | 0.1 | V
回采 | M_AI_5V_SENSOR_POWER3_FB
J9-024 | J_DI_CentralOpenLockSw_LS | 10mA | DI-L | 中控解锁开关 | 状态1： 悬空 状态2： GND | 提供数字量 |  | 状态1： 悬空 状态2： GND | 1 | 1 | 0 | 0 | 状态值
J9-025 | J_DI_CentralCloseLockSw_LS | 10mA | DI-L | 中控闭锁开关 | 状态1： GND 状态2： 悬空 | 提供数字量 |  | 状态1： GND 状态2： 悬空 | 0 | 0 | 1 | 1 | 状态值
J9-026 | J_DI_LFHandleExtSw | 10mA | DI-L | 左前门把手展开开关 | 状态1： 悬空 状态2： GND | 提供数字量 |  | 状态1： 悬空 状态2： GND | 1 | 1 | 0 | 0 | 状态值
J9-027 | J_DI_LFHandleRetSw | 10mA | DI-L | 左前门把手回收开关 | 状态1： GND 状态2： 悬空 | 提供数字量 |  | 状态1： GND 状态2： 悬空 | 0 | 0 | 1 | 1 | 状态值
J9-028 | J_AI_MirrorDirSw | 10mA | AI | 预留 | 电阻型： 默认悬空 状态1： 1.2K 下拉至GND 状态2： 634R 下拉至GND | 提供模拟量 |  | 状态1： 1.2K 下拉至GND 状态2： 634R 下拉至GND | 1.7 | 1.9 | 1.18 | 1.38 | V
J9-029 | J_DI_FLDoorHomeSwitch_LS | 10mA | DI-L | 预留 | 状态1： GND 状态2： 悬空 | 提供数字量 |  | 状态1： GND 状态2： 悬空 | 0 | 0 | 1 | 1 | 状态值
J9-030 | J_AI_MirrorSelectSw | 10mA | AI | 预留 | 电阻型： 状态1： 1K 下拉至GND 状态2： 499R 下拉至GND | 提供模拟量 |  | 状态1： 1K 下拉至GND 状态2： 499R 下拉至GND | 2.4 | 2.6 | 1.56 | 1.76 | V
J9-031 | J_AI_LMirrorLRPositionFb | 10mA | AI | 左外后视镜左右镜面位置采样 | 电压型： DUT内部330k下拉 状态1： 3.3V 状态2 :1.8V | 提供模拟量 |  | 状态1： 3.3V 状态2 : 1.8V | 3.2 | 3.4 | 1.7 | 1.9 | V
J9-032 | J_AI_DRRWindowCtrSw | 10mA | AI | 主驾玻璃升降开关_右后 | 电阻型： 状态1： 1K 下拉至GND 状态2： 499R 下拉至GND | 提供模拟量 |  | 状态1： 1K 下拉至GND 状态2： 499R 下拉至GND | 2.4 | 2.6 | 1.56 | 1.76 | V
J9-033 | J_AI_LMirrorUDPositionFb | 10mA | AI | 左外后视镜上下镜面位置采样 | 电压型： DUT内部330k下拉 状态1： 3.3V 状态2 :1.8V | 提供模拟量 |  | 状态1： 3.3V 状态2 : 1.8V | 3.2 | 3.4 | 1.7 | 1.9 | V
J9-034 | J_AI_DFRWindowCtrSw | 10mA | AI | 主驾玻璃升降开关_右前 | 电阻型： 状态1： 1K 下拉至GND 状态2： 499R 下拉至GND | 提供模拟量 |  | 状态1： 1K 下拉至GND 状态2： 499R 下拉至GND | 2.4 | 2.6 | 1.56 | 1.76 | V
J9-035 | J_AI_DFLWindowCtrSw | 10mA | AI | 主驾玻璃升降开关_左前 | 电阻型： 状态1： 1K 下拉至GND 状态2： 499R 下拉至GND | 提供模拟量 |  | 状态1： 1K 下拉至GND 状态2： 499R 下拉至GND | 2.4 | 2.6 | 1.56 | 1.76 | V
J9-036 | J_DI_WinLockSw_LS | 10mA | DI-L | 中控车窗锁止开关 | 状态1： GND 状态2： 悬空 | 提供数字量 |  | 状态1： GND 状态2： 悬空 | 0 | 0 | 1 | 1 | 状态值
J9-037 | J_DI_FLDoorPawlSW_LS | 10mA | DI-L | 主驾棘爪信号 | 状态1： 悬空 状态2： GND | 提供数字量 |  | 状态1： 悬空 状态2： GND | 1 | 1 | 0 | 0 | 状态值
J9-038 | Sensor_GND | 500mA | GND | 主驾电动窗开关共地
J9-039 | J_DI_FLDoorOpenSw_LS | 10mA | DI-L | 主驾门全开信号 | 状态1： GND 状态2： 悬空 | 提供数字量 |  | 状态1： GND 状态2： 悬空 | 0 | 0 | 1 | 1 | 状态值
J6-01 | J_PO_HS_SteeringWheelHeatedCtr | 10A | DO-H | 方向盘加热 | 10R/100W 下拉至GND | 检测输出： 高有效 | 1.2 | 状态1： 10% 状态2： 100% | 9 | 11 | 99 | 101 | （频率）
 |  |  |  |  |  |  |  |  | 24 | 26 | 74 | 76 | （占空比）
 |  |  |  |  |  |  |  |  | VBAT-0.5 | VBAT+0.5 | VBAT-0.5 | VBAT+0.5 | （高电平）
 |  |  |  |  |  |  |  |  | 0 | 0.5 | 0 | 0.5 | （低电平）
回采 | M_AI_SteeringWheelHeated_CurrentFb
J6-02 | J_Hbridge_ESCCUUpDown+ | 10A | 全桥驱动 | 管柱上下调节电机正 | 10R/100W J6-02与J6-04分别接两端 | 检测输出： 状态1： 上下正转 高电平 状态2： 刹车 低电平 状态3： 上下反转 低电平 状态4： 前后正转 低电平 状态5： 前后反转 高电平 | 1.2 | 建议测试状态流程： 1>2>3>2>4>2>5 状态1： 上下正转 状态2： 上下反转 状态3： 刹车 状态4： 前后正转 状态5： 前后反转 | VBAT-0.5 | VBAT+0.5 | 0 | 0.5 | 0 | 0.5 | 0 | 0.5 | VBAT-0.5 | VBAT+0.5 | V
J6-04 | J_Hbridge_ESCCUCom+ | 16A | PWM全桥驱动 | 管柱调节电机公共端 |  | 检测输出： 状态1： 上下正转 高电平 状态2： 刹车 低电平 状态3： 上下反转 低电平 状态4： 前后正转 高电平 状态5： 前后反转 低电平 |  |  | 0 | 0.5 | 0 | 0.5 | VBAT-0.5 | VBAT+0.5 | 0 | 0.5 | VBAT-0.5 | VBAT+0.5 | V
J4-03 | J_Hbridge_ESCCUForwardBackward+ | 10A | 全桥驱动 | 管柱前后调节电机正 | 10R/100W J4-03与J6-04分别接两端 | 检测输出： 状态1： 上下正转 低电平 状态2： 刹车 低电平 状态3： 上下反转 高电平 状态4： 前后正转 高电平 状态5： 前后反转 低电平 | 1.2 |  | 0 | 0.5 | 0 | 0.5 | VBAT-0.5 | VBAT+0.5 | VBAT-0.5 | VBAT+0.5 | 0 | 0.5 | V
回采 | M AI ESCCU CSO2
J6-03 | J_SteeringWheelHeatedReturn | 20A | 全桥驱动 | 方向盘加热return | 10R/100W 下拉至GND | 检测输出： 高有效 | 1.2 | 状态1： 输出打开 状态2： 输出关断 | VBAT-0.5 | VBAT+0.5 | 0 | 0.5 | V
J6-05 | J_PO_LS_LFootLight | 500mA | DO-L | 预留 | 2.74K 上拉至VBAT | 检测输出： 占空比与频率 | 0.004 | 状态1： 25% 状态2： 75% | 99 | 101 | 99 | 101 | （频率）
 |  |  |  |  |  |  |  |  | 24 | 26 | 74 | 76 | （占空比）
 |  |  |  |  |  |  |  |  | VBAT-0 5 | VBAT+0 5 | VBAT-0 5 | VBAT+0 5 | （高电平）
 |  |  |  |  |  |  |  |  | 0 | 0.5 | 0 | 0.5 | （低电平）
J6-06 | Sensor_GND | 500mA | GND | 管柱霍尔传感器GND
J6-07 | NC |  | NC
J6-08 | Sensor_GND | 500mA | GND
J6-09 | J_PI_ESCCUpDown_HallFb | 100mA | PWM-IN | 管柱上下调节HALL传感器信号 | PWM 高驱 上拉电阻为392R | 提供PWM 0-VBAT | 0.02 | 状态1： 25% 状态2： 75% | 99 | 101 | 99 | 101 | （频率）
 |  |  |  |  |  |  |  |  | 24 | 26 | 74 | 76 | （占空比）
J6-010 | J_PI_ESCCUForwardBackward_HallFb | 100mA | PWM-IN | 管柱前后调节HALL传感器信号 | PWM 高驱 上拉电阻为392R | 提供PWM 0-VBAT | 0.02 | 状态1： 75% 状态2： 25% | 99 | 101 | 99 | 101 | （频率）
 |  |  |  |  |  |  |  |  | 74 | 76 | 24 | 26 | （占空比）
J6-011 | J_5V_SensorPower1 | 100mA | 5V-OUT | 预留 | 1K 下拉至GND | 检测输出： 5V有效 |  | 状态1： 输出打开 状态2： 输出关断 | 4.9 | 5.1 | 0 | 0.1 | V
回采 | M_AI_5V_SENSOR_POWER1_FB
J6-012 | J_AI_GearShift_N2 | 10mA | AI | 预留 | 电阻型： 状态1： 2.74K 下拉至GND 状态2： 1K 下拉至GND | 提供模拟量 |  | 状态1： 2.74K 下拉至GND 状态2： 1K 下拉至GND | 2.4 | 2.6 | 1.25 | 1.45 | V
J7-01 | J_DO_HS_HallPower | 500mA | DO-H | 管柱HALL传感器电源 | 60R/50W 下拉至GND | 检测输出： 高有效 | 0.2 | 状态1： 输出打开 状态2： 输出关断 | VBAT-0.5 | VBAT+0.5 | 0 | 0.5 | V
J7-02 | J_DO_HS_IntLgthPower | 500mA | DO-H | 节能输出 | 60R/50W 下拉至GND | 检测输出： 高有效 | 0.2 | 状态1： 输出关断 状态2： 输出打开 | 0 | 0.5 | VBAT-0.5 | VBAT+0.5 | V
J7-03 | Sensor_GND | 500mA | GND | 车内温度传感器地
J7-06 | J_AI_GearShift_R2 | 10mA | AI | 预留 | 电阻型： 状态1： 2.74K 下拉至GND 状态2： 1K 下拉至GND | 提供模拟量 |  | 状态1： 2.74K 下拉至GND 状态2： 1K 下拉至GND | 2.4 | 2.6 | 1.25 | 1.45 | V
J7-07 | J_AI_GearShift_R1 | 10mA | AI | 预留 | 电阻型： 状态1： 2.74K 下拉至GND 状态2： 1K 下拉至GND | 提供模拟量 |  | 状态1： 2.74K 下拉至GND 状态2： 1K 下拉至GND | 2.4 | 2.6 | 1.25 | 1.45 | V
J7-08 | J_AI_GearShift_N1 | 10mA | AI | 预留 | 电阻型： 状态1： 2.74K 下拉至GND 状态2： 1K 下拉至GND | 提供模拟量 |  | 状态1： 2.74K 下拉至GND 状态2： 1K 下拉至GND | 2.4 | 2.6 | 1.25 | 1.45 | V
J7-09 | J_AI_GearShift_P1 | 10mA | AI | 预留 | 电阻型： 状态1： 1K 下拉至GND 状态2： 499R 下拉至GND | 提供模拟量 |  | 状态1： 1K 下拉至GND 状态2： 499R 下拉至GND | 2.4 | 2.6 | 1.56 | 1.76 | V
J7-010 | J_AI_GearShift_D2 | 10mA | AI | 预留
J7-011 | J_DO_HS_SWSPower | 3A | DO-H | SWS/MFS/左智能表面供电 | 60R/50W 下拉至GND | 检测输出： 高有效 | 0.2 | 状态1： 输出打开 状态2： 输出关断 | VBAT-0.5 | VBAT+0.5 | 0 | 0.5 | V
J7-012 | J_DO_HS_Backlight | 1A | DO-H | 预留 | 60R/50W 下拉至GND | 检测输出： 高有效 | 0.2 | 状态1： 输出关断 状态2： 输出打开 | 0 | 0.5 | VBAT-0.5 | VBAT+0.5 | V
J7-013 | J_DO_HS_ATLPower | 2A | DO-H | ATL供电 | 60R/50W 下拉至GND | 检测输出： 高有效 | 0.2 | 状态1： 输出打开 状态2： 输出关断 | VBAT-0.5 | VBAT+0.5 | 0 | 0.5 | V
J7-014 | J_AI_SteeringWheelTemp | 10mA | AI | 方向盘温度传感器 | 电阻型： 状态1： 2.74K 下拉至GND 状态2： 1K 下拉至GND | 提供模拟量 |  | 状态1： 2.74K 下拉至GND 状态2： 1K 下拉至GND | 2.4 | 2.6 | 1.25 | 1.45 | V
J7-015 | J_AI_InCarTempSensor | 10mA | AI | 预留 | 电阻型： 状态1： 2.74K 下拉至GND 状态2： 1K 下拉至GND | 提供模拟量 |  | 状态1： 2.74K 下拉至GND 状态2： 1K 下拉至GND | 2.4 | 2.6 | 1.25 | 1.45 | V
J7-016 | J_AI_AtmosphericPressSensor | 10mA | AI | 预留 | 电压型： DUT内部330k下拉 状态1： 3.3V 状态2 :1.8V | 提供模拟量 |  | 状态1： 3.3V 状态2 : 1.8V | 3.2 | 3.4 | 1.7 | 1.9 | V
J7-017 | J_AI_GearShift_P2 | 10mA | AI | 预留 | 电阻型： 状态1： 1K 下拉至GND 状态2： 499R 下拉至GND | 提供模拟量 |  | 状态1： 1K 下拉至GND 状态2： 499R 下拉至GND | 2.4 | 2.6 | 1.56 | 1.76 | V
J7-018 | Sensor_GND | 500mA | GND | 方向盘加热温度传感器地
J7-019 | Sensor_GND | 500mA | GND | 档位传感器地
J7-020 | J_AI_GearShift_D1 | 10mA | AI | 预留 | 电阻型： 状态1： 2.74K 下拉至GND 状态2： 1K 下拉至GND | 提供模拟量 |  | 状态1： 2.74K 下拉至GND 状态2： 1K 下拉至GND | 2.4 | 2.6 | 1.25 | 1.45 | V
回采 | M AI BAT VBATPullUp FB
回采 | M_AI_FS6522_MUXOUT
回采 | M AI BAT

Sheet: DI
PIN | Function | singal type | remark | Load | StartBit | Unload | Loading | State1_info | relay | LoadboxCMD_State1 | State2_info | relay | LoadboxCMD_State2 | StepEnable | ParallelTest
 |  |  |  |  |  |  |  |  | State1 UnLoad |  |  | State2 Load
J1-018 | J_DI_QuickChargeWake_HS | DI-H | 预留 | 状态1： 悬空 状态2： VBAT | 47 | 0 | 1 | NC | N/C | 5MSET0000000000000000$ | To VAT | B2,K4 | 5MSET0001000000000000$ | 1 | 0
J1-029 | J_DI_DCULifeBeat_Wake | DI-L | 右域唤醒/心跳采样 | 状态2： 悬空 状态1： GND | 17 | 1 | 0 | NC | N/C | DREST$ | To GND | B10,J3A,PIN1 | D1CH01$ | 1 | 0
J1-030 | J_DI_SRSCrash | DI-L | 碰撞信号采集 | 状态1： 悬空 状态2： GND | 14 | 1 | 0 | NC | N/C | 8MSET0000000000000000$ | To GND | B5,K1 | 8MSET1000000000000000$ | 1 | 0
J1-044 | J_DI_TrunkOpenSw_LS | DI-L | 尾门开启开关 | 状态1： 悬空 状态2： GND | 41 | 1 | 0 | NC | N/C | DREST$ | To GND | B10,J3A,PIN2 | D1CH02$ | 1 | 0
J1-045 | J_DI_RLDoorReleaseSW_LS | DI-L | 预留 | 状态1： 悬空 状态2： GND | 40 | 1 | 0 | NC | N/C | 8MSET0000000000000000$ | To GND | B5,K2 | 8MSET0100000000000000$ | 1 | 0
J1-046 | J_DI_EmergencyAlarmSw_LS | DI-L | 紧急报警开关信号采集 | 状态1： 悬空 状态2： GND | 34 | 1 | 0 | NC | N/C | DREST$ | To GND | B10,J3A,PIN3 | D1CH03$ | 1 | 0
J1-047 | J_DI_BrakeSw2_HS | DI-H | 制动开关信号2 | 状态1： 悬空 状态2： VBAT | 33 | 0 | 1 | NC | N/C | 5MSET0000000000000000$ | To VAT | B2,K5 | 5MSET0000100000000000$ | 1 | 0
J1-05 | J_DI_SlowChargeWake_HS | DI-H | 预留 | 状态1： 悬空 状态2： VBAT | 48 | 1 | 0 | NC | N/C | 5MSET0000000000000000$ | To VAT | B2,K3 | 5MSET0010000000000000$ | 1 | 0
J1-06 | J_DI_BrakeSw 1_HS | DI-H | 制动开关信号1 | 状态1： 悬空 状态2： VBAT | 32 | 0 | 1 | NC | N/C | 5MSET0000000000000000$ | To VAT | B2,K1 | 5MSET1000000000000000$ | 0 | 0
J2-01 | J_DI_KL15_BackUp_HS | DI-H | 左域KL15电控制冗余采样 | 状态1： 悬空 状态2： VBAT | 24 | 0 | 1 | NC | N/C | 5MSET0000000000000000$ | To VAT | B2,K2 | 5MSET0100000000000000$ | 0 | 0
J2-018 | J_DI_RLTopLightSw_LS | DI-L | 左后顶灯开关 | 状态1： 悬空 状态2： GND | 38 | 1 | 0 | NC | N/C | BMSET0000000000000000$ | To GND | B8,K1 | BMSET1000000000000000$ | 1 | 0
J2-019 | J_DI_AeriaReadLampSW_LS | DI-L | 预留 | 状态1： 悬空 状态2： GND | 15 | 1 | 0 | NC | N/C | BMSET0000000000000000$ | To GND | B8,K2 | BMSET0100000000000000$ | 1 | 0
J2-021 | J_DI_BrakeFluidLevel_LS | DI-L | 预留 | 状态1： 悬空 状态2： GND | 23 | 1 | 0 | NC | N/C | BMSET0000000000000000$ | To GND | B8,K2 | BMSET0100000000000000$ | 1 | 0
J2-022 | J_DI_ThirdRowBeltMid_LS | DI-L | 三排中间安全带未系检测 | 状态1： 悬空 状态2： GND | 42 | 1 | 0 | NC | N/C | BMSET0000000000000000$ | To GND | B8,K3 | BMSET0010000000000000$ | 1 | 0
J2-023 | J_DI_RLVoiceSw_LS | DI-L | 预留 | 状态1： 悬空 状态2： GND | 36 | 1 | 0 | NC | N/C | BMSET0000000000000000$ | To GND | B8,K3 | BMSET0010000000000000$ | 1 | 0
J2-030 | J_DI_RLDoorAjarSW_LS | DI-L | 左侧滑门锁状态 | 状态1： 悬空 状态2： GND | 43 | 1 | 0 | NC | N/C | DREST$ | To GND | B10,J3A,PIN4 | D1CH04$ | 1 | 0
J2-031 | J_DI_RLOutHandleSW_LS | DI-L | 预留 | 状态1： 悬空 状态2： GND | 44 | 1 | 0 | NC | N/C | BMSET0000000000000000$ | To GND | B8,K4 | BMSET0001000000000000$ | 1 | 0
J2-032 | J_DI_RLDoorGearHomeSW_LS | DI-L | 三排左侧安全带未系检测 | 状态1： 悬空 状态2： GND | 35 | 1 | 0 | NC | N/C | BMSET0000000000000000$ | To GND | B8,K5 | BMSET0000100000000000$ | 1 | 0
J2-043 | J_DI_RLDoorPawlSW_LS | DI-L | 预留 | 状态1： 悬空 状态2： GND | 46 | 1 | 0 | NC | N/C | BMSET0000000000000000$ | To GND | B8,K5 | BMSET0000100000000000$ | 1 | 0
J2-07 | J_DI_FLTopLightSw_LS | DI-L | 左前顶灯开关 | 状态1： 悬空 状态2： GND | 37 | 1 | 0 | NC | N/C | BMSET0000000000000000$ | To GND | B8,K1 | BMSET1000000000000000$ | 1 | 0
J3-19 | J_DI_BrakeFluidLevel_LS | DI-L | 预留 | 状态1： 悬空 状态2： GND | 23 | 1 | 0 | NC | N/C | 8MSET0000000000000000$ | To GND | B5,K3 | 8MSET0010000000000000$ | 1 | 0
J3-31 | J_DI_VacuumPumpRlyFb_HS | DI-H | 预留 | 状态1： 悬空 状态2： VBAT | 20 | 0 | 1 | NC | N/C | 5MSET0000000000000000$ | To VAT | B2,K6 | 5MSET0000010000000000$ | 1 | 0
J5-020 | J_DI_FRTopLightSw_LS | DI-L | 右前顶灯开关 | 状态1： 悬空 状态2： GND | 39 | 1 | 0 | NC | N/C | BMSET0000000000000000$ | To GND | B8,K6 | BMSET0000010000000000$ | 1 | 0
J5-021 | J_DI_RLChildLockOrDoorOpen_LS | DI-L | 预留 | 状态1： 悬空 状态2： GND | 45 | 1 | 0 | NC | N/C | BMSET0000000000000000$ | To GND | B8,K7 | BMSET0000001000000000$ | 1 | 0
J5-031 | J_DI_RSHCPosSW_LS | DI-L | 预留 | 状态1： 悬空 状态2： GND | 13 | 1 | 0 | NC | N/C | BMSET0000000000000000$ | To GND | B8,K7 | BMSET0000001000000000$ | 1 | 0
J5-032 | J_DI_TLTopLightSw_LS | DI-L | 三排左顶灯开关 | 状态1： 悬空 状态2： GND | 22 | 1 | 0 | NC | N/C | BMSET0000000000000000$ | To GND | B8,K8 | BMSET0000000100000000$ | 1 | 0
J5-045 | J_DI_RLHandleExtSw | DI-L | 预留 | 状态1： 悬空 状态2： GND | 12 | 1 | 0 | NC | N/C | BMSET0000000000000000$ | To GND | B8,K8 | BMSET0000000100000000$ | 1 | 0
J5-052 | J_DI_MLTopLightSw_LS | DI-L | 预留 | 状态1： 悬空 状态2： GND | 16 | 1 | 0 | NC | N/C | BMSET0000000000000000$ | To GND | B8,K9 | BMSET0000000010000000$ | 1 | 0
J9-019 | J_DI_FLDoorGearUnlockSW_LS | DI-L | 主驾GearUnlock信号 | 状态1： 悬空 状态2： GND | 31 | 1 | 0 | NC | N/C | BMSET0000000000000000$ | To GND | B8,K12 | BMSET0000000000010000$ | 1 | 0
J9-02 | J_DI_FLDoorReleaseSW_LS | DI-L | 主驾电释放开关信号 | 状态1： 悬空 状态2： GND | 29 | 1 | 0 | NC | N/C | DREST$ | To GND | B10,J3A,PIN7 | D1CH07$ | 1 | 0
J9-022 | J_DI_FLDoorAjarSW_LS | DI-L | 主驾Ajar信号 | 状态1： 悬空 状态2： GND | 27 | 1 | 0 | NC | N/C | DREST$ | To GND | B10,J3A,PIN10 | D1CH10$ | 1 | 0
J9-024 | J_DI_CentralOpenLockSw_LS | DI-L | 中控解锁开关 | 状态1： 悬空 状态2： GND | 25 | 1 | 0 | NC | N/C | DREST$ | To GND | B10,J3A,PIN11 | D1CH11$ | 1 | 0
J9-025 | J_DI_CentralCloseLockSw_LS | DI-L | 中控闭锁开关 | 状态1： 悬空 状态2： GND | 26 | 1 | 0 | NC | N/C | DREST$ | To GND | B10,J3A,PIN12 | D1CH12$ | 1 | 0
J9-026 | J_DI_LFHandleExtSw | DI-L | 左前门把手展开开关 | 状态1： 悬空 状态2： GND | 18 | 1 | 0 | NC | N/C | BMSET0000000000000000$ | To GND | B8,K14 | BMSET0000000000000100$ | 1 | 0
J9-027 | J_DI_LFHandleRetSw | DI-L | 左前门把手回收开关 | 状态1： 悬空 状态2： GND | 19 | 1 | 0 | NC | N/C | BMSET0000000000000000$ | To GND | B8,K14 | BMSET0000000000000100$ | 1 | 0
J9-029 | J_DI_FLDoorHomeSwitch_LS | DI-L | 预留 | 状态1： 悬空 状态2： GND | 21 | 1 | 0 | NC | N/C | BMSET0000000000000000$ | To GND | B8,K15 | BMSET0000000000000010$ | 1 | 0
J9-03 | J_DI_FLOutHandle_LS | DI-L | 左外开门把手开关 | 状态1： 悬空 状态2： GND | 50 | 1 | 0 | NC | N/C | DREST$ | To GND | B10,J3A,PIN8 | D1CH08$ | 1 | 0
J9-036 | J_DI_WinLockSw_LS | DI-L | 中控车窗锁止开关 | 状态1： 悬空 状态2： GND | 30 | 1 | 0 | NC | N/C | BMSET0000000000000000$ | To GND | B8,K15 | BMSET0000000000000010$ | 1 | 0
J9-037 | J_DI_FLDoorPawlSW_LS | DI-L | 主驾棘爪信号 | 状态1： 悬空 状态2： GND | 51 | 1 | 0 | NC | N/C | BMSET0000000000000000$ | To GND | B8,K16 | BMSET0000000000000001$ | 1 | 0
J9-039 | J_DI_FLDoorOpenSw_LS | DI-L | 主驾门全开信号 | 状态1： 悬空 状态2： GND | 49 | 1 | 0 | NC | N/C | BMSET0000000000000000$ | To GND | B8,K16 | BMSET0000000000000001$ | 1 | 0
J9-04 | J_DI_FLDoorUnlockSW_LS | DI-L | 主驾Unlock信号 | 状态1： 悬空 状态2： GND | 28 | 1 | 0 | NC | N/C | DREST$ | To GND | B10,J3A,PIN9 | D1CH09$ | 1 | 0

Sheet: AI
PIN | Function | Singal Type | remark | Loadinfo | StartBit | DUT_CMD | LoadboxCMD_0 | state1_info | relay | LoadboxCMD_1 | State1_LSL | State1_USL | state2_info | relay | LoadBoxCMD_2 | State2_LSL | Sate2_USL | StepEnable | ParallelTest
J7-014 | J_AI_SteeringWheelTemp | AI | 方向盘温度传感器 | Type=电阻型 状态1:2.74K 下拉至GND 状态2:1K 下拉至GND | 368 | 04 31 03 C0 84 CC CC CC | 4MSET0000000000000000$ | 2.74K To GND | B1,K8 | 4MSET0000000100000000$ | 2.4 | 2.6 | 1K to GND | B1,K16 | 4MSET0000000000000001$ | 1.25 | 1.45 | 1 | 0
J7-08 | J_AI_GearShift_N1 | AI | 预留 | Type=电阻型 状态1:2.74K 下拉至GND 状态2:1K 下拉至GND | 544 | 04 31 03 C0 84 CC CC CC | 4MSET0000000000000000$ | 2.74K To GND | B1,K7 | 4MSET0000001000000000$ | 2.4 | 2.6 | 1K to GND | B1,K15 | 4MSET0000000000000010$ | 1.25 | 1.45 | 1 | 0
J7-09 | J_AI_GearShift_P1 | AI | 预留 | Type=电阻型 状态1:1K 下拉至GND 状态2:499R 下拉至GND | 512 | 04 31 03 C0 84 CC CC CC | 4MSET0000000000000000$ | 1K to GND | B1,K7 | 4MSET0000001000000000$ | 2.4 | 2.6 | 499R to GND | B1,K15 | 4MSET0000000000000010$ | 1.56 | 1.76 | 1 | 0
J2-049 | J_AI_SRLAbatVentSw | AI | 预留 | Type=电阻型 默认悬空 状态1:1.2K 下拉至GND 状态2:634R 下拉至GND | 784 | 04 31 03 C0 84 CC CC CC | 4MSET0000000000000000$ | 1.2K to GND | B1,K6 | 4MSET0000010000000000$ | 1.96 | 2.16 | 634R to GND | B1,K14 | 4MSET0000000000000100$ | 1.53 | 1.73 | 1 | 0 | 已经改规格
J7-07 | J_AI_GearShift_R1 | AI | 预留 | Type=电阻型 状态1:2.74K 下拉至GND 状态2:1K 下拉至GND | 576 | 04 31 03 C0 84 CC CC CC | 4MSET0000000000000000$ | 2.74K To GND | B1,K6 | 4MSET0000010000000000$ | 2.4 | 2.6 | 1K to GND | B1,K14 | 4MSET0000000000000100$ | 1.25 | 1.45 | 1 | 0
J2-047 | J_AI_ASCtrSw | AI | 悬架升降开关信号 | Type=电阻型 默认悬空 状态1:1.2K 下拉至GND 状态2:634R 下拉至GND | 816 | 04 31 03 C0 84 CC CC CC | DREST$ | 1.2K to GND | B10,J3A,PIN5 | D1CH05$ | 1.96 | 2.16 | 634R to GND | B10,J3A,PIN6 | D1CH06$ | 1.53 | 1.73 | 1 | 0 | 已经改规格
J2-048 | J_AI_DrvSeatAdjSwFrntHei | AI | 预留 | Type=电阻型 默认悬空 状态1:1.2K 下拉至GND 状态2:634R 下拉至GND | 800 | 04 31 03 C0 84 CC CC CC | 4MSET0000000000000000$ | 1.2K to GND | B1,K5 | 4MSET0000100000000000$ | 1.96 | 2.16 | 634R to GND | B1,K13 | 4MSET0000000000001000$ | 1.53 | 1.73 | 1 | 0 | 已经改规格
J2-036 | J_AI_AbatVentOpenSw_LS | AI | 预留 | Type=电阻型 默认悬空 状态1:1.2K 下拉至GND 状态2:634R 下拉至GND | 352 | 04 31 03 C0 84 CC CC CC | 4MSET0000000000000000$ | 1.2K to GND | B1,K4 | 4MSET0001000000000000$ | 1.96 | 2.16 | 634R to GND | B1,K12 | 4MSET0000000000010000$ | 1.53 | 1.73 | 1 | 0 | 已经改规格
J2-046 | J_AI_DrvSeatAdjSwHei | AI | 预留 | Type=电阻型 默认悬空 状态1:1.2K 下拉至GND 状态2:634R 下拉至GND | 320 | 04 31 03 C0 84 CC CC CC | 4MSET0000000000000000$ | 1.2K to GND | B1,K4 | 4MSET0001000000000000$ | 1.96 | 2.16 | 634R to GND | B1,K12 | 4MSET0000000000010000$ | 1.53 | 1.73 | 1 | 0 | 已经改规格
J2-033 | J_AI_DrvSeatAdjSwBackInc | AI | 预留 | Type=电阻型 默认悬空 状态1:1.2K 下拉至GND 状态2:634R 下拉至GND | 336 | 04 31 03 C0 84 CC CC CC | 4MSET0000000000000000$ | 1.2K to GND | B1,K2 | 4MSET0100000000000000$ | 1.96 | 2.16 | 634R to GND | B1,K11 | 4MSET0000000000100000$ | 1.53 | 1.73 | 1 | 0 | 已经改规格
J2-035 | J_AI_DrvSeatAdjSwSld | AI | 预留 | Type=电阻型 默认悬空 状态1:1.2K 下拉至GND 状态2:634R 下拉至GND | 304 | 04 31 03 C0 84 CC CC CC | 4MSET0000000000000000$ | 1.2K to GND | B1,K3 | 4MSET0010000000000000$ | 1.96 | 2.16 | 634R to GND | B1,K11 | 4MSET0000000000100000$ | 1.53 | 1.73 | 1 | 0 | 已经改规格
J2-020 | J_AI_ThirdRowLtSBRSt | AI | 三排左侧SBR检测 | Type=电阻型 状态1:1K 下拉至GND 状态2:499R 下拉至GND | 416 | 04 31 03 C0 84 CC CC CC | 4MSET0000000000000000$ | 1K to GND | B1,K2 | 4MSET0100000000000000$ | 2.4 | 2.6 | 499R to GND | B1,K9 | 4MSET0000000010000000$ | 1.56 | 1.76 | 1 | 0 | 已经改规格
J2-024 | J_AI_DrvSeatTemp | AI | 预留 | Type=电阻型状态1:5.1K 下拉至GND状态2:1K 下拉至GND | 1056 | 04 31 03 C0 84 CC CC CC | 4MSET0000000000000000$ | 5.1K To GND | B1,K3 | 4MSET0010000000000000$ | 2.4 | 2.6 | 1K to GND | B1,K10 | 4MSET0000000001000000$ | 0.71 | 0.92 | 1 | 0
J2-011 | J_AI_SeatRowSecLtSBRSt | AI | 预留 | Type=电阻型 状态1:1K 下拉至GND状态2:499R 下拉至GND | 432 | 04 31 03 C0 84 CC CC CC | 4MSET0000000000000000$ | 1K to GND | B1,K1 | 4MSET1000000000000000$ | 1.55 | 1.75 | 499R to GND | B1,K9 | 4MSET0000000001000000$ | 1 | 1.2 | 1 | 0
J2-08 | J_AI_EmergencyPowerOff | AI | 紧急下电开关 | Type=电阻型状态1:2.74K 下拉至GND状态2:1K 下拉至GND | 480 | 04 31 03 C0 84 CC CC CC | 4MSET0000000000000000$ | 2.74K To GND | B1,K1 | 4MSET1000000000000000$ | 1.55 | 1.75 | 1K to GND | B1,K9 | 4MSET0000000010000000$ | 0.78 | 0.98 | 1 | 0
J6-012 | J_AI_GearShift_N2 | AI | 预留 | Type=电阻型状态1:2.74K 下拉至GND状态2:1K 下拉至GND | 560 | 04 31 03 C0 84 CC CC CC | 6MSET0000000000000000$ | 2.74K To GND | B3.K14 | 6MSET0000000000000100$ | 2.4 | 2.6 | 1K to GND | B4.K14 | 7MSET0000000000000100$ | 1.25 | 1.45 | 1 | 0
J9-034 | J_AI_DFRWindowCtrSw | AI | 主驾玻璃升降开关_右前 | Type=电阻型状态1:1K 下拉至GND状态2:499R 下拉至GND | 768 | 04 31 03 C0 84 CC CC CC | 6MSET0000000000000000$ | 1K to GND | B3.K13 | 6MSET0000000000001000$ | 2.4 | 2.6 | 499R to GND | B4.K13 | 7MSET0000000000001000$ | 1.56 | 1.76 | 1 | 0
J9-035 | J_AI_DFLWindowCtrSw | AI | 主驾玻璃升降开关_左前 | Type=电阻型状态1:1K 下拉至GND状态2:499R 下拉至GND | 720 | 04 31 03 C0 84 CC CC CC | 6MSET0000000000000000$ | 1K to GND | B3.K13 | 6MSET0000000000001000$ | 2.4 | 2.6 | 499R to GND | B4.K13 | 7MSET0000000000001000$ | 1.56 | 1.76 | 1 | 0
J9-030 | J_AI_MirrorSelectSw | AI | 预留 | Type=电阻型 状态1:1K 下拉至GND 状态2:499R 下拉至GND | 656 | 04 31 03 C0 84 CC CC CC | 6MSET0000000000000000$ | 1K to GND | B3.K12 | 6MSET0000000000010000$ | 1.55 | 1.75 | 499R to GND | B4.K12 | 7MSET0000000000010000$ | 1 | 1.2 | 1 | 0
J9-032 | J_AI_DRRWindowCtrSw | AI | 主驾玻璃升降开关_右后 | Type=电阻型 状态1:1K 下拉至GND 状态2:499R 下拉至GND | 752 | 04 31 03 C0 84 CC CC CC | 6MSET0000000000000000$ | 1K to GND | B3.K12 | 6MSET0000000000010000$ | 2.4 | 2.6 | 499R to GND | B4.K12 | 7MSET0000000000010000$ | 1.56 | 1.76 | 1 | 0
J9-018 | J_AI_DRLWindowCtrSw | AI | 主驾玻璃升降开关_左后 | Type=电阻型 状态1:1K 下拉至GND 状态2:499R 下拉至GND | 736 | 04 31 03 C0 84 CC CC CC | 6MSET0000000000000000$ | 1K to GND | B3.K11 | 6MSET0000000000100000$ | 2.4 | 2.6 | 499R to GND | B4.K11 | 7MSET0000000000100000$ | 1.56 | 1.76 | 1 | 0
J9-028 | J_AI_MirrorDirSw | AI | 预留 | Type=电阻型 默认悬空 状态1:1.2K 下拉至GND 状态2:634R 下拉至GND | 704 | 04 31 03 C0 84 CC CC CC | 6MSET0000000000000000$ | 1.2K to GND | B3.K11 | 6MSET0000000000100000$ | 1.7 | 1.9 | 634R to GND | B4.K11 | 7MSET0000000000100000$ | 1.18 | 1.38 | 1 | 0
J3-9 | J_AI_MotorWaterTempSensorA | AI | 电机水温传感器信号A | Type=电阻型 状态1:5.1K 下拉至GND 状态2:1K 下拉至GND | 400 | 04 31 03 C0 84 CC CC CC | 6MSET0000000000000000$ | 5.1K To GND | B3.K10 | 6MSET0000000001000000$ | 2.4 | 2.6 | 1K to GND | B4.K10 | 7MSET0000000001000000$ | 0.71 | 0.91 | 1 | 0
J9-017 | J_AI_LMirrorTemp | AI | 左外后视镜加热温度反馈 | Type=电阻型 状态1:1K 下拉至GND 状态2:499R 下拉至GND | 1136 | 04 31 03 C0 84 CC CC CC | 6MSET0000000000000000$ | 1K to GND | B3.K10 | 6MSET0000000001000000$ | 1.55 | 1.75 | 499R to GND | B4.K10 | 7MSET0000000001000000$ | 1 | 1.2 | 1 | 0
J3-3 | J_AI_BatteryWaterTempSensorA | AI | 电池水温传感器信号A | Type=电阻型 状态1:5.1K 下拉至GND 状态2:1K 下拉至GND | 448 | 04 31 03 C0 84 CC CC CC | 6MSET0000000000000000$ | 5.1K To GND | B3.K9 | 6MSET0000000010000000$ | 2.4 | 2.6 | 1K to GND | B4.K9 | 7MSET0000000010000000$ | 0.71 | 0.91 | 1 | 0
J7-020 | J_AI_GearShift_D1 | AI | 预留 | Type=电阻型 状态1:2.74K 下拉至GND 状态2:1K 下拉至GND | 608 | 04 31 03 C0 84 CC CC CC | 6MSET0000000000000000$ | 2.7K To GND | B3,K9 | 6MSET0000000010000000$ | 2.4 | 2.6 | 1K to GND | B4,K9 | 7MSET0000000010000000$ | 1.25 | 1.45 | 1 | 0
J7-017 | J_AI_GearShift_P2 | AI | 预留 | Type=电阻型 状态1:1K 下拉至GND 状态2:499R 下拉至GND | 528 | 04 31 03 C0 84 CC CC CC | 6MSET0000000000000000$ | 1K to GND | B3,K8 | 6MSET0000000100000000$ | 2.4 | 2.6 | 499R to GND | B4,K8 | 7MSET0000000100000000$ | 1.56 | 1.76 | 1 | 0
J7-015 | J_AI_InCarTempSensor | AI | 预留 | Type=电阻型 状态1:2.74K 下拉至GND 状态2:1K 下拉至GND | 384 | 04 31 03 C0 84 CC CC CC | 6MSET0000000000000000$ | 2.7K To GND | B3,K7 | 6MSET0000001000000000$ | 2.4 | 2.6 | 1K to GND | B4,K7 | 7MSET0000001000000000$ | 1.25 | 1.45 | 1 | 0
J5-050 | J_AI_ChargeTemp1 | AI | 交流充电口温度1 | Type=电阻型 状态1:3.3K 下拉至GND 状态2:1K 下拉至GND | 944 | 04 31 03 C0 84 CC CC CC | 6MSET0000000000000000$ | 3.3K To GND | B3.K6 | 6MSET0000010000000000$ | 2.4 | 2.6 | 1K to GND | B4.K6 | 7MSET0000010000000000$ | 1.06 | 1.26 | 1 | 0
J5-051 | J_AI_BatteryWaterTempSensorB | AI | 电池水温传感器信号B | Type=电阻型 状态1:5.1K 下拉至GND 状态2:1K 下拉至GND | 1024 | 04 31 03 C0 84 CC CC CC | 6MSET0000000000000000$ | 5.1K To GND | B3.K6 | 6MSET0000010000000000$ | 2.4 | 2.6 | 1K to GND | B4.K6 | 7MSET0000010000000000$ | 0.71 | 0.91 | 1 | 0
J5-048 | J_AI_RLWindowCtrSw | AI | 预留 | Type=电阻型 状态1:1K 下拉至GND 状态2:499R 下拉至GND | 832 | 04 31 03 C0 84 CC CC CC | 6MSET0000000000000000$ | 1K to GND | B3.K5 | 6MSET0000100000000000$ | 2.4 | 2.6 | 499R to GND | B4.K5 | 7MSET0000100000000000$ | 1.56 | 1.76 | 1 | 0
J5-049 | J_AI_ChargeDirectTemp1 | AI | 直流充电口温度1 | Type=电阻型 状态1:3.3K 下拉至GND 状态2:1K 下拉至GND | 848 | 04 31 03 C0 84 CC CC CC | 6MSET0000000000000000$ | 3.3K To GND | B3.K5 | 6MSET0000100000000000$ | 2.4 | 2.6 | 1K to GND | B4.K5 | 7MSET0000100000000000$ | 1.06 | 1.26 | 1 | 0
J5-037 | J_AI_ChargeDirectTemp2 | AI | 直流充电口温度2 | Type=电阻型 状态1:3.3K 下拉至GND 状态2:1K 下拉至GND | 864 | 04 31 03 C0 84 CC CC CC | 6MSET0000000000000000$ | 3.3K To GND | B3.K4 | 6MSET0001000000000000$ | 2.4 | 2.6 | 1K to GND | B4.K4 | 7MSET0001000000000000$ | 1.06 | 1.26 | 1 | 0
J5-038 | J_AI_PDUTempSensor1 | AI | 预留 | Type=电阻型 状态1:3.3K 下拉至GND 状态2:1K 下拉至GND | 912 | 04 31 03 C0 84 CC CC CC | 6MSET0000000000000000$ | 3.3K To GND | B3.K4 | 6MSET0001000000000000$ | 2.4 | 2.6 | 1K to GND | B4.K4 | 7MSET0001000000000000$ | 1.06 | 1.26 | 1 | 0
J5-035 | J_AI_MotorWaterTempSensorB | AI | 电机水温传感器信号B | Type=电阻型 状态1:5.1K 下拉至GND 状态2:1K 下拉至GND | 1040 | 04 31 03 C0 84 CC CC CC | 6MSET0000000000000000$ | 5.1K To GND | B3.K3 | 6MSET0010000000000000$ | 2.4 | 2.6 | 1K to GND | B4.K3 | 7MSET0010000000000000$ | 0.71 | 0.91 | 1 | 0
J5-036 | J_AI_ChargeTemp2 | AI | 交流充电口温度2 | Type=电阻型 状态1:3.3K 下拉至GND 状态2:1K 下拉至GND | 960 | 04 31 03 C0 84 CC CC CC | 6MSET0000000000000000$ | 3.3K To GND | B3.K3 | 6MSET0010000000000000$ | 2.4 | 2.6 | 1K to GND | B4.K3 | 7MSET0010000000000000$ | 1.06 | 1.26 | 1 | 0
J5-024 | J_AI_ChargeDirectTemp4 | AI | 预留 | Type=电阻型 状态1:3.3K 下拉至GND 状态2:1K 下拉至GND | 896 | 04 31 03 C0 84 CC CC CC | 6MSET0000000000000000$ | 3.3K To GND | B3.K2 | 6MSET0100000000000000$ | 2.4 | 2.6 | 1K to GND | B4.K2 | 7MSET0100000000000000$ | 1.06 | 1.26 | 1 | 0
J5-034 | J_AI_ChargeDirectTemp3 | AI | 预留 | Type=电阻型 状态1:3.3K 下拉至GND 状态2:1K 下拉至GND | 880 | 04 31 03 C0 84 CC CC CC | 6MSET0000000000000000$ | 3.3K To GND | B3.K2 | 6MSET0100000000000000$ | 2.4 | 2.6 | 1K to GND | B4.K2 | 7MSET0100000000000000$ | 1.06 | 1.26 | 1 | 0 | 状态1电压偏高
J5-010 | J_AI_ChargeTemp3 | AI | 预留 | Type=电阻型 状态1:3.3K 下拉至GND 状态2:1K 下拉至GND | 976 | 04 31 03 C0 84 CC CC CC | 6MSET0000000000000000$ | 3.3K To GND | B3.K1 | 6MSET1000000000000000$ | 1.86 | 2.06 | 1K to GND | B4.K1 | 7MSET1000000000000000$ | 0.72 | 0.92 | 1 | 0
J5-023 | J_AI_PDUTempSensor2 | AI | 预留 | Type=电阻型 状态1:3.3K 下拉至GND 状态2:1K 下拉至GND | 928 | 04 31 03 C0 84 CC CC CC | 6MSET0000000000000000$ | 3.3K To GND | B3.K1 | 6MSET1000000000000000$ | 2.4 | 2.6 | 1K to GND | B4.K1 | 7MSET1000000000000000$ | 1.06 | 1.26 | 1 | 0
~~J7-010~~ | ~~J_AI_GearShift_D2~~ | ~~AI~~ | ~~预留~~ |  | ~~624~~ | ~~04 31 03 C0 84 CC CC CC~~ | ~~4MSET0000000000000000$~~ |  | ~~B1,K8~~ | ~~4MSET0000000100000000$~~ |  |  |  | ~~B1,K16~~ | ~~4MSET0000000000000001$~~ |  |  | 0 | 0 | 预留不测试
J7-06 | J_AI_GearShift_R2 | AI | 预留 | 电阻型： 状态1： 2.74K 下拉至GND 状态2： 1K 下拉至GND | 592 | ~~04 31 03 C0 84 CC CC CC~~ | ~~4MSET0000000000000000$~~ | 2.74K To GND | B3,K7 | 6MSET0000001000000000$ | 2.4 | 2.6 | 1K to GND | B4,K7 | 7MSET0000001000000000$ | 1.25 | 1.45 | 1 | 0

Sheet: AI_VolType
PIN | Function | Singal Type | remark | Loadinfo | StartBit | DUT_CMD | LoadboxCMD_0 | state1_info | relay | LoadboxCMD_1 | State1_LSL | State1_USL | state2_info | relay | LoadBoxCMD_2 | State2_LSL | Sate2_USL | StepEnable | ParallelTest
J3-4 | J_AI_VacuumPressSensor | AI | 预留 | 电压型： DUT内部330k下拉 状态1： 3.3V 状态2 :1.8V | 464 | 04 31 03 C0 84 CC CC CC | AMSET0010000000000000$ | to DC 3.3V | B7,K5 | AMSET0000100000000000$ | 3.2 | 3.4 | to DC 1.8V | B7,K5 | AMSET0000100000000000$ | 1.7 | 1.9 | 1 | 0
J5-039 | J_AI_AccPositionSensor1 | AI | 加速踏板位置采样1 | 电压型： DUT内部330k下拉 状态1： 3.3V 状态2 :1.8V | 992 | 5 31 03 C0 84 CC CC CC | AMSET0000010000000000$ | to DC 3.3V | B7,K3 | AMSET0010000000000000$ | 3.2 | 3.4 | to DC 1.8V | B7,K3 | AMSET0010000000000000$ | 1.7 | 1.9 | 1 | 0
J5-047 | J_AI_AccPositionSensor2 | AI | 加速踏板位置采样2 | 电压型： DUT内部330k下拉 状态1： 3.3V 状态2 :1.8V | 1008 | 6 31 03 C0 84 CC CC CC | AMSET0001000000000000$ | to DC 3.3V | B7,K4 | AMSET0001000000000000$ | 3.2 | 3.4 | to DC 1.8V | B7,K4 | AMSET0001000000000000$ | 1.7 | 1.9 | 1 | 0
J9-031 | J_AI_LMirrorLRPositionFb | AI | 左外后视镜左右镜面位置采样 | 电压型:DUT内部330k下拉 状态1:3.3V 状态2 :1.8V | 688 | 8 31 03 C0 84 CC CC CC | AMSET1000000000000000$ | to DC 3.3V | B7,K6 | AMSET0000010000000000$ | 3.2 | 3.4 | to DC 1.8V | B7,K6 | AMSET0000010000000000$ | 1.7 | 1.9 | 1 | 0
J7-016 | J_AI_AtmosphericPressSensor | AI | 预留 | 电压型:DUT内部330k下拉 状态1:3.3V 状态2 :1.8V | 640 | 9 31 03 C0 84 CC CC CC | AMSET1000000000000000$ | to DC 3.3V | B7,K1 | AMSET1000000000000000$ | 3.2 | 3.4 | to DC 1.8V | B7,K1 | AMSET1000000000000000$ | 1.7 | 1.9 | 1 | 0
J9-033 | J_AI_LMirrorUDPositionFb | AI | 左外后视镜上下镜面位置采样 | 电压型： DUT内部330k下拉 状态1： 3.3V 状态2 :1.8V | 672 | 8 31 03 C0 84 CC CC CC | AMSET1000000000000000$ | to DC 3.3V | B7,K7 | AMSET0000001000000000$ | 3.2 | 3.4 | to DC 1.8V | B7,K7 | AMSET0000001000000000$ | 1.7 | 1.9 | 1 | 0

Sheet: PWM_IN
PIN | Function | singal type | remark | 负载信息 | SetFreq | DUT_Command | LoadboxReset | LoadBox_CMD | SingleCH | Freq_Start_bit | Duty_Start_bit | Set_duty | Freq_LSL | Freq_USL | duty_LSL | duty_USL | Set_duty | Freq_LSL | Freq_USL | duty_LSL | duty_USL | StepEnable | ParallelTest | Internal Acqu | StartBit | USL | LSL
J2-027 | J_PI_ChargeHVIL_Fb | PWM-IN | PWM-IN | 预留 | 100 | 04 31 03 C0 82 CC CC CC | AREST$ | CMSET0100000000000000$ | AMSET0000000000000001$ | 64 | 80 | 75 | 99 | 101 | -99999 | 99999 | 25 | 99 | 101 | -99999 | 99999 | 1 | 0
J3-27_PL | J_PI_FanFb | PWM-IN | 电子风扇诊断 | PWM 低驱 | 100 | 04 31 03 C0 82 CC CC CC | CMSET0000000000000000$ | CMSET0000000000100000$ | AMSET0000000000000010$ | 96 | 112 | 25 | 99 | 101 | 24 | 26 | 75 | 99 | 101 | 74 | 76 | 1 | 0
J3-26_PL | J_PI_RearAbatVentHALLFb2 | PWM-IN | 后遮阳帘HALL传感器信号2 | PWM 低驱 | 100 | 04 31 03 C0 82 CC CC CC | CMSET0000000000000000$ | CMSET0000000001000000$ | AMSET0000000000000010$ | 128 | 144 | 25 | 99 | 101 | 24 | 26 | 75 | 99 | 101 | 74 | 76 | 1 | 0
J3-28_PL | J_PI_RearAbatVentHALLFb 1 | PWM-IN | 后遮阳帘HALL传感器信号1 | PWM 低驱 | 100 | 04 31 03 C0 82 CC CC CC | CMSET0000000000000000$ | CMSET0000000000010000$ | AMSET0000000000000010$ | 160 | 176 | 25 | 99 | 101 | 24 | 26 | 75 | 99 | 101 | 74 | 76 | 1 | 0
J2-042_PL | J_PI_RLWindow_HallFb 1 | PWM-IN | 左后玻璃升降电机霍尔反馈1 | PWM 高驱 0-VBAT (三线霍尔） | 100 | 04 31 03 C0 82 CC CC CC | CMSET0000000000000000$ | CMSET0000010000000000$ | AMSET0000000000000010$ | 192 | 208 | 25 | 99 | 101 | 24 | 26 | 75 | 99 | 101 | 74 | 76 | 1 | 0
J2-044 | J_PI_RLWindow_HallFb2 | PWM-IN | 左后玻璃升降电机霍尔反馈2 | PWM 高驱 0-VBAT (三线霍尔） | 100 | 04 31 03 C0 82 CC CC CC | CMSET0000000000000000$ | CMSET0000001000000000$ | AMSET0000000000000001$ | 224 | 240 | 75 | 99 | 101 | -99999 | 99999 | 25 | 99 | 101 | -99999 | 99999 | 1 | 0
J5-046_PL | J_PI_PM2.5DendityFb | PWM-IN | 预留 | PWM 低驱 | 100 | 04 31 03 C0 82 CC CC CC | CMSET0000000000000000$ | CMSET0000000010000000$ | AMSET0000000000000001$ | 256 | 272 | 25 | 0 | 1 | 24 | 26 | 75 | 0 | 1 | 74 | 76 | 1 | 0 |  |  |  |  | 无法测试到
J2-045 | J_PI_DrvSeatSldHALLFb | PWM-IN | 预留 | PWM 高驱 上拉电阻为392R | 100 | 04 31 03 C0 82 CC CC CC | CMSET0000000000000000$ | CMSET0000000100000000$ | AMSET0000000000000001$ | 288 | 304 | 75 | 99 | 101 | -99999 | 99999 | 25 | 99 | 101 | -99999 | 99999 | 1 | 0 |  |  |  |  | 峰值电压4V只有25%
J2-034 | J_PI_DrvSeatHeightHALLFb | PWM-IN | 预留 | PWM 高驱 上拉电阻为392R | 100 | 04 31 03 C0 82 CC CC CC | CMSET0000000000000000$ | CMSET0010000000000000$ | AMSET0000000000000001$ | 328 | 344 | 75 | 99 | 101 | -99999 | 99999 | 25 | 99 | 101 | -99999 | 99999 | 1 | 0
J2-040 | J_PI_DrvSeatBackIncHALLFb | PWM-IN | 预留 | PWM 高驱 上拉电阻为392R | 100 | 04 31 03 C0 82 CC CC CC | CMSET0000000000000000$ | CMSET0001000000000000$ | AMSET0000000000000001$ | 352 | 368 | 75 | 99 | 101 | -99999 | 99999 | 25 | 99 | 101 | -99999 | 99999 | 1 | 0
J2-041 | J_PI_AbatVentHALLFb | PWM-IN | 预留 | PWM 高驱 上拉电阻为392R | 100 | 04 31 03 C0 82 CC CC CC | CMSET0000000000000000$ | CMSET0000100000000000$ | AMSET0000000000000001$ | 384 | 400 | 75 | 99 | 101 | -99999 | 99999 | 25 | 99 | 101 | -99999 | 99999 | 1 | 0
J6-010 | J_PI_ESCCUForwardBackward_HallFb | PWM-IN | 管柱前后调节HALL传感器信号 | PWM 高驱 上拉电阻为392R | 100 | 04 31 03 C0 82 CC CC CC | CMSET0000000000000000$ | CMSET0000000000001000$ | AMSET0000000000000001$ | 416 | 432 | 75 | 99 | 101 | -99999 | 99999 | 25 | 99 | 101 | -99999 | 99999 | 1 | 0 |  |  |  |  | 待客户确认
J6-09 | J_PI_ESCCUpDown_HallFb | PWM-IN | 管柱上下调节HALL传感器信号 | PWM 高驱 上拉电阻为392R | 100 | 04 31 03 C0 82 CC CC CC | CMSET0000000000000000$ | CMSET0000000000000100$ | AMSET0000000000000001$ | 448 | 464 | 75 | 99 | 101 | -99999 | 99999 | 25 | 99 | 101 | -99999 | 99999 | 1 | 0
J9-021_PL | J_PI_FLWindow_HallFb 1 | PWM-IN | 主驾玻璃升降电机霍尔反馈1 | PWM 高驱 0-VBAT (三线霍尔） | 100 | 04 31 03 C0 82 CC CC CC | CMSET0000000000000000$ | CMSET0000000000000010$ | AMSET0000000000000010$ | 480 | 496 | 25 | 99 | 101 | 24 | 26 | 75 | 99 | 101 | 74 | 76 | 1 | 0
J9-01_PL | J_PI_FLWindow_HallFb2 | PWM-IN | 主驾玻璃升降电机霍尔反馈2 | PWM 高驱 0-VBAT (三线霍尔） | 100 | 04 31 03 C0 82 CC CC CC | CMSET0000000000000000$ | CMSET0000000000000001$ | AMSET0000000000000010$ | 512 | 528 | 25 | 99 | 101 | 24 | 26 | 75 | 99 | 101 | 74 | 76 | 1 | 0
~~J5-16~~ | ~~J_PO_ChargeHVILOut~~ | ~~PWM-IN~~ | ~~主驾玻璃升降电机霍尔反馈2~~ | ~~PWM 高驱 0-VBAT (三线霍尔）~~ | ~~100~~ | ~~04 31 03 C0 82 CC CC CC~~ | ~~CMSET0000000000000000$~~ | ~~CMSET0000000000000001$~~ | AMSET0000000000000001$ | ~~512~~ | ~~528~~ | ~~75~~ | ~~99~~ | ~~101~~ | ~~-99999~~ | ~~99999~~ | ~~25~~ | ~~99~~ | ~~101~~ | ~~-99999~~ | ~~99999~~ | ~~0~~ | ~~0~~
J2-014 | J_PI_DriveHVIL_Fb | PWM-IN | 驱动回路HVIL反馈采样 | PWM 高驱 0-VBAT | 100 | 04 31 03 C0 82 CC CC CC | CMSET0000000000000000$ | CMSET1000000000000000$ | AMSET0000000000000001$ | 32 | 48 | 75 | 99 | 101 | -99999 | 99999 | 25 | 99 | 101 | -99999 | 99999 | 1 | 0

Sheet: DO
PIN | Function | singal type | remark | Load | StartBit | LoadboxCMD | DMM_CH | Off_LSL | Off_USL | On_LSL | On_USL | StepEnable | ParallelTest | Internal_acqu | Internal_Enabel | Acqu_type | Start_Bit | Curr_USL | Curr_LSL | Remark
J4-01 | J_DO_HS_BrakeLamp | DO-H | 制动灯控制 | 10R/100W 下拉至GND | 0 | N/A | 213 | 0 | 0.5 | 13 | 14 | 1 | 0 | M_AI_BrakeLamp_HeatCurrent | 1 |  | 80 | 0 | 0 | 关不掉
J4-02 | J_DO_HS_IMSPower | DO-H | 内流媒体后视镜供电 | 10R/100W 下拉至GND | 1 | N/A | 214 | 0 | 0.5 | 13 | 14 | 1 | 0 | NA | 0
J7-011 | J_DO_HS_SWSPower | DO-H | SWS/MFS/左智能表面供电 | 60R/50W 下拉至GND | 10 | 91CH26$ | 124 | 0 | 0.5 | 13 | 14 | 1 | 0 | NA | 0
J2-026 | J_DO_HS_MainPowerWake2 | DO-H | MainPower2 (DC&OBC/EVCC/IPU-F/IPU-R/电子风扇KL87) | 60R/50W 下拉至GND | 11 | 91CH17$ | 124 | 0 | 0.5 | 13 | 14 | 1 | 0 | M_DI_MainPowerWake2Fb | 0 | DI | 52 | 1 | 1
J2-025 | J_DO_HS_CameraHeated | DO-H | 摄像头加热 | 60R/50W 下拉至GND | 12 | 91CH16$ | 124 | 0 | 0.5 | 13 | 14 | 1 | 0 | NA | 0
J2-037 | J_DO_HS_ReverseLamp | DO-H | 倒车灯控制 | 60R/50W 下拉至GND | 13 | 91CH18$ | 124 | 0 | 0.5 | 13 | 14 | 1 | 0 | NA | 0
J2-038 | J_DO_HS_IntLgthPower | DO-H | 行李箱灯节能输出、 中前顶灯节能输出 | 60R/50W 下拉至GND | 14 | 91CH19$ | 124 | 0 | 0.5 | 13 | 14 | 1 | 0 | NA | 0
J7-02 | J_DO_HS_IntLgthPower | DO-H | 节能输出 | 60R/50W 下拉至GND | 14 | 91CH25$ | 124 | 0 | 0.5 | 13 | 14 | 1 | 0 | NA | 0
J8-08 | J_DO_HS_IntLgthPower | DO-H | 左侧BSD灯节能输出 | 60R/50W 下拉至GND | 14 | N/A | 233 | 0 | 0.5 | 13 | 14 | 1 | 0 | NA | 0
J2-039 | J_DO_HS_LampLimpHomeOut | DO-H | 近光灯LimpHome控制 | 60R/50W 下拉至GND | 15 | 91CH20$ | 124 | 0 | 0.5 | 13 | 14 | 1 | 0 | NA | 0
J2-052 | J_DO_HS_RDCUWake | DO-H | 右域硬线唤醒/Lifebeat | 10R/100W 下拉至GND | 16 | 91CH23$ | 124 | 0 | 0.5 | 13 | 14 | 1 | 0 | NA | 0
J4-015 | J_DO_HS_LtSlideDoor | DO-H | 预留 | 60R/50W 下拉至GND | 17 | N/A | 217 | 0 | 0.5 | 13 | 14 | 1 | 0 | NA | 0
J4-016 | J_DO_HS_SeatVentPower | DO-H | 预留 | 60R/50W 下拉至GND | 18 | N/A | 218 | 0 | 0.5 | 13 | 14 | 1 | 0 | NA | 0
J4-018 | J_DO_HS_ATLPower | DO-H | ATL供电 | 60R/50W 下拉至GND | 19 | N/A | 220 | 0 | 0.5 | 13 | 14 | 1 | 0 | NA | 0
J7-013 | J_DO_HS_ATLPower | DO-H | ATL供电 | 60R/50W 下拉至GND | 19 | 91CH28$ | 124 | 0 | 0.5 | 13 | 14 | 1 | 0 | NA | 0
J9-05 | J_DO_HS_ATLPower | DO-H | ATL供电 | 60R/50W 下拉至GND | 19 | N/A | 116 | 0 | 0.5 | 13 | 14 | 1 | 0 | NA | 0
J6-01 | J_PO_HS_SteeringWheelHeatedCtr | 方向盘加热 | 预留 | 10R/100W 下拉至GND | 2 | 91CH02$ | 124 | 0 | 0.1 | 13 | 14 | 1 | 0 | M_AI_SteeringWheelHeated_CurrentFb | 1 | AI | 96 | 0 | 0
J4-017 | J_DO_HS_Backlight | DO-H | 紧急报警开关背景灯/前顶灯背光/左后顶灯背光 | 60R/50W 下拉至GND | 20 | N/A | 219 | 0 | 0.5 | 13 | 14 | 1 | 0 | NA | 0
J7-012 | J_DO_HS_Backlight | DO-H | 预留 | 60R/50W 下拉至GND | 20 | 91CH27$ | 124 | 0 | 0.5 | 13 | 14 | 1 | 0 | NA | 0
J9-011 | J_DO_HS_Backlight | DO-H | 背主驾电动窗开关背光 | 60R/50W 下拉至GND | 20 | N/A | 122 | 0 | 0.5 | 13 | 14 | 1 | 0 | NA | 0
J3-25 | J_DO_HS_FSRRPower | DO-H | 左前、右前短距毫米波雷达SRR_FL、 SRR_FR | 60R/50W 下拉至GND | 21 | N/A | 229 | 0 | 0.5 | 13 | 14 | 1 | 0 | NA | 0
J7-01 | J_DO_HS_HallPower | DO-H | 管柱HALL传感器电源 | 60R/50W 下拉至GND | 22 | 91CH24$ | 124 | 0 | 0.5 | 13 | 14 | 1 | 0 | NA | 0
J5-043 | J_DO_HS_HallPower | DO-H | 左后电动窗/遮阳帘HALL传感器电源 | 60R/50W 下拉至GND | 22 | N/A | 211 | 0 | 0.5 | 13 | 14 | 1 | 0 | NA | 0
J8-011 | J_DO_HS_HallPower | DO-H | 主驾电动窗霍尔传感器供电 | 60R/50W 下拉至GND | 22 | N/A | 234 | 0 | 0.5 | 13 | 14 | 1 | 0 | NA | 0
J8-04 | J_DO_HS_LeftMirrorHeated | DO-H | 左外后视镜加热 | 60R/50W 下拉至GND | 23 | N/A | 232 | 0 | 0.5 | 13 | 14 | 1 | 0 | NA | 0
J1-02 | J_DO_LS_REOPRly | DO-L | 后油泵继电器 | 2.74K 上拉至VBAT | 24 | 91CH29$ | 124 | 13 | 14 | 0 | 0.5 | 1 | 0 | NA | 0
J1-016 | J_DO_LS_ 12VPower2 | DO-L | 12V取电口（副IP台前） | 2.74K 上拉至VBAT | 25 | N/A | 238 | 13 | 14 | 0 | 0.5 | 1 | 0 | NA | 0 |  |  |  |  | 上拉后系统报错
J1-01 | J_DO_LS_ 12VPWR2RLY | DO-L | 预留 | 2.74K 上拉至VBAT | 26 | N/A | 235 | 13 | 14 | 0 | 0.5 | 1 | 0 | NA | 0
J1-014 | J_DO_LS_ 12VPower1 | DO-L | 12V取电口（行李箱） | 2.74K 上拉至VBAT | 27 | N/A | 236 | 13 | 14 | 0 | 0.5 | 1 | 0 | NA | 0
J1-015 | J_DO_LS_VaccumPumpRly | DO-L | 预留 | 2.74K 上拉至VBAT | 28 | N/A | 237 | 13 | 14 | 0 | 0.5 | 1 | 0 | NA | 0
J1-017 | J_DO_LS_CarpetLight | DO-L | 预留 | 2.74K 上拉至VBAT | 29 | N/A | 239 | 13 | 14 | 0 | 0.5 | 1 | 0 | NA | 0 |  |  |  |  | 输出10V
J5-042 | J_5V_SensorPower1 | 5V-OUT | 传感器电源1 | 1K 下拉至GND | 3 | N/A | 210 | 4.9 | 5.1 | 0 | 0.5 | 1 | 0 | NA | 0
J6-011 | J_5V_SensorPower1 | 5V-OUT | 预留 | 1K 下拉至GND | 3 | 91CH05$ | 124 | 4.9 | 5.1 | 0 | 0.5 | 1 | 0 | M_AI_5V_SENSOR_POWER1_FB | 1 | AI | 112
J1-040 | J_DO_LS_CWCEN | DO-L | 预留 | 2.74K 上拉至VBAT | 30 | 91CH01$ | 124 | 13 | 14 | 0 | 0.5 | 1 | 0 | NA | 0
J2-03 | J_DO_HS_BMSEmergencyStop |  |  |  | 31 | 91CH08$ | 124 | 0 | 0.5 | 13 | 14 | 1 | 0 | NA | 0
J2-04 | J_DO_HS_KL15_BackUp |  | 右域KL15电控制冗余 | 2.74K 下拉至GND | 32 | 91CH09$ | 124 | 0 | 0.5 | 13 | 14 | 1 | 0 | NA | 0
J2-05 | J_DO_HS_PM25FanPower | DO-H | 预留 | 2.74K 下拉至GND | 33 | 91CH10$ | 124 | 0 | 0.5 | 13 | 14 | 1 | 0 | NA | 0
J2-06 | J_DO_LS_RLDoorHandleLight | DO-L | 预留 | 2.74K 上拉至VBAT | 34 | 91CH11$ | 124 | 13 | 14 | 0 | 0.5 | 1 | 0 | NA | 0
J3-13 | J_DO_LS_FEOPRly | DO-L | 前油泵继电器 | 2.74K 上拉至VBAT | 35 | N/A | 225 | 13 | 14 | 0 | 0.5 | 1 | 0 | NA | 0
J3-16 | J_PO_LS_MotorPumpSpeedCtr | PWM-OUT | 预留 | 2.74K 上拉至VBAT | 36 | N/A | 228 | 13 | 14 | 0 | 0.5 | 1 | 0 | NA | 0
J3-11 | J_DO_LS_FanRly | DO-L | 电子风扇继电器控制 | 2.74K 上拉至VBAT | 37 | N/A | 223 | 13 | 14 | 0 | 0.5 | 1 | 0 | NA | 0
J3-10 | J_DO_LS_BatteryPumpRly | DO-L | 电池水泵继电器 | 2.74K 上拉至VBAT | 38 | N/A | 222 | 13 | 14 | 0 | 0.5 | 1 | 0 | NA | 0
J3-14 | J_DO_LS_MotorPumpRly | DO-L | 电机水泵继电器 | 2.74K 上拉至VBAT | 39 | N/A | 226 | 13 | 14 | 0 | 0.5 | 1 | 0 | NA | 0
J2-02 | J_5V_SensorPower2 | 5V-OUT | 加速踏板传感器2电源5V+ | J_5V_SensorPower2 | 4 | 91CH07$ | 124 | 4.9 | 5.1 | 0 | 0.5 | 1 | 0 | M_AI_5V_SENSOR_POWER2_FB | 1 | AI | 128 | 0 | 0
J3-6 | J_5V_SensorPower2 | 5V-OUT | 预留 | 1K 下拉至GND | 4 | N/A | 221 | 4.9 | 5.1 | 0 | 0.5 | 1 | 0 | NA | 0
J3-32 | J_DO_LS_DeforstrRly | DO-L | 后除霜继电器 | 2.74K 上拉至VBAT | 40 | N/A | 231 | 13 | 14 | 0 | 0.5 | 1 | 0 | NA | 0
J9-07 | J_DO_HS_WinLockLight | DO-H | 中控车窗锁止指示灯 | 2.74K 下拉至GND | 41 | N/A | 118 | 0 | 0.1 | 13 | 14 | 1 | 0 | NA | 0
J9-06 | J_DO_LS_LBSDLight | DO-L | 左侧BSD灯 | 2.74K 上拉至VBAT | 42 | N/A | 117 | 13 | 14 | 0 | 0.5 | 1 | 0 | NA | 0
J9-010 | J_DO_LS_LFDoorHandleLight | DO-L | 预留 | 2.74K 上拉至VBAT | 43 | N/A | 121 | 13 | 14 | 0 | 0.5 | 1 | 0 | NA | 0
J9-09 | J_DO_LS_LDOWLight | DO-L | 预留 | 2.74K 上拉至VBAT | 44 | N/A | 119 | 13 | 14 | 0 | 0.5 | 1 | 0 | NA | 0
J6-05 | J_PO_LS_LFootLight |  | 预留 | 2.74K 上拉至VBAT | 45 | 91CH06$ | 124 | 13 | 14 | 0 | 0.5 | 1 | 0 | NA | 0
J5-044 | J_5V_SensorPower3 | 5V-OUT | 预留 | 1K 下拉至GND | 5 | N/A | 212 | 4.9 | 5.1 | 0 | 0.5 | 1 | 0 |  | 0
J9-023 | J_5V_SensorPower3 | 5V-OUT | 传感器电源3 | 1K 下拉至GND | 5 | N/A | 123 | 4.9 | 5.1 | 0 | 0.5 | 1 | 0 | M_AI_5V_SENSOR_POWER3_FB | 1 | AI | 144 | 1 | 1
J2-09 | J_DO_HS_MainPowerWake 1 | DO-H | MainPower1 | 60R/50W 下拉至GND | 6 | 91CH12$ | 124 | 0 | 0.5 | 13 | 14 | 1 | 0 | M_DI_MainPowerWake1Fb | 1 | DI | 53 | 1 | 1
J2-010 | J_DO_HS_KL15Wake 1 | DO-H | BLS2/MSB/ACU 唤醒 | 60R/50W 下拉至GND | 7 | 91CH13$ | 124 | 0 | 0.5 | 13 | 14 | 1 | 0 | NA | 0
J2-012 | J_DO_HS_CDCUWake | DO-H | CDCU唤醒 | 60R/50W 下拉至GND | 8 | 91CH14$ | 124 | 0 | 0.5 | 13 | 14 | 1 | 0 | NA | 0
J2-013 | J_DO_HS_CDCWake | DO-H | CDC唤醒 | 60R/50W 下拉至GND | 9 | 91CH15$ | 124 | 0 | 0.5 | 13 | 14 | 1 | 0 | NA | 0
J1-027 | J_PO_DiffuseCeilingLamp | PWM-OUT | 预留 | 2.74K 上拉至VBAT | 46 | N/A | 240 | 13 | 14 | 0 | 0.5 | 1 | 0 | NA | 0

Sheet: PWM_OUT
PIN | Function | singal type | remark | 负载信息 | DUT测试状态 | StartBit | DMM_CH | DMM Slot | DUT_CMD_STATE1 | Feq_LSL | Feq_USL | duty_LSL | duty_USL | DUT_CMD_STATE2 | Feq_LSL | Feq_USL | duty_LSL | duty_USL | StepEnable
J9-08 | J_PO_LS_LCarpetLight | PWM-OUT | 预留 | 2.74K 上拉至VBAT | 状态1： 25% 状态2： 75% | 72 | 119 | Slot1,PIN37 | 00 64 19 | 99 | 101 | 24 | 27 | 00 64 4B | 99 | 101 | 73 | 77 | 1
J5-07 | J_PO_LS_TrunkLight | PWM-OUT | 行李箱灯 | 2.74K 上拉至VBAT | 状态1： 75% 状态2： 25% | 168 | 206 | Slot2,PIN6 | 00 64 19 | 99 | 101 | 24 | 27 | 00 64 4B | 99 | 101 | 73 | 77 | 1
J5-06 | J_PO_LS_TLTopLight | PWM-OUT | 三排左顶灯 | 2.74K 上拉至VBAT | 状态1： 25% 状态2： 75% | 96 | 205 | Slot2,PIN5 | 00 64 19 | 99 | 101 | 24 | 27 | 00 64 4B | 99 | 101 | 73 | 77 | 1
J5-05 | J_PO_LS_RLTopLight | PWM-OUT | 左后顶灯 | 2.74K 上拉至VBAT | 状态1： 75% 状态2： 25% | 192 | 204 | Slot2,PIN4 | 00 64 19 | 99 | 101 | 24 | 27 | 00 64 4B | 99 | 101 | 73 | 77 | 1
J5-04 | J_PO_LS_FMTopLight | PWM-OUT | 中前顶灯 | 2.74K 上拉至VBAT | 状态1： 25% 状态2： 75% | 120 | 203 | Slot2,PIN3 | 00 64 19 | 99 | 101 | 24 | 27 | 00 64 4B | 99 | 101 | 73 | 77 | 1
J5-03 | J_PO_LS_FRTopLight | PWM-OUT | 右前顶灯 | 2.74K 上拉至VBAT | 状态1： 75% 状态2： 25% | 144 | 202 | Slot2,PIN2 | 00 64 19 | 99 | 101 | 24 | 27 | 00 64 4B | 99 | 101 | 73 | 77 | 1
J5-02 | J_PO_LS_FLTopLight | PWM-OUT | 左前顶灯 | 2.74K 上拉至VBAT | 状态1： 25% 状态2： 75% | 216 | 201 | Slot2,PIN1 | 64 00 19 | 99 | 101 | 24 | 27 | 00 64 4B | 99 | 101 | 73 | 77 | 1
J5-016 | J_PO_ChargeHVILOut | PWM-OUT | 预留 | 2.74K 下拉至GND | 状态1： 25% 状态2： 75% | 264 | 209 | Slot2,PIN9 | 00 64 19 | 99 | 101 | -999 | 999 | 00 64 4B | 99 | 101 | -999 | 999 | 1 | 负载表不测占空比，负载电阻不对
J3-30 | J_PO_DriveHVILOut | PWM-OUT | 驱动回路互锁输出 | 2.74K 下拉至GND | 状态1： 25% 状态2： 75% | 240 | 230 | Slot2,PIN31 | 00 64 19 | 99 | 101 | 24 | 27 | 00 64 4B | 99 | 101 | 73 | 77 | 1 | 占空比不对
J3-15 | J_PO_LS_FanSpeedCtr | PWM-OUT | 电子风扇PWM控制 | 2.74K 上拉至VBAT | 状态1： 25% 状态2： 75% | 48 | 227 | Slot2,PIN28 | 00 64 19 | 99 | 101 | 24 | 27 | 00 64 4B | 99 | 101 | 73 | 77 | 1
J3-12 | J_PO_LS_LCarpetLight | PWM-OUT | 左侧迎宾光毯 | 2.74K 上拉至VBAT | 状态1： 25% 状态2： 75% | 0 | 224 | Slot2,PIN24 | 00 64 19 | 99 | 101 | 24 | 27 | 00 64 4B | 99 | 101 | 73 | 77 | 1

Sheet: FULL_Bridge_Briver
PIN | Function | singal type | remark | Startbit | bit wide | DUTCMD | LSL | USL | DUTCMD | LSL | USL | DUTCMD | LSL | USL | LoadBox_CMD | DAQ6510-7702_CH | DMM Slot & PIN | StepEnable | ParallelTest | Internal_acqu | Internal_acqu_Enable | acqu_type | Start_Bit | Curr_USL1 | Curr_LSL1 | Curr_USL2 | Curr_LSL2 | Reark
 |  |  |  |  |  | Start1 Forward turn |  |  | Start2 reverse turn |  |  | Start3 brake |  |  |  |  |  |  |  | 内部回采
0 | 1 | 2 | 3 | 4 | 5 | 6 | 7 | 8 | 9 | 10 | 11 | 12 | 13 | 14 | 15 | 16 | 17 | 18 | 19 | 20 | 21 | 22 | 23 | 24 | 25 | 26 | 27 | 28
J4-06 & J4-07 | J_HBridge_RearAbatVentCtr+ J_HBridge_RearAbatVentCtr- | full bridge driver | 后遮阳帘电机正 后遮阳帘电机负 | 22 | 2 | 1 | 12 | 14 | 2 | -14 | -12 | 3 | 0 | 0.5 | N/A | 102 | Slot1，PIN3|Slot1，PIN4 | 1 | 0 | M_AI_Seat_CSO1 | 1 | AI | 16 | 0 | 0 | 0 | 0 | 未定义的规格
J4-010&J4-011 | J_HBridge_RLDoorLockCtr+ J_HBridge_RLDoorLockCtr- | full bridge driver | 左后门锁电机正 左后门锁电机负 | 2 | 2 | 1 | 12 | 14 | 2 | -14 | -12 | 3 | 0 | 0.5 | N/A | 104 | Slot1，PIN7|Slot1，PIN8 | 1 | 0 | M_AI_DoorLock_Current | 1 | AI | 160 | 0 | 0 | 0 | 0 | 未定义的规格
J4-012&J4-013 | J_HBridge_RLHandleCtr- J_HBridge_RLHandleCtr+ | full bridge driver | 预留 | 10 | 2 | 1 | -14 | -12 | 2 | 12 | 14 | 3 | 0 | 0.5 | N/A | 105 | Slot1，PIN9|Slot1，PIN10 | 1 | 0 | M_AI_RLHandle_Current | 1 | AI | 240 | 0 | 0 | 0 | 0 | 未定义的规格
J4-019&J4-020 | J_Hbridge_EPBCtr+ J_Hbridge_EPBCtr- | full bridge driver | EPB左侧卡钳电机正 EPB左侧卡钳电机负 | 0 | 2 | 1 | 12 | 14 | 2 | -14 | -12 | 3 | 0 | 0.5 | N/A | 106 | Slot1，PIN1Slot1，PIN12 | 1 | 0 | M_AI_TLE92108_CSO1 | 1 | AI | 48 | 0 | 0 | 0 | 0 | 未定义的规格
J4-024&J4-025 | J_Hbridge_RLWindowCtr+ J_Hbridge_RLWindowCtr- | full bridge driver | 左后车窗控制正 左后车窗控制负 | 40 | 2 | 1 | 12 | 14 | 2 | -14 | -12 | 3 | 0 | 0.5 | N/A | 108 | Slot1，PIN1Slot1，PIN16 | 1 | 0 | M_AI_WINDOW_CURRENT2 | 1 | AI | 1088 | 0 | 0 | 0 | 0 | 未定义的规格
J8-01&J8-05 | J_HBridge_FLHandleCtr+ J_HBridge_FLHandleCtr- | full bridge driver | 左前门把手电机正 左前门把手电机负 | 6 | 2 | 1 | 12 | 14 | 2 | -14 | -12 | 3 | 0 | 0.5 | N/A | 109 | Slot1，PIN17|Slot1，PIN18 | 1 | 0 | M_AI_FLHandle_Current | 1 | AI | 224 | 0 | 0 | 0 | 0 | 未定义的规格
J8-02&J8-03 | J_HBridge_FLCWindowCtr- J_HBridge_FLCWindowCtr+ | full bridge driver | 左前车窗控制负 左前车窗控制正 | 36 | 2 | 1 | -14 | -12 | 2 | 12 | 14 | 3 | 0 | 0.5 | N/A | 110 | Slot1，PIN19|Slot1，PIN20 | 1 | 0 | M_AI_WINDOW_CURRENT1 | 1 | AI | 1072 | 0 | 0 | 0 | 0 | 未定义的规格
J8-06&J8-07 | J_HBridge_FMirrorFoldCtr- J_HBridge_FMirrorFoldCtr+ | full bridge driver | 左外后视镜折叠电机负 左外后视镜折叠电机正 | 12 | 2 | 1 | -14 | -12 | 2 | 12 | 14 | 3 | 0 | 0.5 | N/A | 111 | Slot1，PIN21|Slot1，PIN22 | 1 | 0 | M_AI_FMirrorFold_Current | 1 | AI | 256 | 0 | 0 | 0 | 0 | 未定义的规格
J9-020&J9-040 | J_HBridge_FLDoorLockCtr+ J_HBridge_FLDoorLockCtr- | full bridge driver | 左前门锁电机正 | 8 | 2 | 1 | 12 | 14 | 2 | -14 | -12 | 3 | 0 | 0.5 | N/A | 114 | Slot1，PIN27|Slot1，PIN28 | 1 | 0 | M_AI_FLDoorLock_Current | 1 | AI | 272 | 0 | 0 | 0 | 0 | 未定义的规格
J5-040&J5-041 | J_HBridge_LChildLockCtr- J_HBridge_Reserve2- | full bridge driver | 预留 | 4 | 2 | 1 | 12 | 14 | 2 | -14 | -12 | 3 | 0 | 0.5 | N/A | 101 | Slot1，PIN1|Slot1，PIN2 | 1 | 0 | NA | 0
J4-022&J4-023 | J_HBridge_FLCinchMotorCt J_HBridge_FLCinchMotorCtr+ | full bridge driver | 预留 | 38 | 2 | 1 | -14 | -12 | 2 | 12 | 14 | 3 | 0 | 0.5 | N/A | 107 | Slot1，PIN13|Slot1，PIN14 | 1 | 0 | NA | 0
J4-08&J4-09 | J_Hbridge_DrvSeatHe J_Hbridge_DrvSeatHei+ | full bridge driver | 预留 | 34 | 2 | 1 | -14 | -12 | 2 | 12 | 14 | 3 | 0 | 0.5 | N/A | 103 | Slot1，PIN5|Slot1，PIN6 | 1 | 0 | NA | 0
~~J8-09&J8-010~~ | ~~J_HBridge_FMirrorLRCtr- J_HBridge_FMirrorCtr+ J_HBridge_FMirrorUDCtr-~~ | ~~full bridge driver~~ | ~~左外后视镜面左右调节 左外后视镜面调节公共端 左外后视镜上下调节~~ | ~~20~~ | ~~2~~ | ~~1~~ | ~~-14~~ | ~~-12~~ | ~~2~~ | ~~12~~ | ~~14~~ | ~~3~~ | ~~0~~ | ~~0.5~~ | ~~N/A~~ | ~~112~~ | ~~Slot1，PIN23 Slot1，PIN24 Slot1，PIN25~~ | ~~0~~ | ~~0~~ | NA | 0 |  |  |  |  |  |  | ~~专用命令测试在脚步中~~
~~J8-012&J8-010~~ | ~~J_HBridge_FMirrorLRCtr- J_HBridge_FMirrorCtr+ J_HBridge_FMirrorUDCtr-~~ | ~~full bridge driver~~ | ~~左外后视镜面左右调节 左外后视镜面调节公共端 左外后视镜上下调节~~ | ~~18~~ | ~~2~~ | ~~1~~ | ~~12~~ | ~~14~~ | ~~2~~ | ~~-14~~ | ~~-12~~ | ~~3~~ | ~~0~~ | ~~0.5~~ | ~~N/A~~ | ~~113~~ | ~~Slot1，PIN23 Slot1，PIN24 Slot1，PIN25~~ | ~~0~~ | ~~0~~ | NA | 0 |  |  |  |  |  |  | ~~专用命令测试在脚步中~~
~~J6-02&J6-04~~ | ~~J_Hbridge_ESCCUUpDown+ J_Hbridge_ESCCUCom+ J_Hbridge_ESCCUForwardBackward+~~ | ~~full bridge driver~~ | ~~管柱上下调节电机正 管柱调节电机公共端 管柱前后调节电机正~~ | ~~24~~ | ~~2~~ | ~~1~~ | ~~12~~ | ~~14~~ | ~~2~~ | ~~-14~~ | ~~-12~~ | ~~3~~ | ~~0~~ | ~~0.5~~ | ~~N/A~~ | ~~115~~ | ~~Slot1，PIN29 Slot1，PIN30 Slot2，PIN15~~ | ~~0~~ | ~~0~~ | NA | 0 |  |  |  |  |  |  | ~~专用命令测试在脚步中~~
~~J6-04&J4-03~~ | ~~J_Hbridge_ESCCUUpDown+ J_Hbridge_ESCCUCom+ J_Hbridge_ESCCUForwardBackward+~~ | ~~full bridge driver~~ | ~~管柱上下调节电机正 管柱调节电机公共端 管柱前后调节电机正~~ | ~~26~~ | ~~2~~ | ~~1~~ | ~~12~~ | ~~14~~ | ~~2~~ | ~~-14~~ | ~~-12~~ | ~~3~~ | ~~0~~ | ~~0.5~~ | ~~N/A~~ | ~~125~~ | ~~Slot1，PIN29 Slot1，PIN30 Slot2，PIN15~~ | ~~0~~ | ~~0~~ | ~~M_AI_ESCCU_CSO2~~ | ~~0~~ | AI | ~~40~~
J4-05&J6-03 | J_SteeringWheelHeatedReturn | full bridge driver | 方向盘加热return | 28 | 2 | 1 | 12 | 14 | 2 | -14 | -12 | 3 | 0 | 0.5 | 91CH03$ | B6,JP3A_PIN3 | Slot1，PIN47 | 0 | 0 | NA | 0 |  |  |  |  |  |  | 协议中为H_bridge 负载表为DO

Sheet: Waken_Sleep
Pin Num | function | singal type | remark | LoadBoxSW | SleepCurrent_USL
J1-3_J1-4 | ECAN |  | ECAN |  | 0.02
J3-8_J3-7 | CCAN |  | CCAN |  | 0.02
J5-8_J5-9 | ICAN |  | ICAN |  | 0.02
J5-11_J5-12 | UWBCAN |  | UWBCAN |  | 0.02
J5 25 | J_LIN_PWS |  | J_LIN_PWS |  | 0.02
J5-26 | J_LIN_RFR |  | J_LIN_RFR |  | 0.02
J1-6 | J_DI_BrakeSw1_HS | 数字输入-高 | BLS1开关 |  | 0.02
J9-2 | J_DI_DriveDoorReleaseSW_LS | 数字输入-低 | 左前吸合门： Auto Reset |  | 0.02
J9-4 | J_DI_FLDoorUnlockSW_LS | 数字输入-低 | 主驾Unlock信号 |  | 0.02
J9-22 | J_DI_FLDoorAjarSW_LS | 数字输入-低 | 主驾Ajar信号 |  | 0.02
J9-24 | J_DI_CentralOpenLockSw_LS | 数字输入-低 | 中控解锁开关 |  | 0.02
J9-25 | J_DI_CentralCloseLockSw_LS | 数字输入-低 | 中控闭锁开关 |  | 0.02
J9-22 | J_DI_FLDoorAjarSW_LS | 数字输入-低 | 左前门开关 |  | 0.02
J1-46 | J DI EmergencyAlarmSw LS | 数字输入-低 | 紧急报警开关信号采集 |  | 0.02
J9-3 | J DI FLOutHandle LS | 数字输入-低 | 左外开门把手 |  | 0.02
J1-29 | J DI DCULifeBeat Wake | 数字输入-低 | 右域唤醒/心跳采样 |  | 0.02
J2-30 | J DI RLDoorAjarSW LS | 数字输入-低 | 左侧滑门锁状态 |  | 0.02
J1-44 | J_DI_TrunkOpenSw_LS | 数字输入-低 | 尾门开启开关 |  | 0.02
J2-47 | J_AI_ASCtrSw | 模拟输入 | 悬架升降开关信号 |  | 0.02

Sheet: VOl_Test
Singal | Test Pint | LSL | USL | DMM Slot | CH
VAUX 5V | T333 | 4.9 | 5.1
VCCA 5V | T367 | 4 9 | 5 1
VPRE | T328 | 6.4 | 6.6
3V3 | T369 | 3 2 | 3 4
VBAT0 | T23 | Vbat-0.55 | Vbat
VBAT_PullUp | T220 | Vbat-0 75 | Vbat
VBAT_Driver | T312 | Vbat-0.55 | Vbat
1 09V | T905 | 1 | 1 15
U35 VDD | T713 | 2.87 | 3.17
U36 VDD | T703 | 2.87 | 3.17
U34 VDD | T692 | 2 87 | 3 17

Sheet: 回踩(新增加)
Pin | info | CMD | Pin Type | Type | StaartBit
J2-2 | J_5V_SensorPower2 | M_AI_5V_SENSOR_POWER2_FB |  | AI | 136 | 没有测试LIMIT
J2-26 | J_PI_ChargeHVIL_Fb | M_DI_MainPowerWake2Fb |  | DI | 52
J2-9 | J_DO_HS_MainPowerWake1 | M_DI_MainPowerWake1Fb |  | DI | 53
J3-30 | J_PO_DriveHVILOut | M_PI_DriveHVILOutFb |  | PWM IN | 已测
J4-1 | J_DO_HS_BrakeLamp | M_AI_BrakeLamp_HeatCurrent |  | U43_T752/AI | 88
J4-11/J4-10 | J_HBridge_RLDoorLockCtr- | M_AI_DoorLock_Current |  | AI | 168
J4-13 | J_HBridge_RLHandleCtr+ | M_AI_RLHandle_Current |  | AI | 248
 |  | M_AI_TLE92108_CSO2 |  | AI | 72
J4-25 | J_Hbridge_RLWindowCtr- | M_AI_WINDOW_CURRENT2 |  | AI | 1096
J4-3 | J_Hbridge_ESCCUForwardBackward+ | M_AI_ESCCU_CSO2 |  | AI | 40
J4-7 | J_HBridge_RearAbatVentCtr- | M_AI_Seat_CSO1 |  | AI | 24
J4-9 | J_Hbridge_DrvSeatHei+ | M_AI_TLE92108_CSO1 |  | AI | 56
J6-1 | J_PO_HS_SteeringWheelHeatedCtr | M_AI_SteeringWheelHeated_CurrentFb |  | AI | 104
J6-11 | J_5V_SensorPower1 | M_AI_5V_SENSOR_POWER1_FB |  | AI | 120
J8-3 | J_HBridge_FLCWindowCtr+ | M_AI_WINDOW_CURRENT1 |  | AI | 1080
J8-5 | J_HBridge_FLHandleCtr- | M_AI_FLHandle_Current |  | AI | 232
J8-7 | J_HBridge_FMirrorFoldCtr+ | M_AI_FMirrorFold_Current |  | AI | 264
J9-23 | J_5V_SensorPower3 | M_AI_5V_SENSOR_POWER3_FB |  | AI | 152
J9-40 | J_HBridge_FLDoorLockCtr- | M_AI_FLDoorLock_Current |  |  | 280
 | 未定义测试条件 | M_AI_BAT |  |  |  | 未定义测试条件
 | 未定义测试条件 | M_AI_BAT_VBATPullUp_FB |  |  | 504
 | 未定义测试条件 | M_AI_FS6522_MUXOUT |  |  | 8
