Fred-Guo0422/H93_LDCU_EOL_TESTER/document/产品图纸/H93_LDCU_Debug_Testlist.xls

Sheet: H93_LDCU_Debug
序号 | 测序项目 | 测序子项目 | 长度 | 发送请求 | 正反馈 | 测试类型 | 延时/ms | 期望值 | PromptDialogBox | TestTime | TestResult | 有效长度 | 指令重发机制 | Global | 配置 | CAN通道 | Unit | 备注
1 | SN扫描 | SN长度 |  |  | 66 66 66 | Number | 0 | (24/24) |  |  |  | (0/1) | 0 | TNum0 |  |  |  | 提取数值用于后边测试项目比较，目前只支持20个参数的Number Global数组。
2 |  | SN规则 |  |  |  | String | 0 | (91104/91104) |  |  |  | (1/5)
3 |  | SN |  |  |  | String | 0 | (){24/24} |  |  |  | (6/24) |  | TStr1 |  |  |  | 提取字符串用于后边测试项目比较，目前只支持20个参数的String Global数组。
4 | 电源开启 |  |  |  | 66 66 66 01 | String | 0 |  |  |  |  |  | 0 |  | VISA0:13.5V:2A |  |  | 电源配置有三个参数：1.VISA的index，2.设置电压，3.限制电流，中间用英文“:”分开，首位不能缺省，其他位缺省默认设置为0。电源有5种设置，分别为：电源开启、电源关闭、电源读取包含（电压（单位0.1mV）、电流（单位0.1mA）、功率（单位0.1mP）），每个参数有效长度必须为4。
5 | 延时 |  |  |  | 66 66 66 | Number | 0 | () |  |  |  | (0/4) | 0 | :x/1000 | Delay:5000ms |  | s | delay时间为ms。
6 | 电源读取 | 电源电压 |  |  | 66 66 66 01 | Number | 0 | (13.4000/13.6000) |  |  |  | (0/4) | 0 | :x/10000 | VISA0 |  | mV | 可将读取结果通过数学公式之后再输出，公式前面的“:”必须带上，但是“:”前可缺省。
7 |  | 电源电流 |  |  |  | Number | 0 | (0.2000/0.5000) |  |  |  | (4/4) |  | TNum1:x/10000 | VISA0 |  | A | 提取数值用于后边测试项目比较，目前只支持20个参数的Number Global数组，可支持将测试结果增加运算后再输出，然后再赋予到Global数组。中间用“:”分开，数学公式可缺省。
8 |  | 电源功率 |  |  |  | Number | 0 | (3.0000/6.0000) |  |  |  | (8/4) |  | TNum2:x/10000 | VISA0 |  | P
9 | 进入10 01 |  |  | 10 01 | 50 01 | String | 20 |  |  |  |  |  | 2
10 | 进入10 03 |  |  | 10 03 | 50 03 | String | 20 |  |  |  |  |  | 2
11 | 获取基础软件版本号 |  |  | 22 A5 F0 | 62 A5 F0 | String | 20 | (V50.00.000) |  |  |  | (0/10) | 2
12 | 获取Boot软件版本号 |  |  | 22 F1 80 | 62 F1 80 | String | 20 | (9110400HA10001B.G) |  |  |  | (0/17) | 2
13 | 进入10 60 |  |  | 10 60 | 50 60 | String | 20 |  |  |  |  |  | 2
14 | 进入27 01 |  |  | 27 01 | 67 01 | String | 20 |  |  |  |  |  | 2
15 | 进入27 02 |  |  | 27 02 00 01 02 03 | 67 02 | String | 20 |  |  |  |  |  | 2
16 | 写入A5F2 |  |  | 2E A5 F2 1F | 6E A5 F2 | String | 20 |  |  |  |  |  | 2
17 | 写入A5F2 |  |  | 2E A5 F2 10 | 6E A5 F2 | String | 20 |  |  |  |  |  | 2
18 | 写入PCBA码 |  |  | 2E F1 8C | 6E F1 8C | String | 20 |  |  |  |  |  | 2
19 | 写小鹏零件号 |  |  | 2E F1 87 | 6E F1 87 | String | 20 |  |  |  |  |  | 2
20 | 写入追溯码 |  |  | 2E A5 F5 | 6E A5 F5 | String | 20 |  |  |  |  |  | 2
21 | 写入钥匙参数 |  |  | 2E CF 0A 00 00 00 01 | 6E CF 0A | String | 20 |  |  |  |  |  | 2
22 | 写入ECU下线日期 |  |  | 2E F1 8B | 6E F1 8B | String | 20 |  |  |  |  |  | 2
23 | 写入模块配置 |  |  | 2E CF 08 | 6E CF 08 | String | 20 |  |  |  |  |  | 2
24 | 写入电源模式状态 |  |  | 2E A5 F7 00 | 6E A5 F7 | String | 20 |  |  |  |  |  | 2
25 | 进入10 01 |  |  | 10 01 | 50 01 | String | 20 |  |  |  |  |  | 2
26 | 软重启 |  |  | 11 01 | 51 01 | String | 20 |  |  |  |  |  | 0
27 | 检查A5F2 |  |  | 22 A5 F2 | 62 A5 F2 | Number | 20 | (16/16) |  |  |  | (0/1) | 2
28 | 获取软件版本号 |  |  | 22 F1 89 | 62 F1 89 | String | 20 | (9110400HA10001B50) |  |  |  | (0/17) | 2
29 | 获取硬件版本号 |  |  | 22 F1 7F | 62 F1 7F | String | 20 | (9110400HA10001H.F) |  |  |  | (0/17) | 2
30 | 获取小鹏零件号 |  |  | 22 F1 87 | 62 F1 87 | String | 20 | (9110400HA10001) |  |  |  | (0/14) | 2
31 | 获取PCBA码 |  |  | 22 F1 8C | 62 F1 8C | String | 20 | (){16/16} |  |  |  | (0/16) | 2
32 | 获取ECU下线日期 |  |  | 22 F1 8B | 62 F1 8B | NorString | 20 | (){4/8} |  |  |  | (0/4) | 2
33 | 获取追溯码 |  |  | 22 A5 F5 | 62 A5 F5 | String | 20 | (){24/24} |  |  |  | (0/24) | 2 | TStr2
34 | 获取钥匙参数 |  |  | 22 CF 0A | 62 CF 0A | Number | 20 | (0/65535) |  |  |  | (0/4) | 2
35 | 获取电源模式状态 |  |  | 22 A5 F7 | 62 A5 F7 | Number | 20 | (0/0) |  |  |  | (0/1) | 2
36 | 获取模块配置 |  |  | 22 CF 08 | 62 CF 08 | Number | 20 | (2/2) |  |  |  | (0/1) | 2
37 | 比较Str_输入SN_PCBA读取 |  |  |  |  | CString | 0 |  |  |  |  |  | 0 | Str1=Str2 |  |  |  | Str比较包含三种情况：1.Str1=Str2，表示两个Str相等；Str1>Str2，表示Str1包含或等于Str2；Str1<Str2，表示Str2包含或等于Str1。备注：测试项目命名只要保持前面“比较Str”5个字符串是一致即可。
38 | 比较Num_Num0_Num1 |  |  |  |  | CNumber | 0 | (-100/100) |  |  |  |  | 0 | (sqrt(Num0)*Num1)/(Num0-Num1) |  |  |  | Num比较可以使用任何labview支持的数学公式，比例sin、cos、abs、sqrt、（）等，但不支持位运算。数学公式中的输入参数可用global中的元素index表示，例如Num0表示Global中的index为0的参数，这里比较Num只会计算，不支持计算后再把结果赋予到Global。备注：测试项目命名只要保持前面“比较Num”5个字符串是一致即可。
39 | AI检测 | AI8 | T | 31 03 C0 84 | 71 03 C0 84 | Number | 200 | (0/14) |  |  |  | (0/2) | 2 | :x/1000
40 |  | AI24 |  |  |  | Number | 0 | (0/14) |  |  |  | (2/2) |  | :x/1000
41 |  | AI40 |  |  |  | Number | 0 | (0/14) |  |  |  | (4/2) |  | :x/1000
42 |  | AI56 |  |  |  | Number | 0 | (0/14) |  |  |  | (6/2) |  | :x/1000
43 |  | AI72 |  |  |  | Number | 0 | (0/14) |  |  |  | (8/2) |  | :x/1000
44 |  | AI88 |  |  |  | Number | 0 | (0/14) |  |  |  | (10/2) |  | :x/1000
45 |  | AI104 |  |  |  | Number | 0 | (0/14) |  |  |  | (12/2) |  | :x/1000
46 |  | AI120 |  |  |  | Number | 0 | (0/14) |  |  |  | (14/2) |  | :x/1000
47 |  | AI136 |  |  |  | Number | 0 | (0/14) |  |  |  | (16/2) |  | :x/1000
48 |  | AI152 |  |  |  | Number | 0 | (0/14) |  |  |  | (18/2) |  | :x/1000
49 |  | AI168 |  |  |  | Number | 0 | (0/14) |  |  |  | (20/2) |  | :x/1000
50 |  | AI184 |  |  |  | Number | 0 | (0/14) |  |  |  | (22/2) |  | :x/1000
51 |  | AI200 |  |  |  | Number | 0 | (0/14) |  |  |  | (24/2) |  | :x/1000
52 |  | AI216 |  |  |  | Number | 0 | (0/14) |  |  |  | (26/2) |  | :x/1000
53 |  | AI232 |  |  |  | Number | 0 | (0/14) |  |  |  | (28/2) |  | :x/1000
54 |  | AI248 |  |  |  | Number | 0 | (0/14) |  |  |  | (30/2) |  | :x/1000
55 |  | AI264 |  |  |  | Number | 0 | (0/14) |  |  |  | (32/2) |  | :x/1000
56 |  | AI280 |  |  |  | Number | 0 | (0/14) |  |  |  | (34/2) |  | :x/1000
57 |  | AI296 |  |  |  | Number | 0 | (0/14) |  |  |  | (36/2) |  | :x/1000
58 |  | AI312 |  |  |  | Number | 0 | (0/14) |  |  |  | (38/2) |  | :x/1000
59 |  | AI328 |  |  |  | Number | 0 | (0/14) |  |  |  | (40/2) |  | :x/1000
60 |  | AI344 |  |  |  | Number | 0 | (0/14) |  |  |  | (42/2) |  | :x/1000
61 |  | AI360 |  |  |  | Number | 0 | (0/14) |  |  |  | (44/2) |  | :x/1000
62 |  | AI376 |  |  |  | Number | 0 | (0/14) |  |  |  | (46/2) |  | :x/1000
63 |  | AI392 |  |  |  | Number | 0 | (0/14) |  |  |  | (48/2) |  | :x/1000
64 |  | AI408 |  |  |  | Number | 0 | (0/14) |  |  |  | (50/2) |  | :x/1000
65 |  | AI424 |  |  |  | Number | 0 | (0/14) |  |  |  | (52/2) |  | :x/1000
66 |  | AI440 |  |  |  | Number | 0 | (0/14) |  |  |  | (54/2) |  | :x/1000
67 |  | AI456 |  |  |  | Number | 0 | (0/14) |  |  |  | (56/2) |  | :x/1000
68 |  | AI472 |  |  |  | Number | 0 | (0/14) |  |  |  | (58/2) |  | :x/1000
69 |  | AI488 |  |  |  | Number | 0 | (0/14) |  |  |  | (60/2) |  | :x/1000
70 |  | AI504 |  |  |  | Number | 0 | (0/14) |  |  |  | (62/2) |  | :x/1000
71 |  | AI520 |  |  |  | Number | 0 | (0/14) |  |  |  | (64/2) |  | :x/1000
72 |  | AI536 |  |  |  | Number | 0 | (0/14) |  |  |  | (66/2) |  | :x/1000
73 |  | AI552 |  |  |  | Number | 0 | (0/14) |  |  |  | (68/2) |  | :x/1000
74 |  | AI568 |  |  |  | Number | 0 | (0/14) |  |  |  | (70/2) |  | :x/1000
75 |  | AI584 |  |  |  | Number | 0 | (0/14) |  |  |  | (72/2) |  | :x/1000
76 |  | AI600 |  |  |  | Number | 0 | (0/14) |  |  |  | (74/2) |  | :x/1000
77 |  | AI616 |  |  |  | Number | 0 | (0/14) |  |  |  | (76/2) |  | :x/1000
78 |  | AI632 |  |  |  | Number | 0 | (0/14) |  |  |  | (78/2) |  | :x/1000
79 |  | AI648 |  |  |  | Number | 0 | (0/14) |  |  |  | (80/2) |  | :x/1000
80 |  | AI664 |  |  |  | Number | 0 | (0/14) |  |  |  | (82/2) |  | :x/1000
81 |  | AI680 |  |  |  | Number | 0 | (0/14) |  |  |  | (84/2) |  | :x/1000
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
498 | 开启LIN |  |  | 31 01 C0 8A 08 | 71 01 C0 8A | String | 20 |  |  |  |  |  | 2
499 | 读取LIN结果 |  |  | 31 03 C0 8A | 71 03 C0 8A | Number | 20 | () |  |  |  | (0/1) | 2
500 | 配置天线 |  |  | 31 01 C0 8F 01 | 71 01 C0 8F | String | 20 |  |  |  |  |  | 2
501 | 低频测试_场强 | 读取IMMO天线低频测试场强 |  | 31 03 C0 8F | 71 03 C0 8F | Number | 200 | (300/3200) |  |  |  | (1/2) | 2 | :x/1000
502 |  | 读取行李箱内天线低频测试场强 |  |  |  | Number | 0 | (300/3200) |  |  |  | (3/2) |  | :x/1000
503 |  | 读取后保天线低频测试场强 |  |  |  | Number | 0 | (300/3200) |  |  |  | (5/2) |  | :x/1000
504 |  | 读取扫描钥匙结果 |  |  |  | Number | 0 | (1/1) |  |  |  | (0/1) |  | :x/1000
505 | 进入10 01 |  |  | 10 01 | 50 01 | String | 20 |  |  |  |  |  | 2
506 | 970004故障查询 | Bit0 |  | 19 04 97 00 04 FF | 59 04 97 00 04 | Number | 20 | (0/0) |  |  |  | (0/0.125) | 2
507 |  | Bit3 |  |  |  | Number |  | (0/0) |  |  |  | (0.375/0.125) | 2
508 | 970104故障查询 | Bit0 |  | 19 04 97 01 04 FF | 59 04 97 01 04 | Number | 20 | (0/0) |  |  |  | (0/0.125) | 2
509 |  | Bit3 |  |  |  | Number |  | (0/0) |  |  |  | (0.375/0.125) | 2
510 | 进入10 01 |  |  | 10 01 | 50 01 | String | 20 |  |  |  |  |  | 2
511 | 电源关闭 |  |  |  | 66 66 66 01 | String | 0 |  |  |  |  |  | 0 |  | VISA0

Sheet: config
[项目配置]
RequestID | 7E0
ResponseID | 7E8
PN | 9110400HA10001
ModuleID | 2
[CAN通用配置]
CAN卡型号 | USBCANFD-200U
索引 | 0
通道 | 0
CAN协议 | 1
数据域波特率 | 2000000
仲裁域波特率 | 500000
[VISA_Port]
DC_Power
PowerMeter
Eload
Backup1
Backup2
Backup3

Sheet: Sheet1
A1 |  | DI |  |  | PI |  | number | name | DO |  | MO |  |  | L_PO(30%) |  | L_PO(70%)
0 | (0/2) | 0 | 0 | (0/0.125) | 8 | PI8_Freq | 1 | PI8_Freq | 0 | 31 01 C0 81 01 00 00 00 00 00 00 00 00 00 00 00 | 0 | 1 | 31 01 C0 85 01 00 00 00 00 00 00 00 | 8 | 31 01 C0 83 00 64 1E 00 00 00 00 00 00 00 00 00 00 00 00 00 00 00 00 00 00 00 00 00 00 00 00 00 00 00 00 00 00 00 00 00 00 00 00 00 00 00 00 00 00 00 00 00 00 00 00 00 00 00 00 00 00 00 00 00 00 00 00 00 00 00 00 00 00 00 | 8 | 31 01 C0 83 00 64 46 00 00 00 00 00 00 00 00 00 00 00 00 00 00 00 00 00 00 00 00 00 00 00 00 00 00 00 00 00 00 00 00 00 00 00 00 00 00 00 00 00 00 00 00 00 00 00 00 00 00 00 00 00 00 00 00 00 00 00 00 00 00 00 00 00 00 00
2 | (2/2) | 1 | 0.125 | (0.125/0.125) | 24 | PI24_Freq | 2 | PI8_Duty | 1 | 31 01 C0 81 02 00 00 00 00 00 00 00 00 00 00 00 |  | 2 | 31 01 C0 85 02 00 00 00 00 00 00 00 | 24 |  | 24
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
192 | (192/2)
194 | (194/2)
196 | (196/2)
198 | (198/2)
200 | (200/2)
202 | (202/2)
204 | (204/2)
206 | (206/2)
208 | (208/2)
210 | (210/2)
212 | (212/2)
214 | (214/2)
216 | (216/2)
218 | (218/2)
192 | (192/2)
193 | (193/2)
194 | (194/2)
195 | (195/2)
196 | (196/2)
197 | (197/2)
198 | (198/2)
199 | (199/2)
200 | (200/2)
201 | (201/2)
202 | (202/2)
203 | (203/2)
204 | (204/2)
205 | (205/2)
206 | (206/2)
207 | (207/2)
208 | (208/2)
209 | (209/2)
210 | (210/2)
211 | (211/2)
212 | (212/2)
213 | (213/2)
214 | (214/2)
215 | (215/2)
216 | (216/2)
217 | (217/2)
218 | (218/2)
219 | (219/2)
220 | (220/2)

Sheet: Sheet2
Q | W | E | T | Y | PO_ | _30% | _70%
1 | 0 | PO_0_30% | T | 31 01 C0 83 00 64 1E 00 00 00 00 00 00 00 00 00 00 00 00 00 00 00 00 00 00 00 00 00 00 00 00 00 00 00 00 00 00 00 00 00 00 00 00 00 00 00 00 00 00 00 00 00 00 00 00 00 00 00 00 00 00 00 00 00 00 00 00 00 00 00 00 00 00 00
2 | 0 | PO_0_70% | T | 31 01 C0 83 00 64 46 00 00 00 00 00 00 00 00 00 00 00 00 00 00 00 00 00 00 00 00 00 00 00 00 00 00 00 00 00 00 00 00 00 00 00 00 00 00 00 00 00 00 00 00 00 00 00 00 00 00 00 00 00 00 00 00 00 00 00 00 00 00 00 00 00 00 00
3 | 1 | PO_1_30% | T | 31 01 C0 83 00 00 00 00 64 1E 00 00 00 00 00 00 00 00 00 00 00 00 00 00 00 00 00 00 00 00 00 00 00 00 00 00 00 00 00 00 00 00 00 00 00 00 00 00 00 00 00 00 00 00 00 00 00 00 00 00 00 00 00 00 00 00 00 00 00 00 00 00 00 00
4 | 1 | PO_1_70% | T | 31 01 C0 83 00 00 00 00 64 46 00 00 00 00 00 00 00 00 00 00 00 00 00 00 00 00 00 00 00 00 00 00 00 00 00 00 00 00 00 00 00 00 00 00 00 00 00 00 00 00 00 00 00 00 00 00 00 00 00 00 00 00 00 00 00 00 00 00 00 00 00 00 00 00
5 | 2 | PO_2_30% | T | 31 01 C0 83 00 00 00 00 00 00 00 64 1E 00 00 00 00 00 00 00 00 00 00 00 00 00 00 00 00 00 00 00 00 00 00 00 00 00 00 00 00 00 00 00 00 00 00 00 00 00 00 00 00 00 00 00 00 00 00 00 00 00 00 00 00 00 00 00 00 00 00 00 00 00
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
46 | 22 | PO_22_70% | T | 31 01 C0 83 00 00 00 00 00 00 00 00 00 00 00 00 00 00 00 00 00 00 00 00 00 00 00 00 00 00 00 00 00 00 00 00 00 00 00 00 00 00 00 00 00 00 00 00 00 00 00 00 00 00 00 00 00 00 00 00 00 00 00 00 00 00 00 00 00 00 00 64 46 00
