Fred-Guo0422/H93_LDCU_EOL_TESTER/document/New folder/负载箱图纸/H93-LRCU-L-LoadBox-Wiringdrawing-20230323.pdf

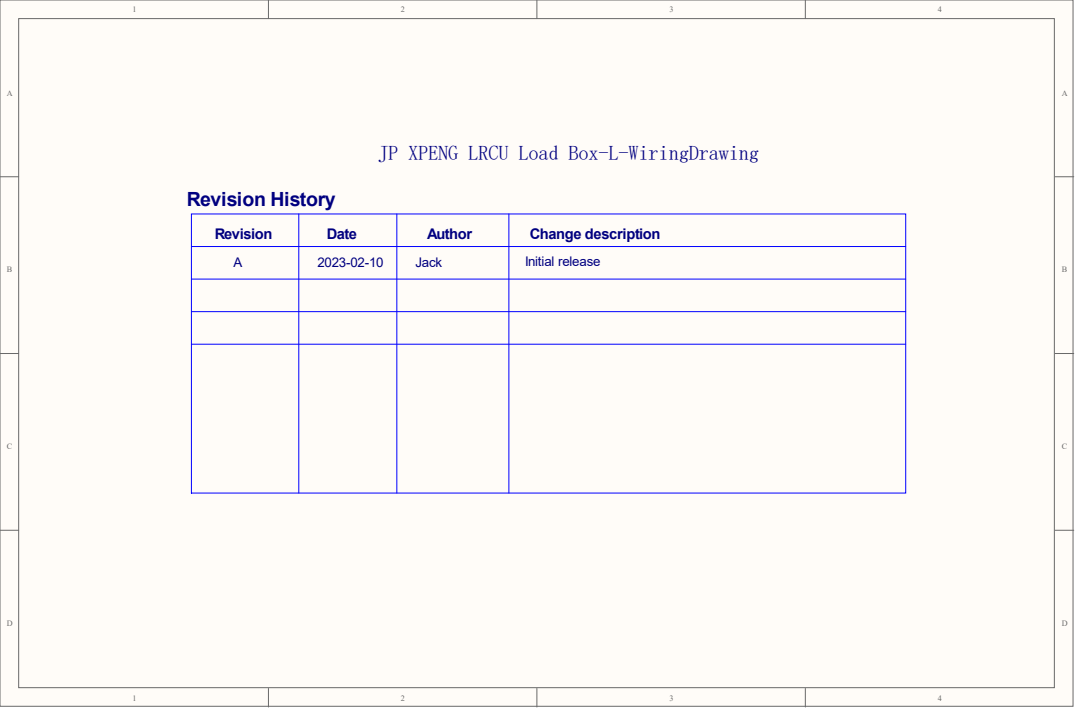
[picture p12: page 1]

JP XPENG LRCU Load Box-L-WiringDrawing

Revision | Date | Author | Change description

A | 2023-02-10 | Jack | Initial release

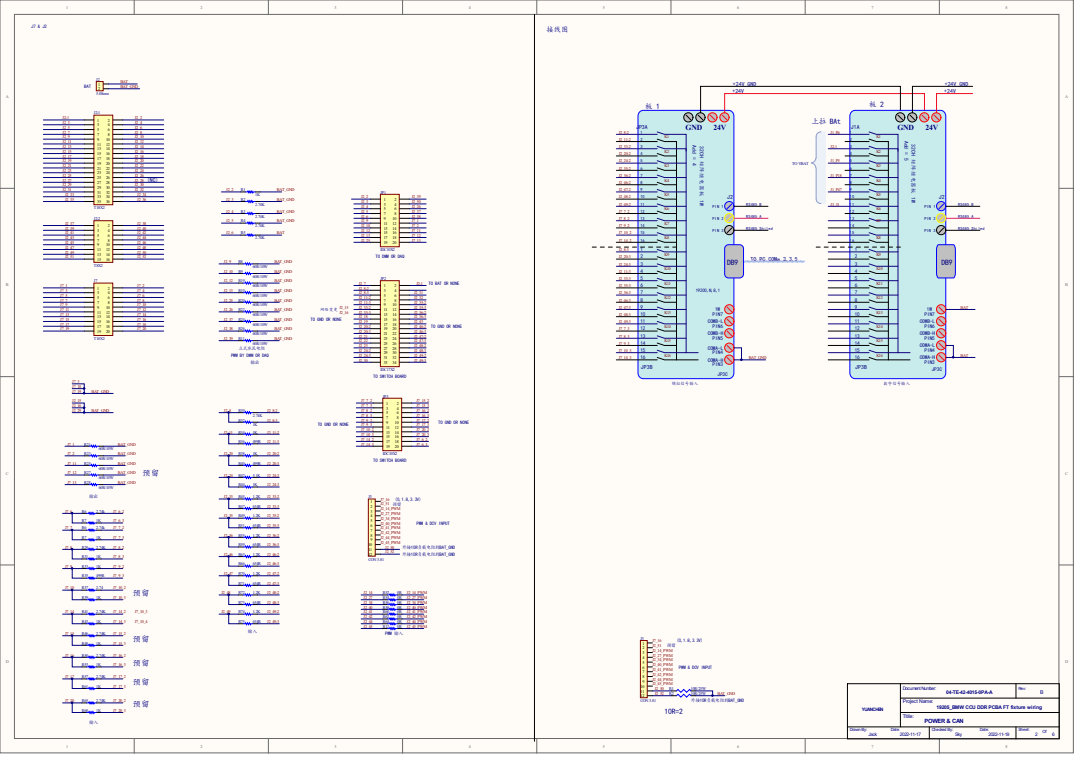
[picture p13: page 2]

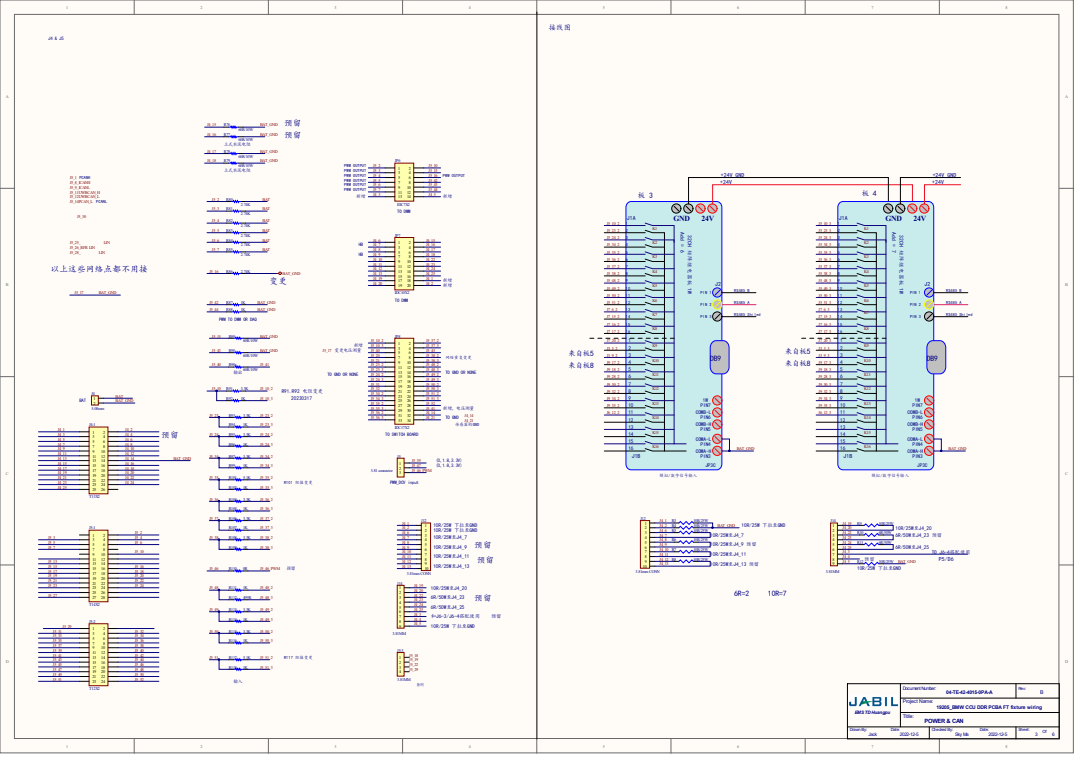
[picture p14: page 3]

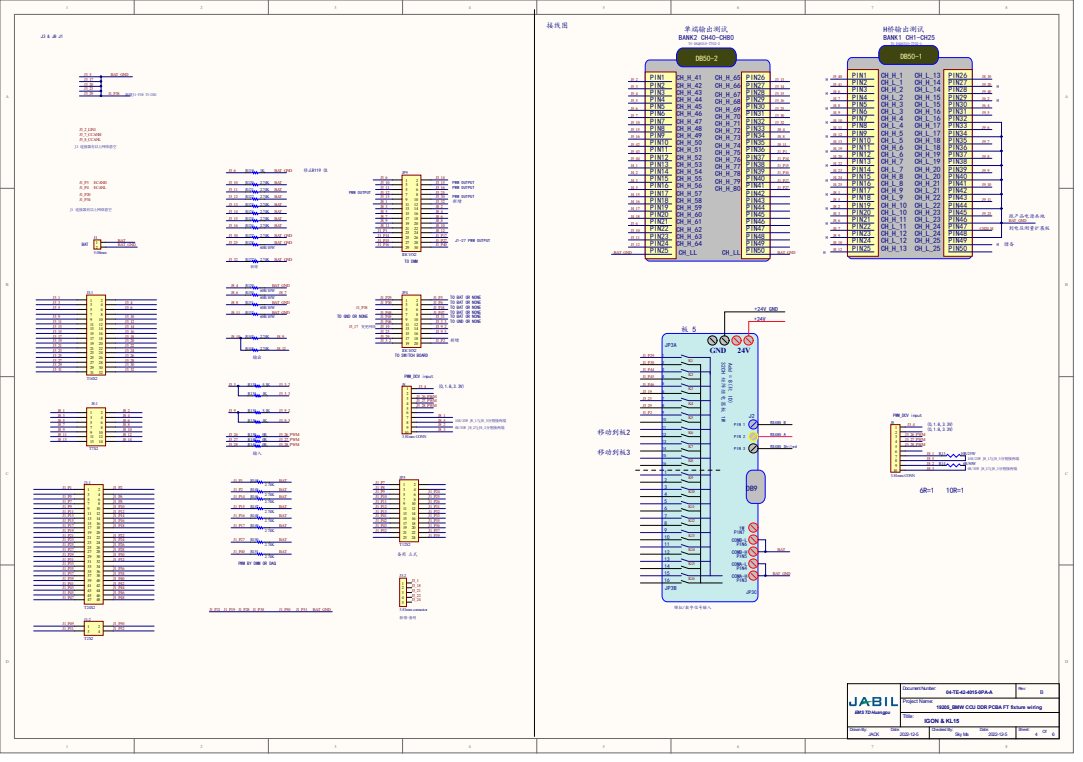
[picture p15: page 4]

_5 _2 _2 _2 新 增 -_2_LIN _7_C CANH _8_C CANL 接 器 有 以上 网 络 悬 空 R 1 JP 9 R 1 R 1 J 3 -1 R 1 | | 试 H | G N D | 桥输 K T O Q P W M J

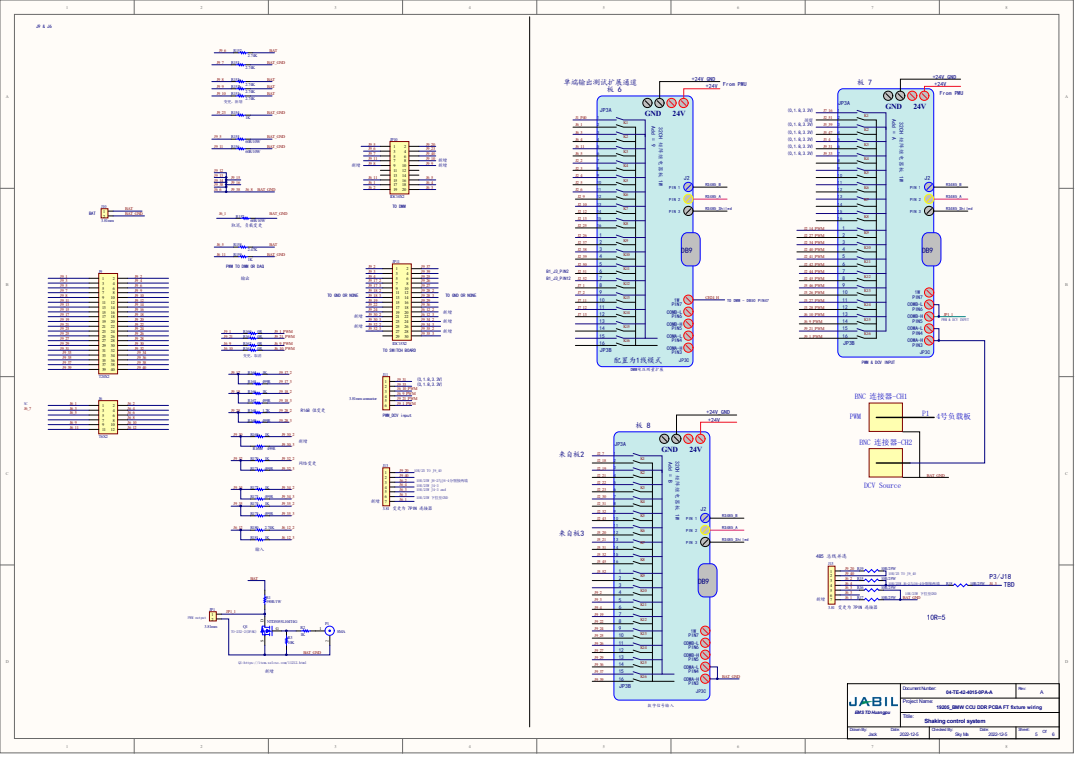
[picture p16: page 5]

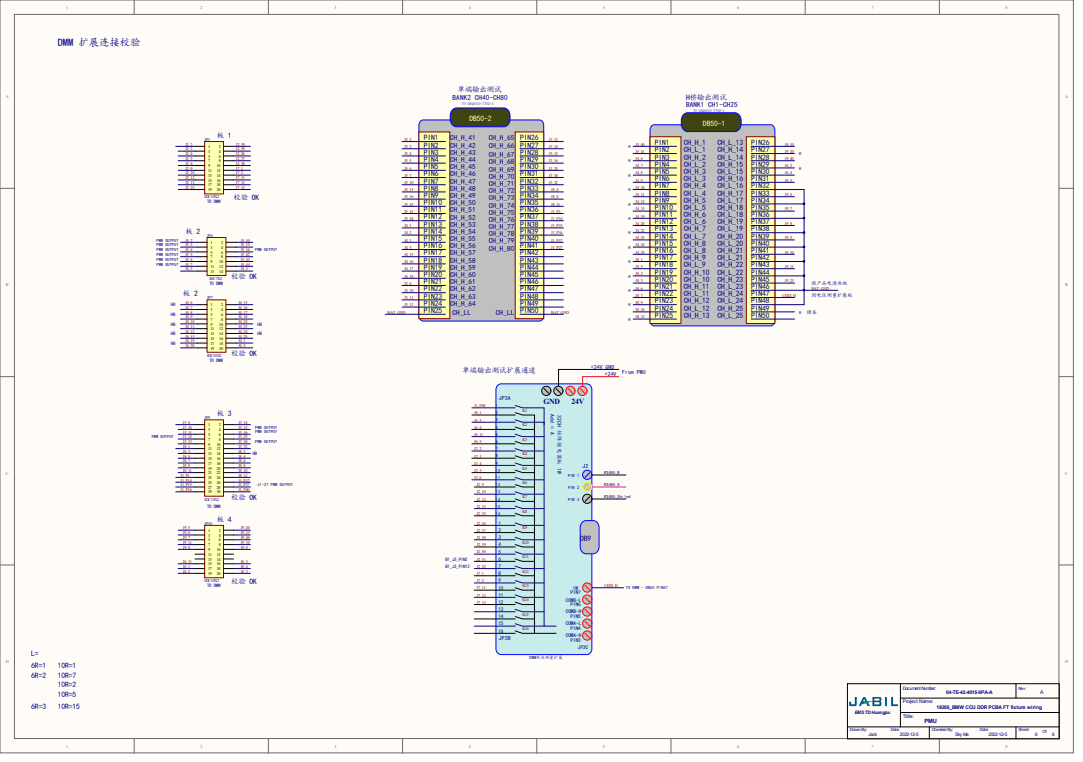
[picture p17: page 6]

19205_BMW CCU DDR PCBA FT fixture wiring
