Fred-Guo0422/H93_LDCU_EOL_TESTER/document/New folder/负载箱图纸/H93-LRCU-R-Loadbox-wiringdrawing 20230324.pdf

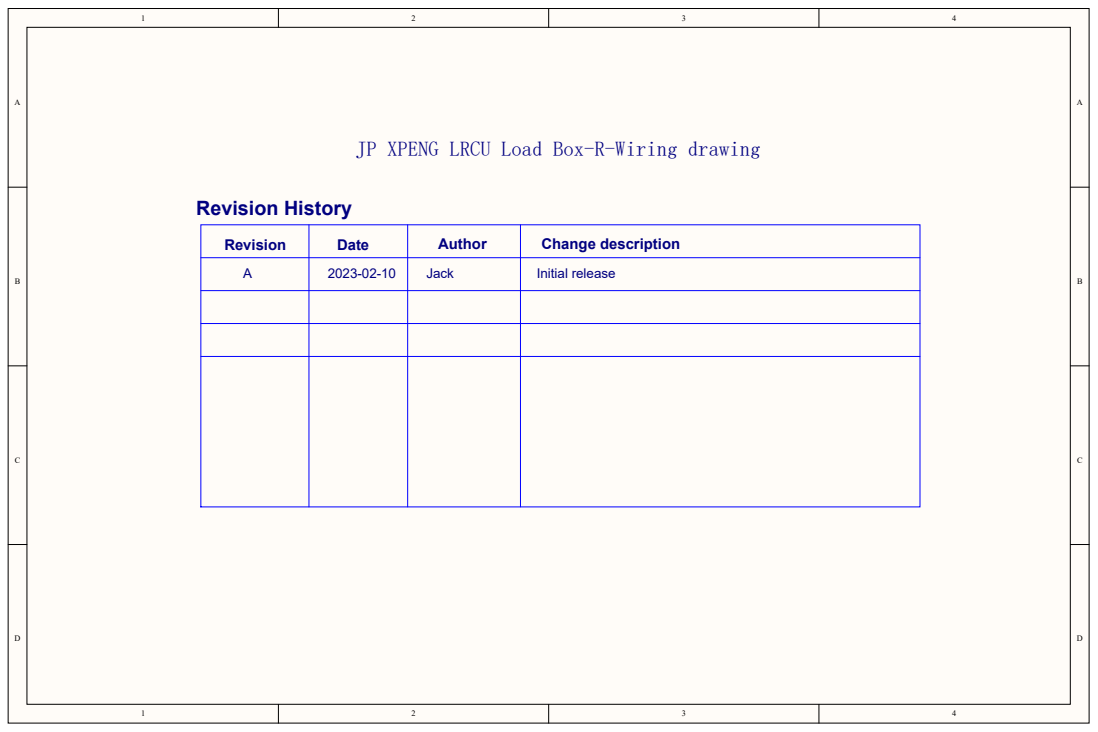
[picture p18: page 1]

JP XPENG LRCU Load Box-R-Wiring drawing

Revision | Date | Author | Change description

A | 2023-02-10 | Jack | Initial release

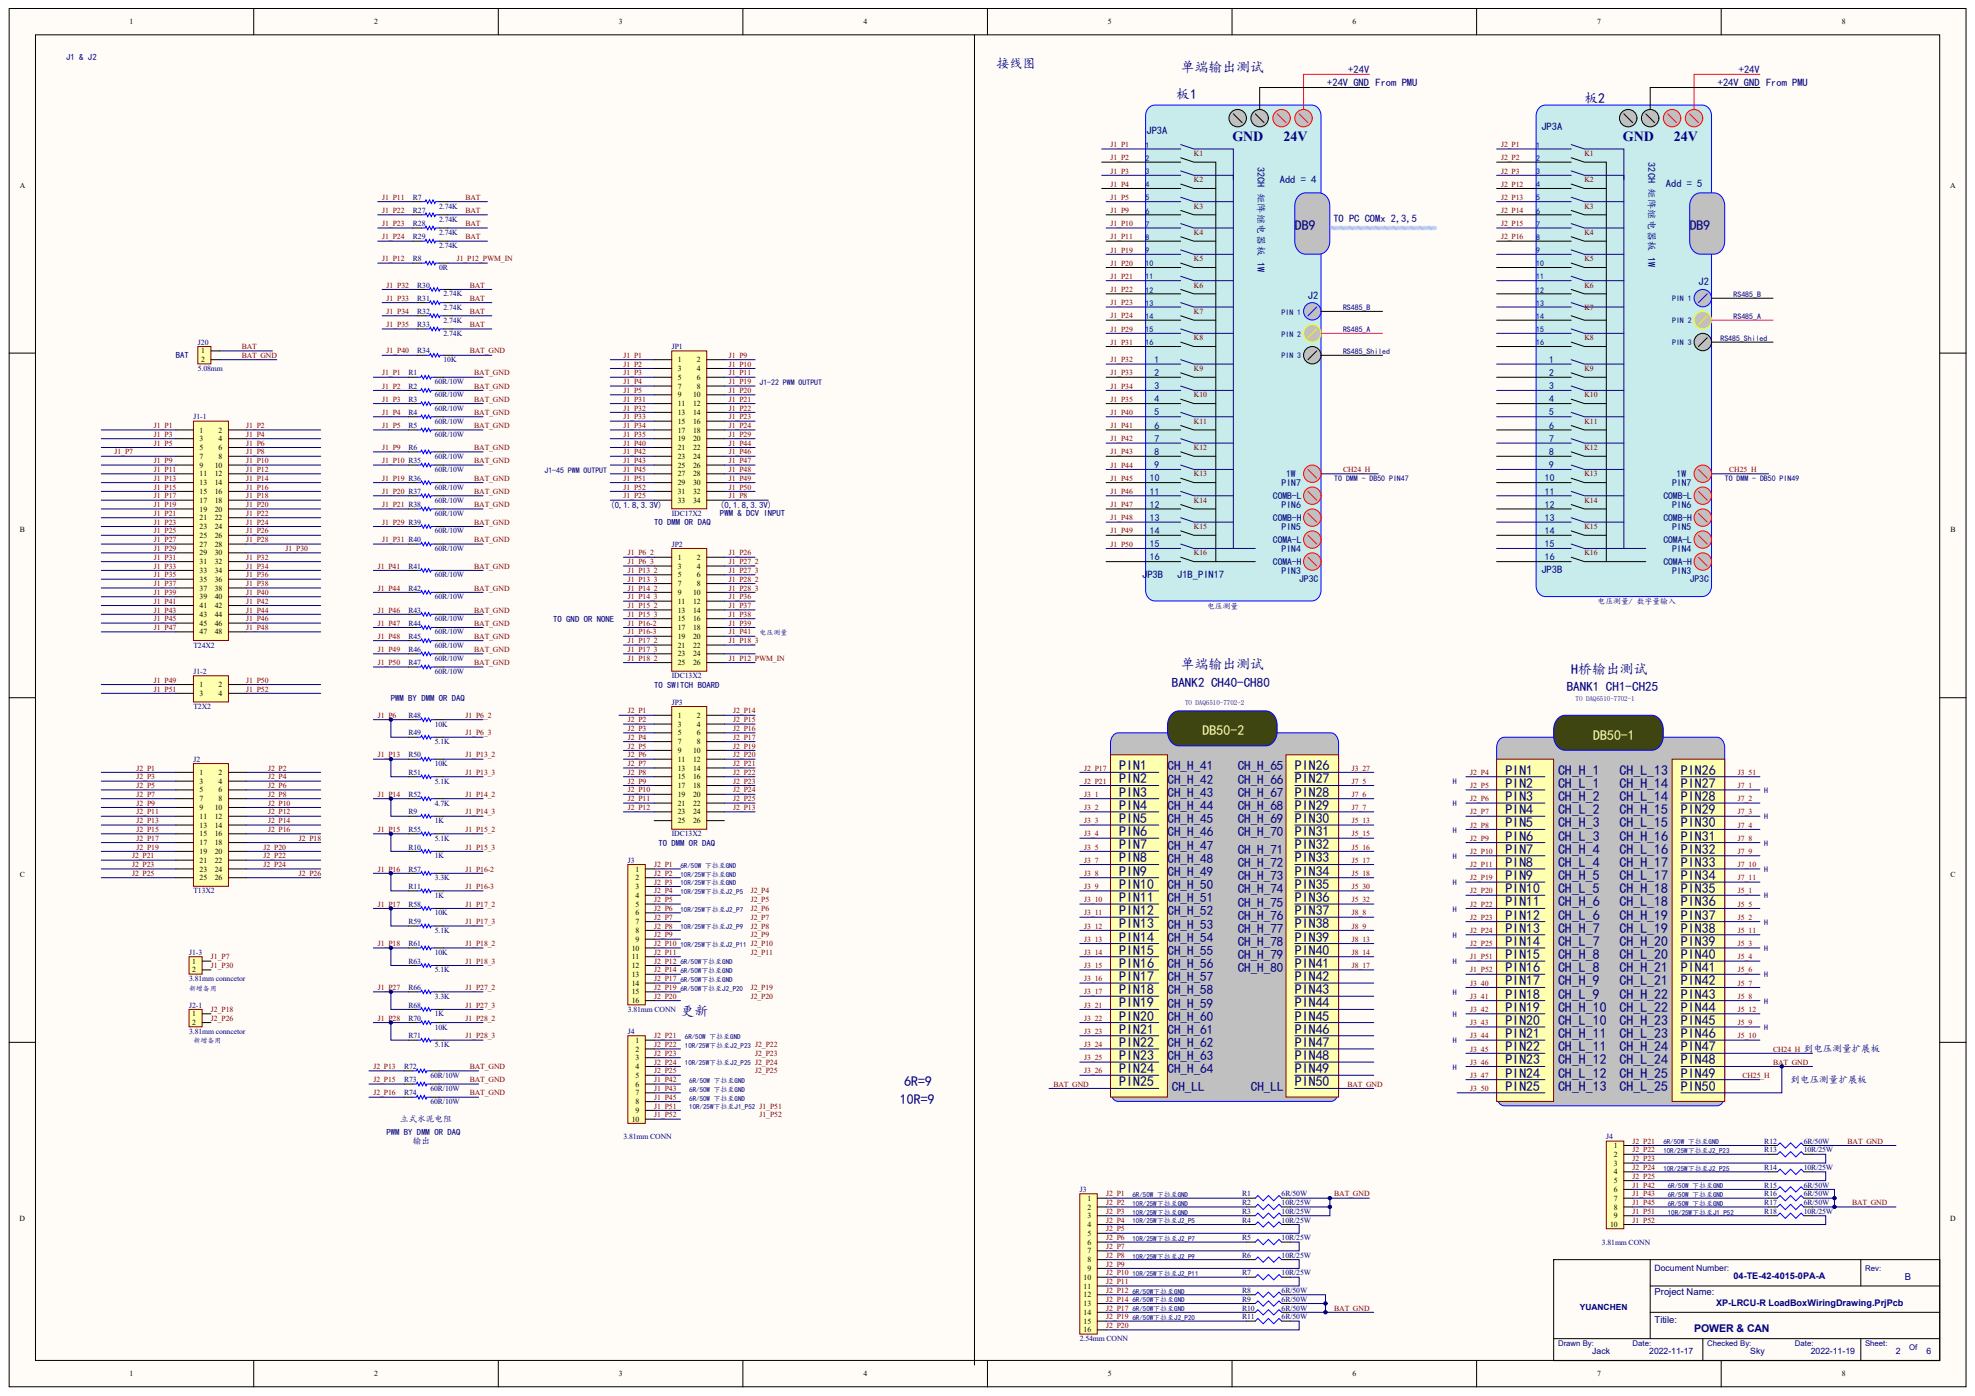
[picture p19: page 2]

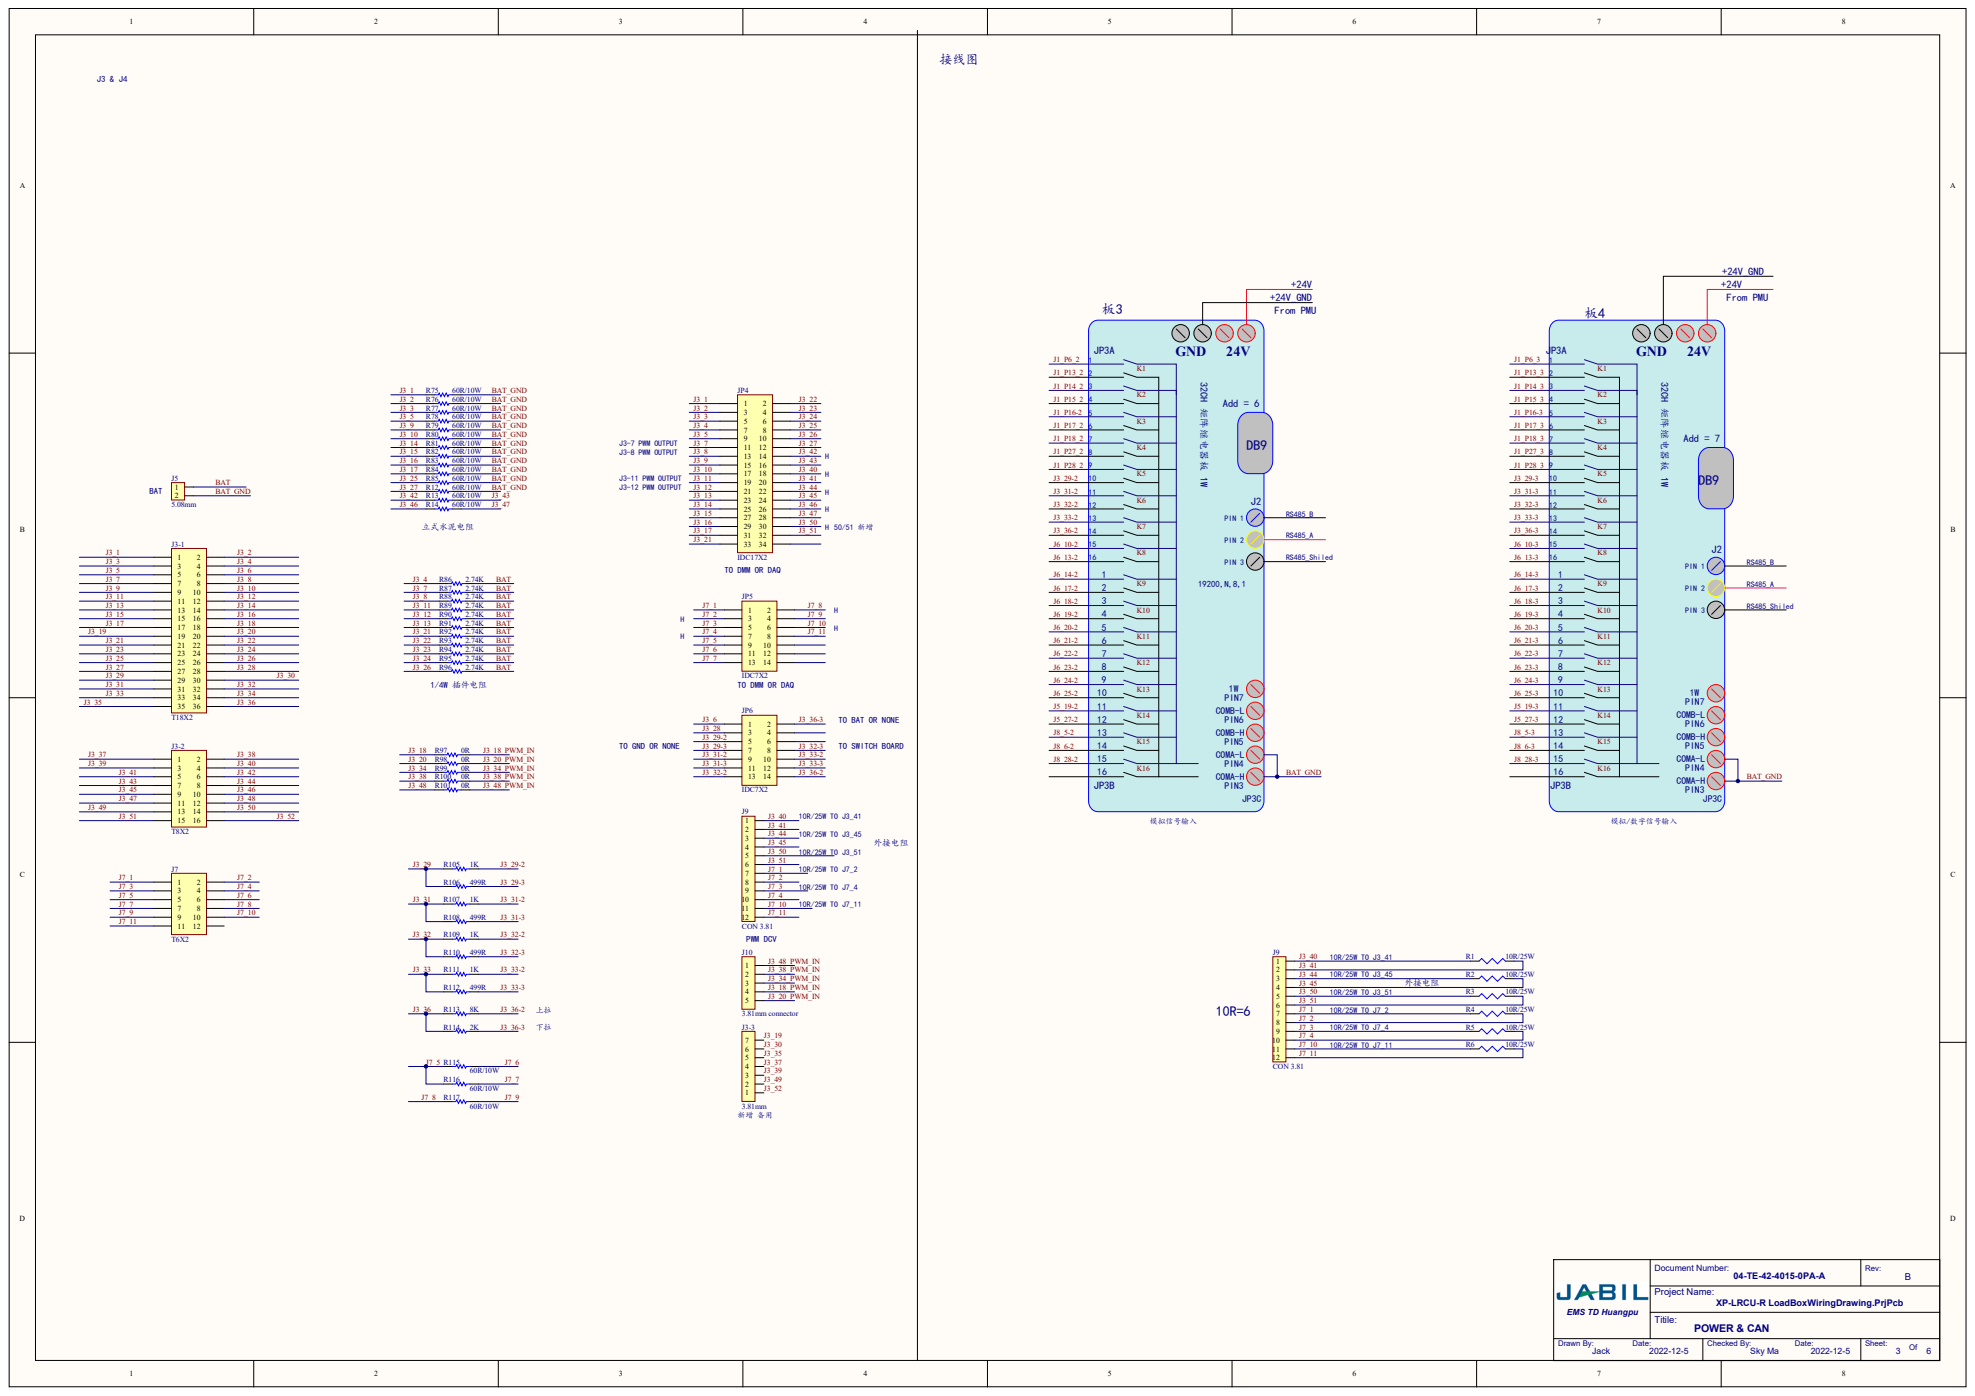
[picture p20: page 3]

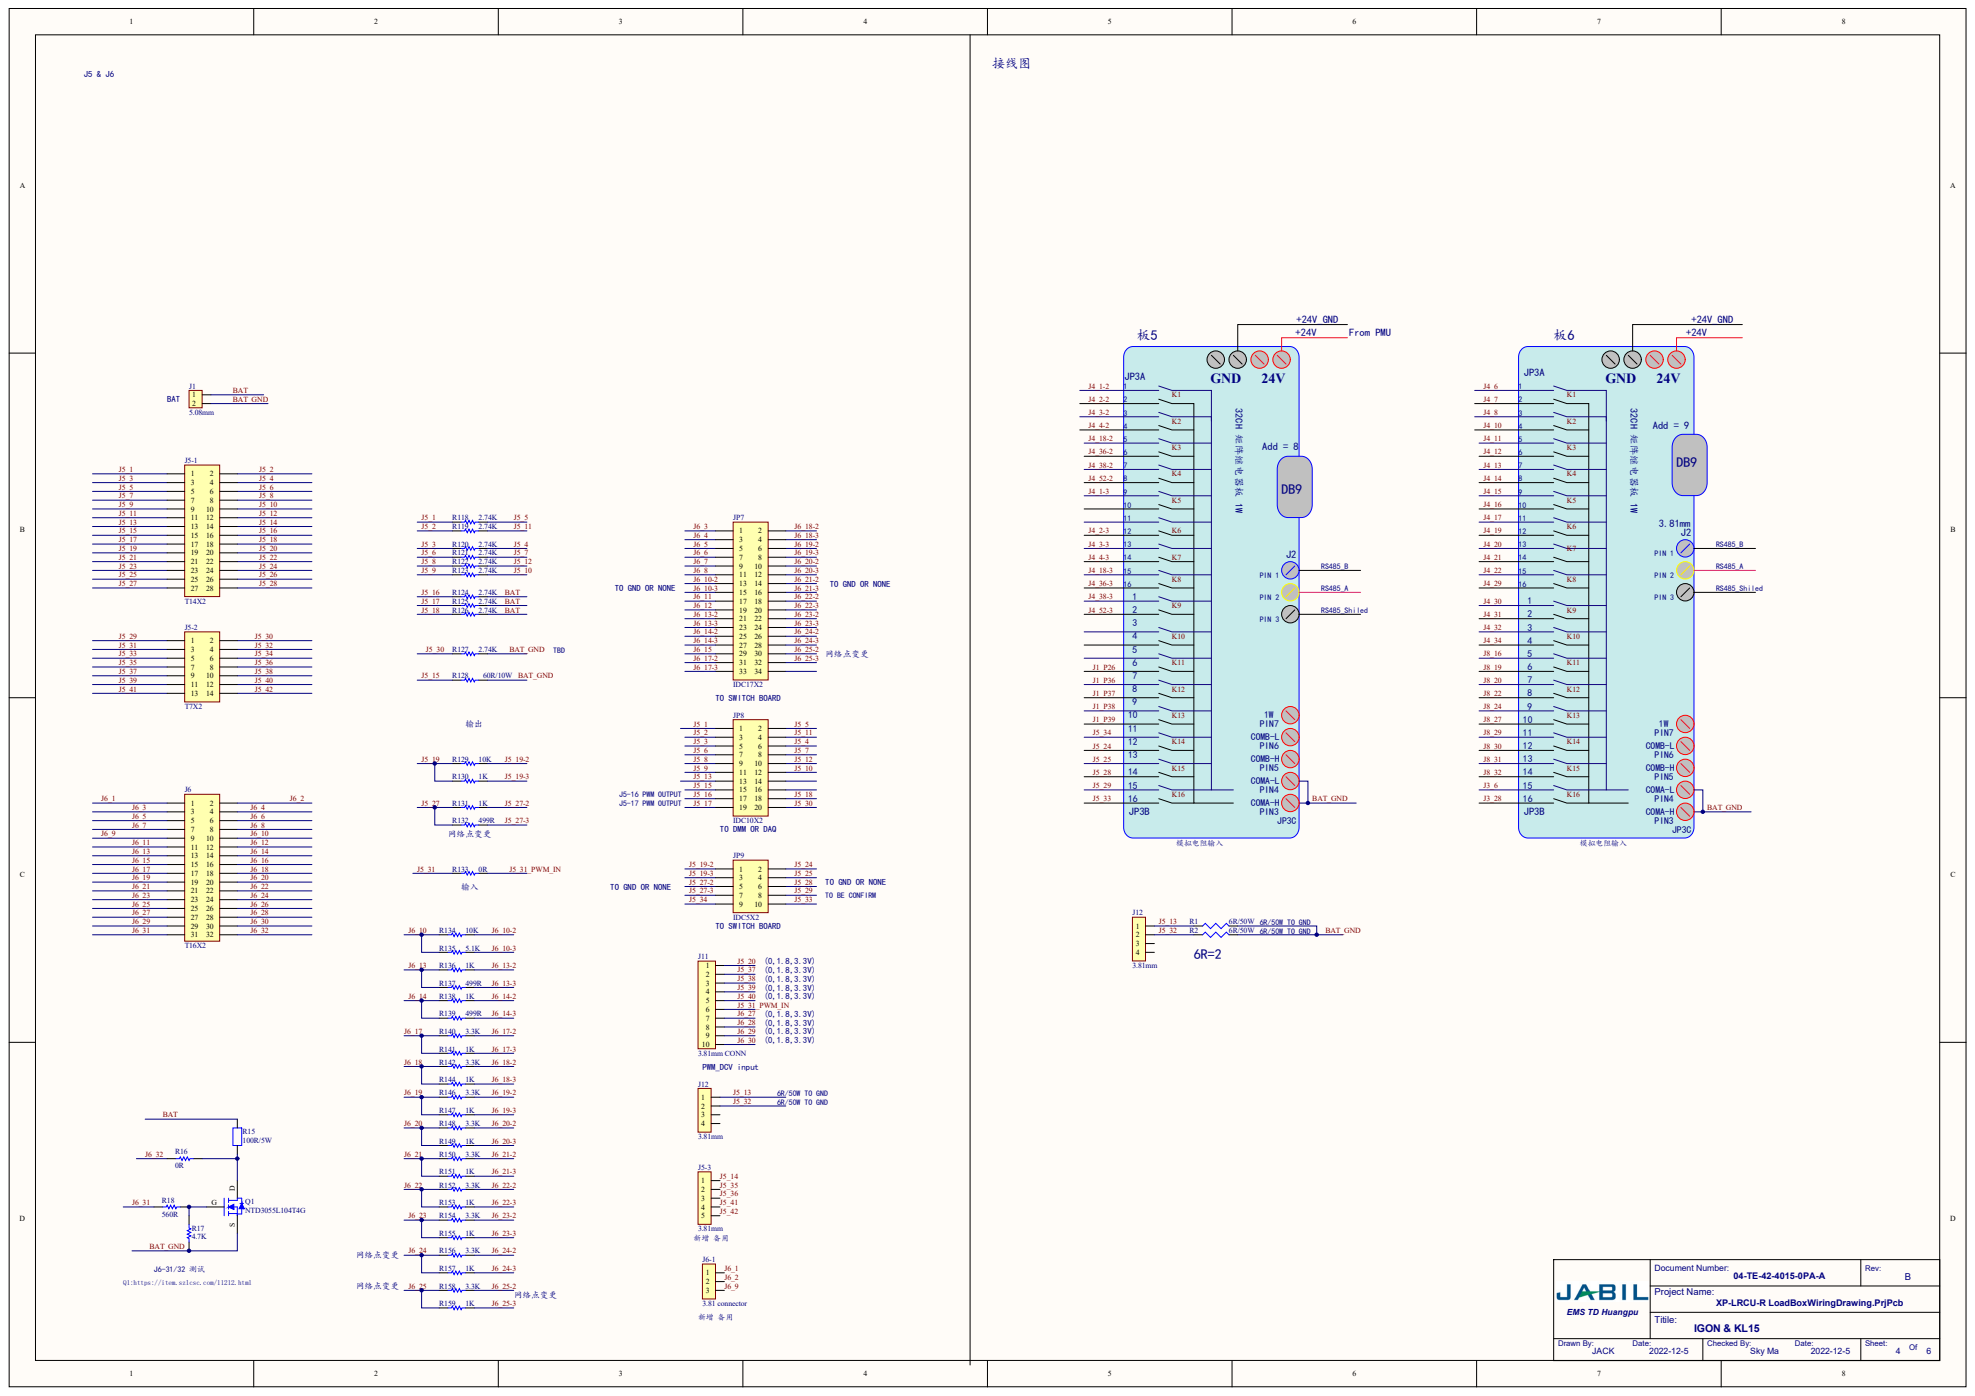
[picture p21: page 4]

Q1:https://item.szlcsc.com/11212.html

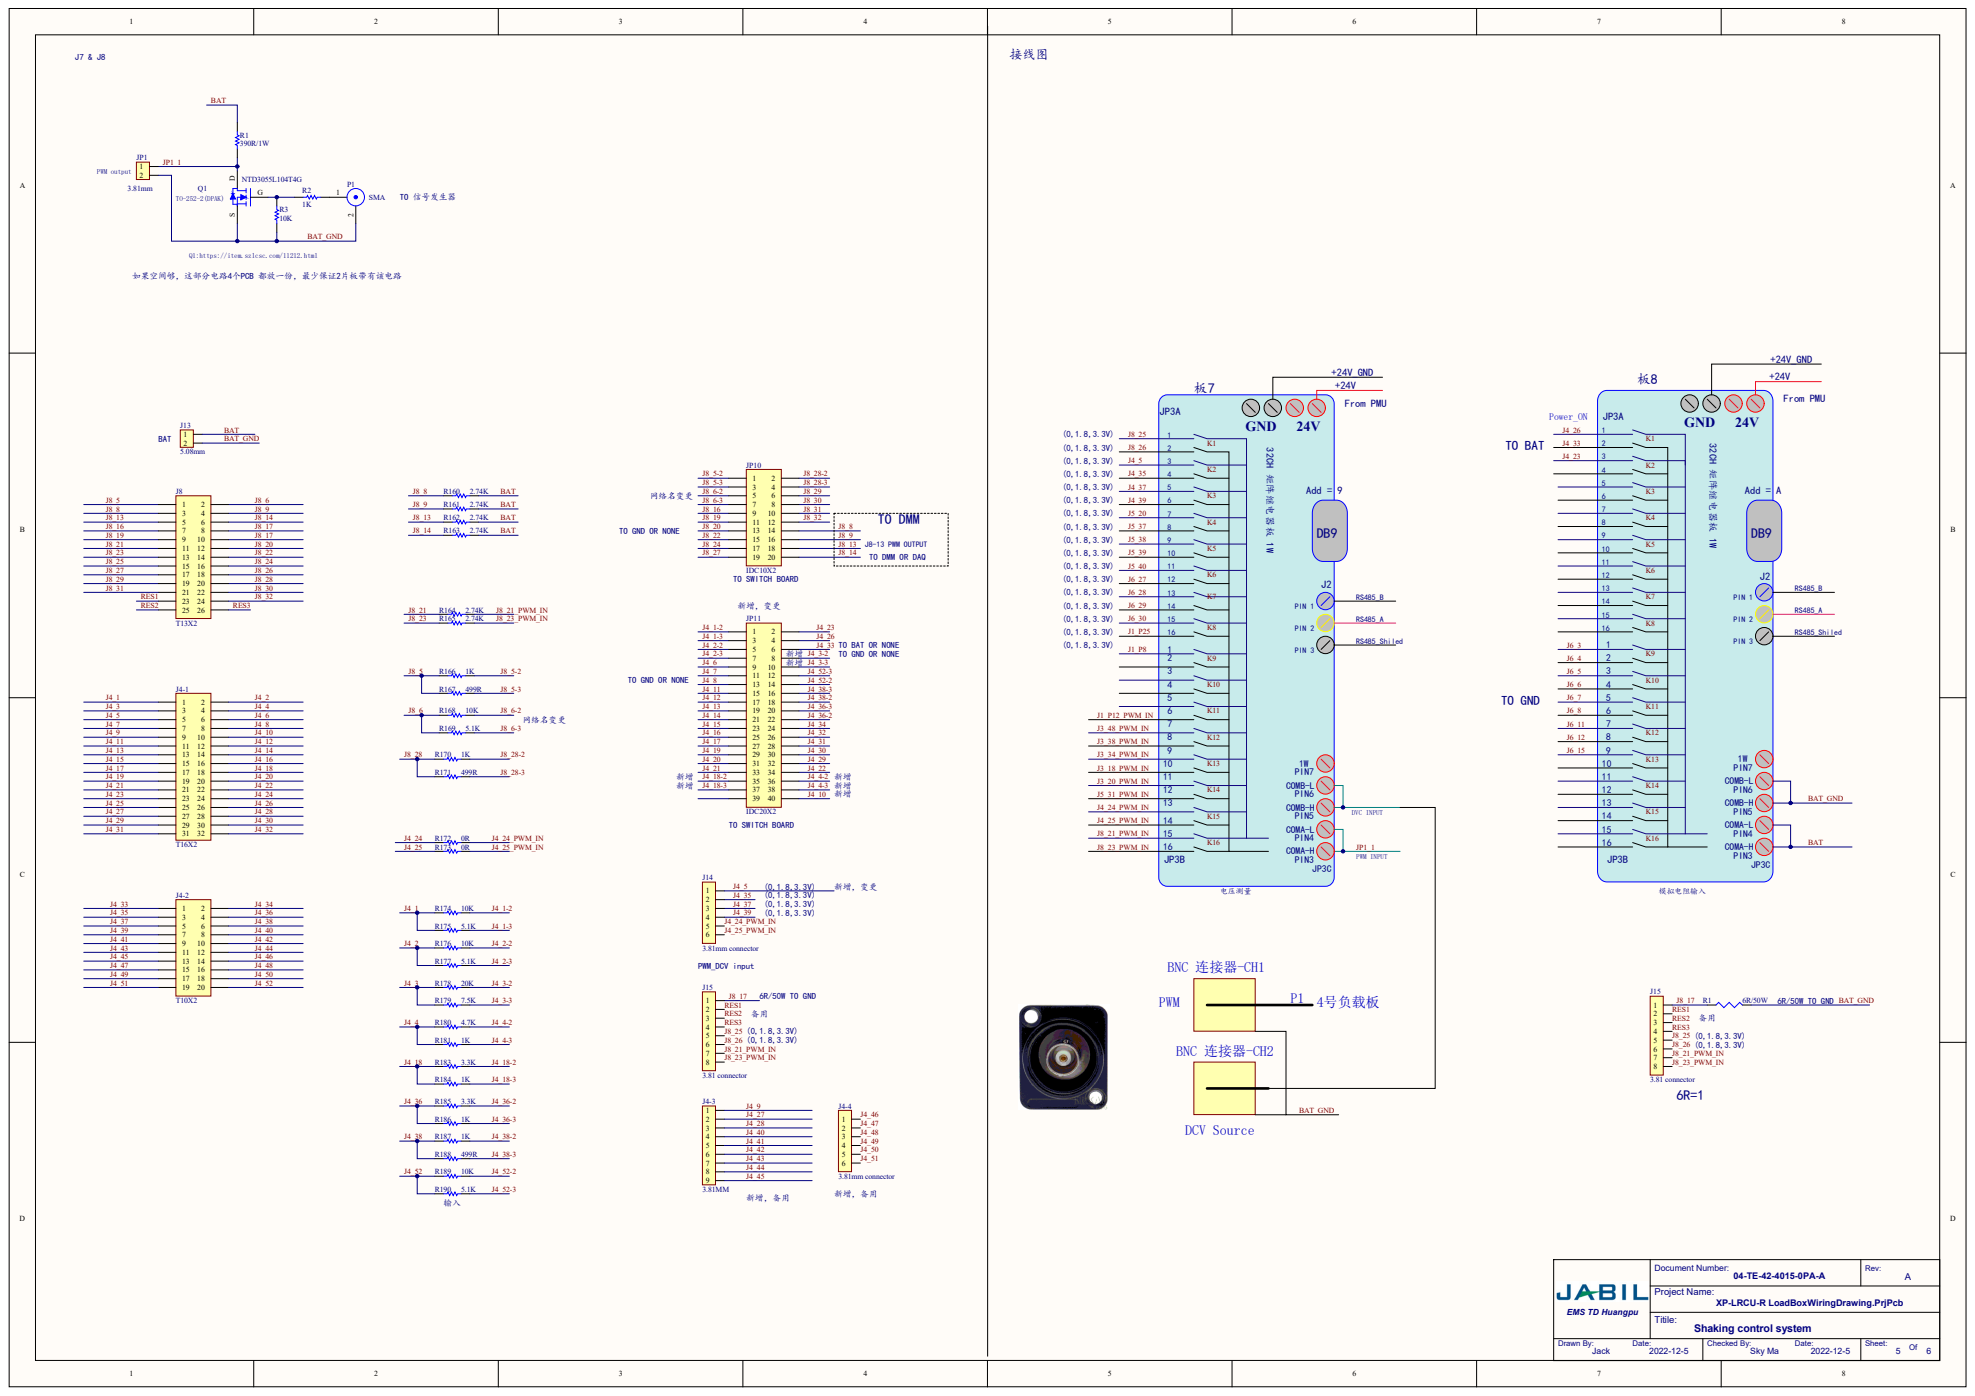
[picture p22: page 5]

Q1:https://item.szlcsc.com/11212.html

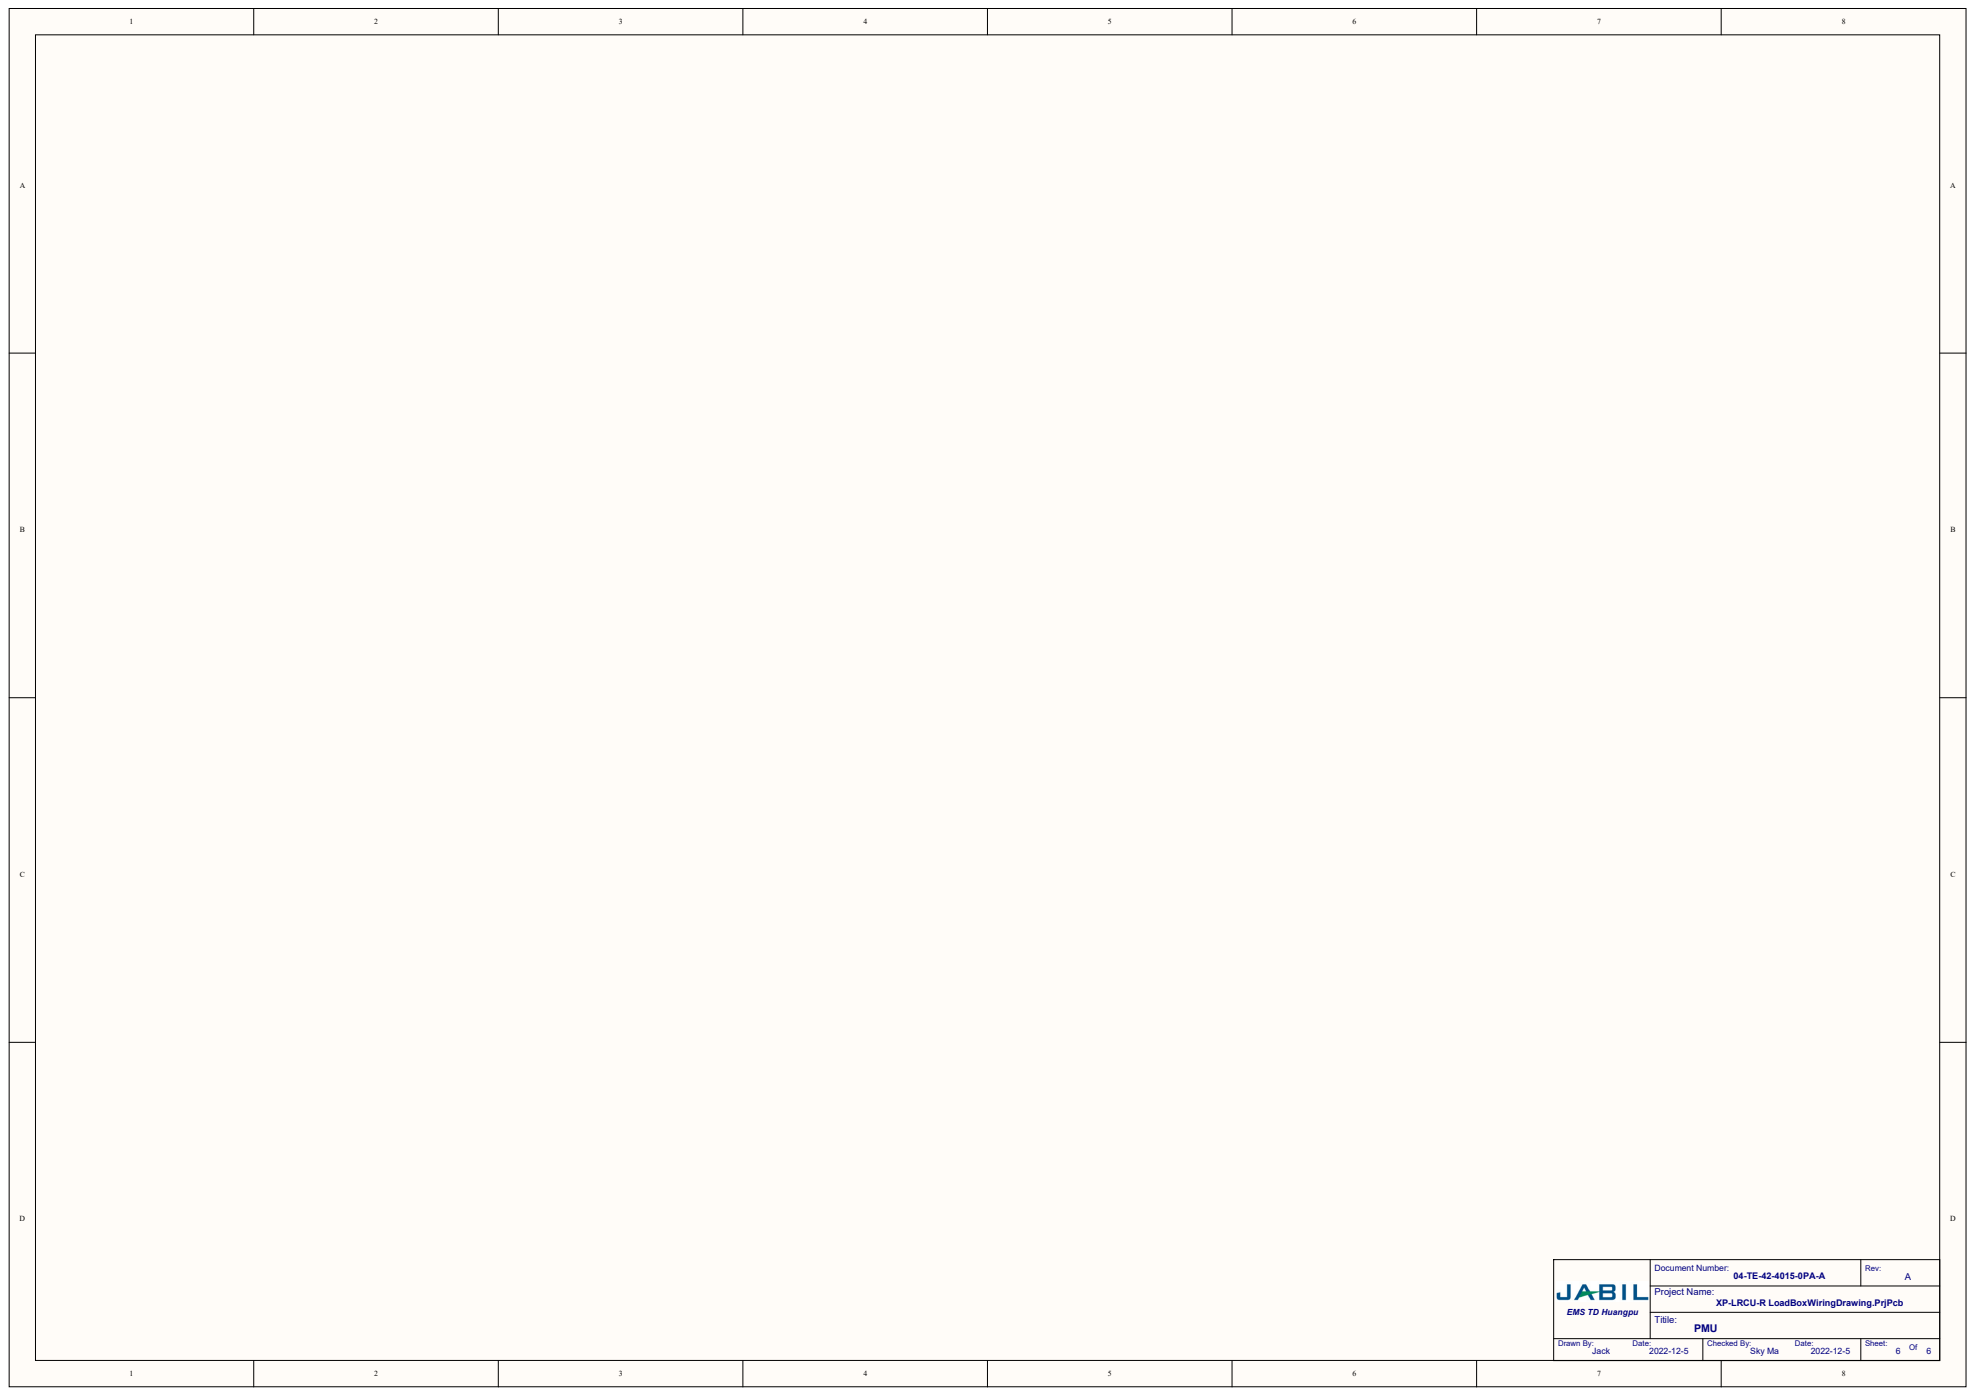
[picture p23: page 6]

XP-LRCU-R LoadBoxWiringDrawing.PrjPcb
