Fred-Guo0422/H93_LDCU_EOL_TESTER/document/H93_LDCU/LoadBox-L-wiring drawing/LoadBox-L-wiring drawing/L-06-HI_Load switch 230413.pdf

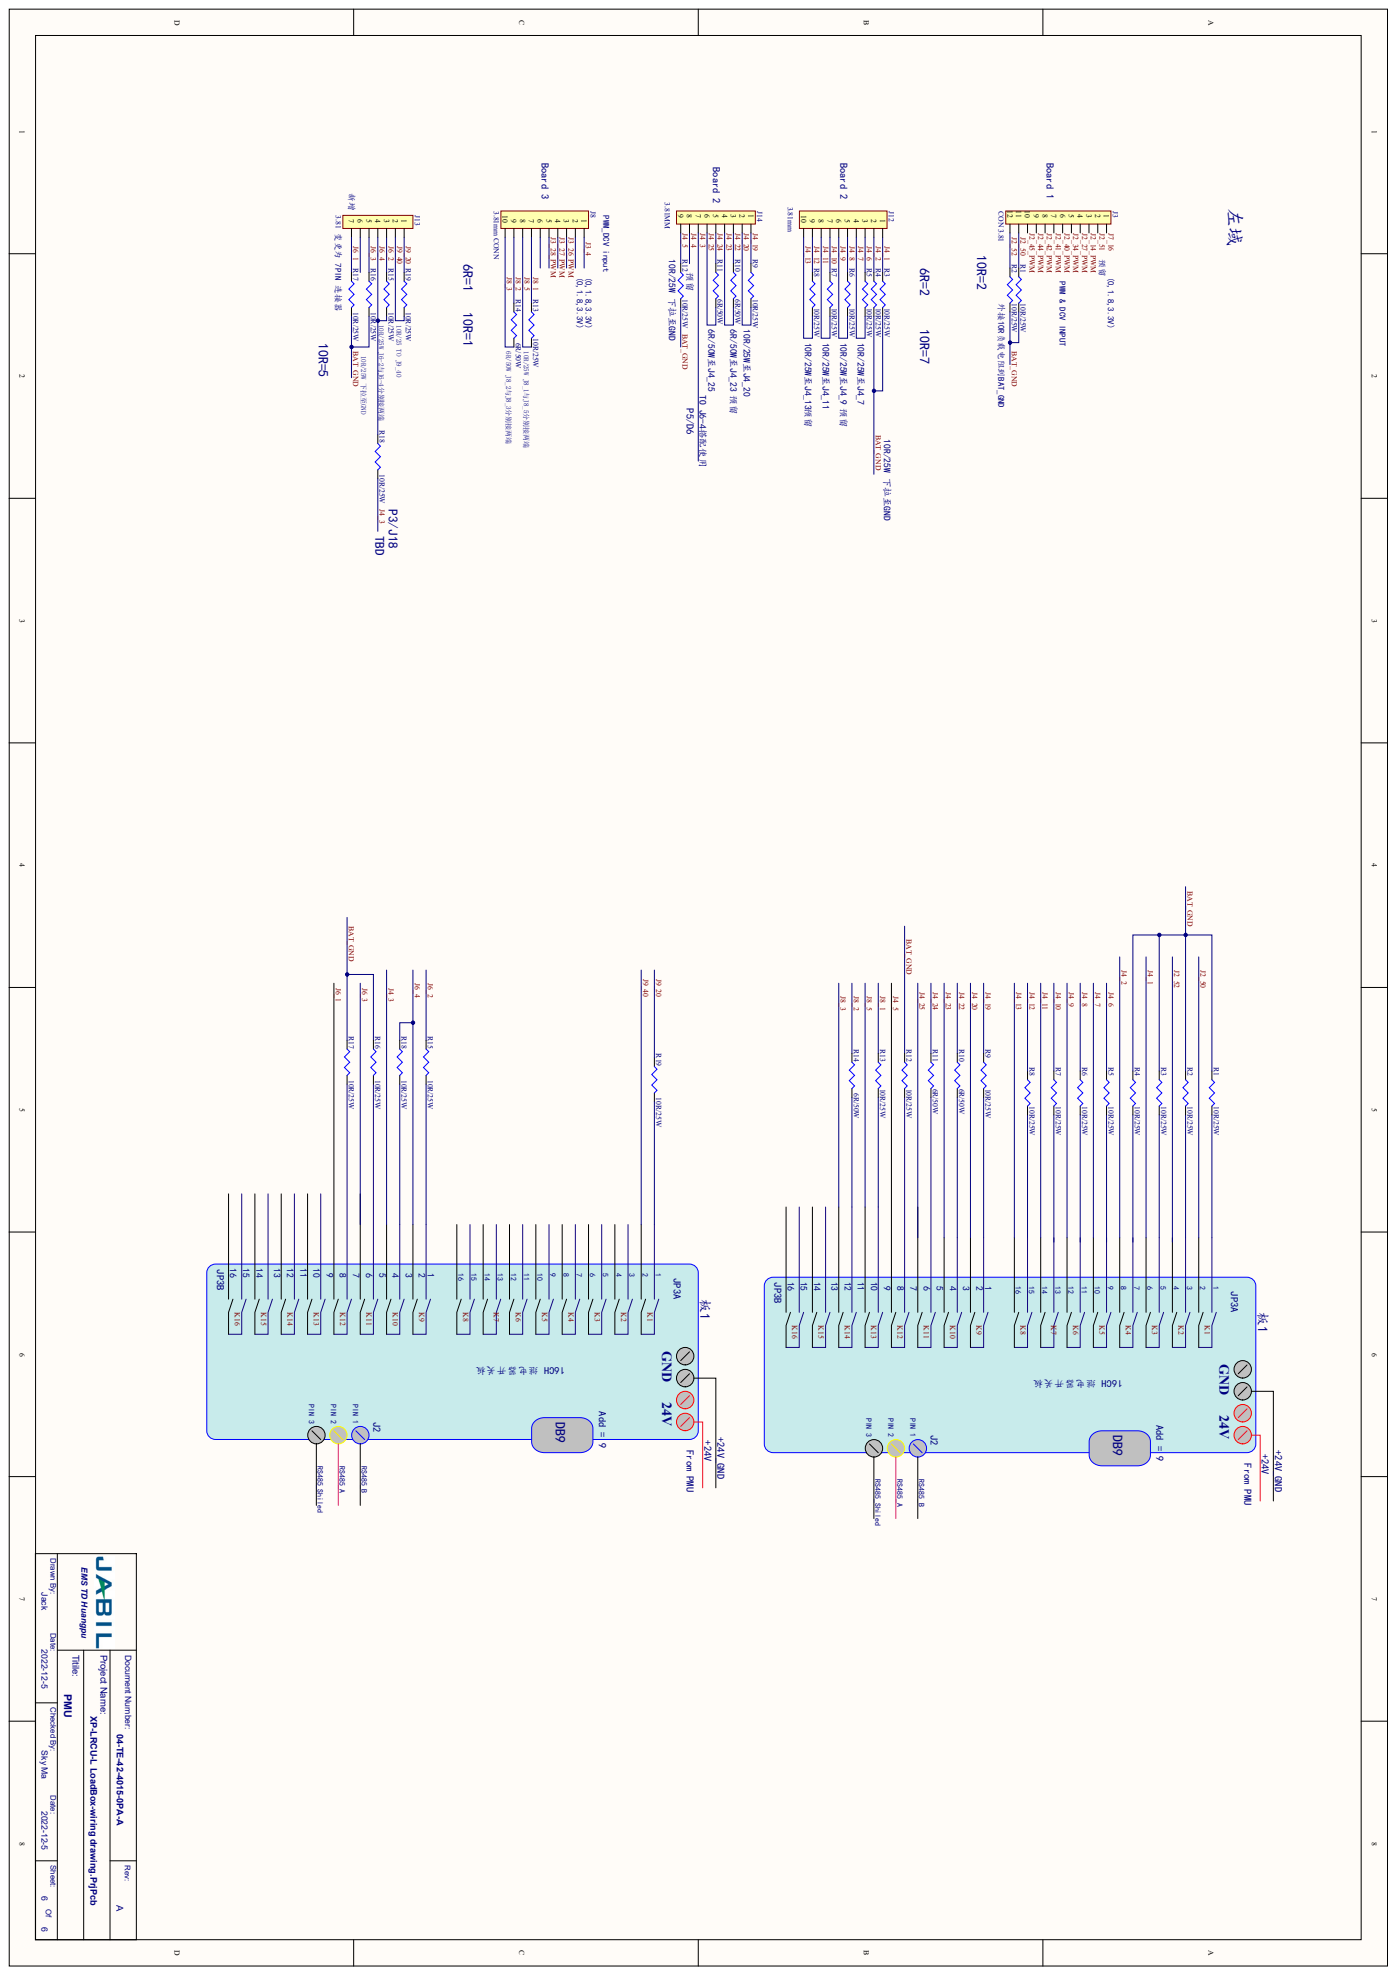
[picture p24: page 1]

Of Checked By: Date: Date:

XP-LRCU-L LoadBox-wiring
