Fred-Guo0422/H93_LDCU_EOL_TESTER/document/H93_LDCU/LoadBox-L-wiring drawing/LoadBox-L-wiring drawing/XP-LRCU-L LoadBox-wiring drawing.pdf

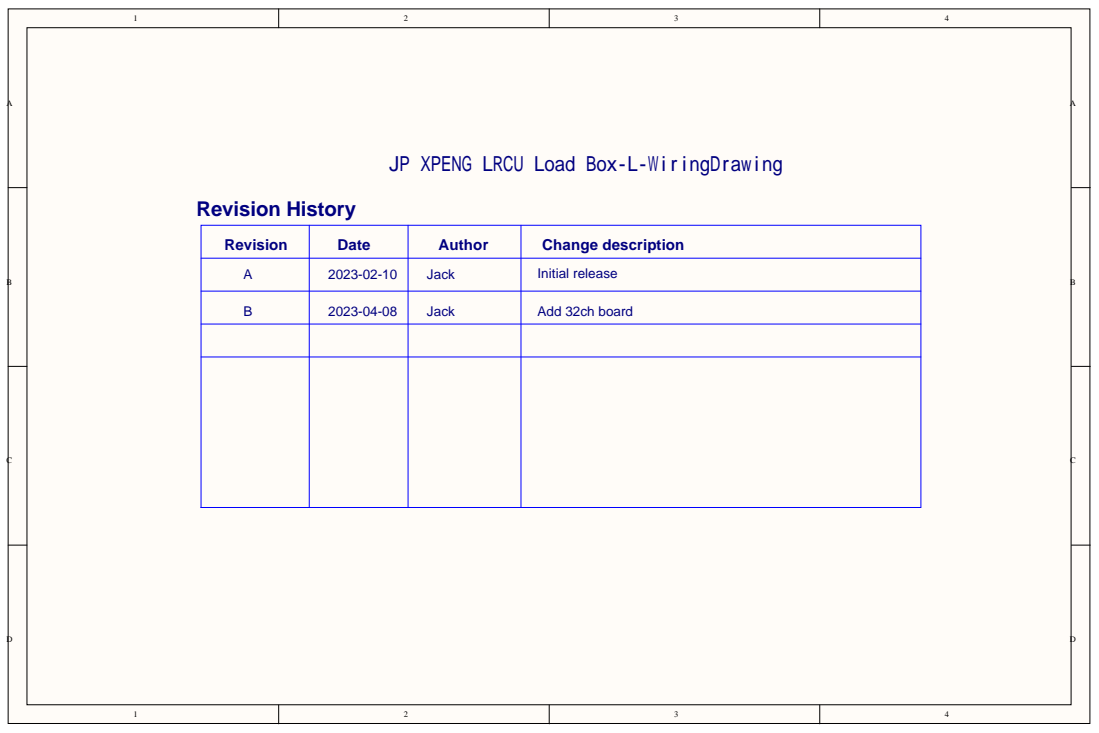
[picture p25: page 1]

JP XPENG LRCU Load Box-L-WiringDrawing

Revision | Date | Author | Change description

A | 2023-02-10 | Jack | Initial release

B | 2023-04-08 | Jack | Add 32ch board

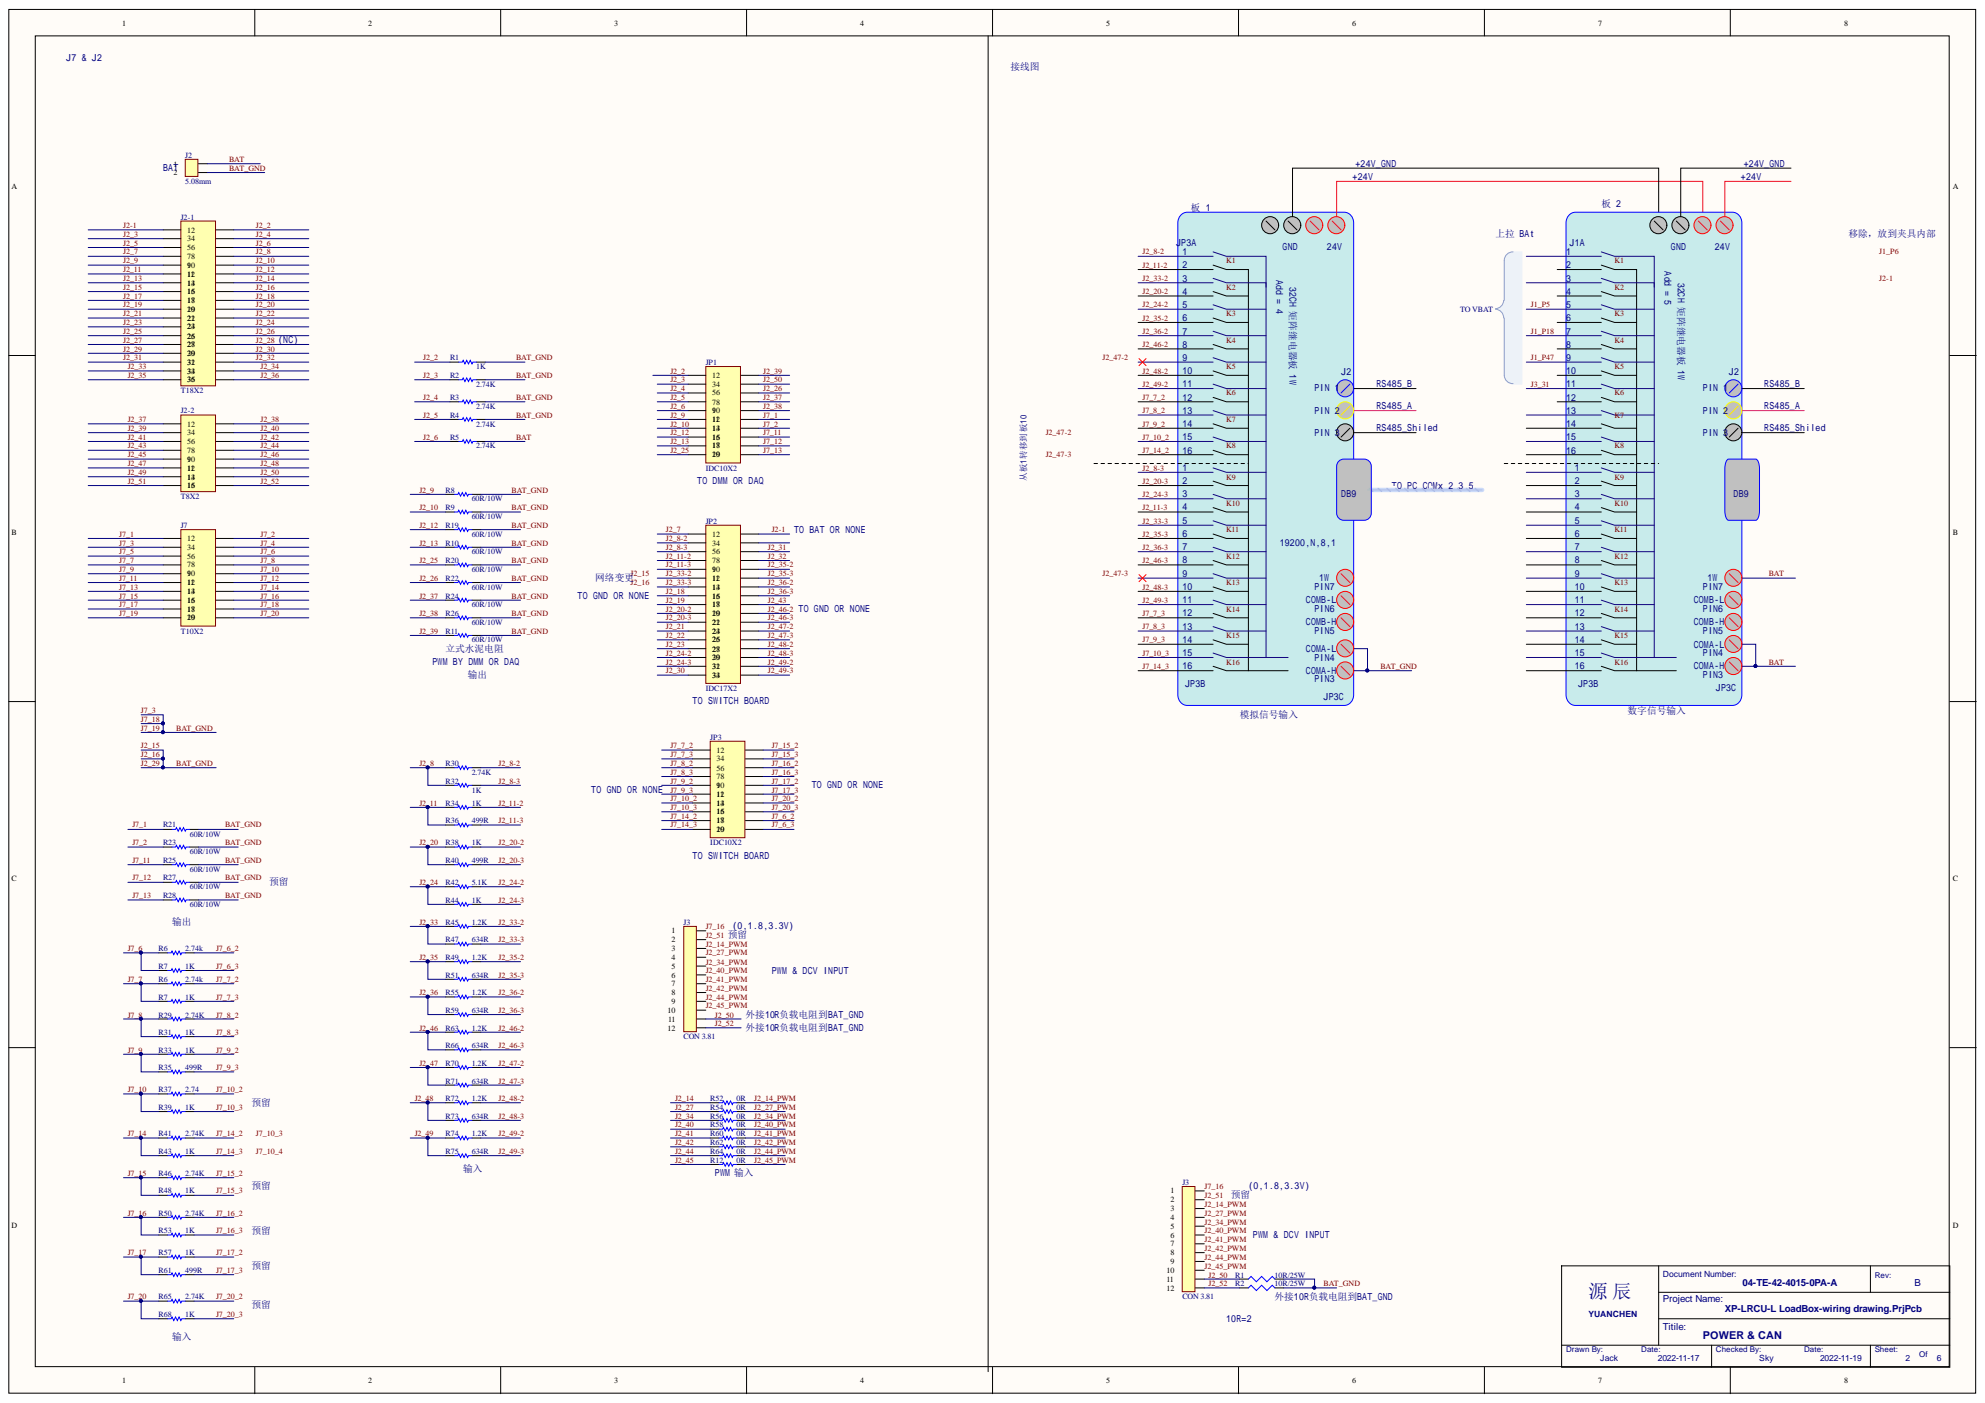
[picture p26: page 2]

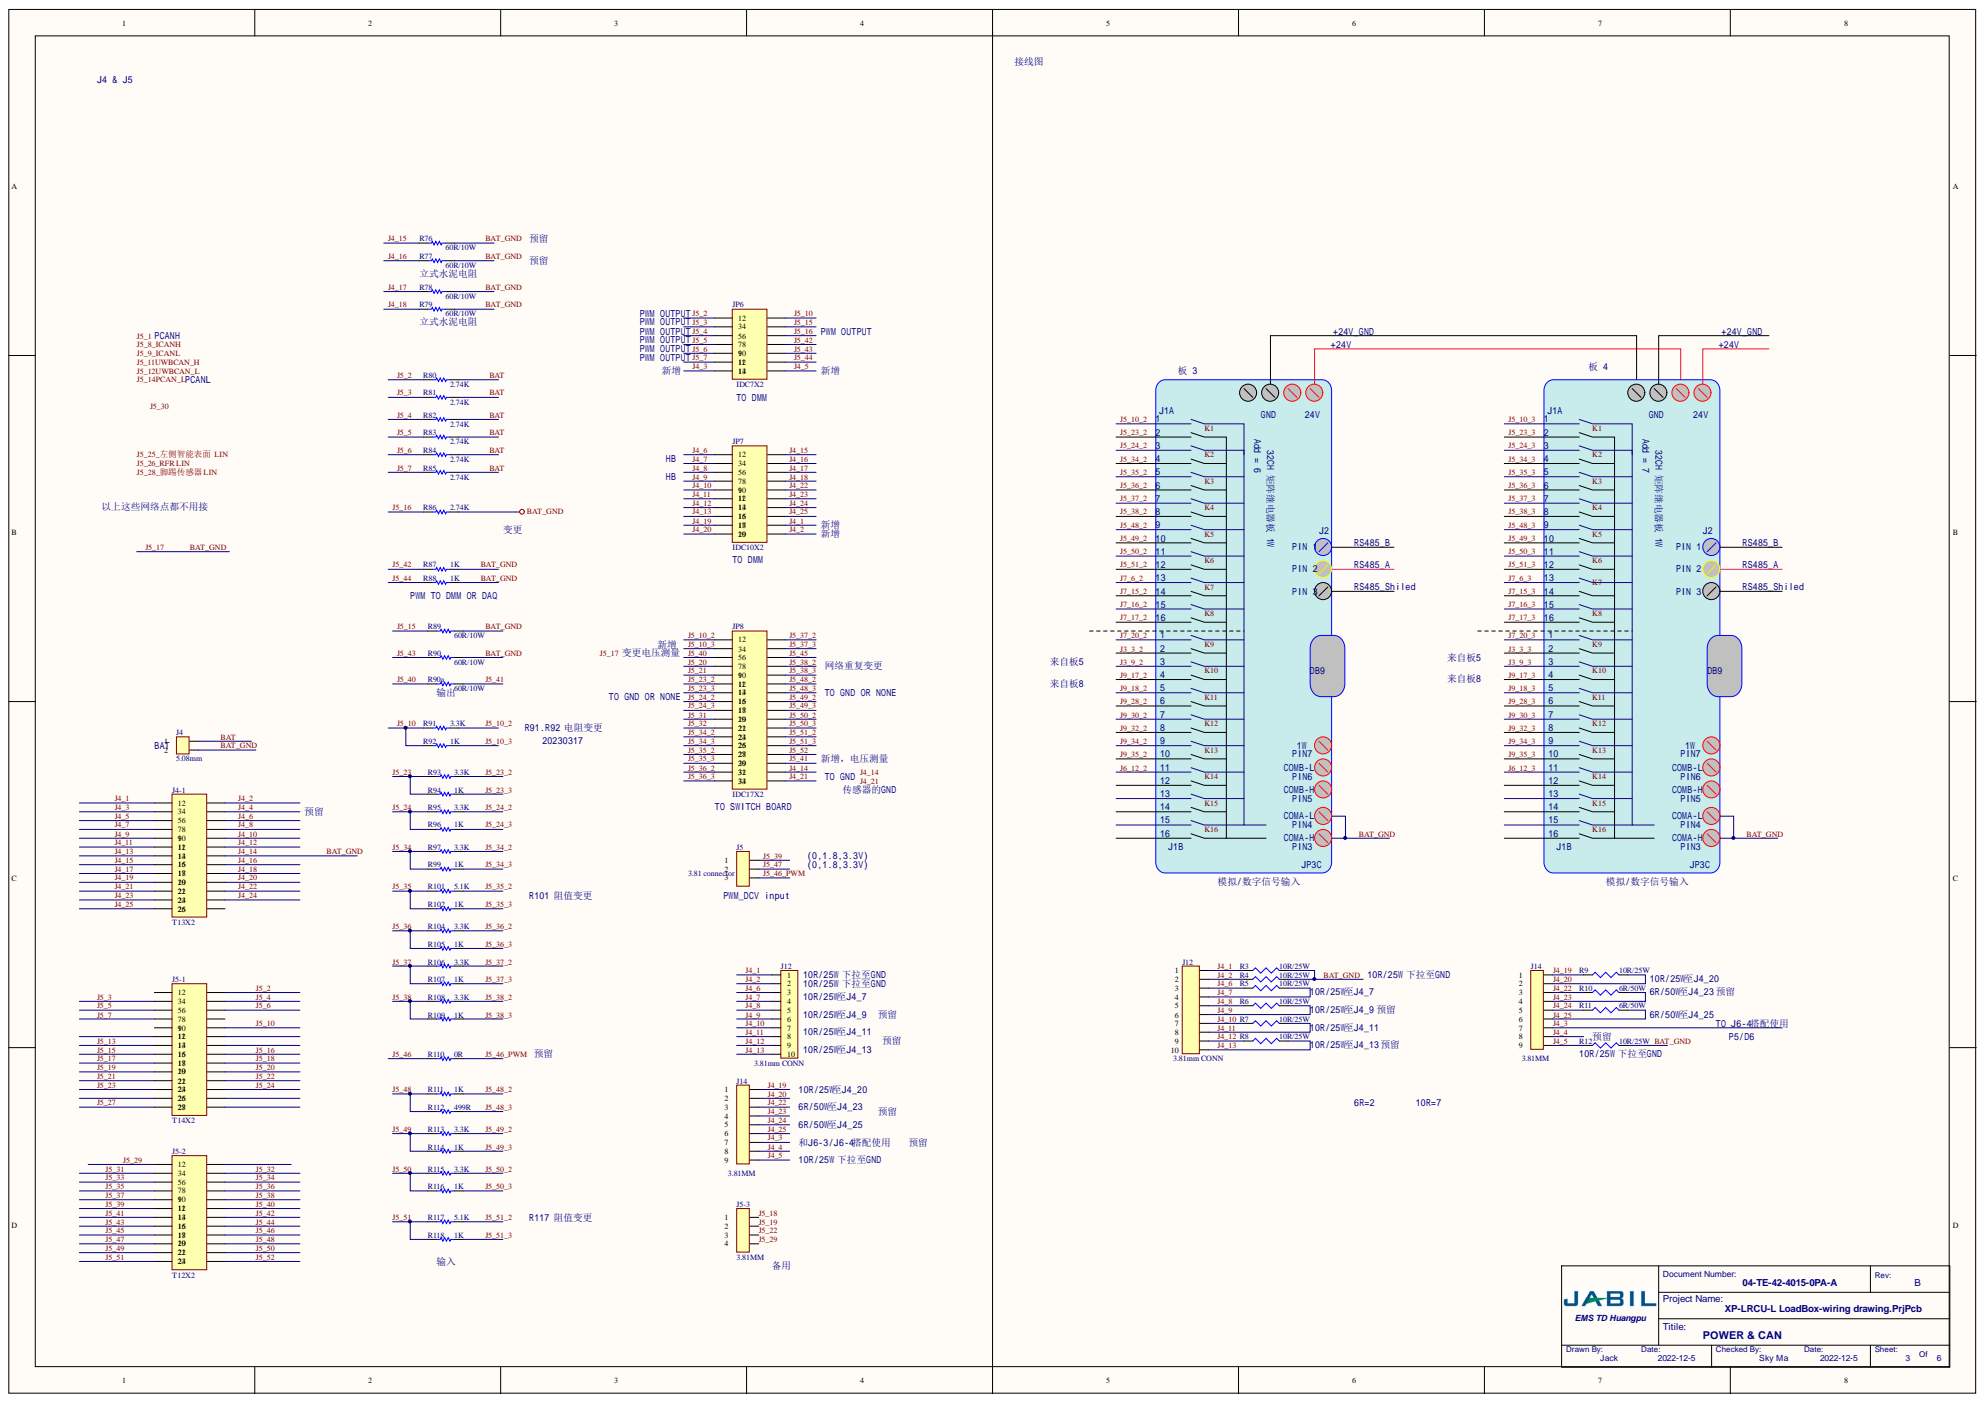
[picture p27: page 3]

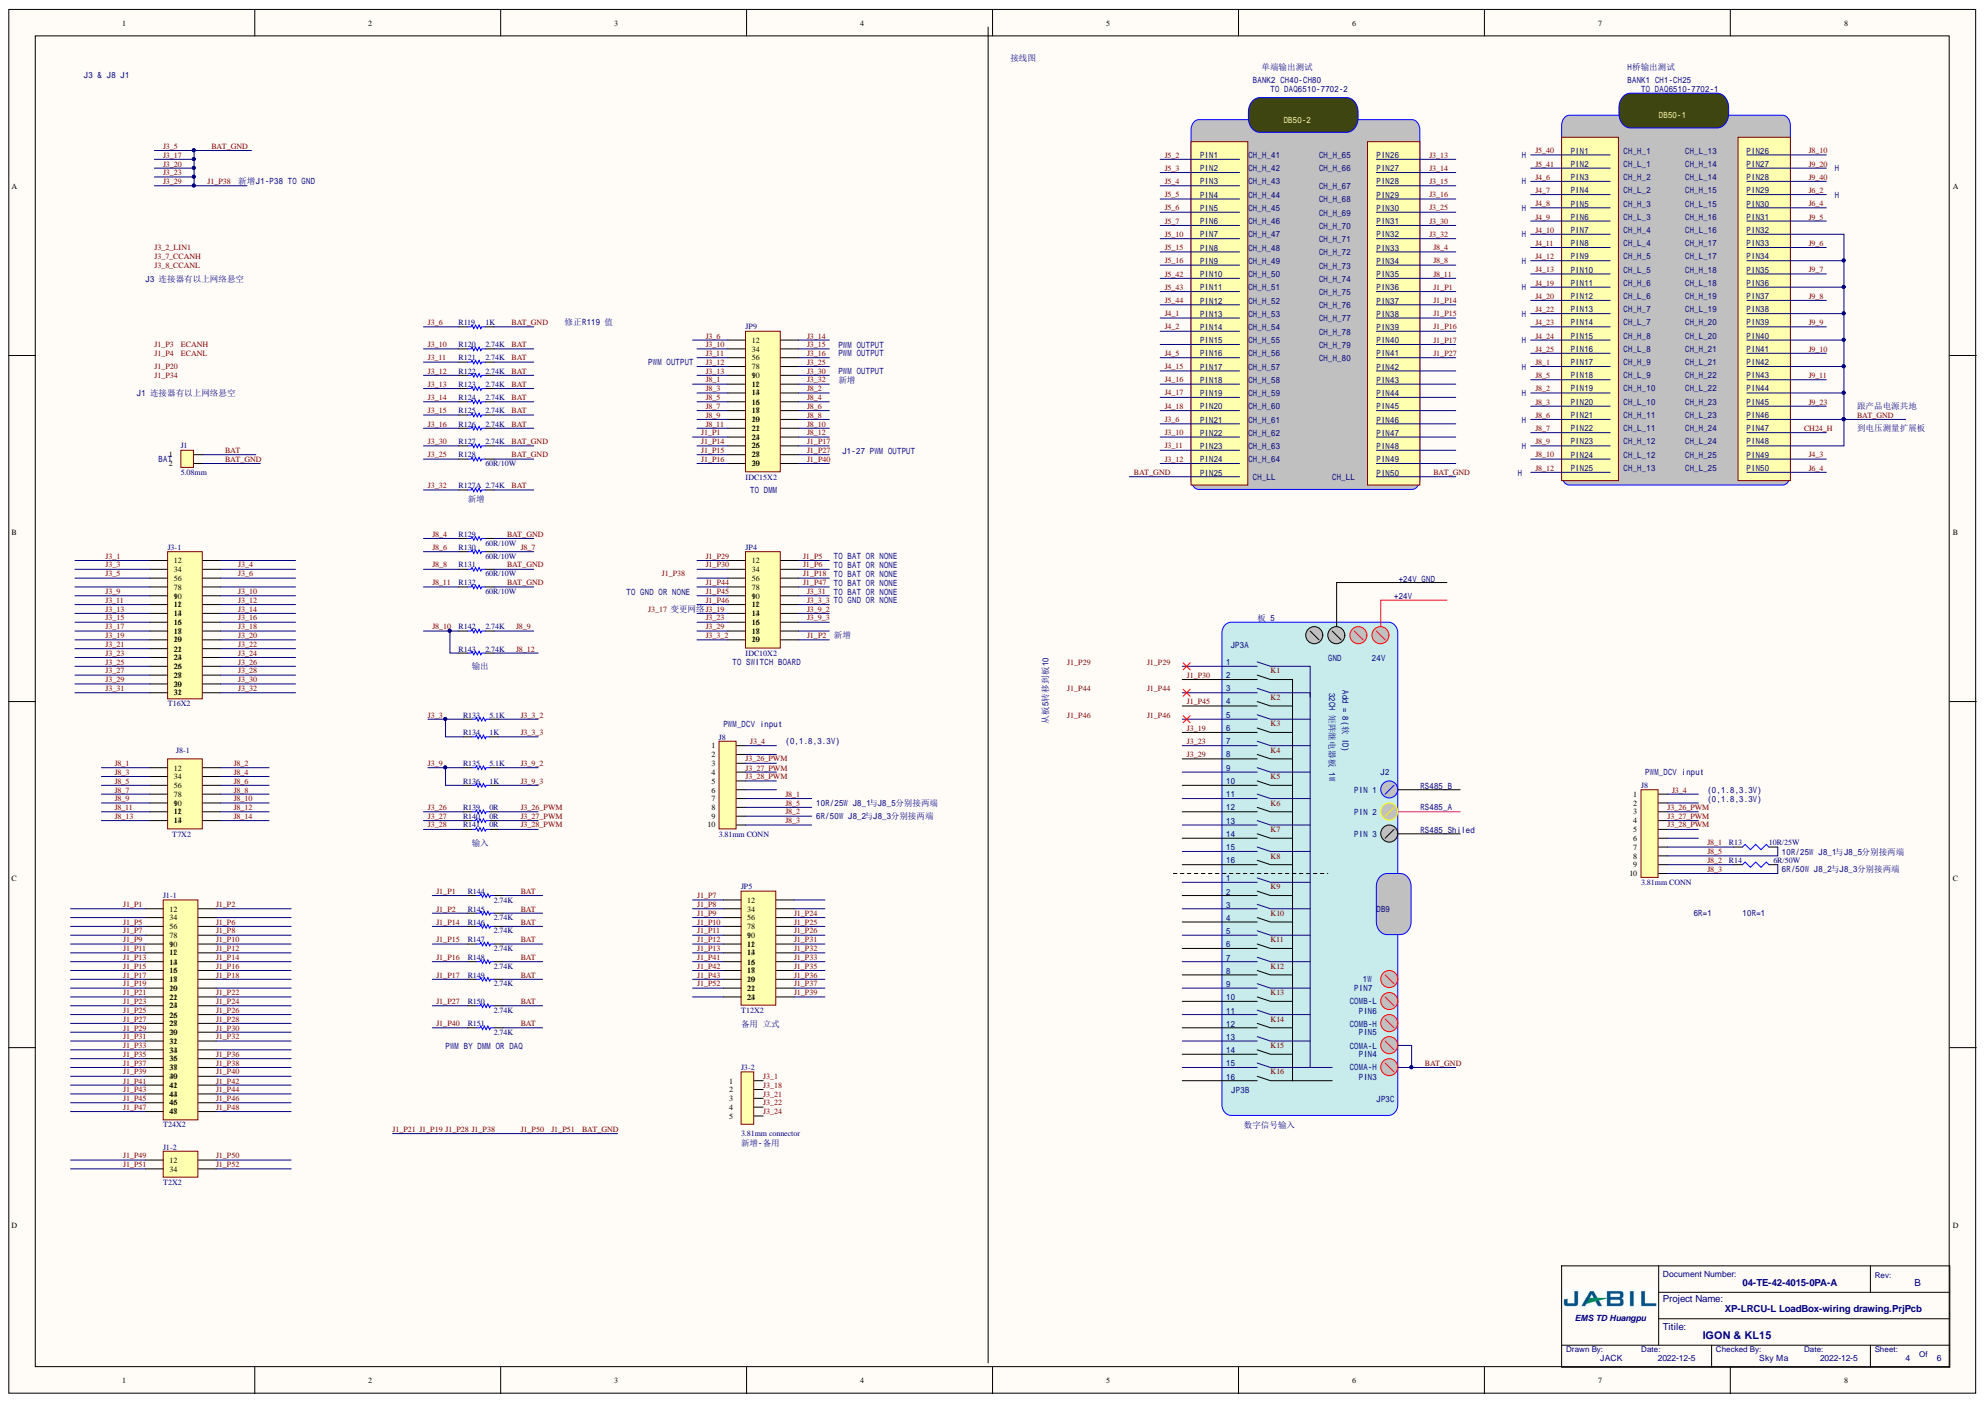
[picture p28: page 4]

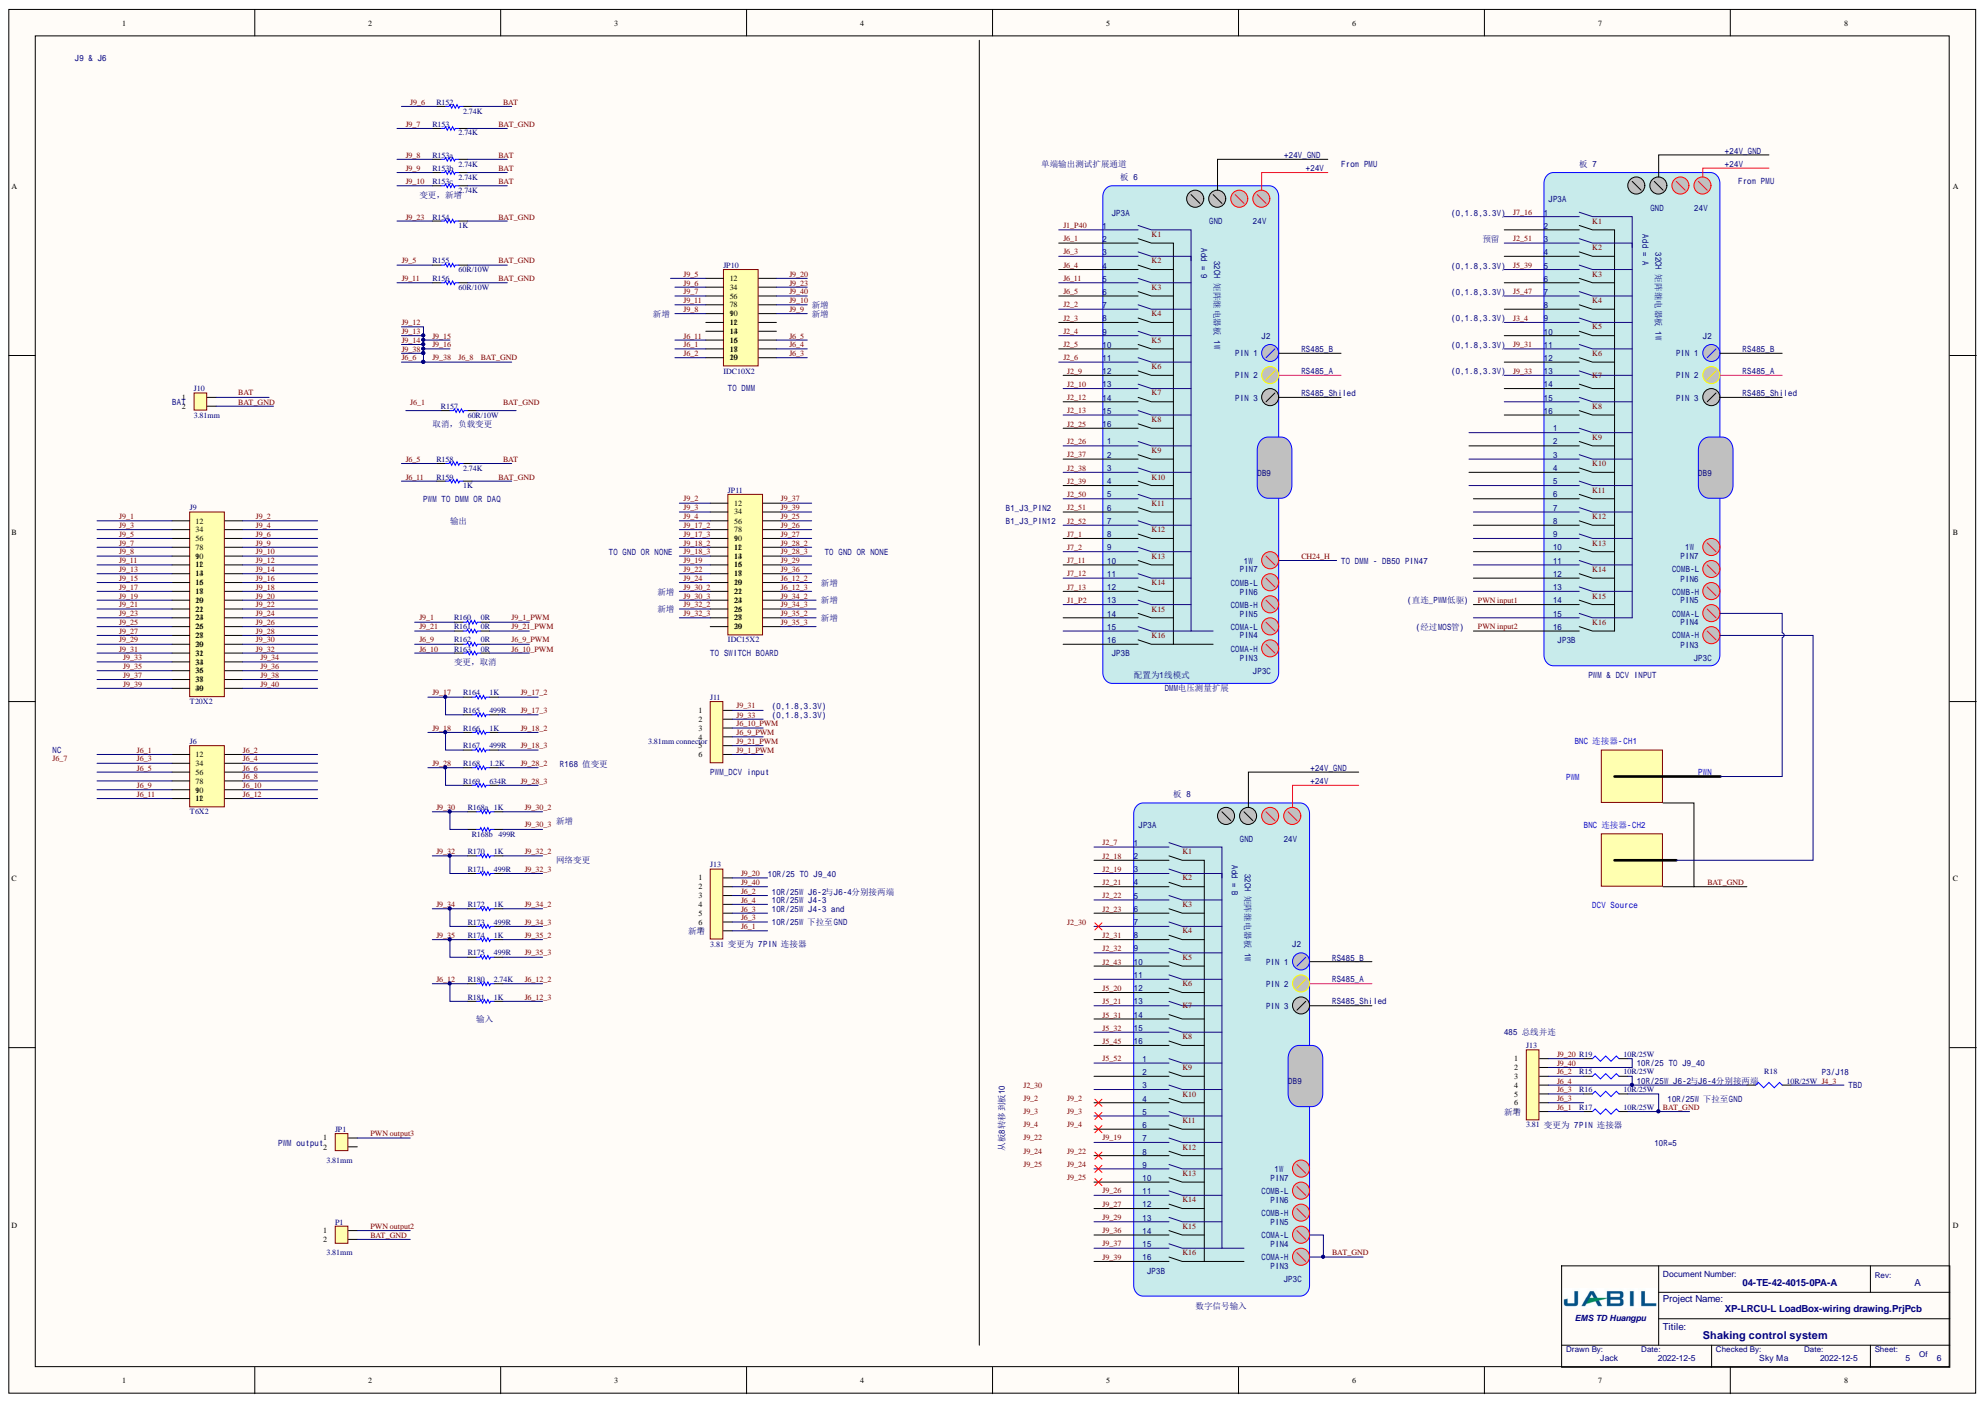
[picture p29: page 5]

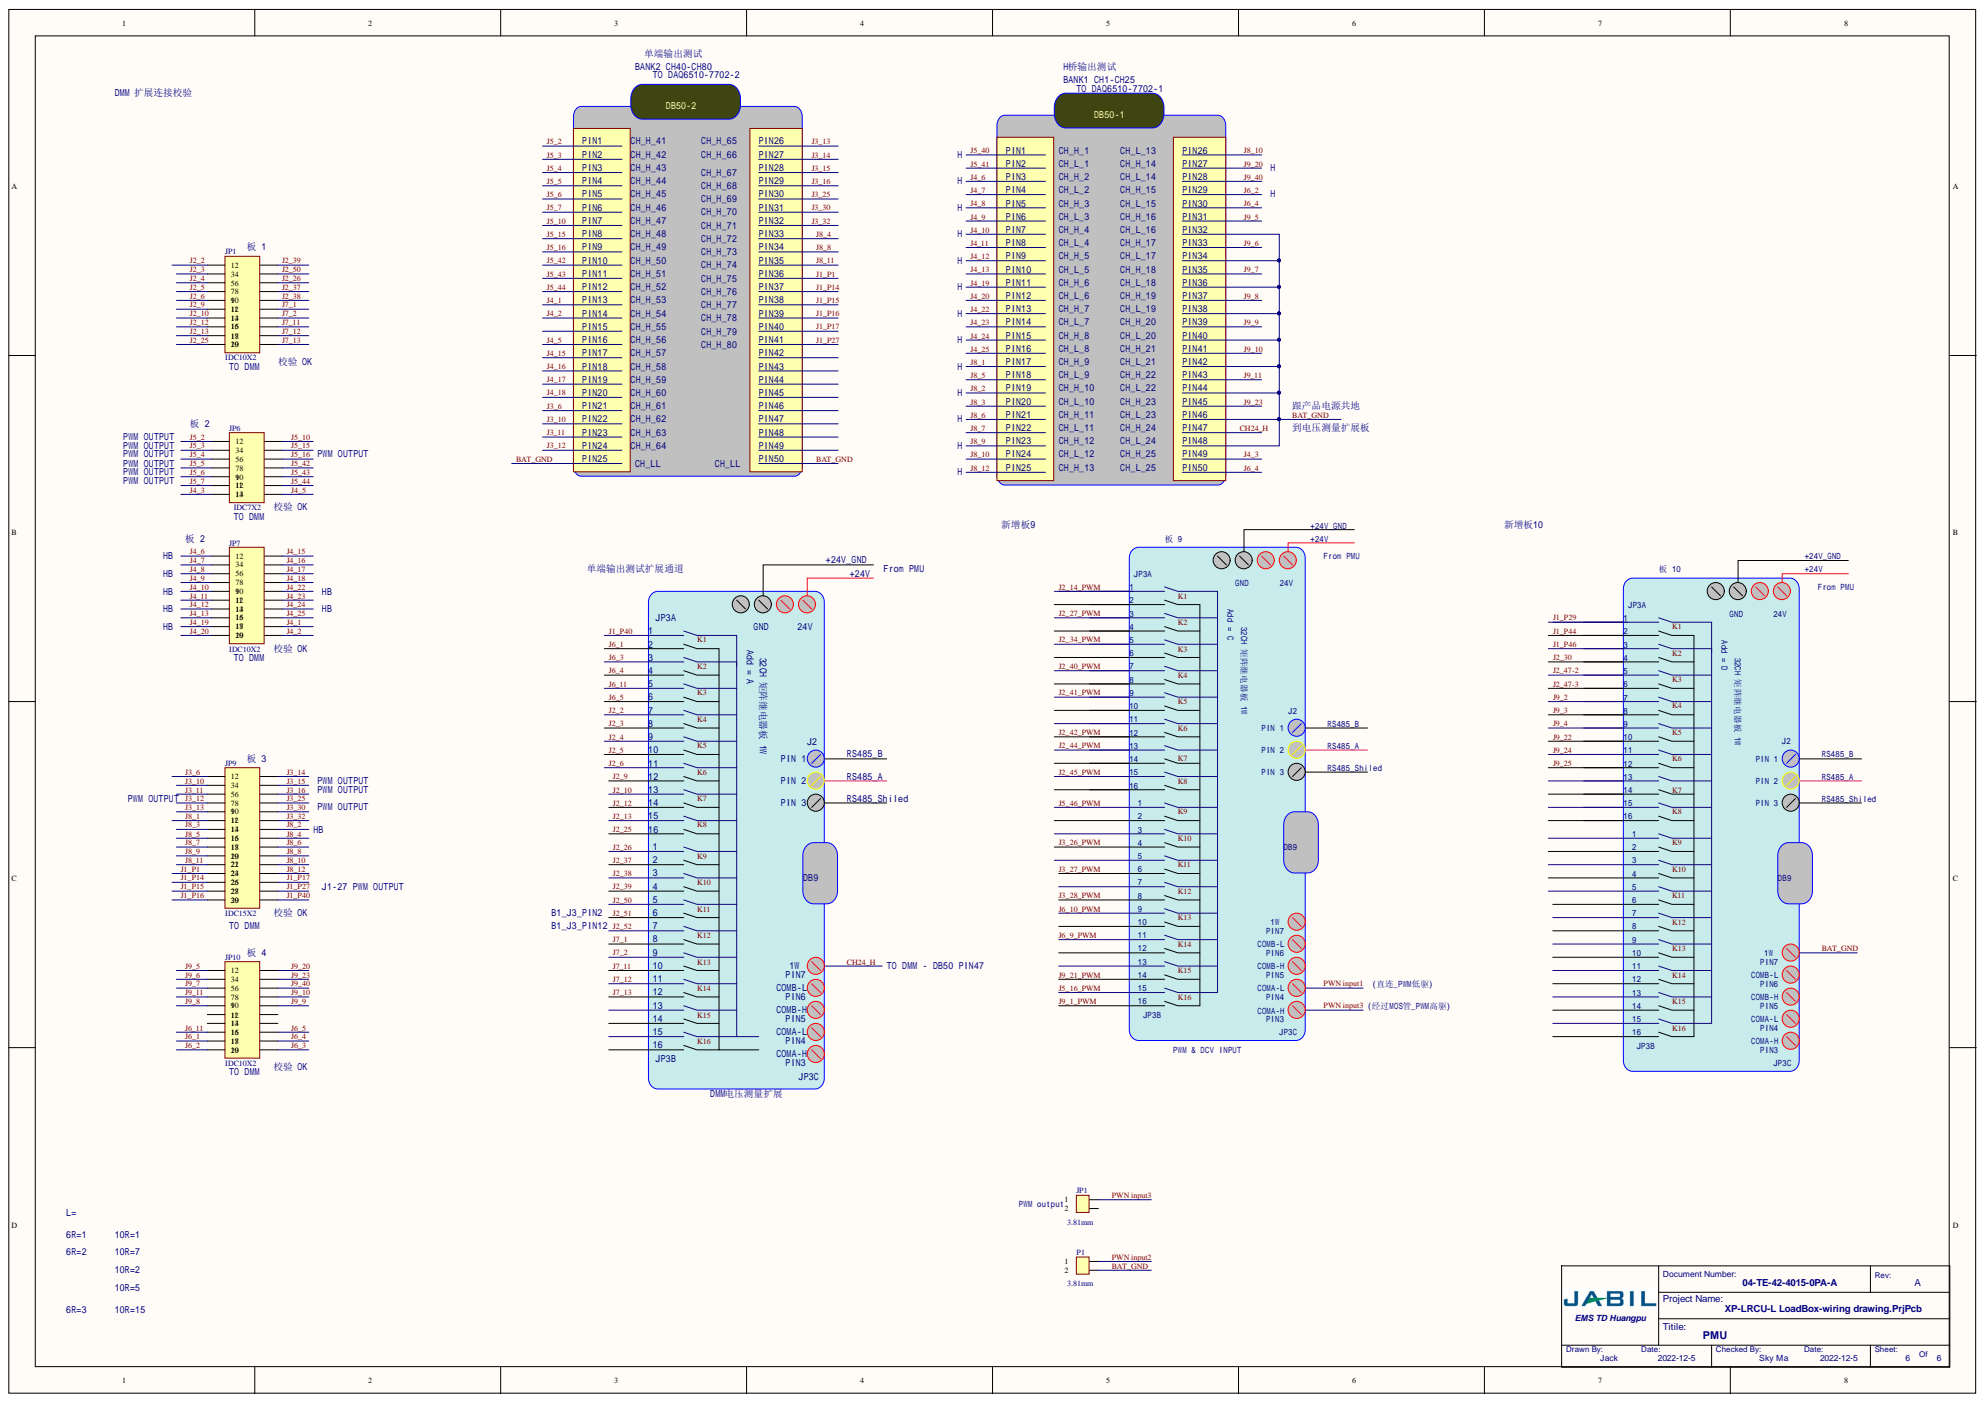
[picture p30: page 6]
