Fred-Guo0422/H93_LDCU_EOL_TESTER/document/H93_LDCU/EOL_Fixture-LDCU/EOL_Fixture-LDRU/YC0098_JPXP H93 EOL LDRU Fixture wiring drawing-20230321.pdf

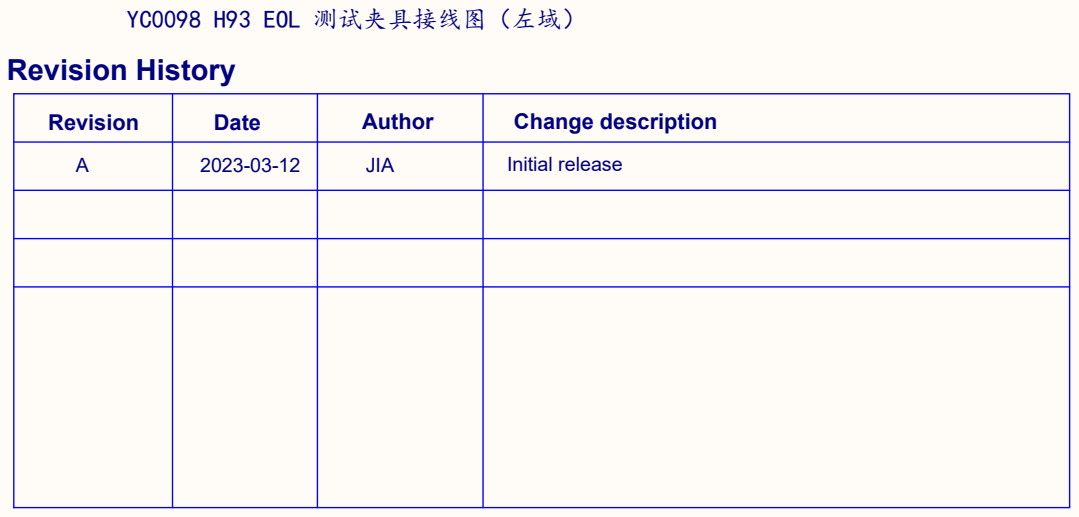
[picture p31: page 1]

Revision | Date | Author | Change description

A | 2023-03-12 | JIA | Initial release

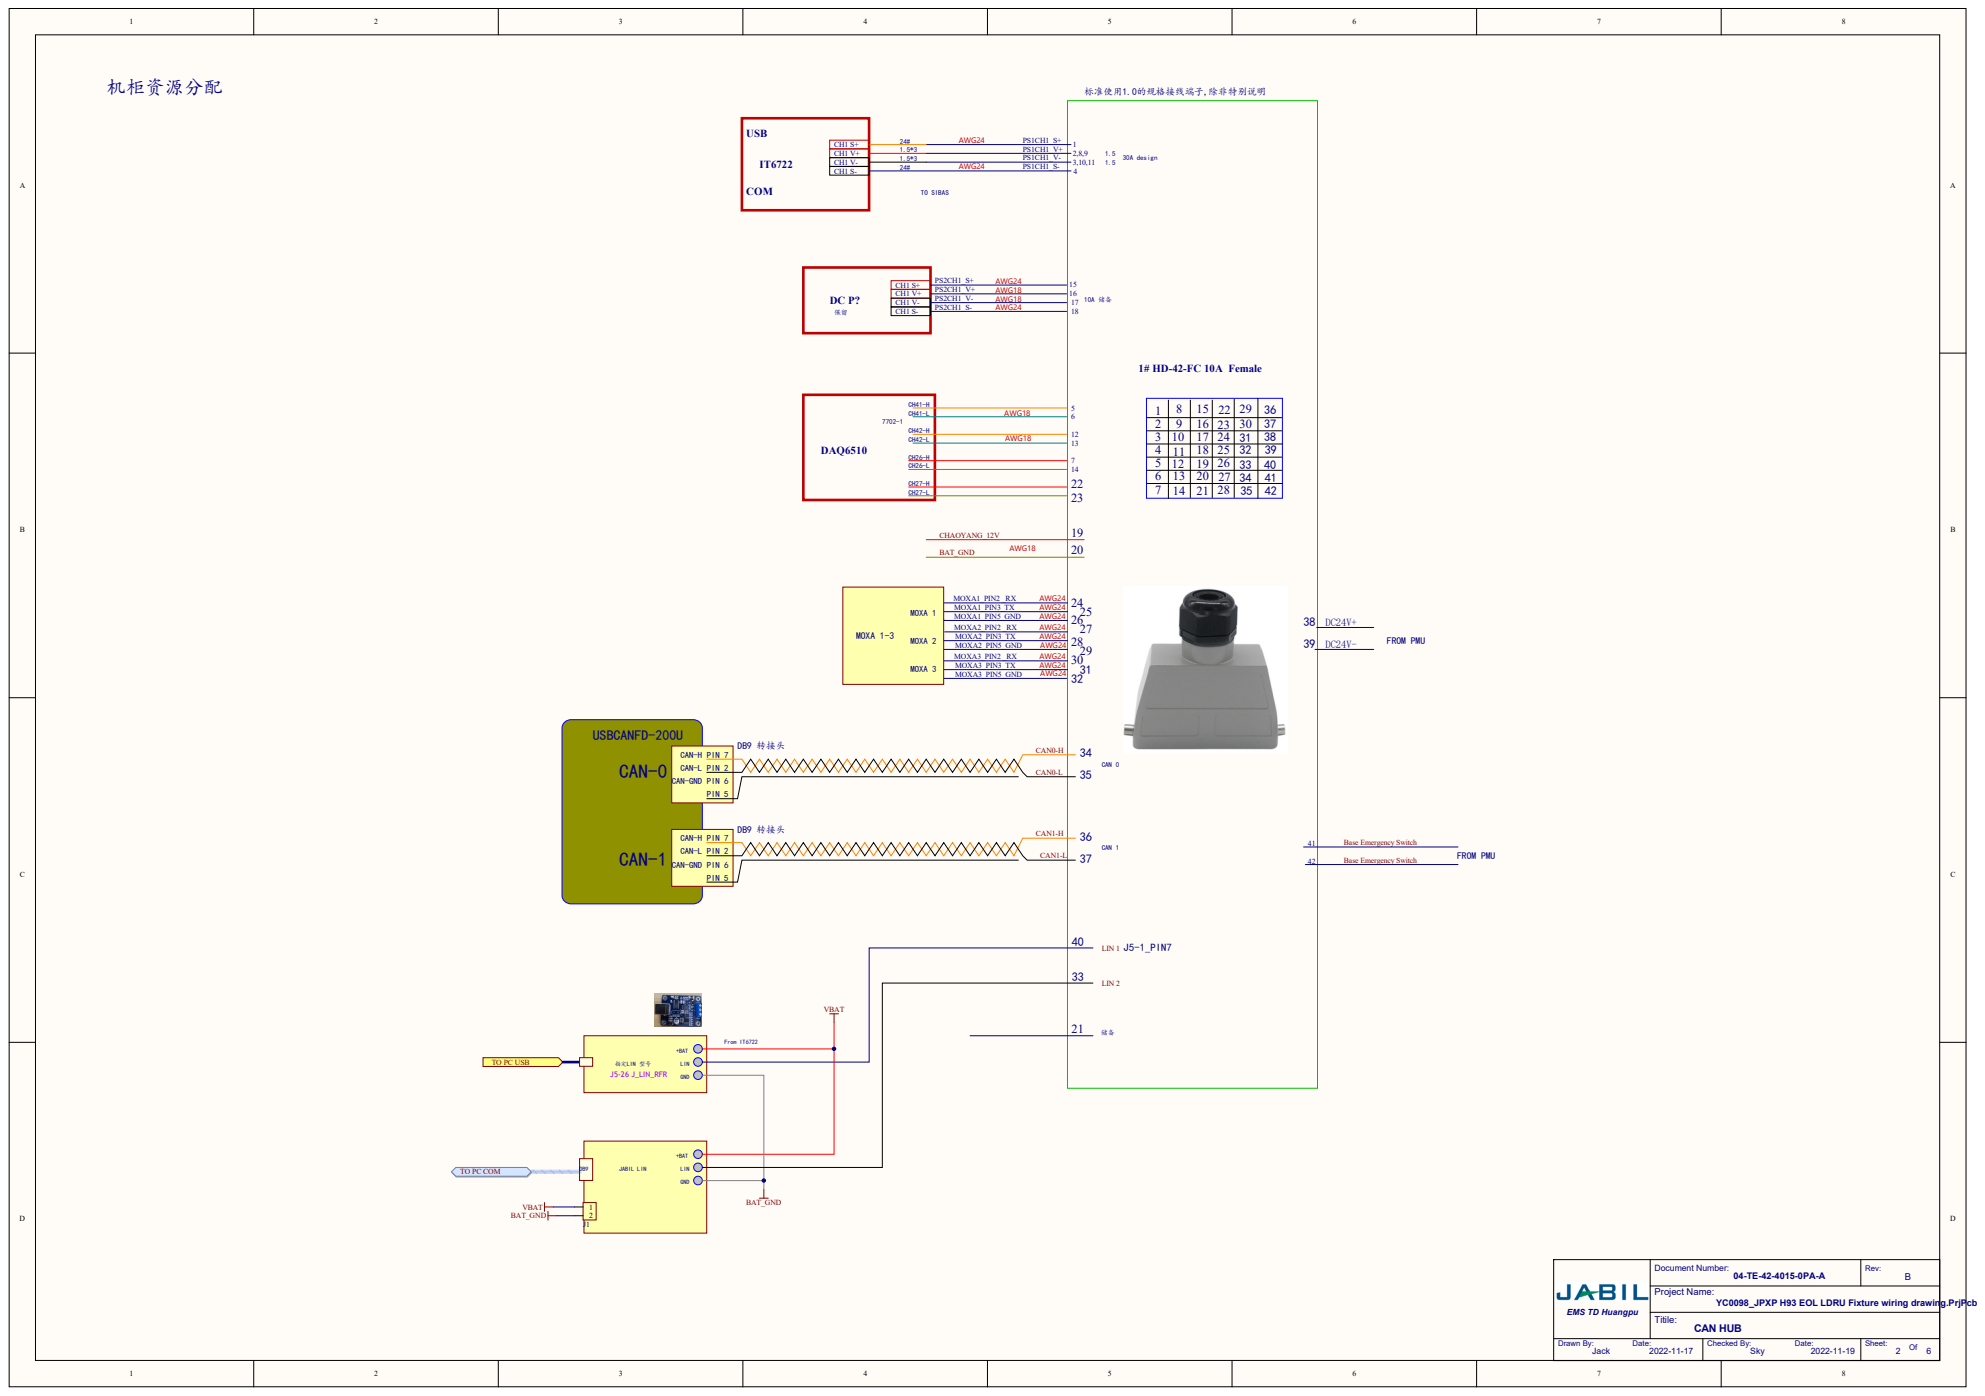
[picture p32: page 2]

2 | 9 | 16 | 23 | 30 | 37
3 | 10 | 17 | 24 | 31 | 38
4 | 11 | 18 | 25 | 32 | 39
5 | 12 | 19 | 26 | 33 | 40
6 | 13 | 20 | 27 | 34 | 41
7 | 14 | 21 | 28 | 35 | 42

VBAT | 21

YC0098_JPXP H93 EOL LDRU Fixture wiring drawing.PrjPcb

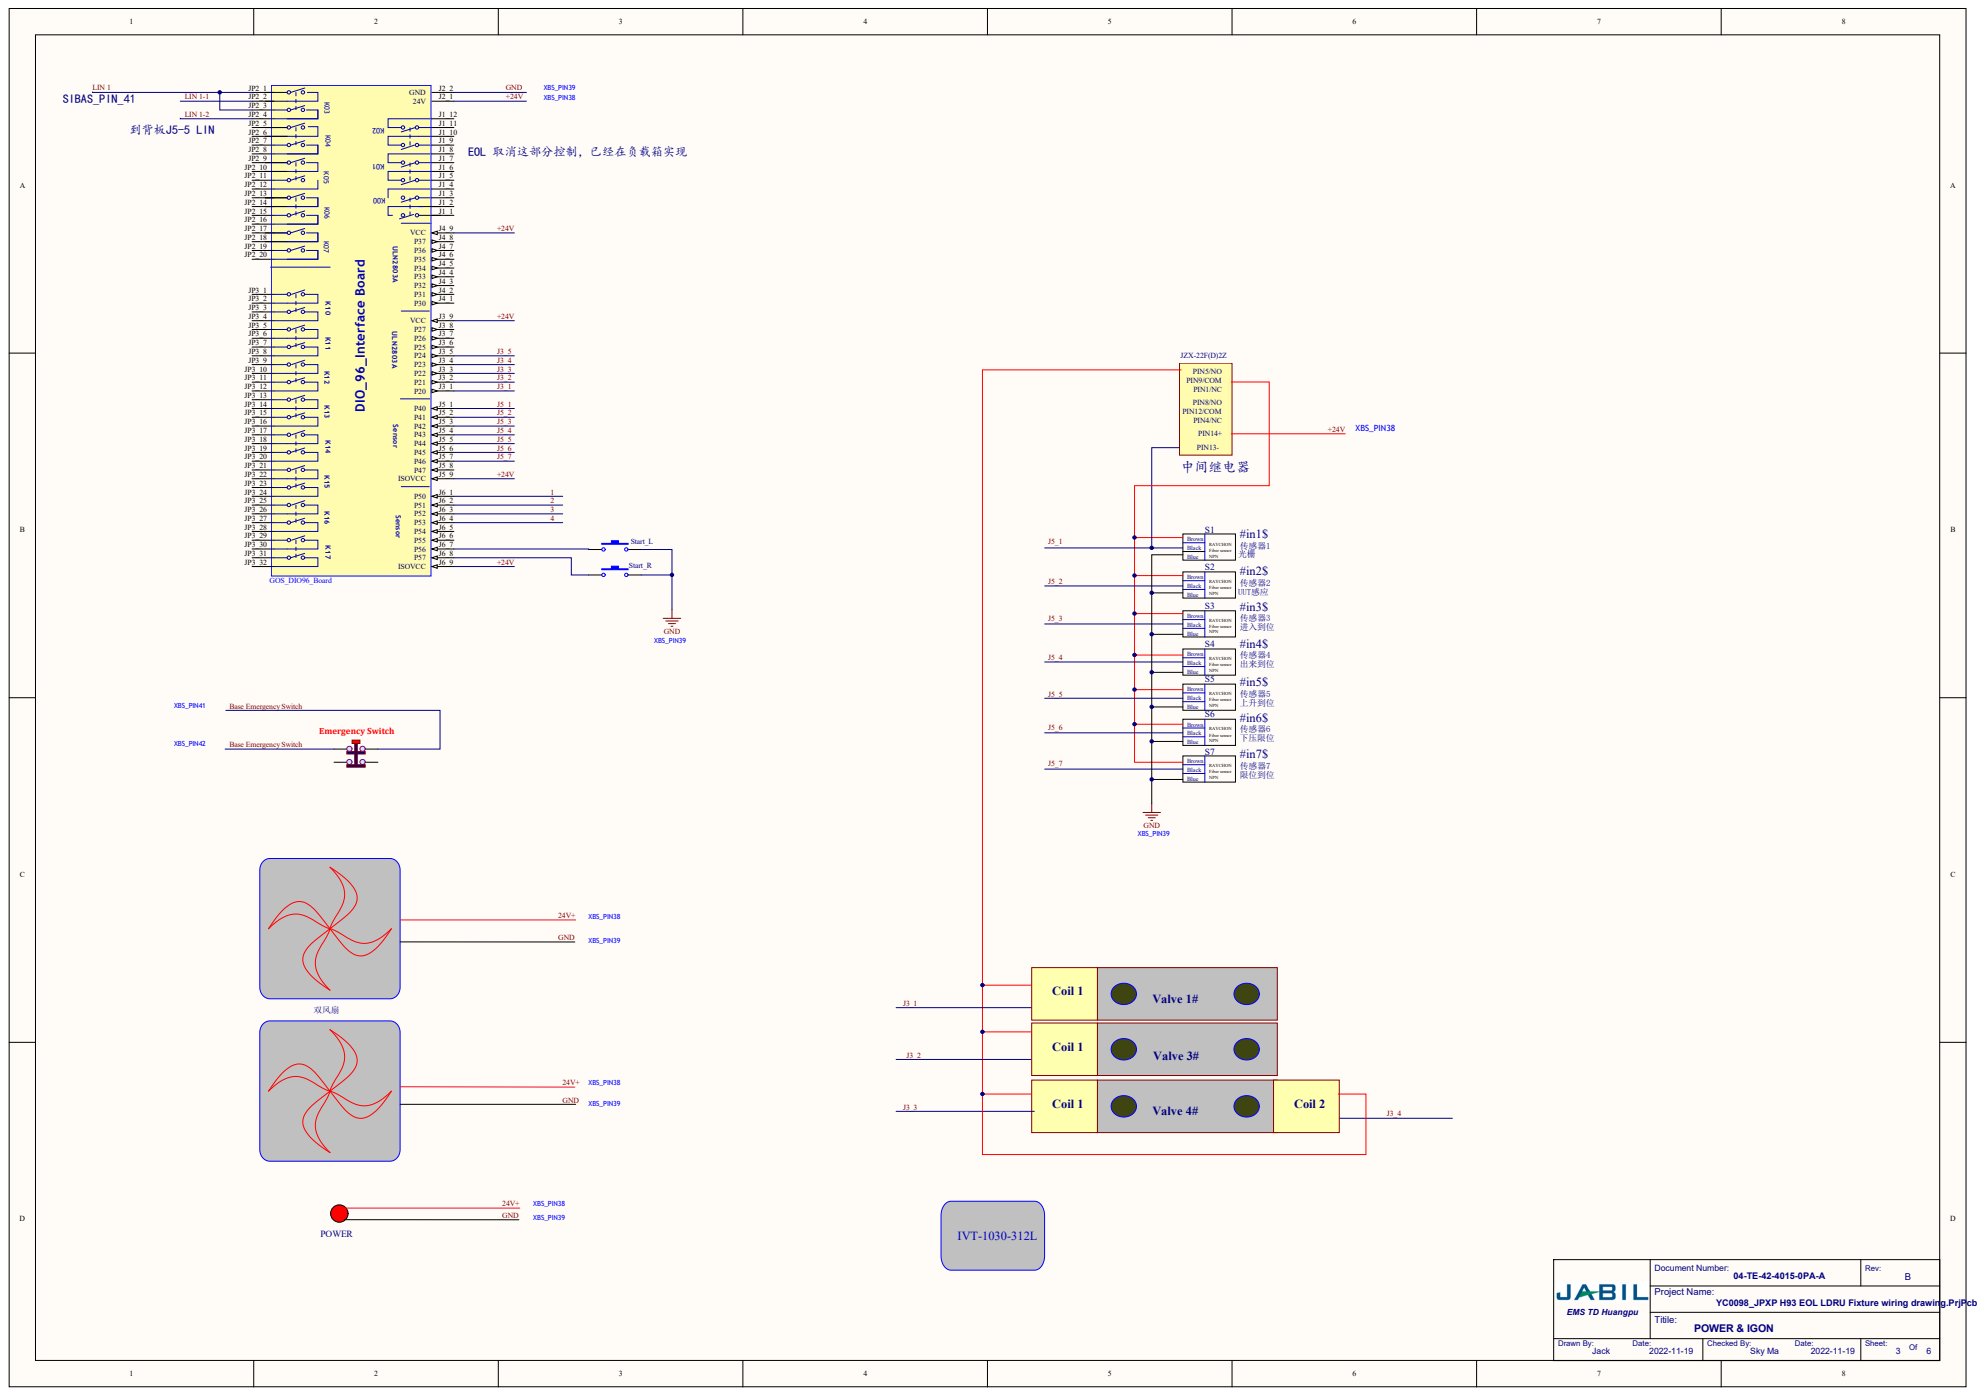
[picture p33: page 3]

Brown | RAYCHON NPN Fiber sensor

Brown | Fiber sensor NPN

Brown | RAYCHON Fiber sensor NPN

Coil 1 | Valve 1#

Coil 1 | Valve 3#

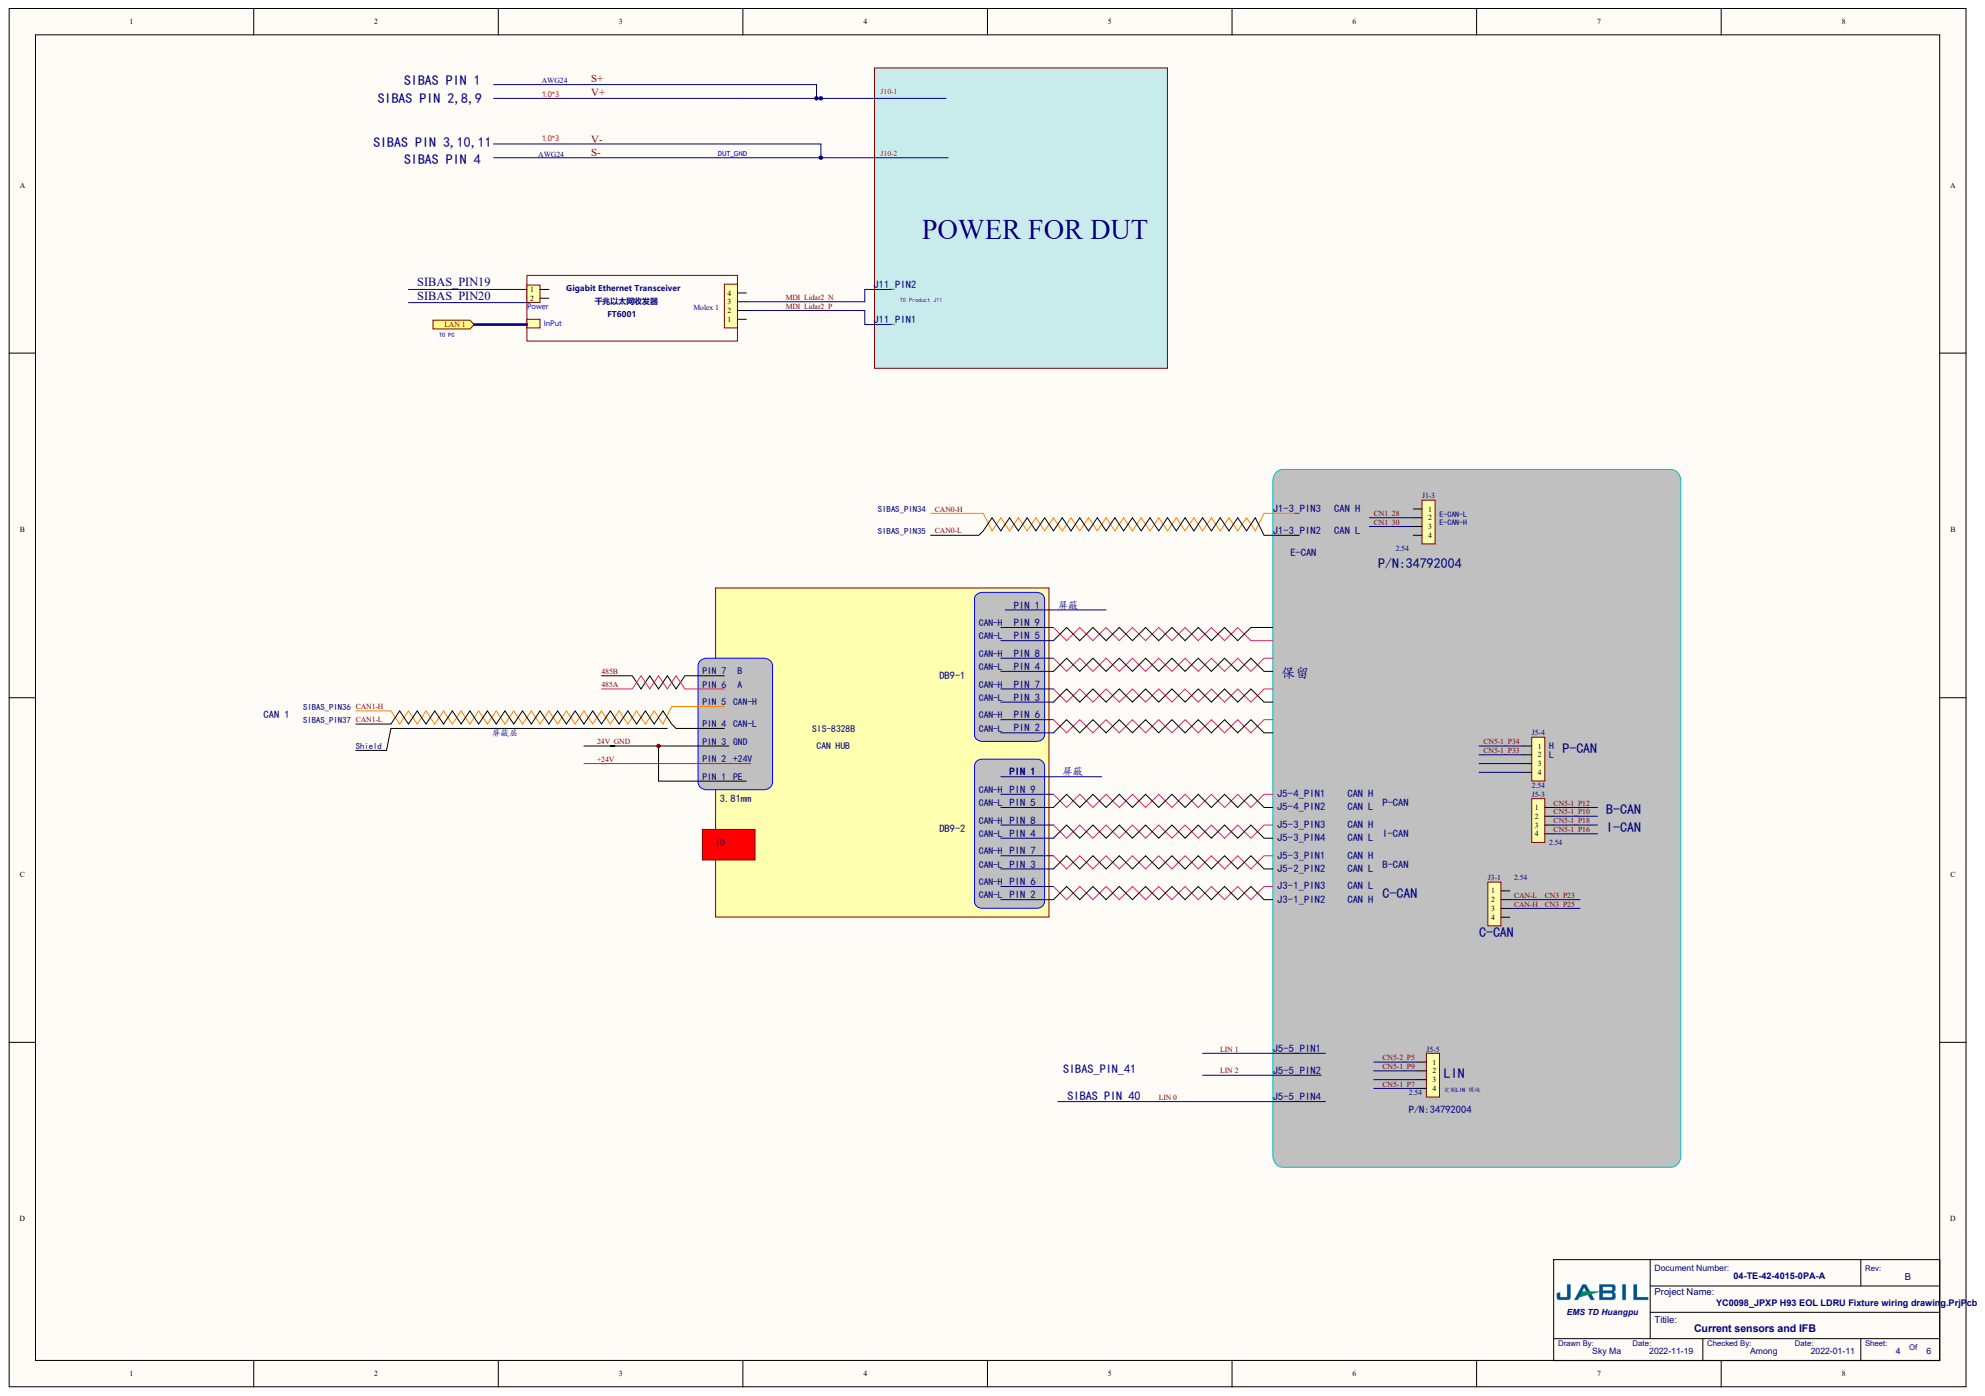
[picture p34: page 4]

Current sensors and IFB

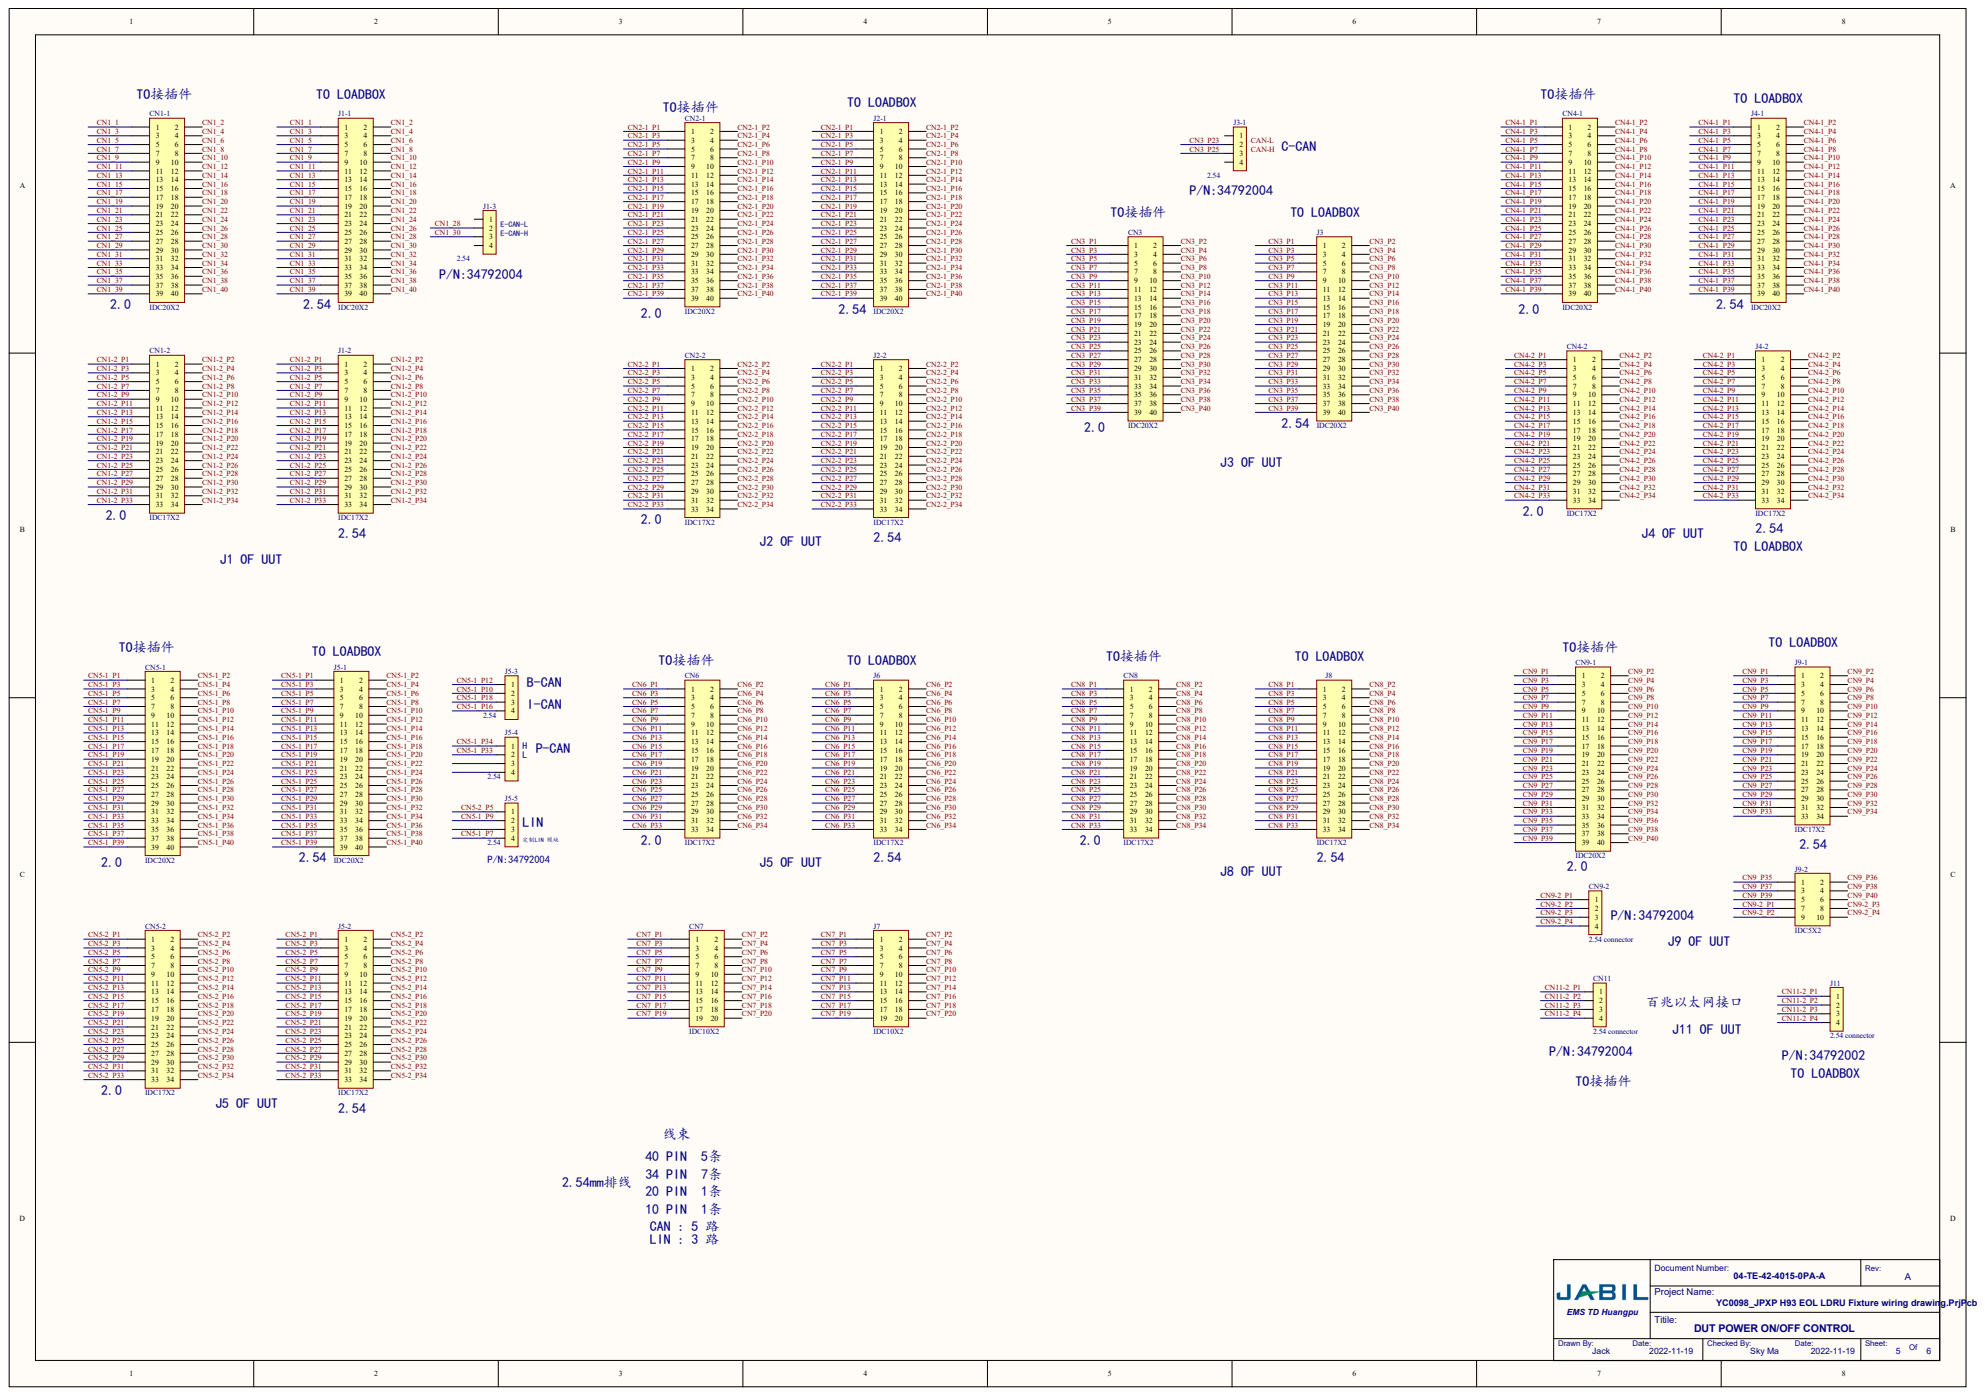
[picture p35: page 5]

U Fixture wiring drawing.PrjPcb
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
