Fred-Guo0422/H93_LDCU_EOL_TESTER/document/H93_LDCU/H93-LDCU_产品假连接器原理图/L-J1.pdf

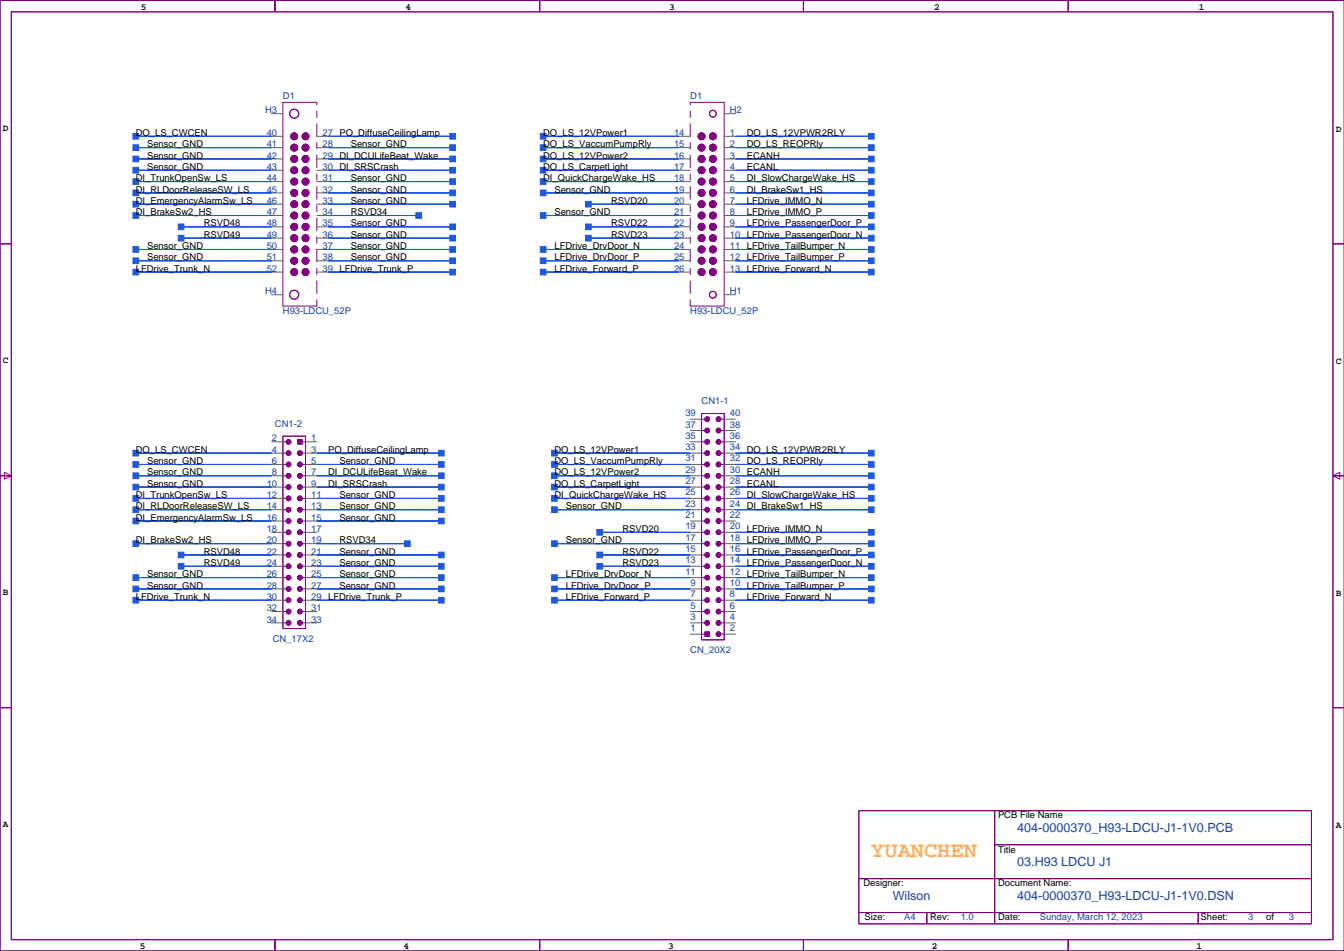
[picture p36: page 1]
Title; 03.H93 LDCU J1; H93-LDCU_52P; RSVD20; ECANH; RSVD22; DO_LS_12VPower2; DO_LS_VaccumPumpRly; DI_QuickChargeWake_HS; DO_LS_CarpetLight; DO_LS_12VPower1; LFDrive_Forward_N; LFDrive_TailBumper_P; LFDrive_Forward_P; LFDrive_IMMO_N; LFDrive_DrvDoor_P; LFDrive_DrvDoor_N; LFDrive_TailBumper_N; DO_LS_REOPRly; LFDrive_PassengerDoor_N; LFDrive_PassengerDoor_P; LFDrive_IMMO_P; RSVD23; DI_BrakeSw1_HS; DI_SlowChargeWake_HS; DO_LS_12VPWR2RLY; ECANL; LFDrive_Trunk_N; Sensor_GND; Sensor_GND Sensor_GND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

PCB File Name
404-0000370_H93-LDCU-J1-1V0.PCB

Designer: Wilson | Document Name: 404-0000370_H93-LDCU-J1-1V0.DSN

Size: A4 | Rev: 1.0 | Date: Sunday, March 12, 2023 | Sheet: 3 of 3
