Fred-Guo0422/H93_LDCU_EOL_TESTER/document/H93_LDCU/H93-LDCU_产品假连接器原理图/L-J11.pdf

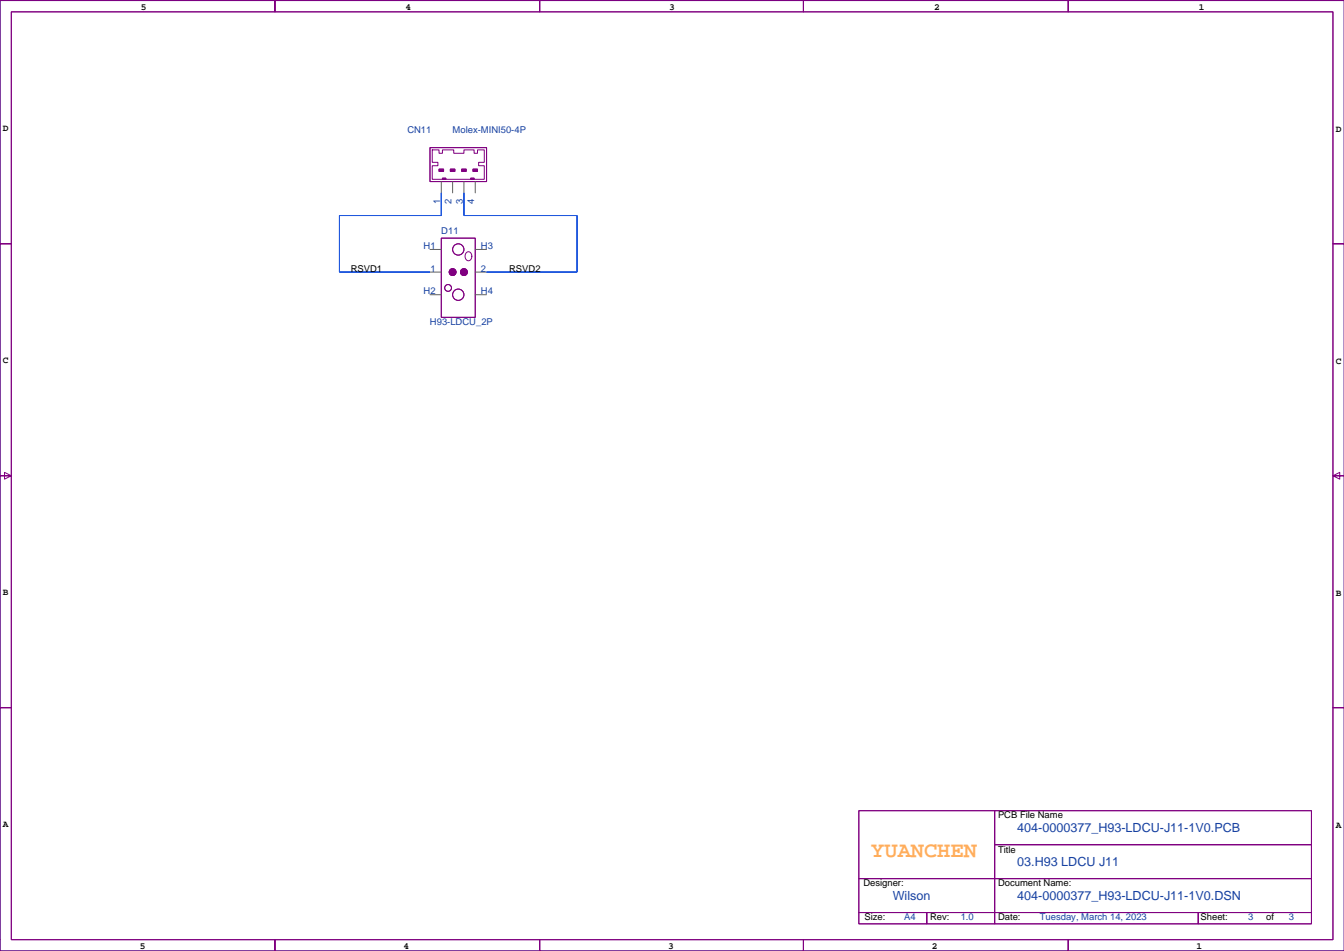
[picture p37: page 1]
Designer:; Rev:; Date:; Sheet:; Document Name:; Size:; Title; Tuesday, March 14, 2023; 404-0000377_H93-LDCU-J11-1V0.DSN; 03.H93 LDCU J11; Wilson; Molex-MINI50-4P; H93-LDCU_2P; RSVD1; RSVD2; YUANCHEN

PCB File Name
404-0000377_H93-LDCU-J11-1V0.PCB
