Fred-Guo0422/H93_LDCU_EOL_TESTER/document/H93_LDCU/H93-LDCU_产品假连接器原理图/L-J2.pdf

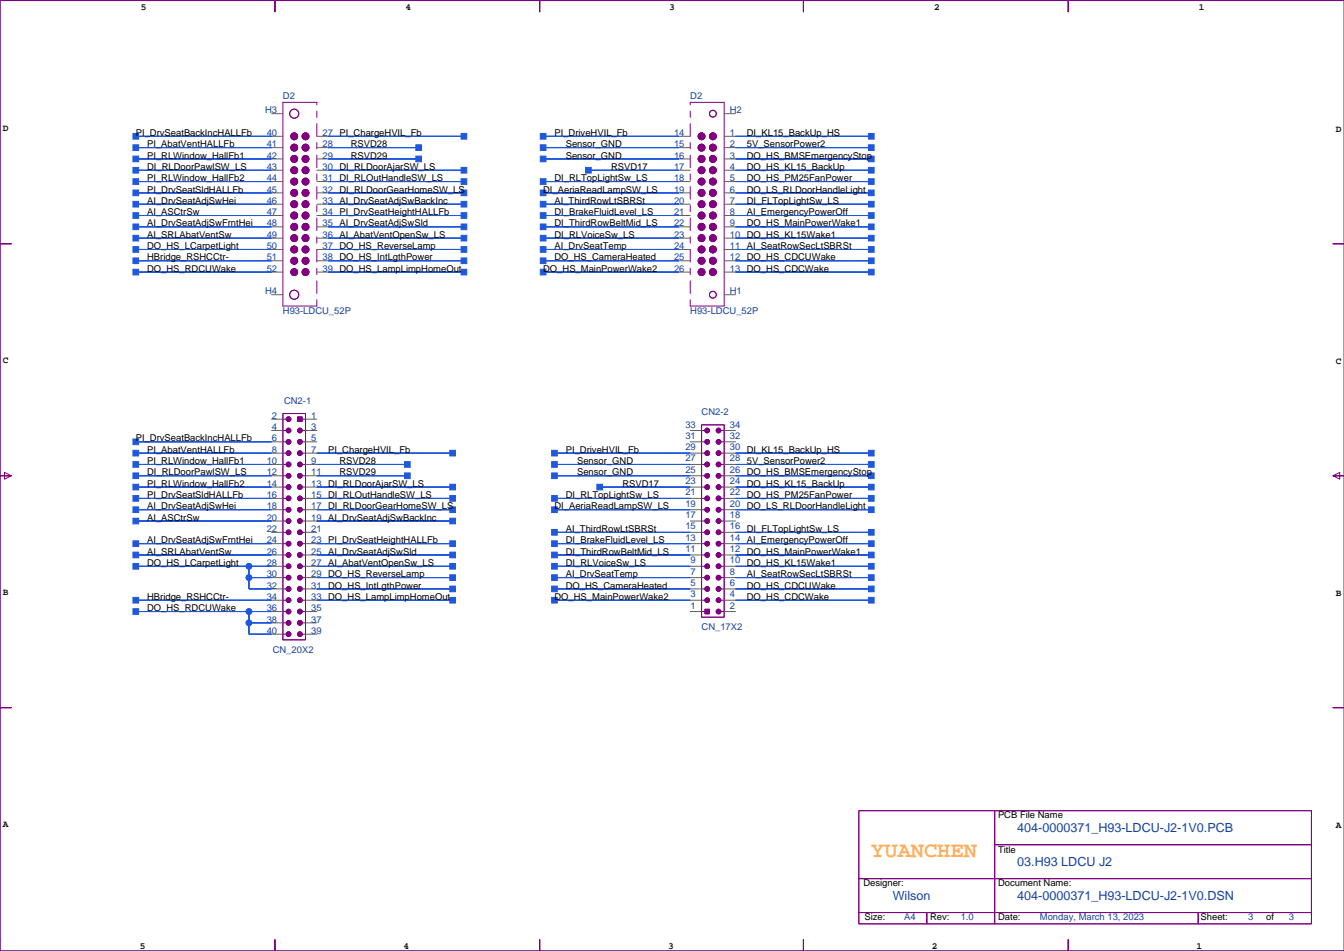
[picture p38: page 1]
Designer:; Rev:; Date:; Sheet:; Document Name:; Size:; Title; Monday, March 13, 2023; 404-0000371_H93-LDCU-J2-1V0.DSN; 03.H93 LDCU J2; Wilson; H93-LDCU_52P; DI_RLDoorPawlSW_LS; AI_ASCtrSw; DI_RLDoorAjarSW_LS; AI_DrvSeatAdjSwFrntHei; DO_HS_IntLgthPower; HBridge_RSHCCtr-; DO_HS_ReverseLamp; DO_HS_LampLimpHomeOut; AI_AbatVentOpenSw_LS; AI_DrvSeatAdjSwSld; PI_DrvSeatHeightHALLFb; RSVD28; PI_ChargeHVIL_Fb; DI_RLDoorGearHomeSW_LS; PI_AbatVentHALLFb; RSVD29; DI_RLOutHandleSW_LS; AI_DrvSeatAdjSwHei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

PCB File Name
404-0000371_H93-LDCU-J2-1V0.PCB
