Fred-Guo0422/H93_LDCU_EOL_TESTER/document/H93_LDCU/H93-LDCU_产品假连接器原理图/L-J3.pdf

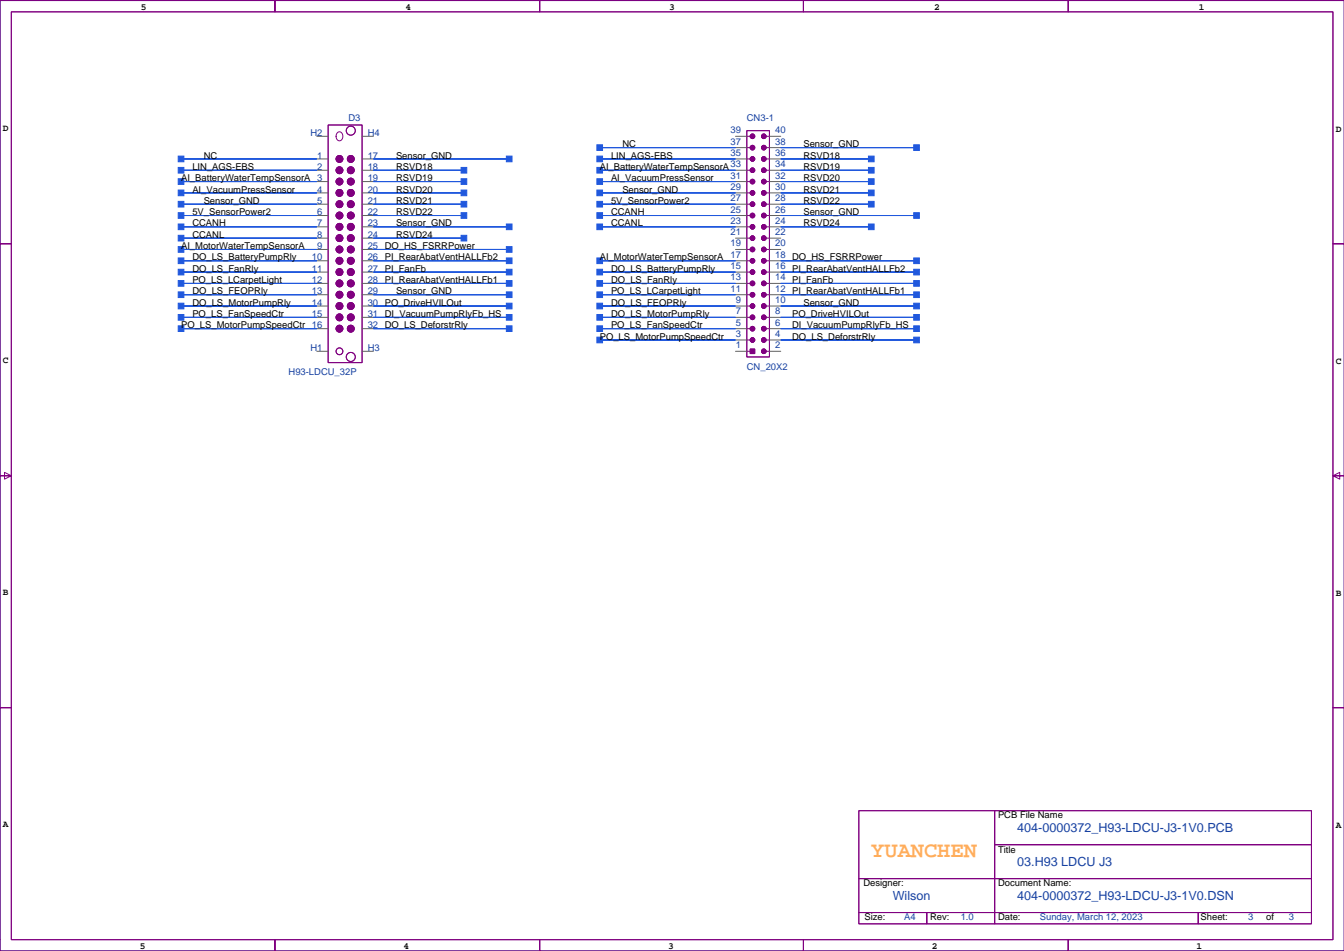
[picture p39: page 1]
Title; 03.H93 LDCU J3; H93-LDCU_32P; DO_LS_BatteryPumpRly; PO_LS_LCarpetLight; DO_LS_FanRly; PO_LS_MotorPumpSpeedCtr; AI_BatteryWaterTempSensorA; CCANL; CCANH; PI_RearAbatVentHALLFb1; 5V_SensorPower2; PI_FanFb; PI_RearAbatVentHALLFb2; DO_HS_FSRRPower; Sensor_GND; PO_LS_FanSpeedCtr; AI_MotorWaterTempSensorA; RSVD18; DO_LS_MotorPumpRly; RSVD19; RSVD20; AI_VacuumPressSensor; RSVD21; LIN_AGS-EBS; DO_LS_DeforstrRly; DI_VacuumPumpRlyFb_HS; PO_DriveHVILOut; RSVD24; RSVD22; DO_LS_FEOPRly; YUANCHEN

PCB File Name
404-0000372_H93-LDCU-J3-1V0.PCB

Designer: Wilson | Document Name: 404-0000372_H93-LDCU-J3-1V0.DSN

Size: A4 | Rev: 1.0 | Date: Sunday, March 12, 2023 | Sheet: 3 of 3
