Fred-Guo0422/H93_LDCU_EOL_TESTER/document/H93_LDCU/H93-LDCU_产品假连接器原理图/L-J4.pdf

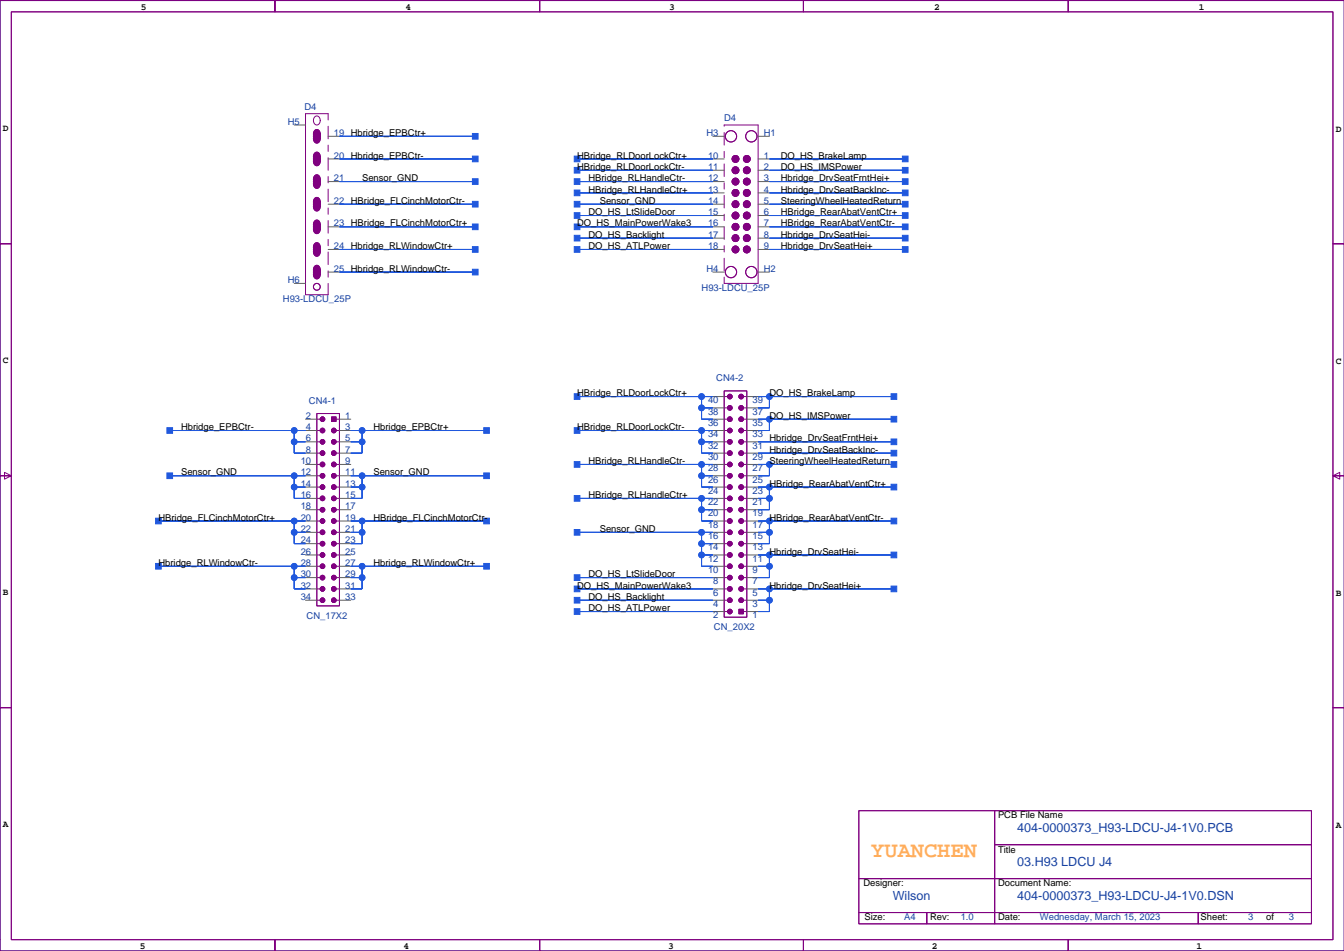
[picture p40: page 1]
Designer:; Rev:; Date:; Sheet:; Document Name:; Size:; Title; Wednesday, March 15, 2023; Wilson; 03.H93 LDCU J4; 404-0000373_H93-LDCU-J4-1V0.DSN; H93-LDCU_25P; HBridge_FLCinchMotorCtr-; HBridge_FLCinchMotorCtr+; Hbridge_RLWindowCtr-; Hbridge_EPBCtr-; Hbridge_RLWindowCtr+; Hbridge_EPBCtr+; DO_HS_IMSPower; SteeringWheelHeatedReturn; DO_HS_BrakeLamp; DO_HS_Backlight; Hbridge_DrvSeatHei+; HBridge_RearAbatVentCtr-; DO_HS_ATLPower; HBridge_RearAbatVentCtr+; DO_HS_MainPowerWake3; Sensor_GND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

PCB File Name
404-0000373_H93-LDCU-J4-1V0.PCB
