Fred-Guo0422/H93_LDCU_EOL_TESTER/document/H93_LDCU/H93-LDCU_产品假连接器原理图/L-J5.pdf

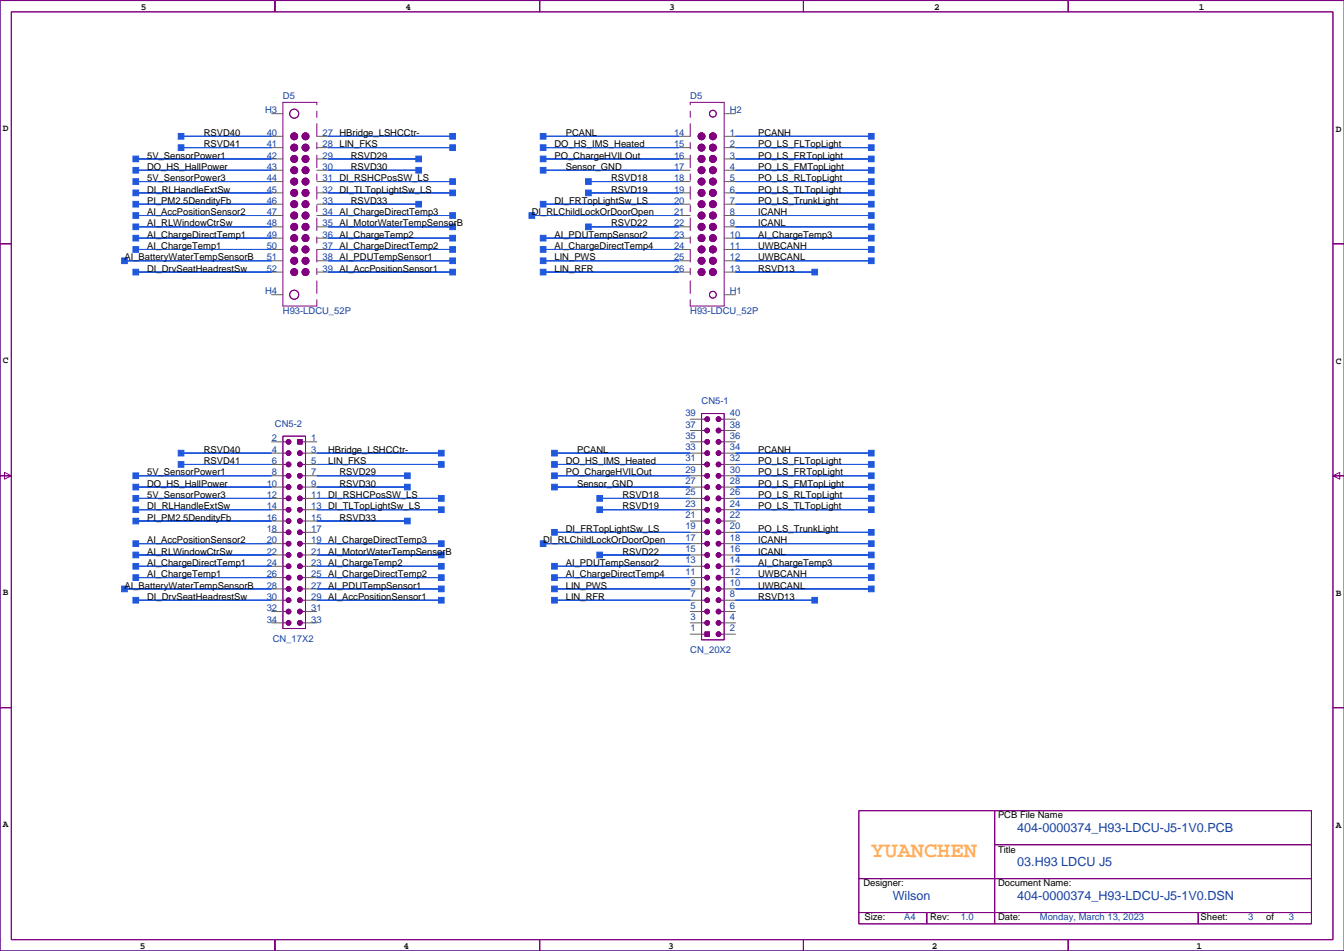
[picture p41: page 1]
Title; 03.H93 LDCU J5; H93-LDCU_52P; PO_LS_TLTopLight; RSVD22; PO_ChargeHVILOut; RSVD19; ICANL; ICANH; PO_LS_TrunkLight; AI_ChargeDirectTemp4; DO_HS_IMS_Heated; RSVD13; AI_ChargeTemp3; UWBCANL; UWBCANH; PCANH; DI_RLChildLockOrDoorOpen; LIN_RFR; PO_LS_FRTopLight; PO_LS_FLTopLight; AI_PDUTempSensor2; PO_LS_RLTopLight; DI_FRTopLightSw_LS; PO_LS_FMTopLight; RSVD18; Sensor_GND; PCANL; LIN_PWS; AI_ChargeTemp2; AI_ChargeDirectTemp1; AI_AccPositionSensor1; RSVD33; AI_AccPositionSensor2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

PCB File Name
404-0000374_H93-LDCU-J5-1V0.PCB

Designer: Wilson | Document Name: 404-0000374_H93-LDCU-J5-1V0.DSN

Size: A4 | Rev: 1.0 | Date: Monday, March 13, 2023 | Sheet: 3 of 3
