Fred-Guo0422/H93_LDCU_EOL_TESTER/document/H93_LDCU/H93-LDCU_产品假连接器原理图/L-J6.pdf

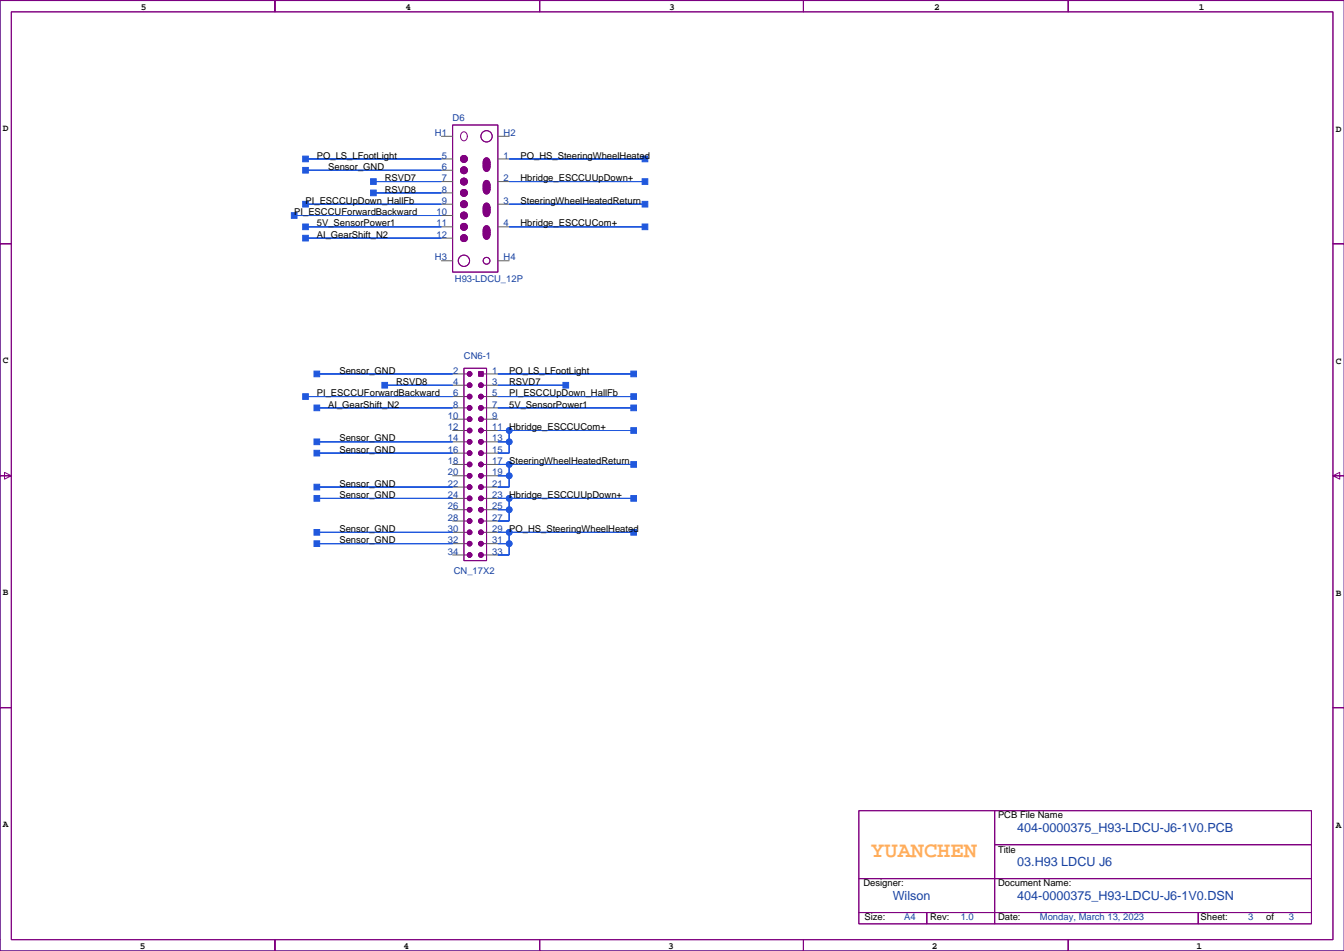
[picture p42: page 1]
Designer:; Rev:; Date:; Sheet:; Document Name:; Size:; Title; Monday, March 13, 2023; 404-0000375_H93-LDCU-J6-1V0.DSN; 03.H93 LDCU J6; Wilson; H93-LDCU_12P; PO_HS_SteeringWheelHeated; PI_ESCCUForwardBackward; PO_LS_LFootLight; 5V_SensorPower1; Hbridge_ESCCUCom+; PI_ESCCUpDown_HallFb; Sensor_GND; Sensor_GND Sensor_GND; Hbridge_ESCCUUpDown+; AI_GearShift_N2; SteeringWheelHeatedReturn; RSVD7; RSVD8; YUANCHEN

PCB File Name
404-0000375_H93-LDCU-J6-1V0.PCB
