Fred-Guo0422/H93_LDCU_EOL_TESTER/document/H93_LDCU/H93-LDCU_产品假连接器原理图/L-J7.pdf

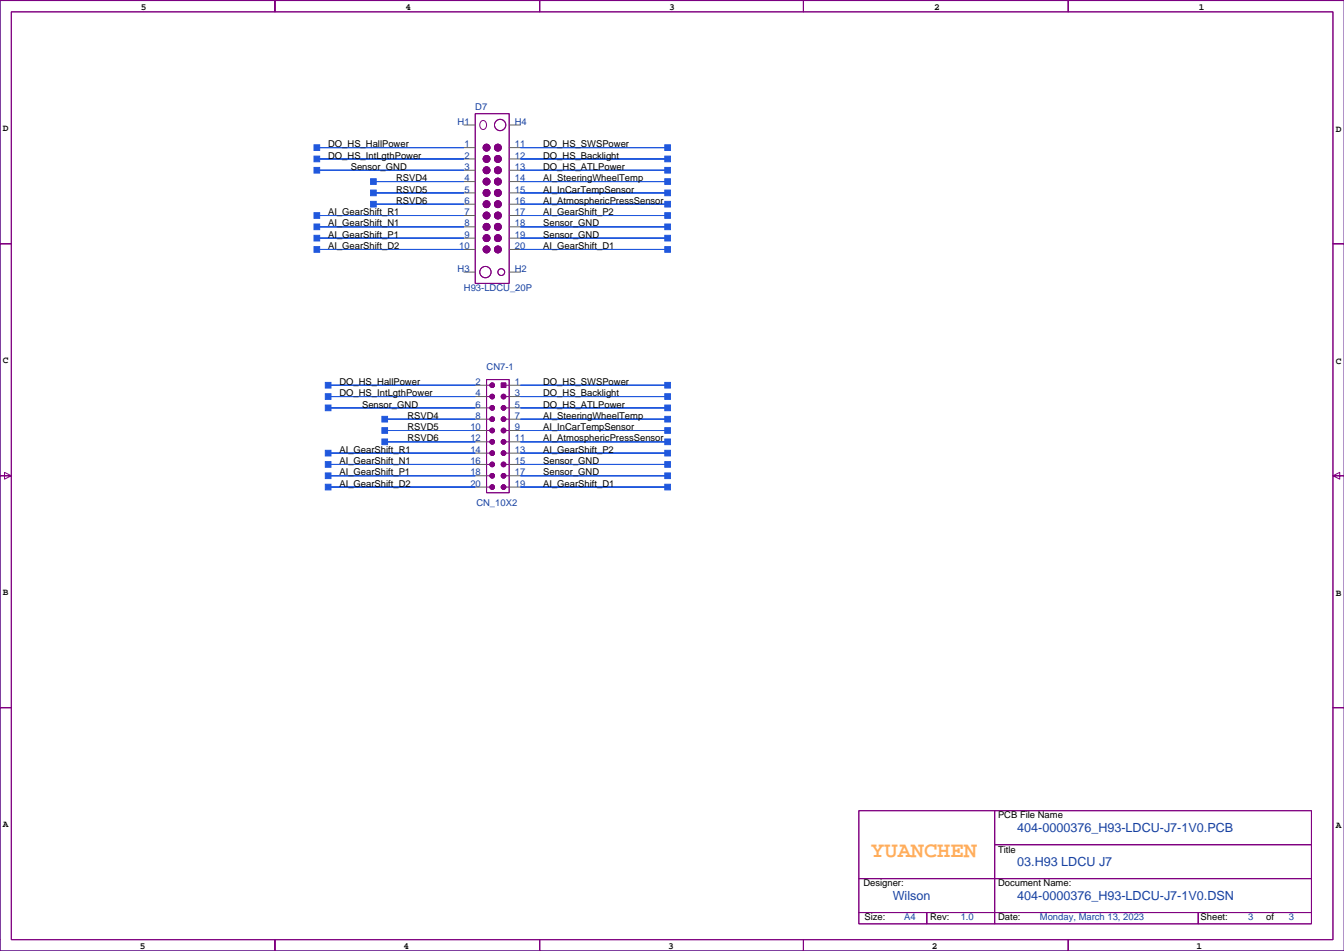
[picture p43: page 1]
Title; 03.H93 LDCU J7; H93-LDCU_20P; AI_InCarTempSensor; AI_AtmosphericPressSensor; AI_SteeringWheelTemp; AI_GearShift_P2; DO_HS_ATLPower; DO_HS_Backlight; RSVD4; DO_HS_SWSPower; RSVD5; AI_GearShift_P1; DO_HS_IntLgthPower; DO_HS_HallPower; AI_GearShift_D1; AI_GearShift_D2; AI_GearShift_N1; AI_GearShift_R1; RSVD6; Sensor_GND; Sensor_GND Sensor_GND; YUANCHEN

PCB File Name
404-0000376_H93-LDCU-J7-1V0.PCB

Designer: Wilson | Document Name: 404-0000376_H93-LDCU-J7-1V0.DSN

Size: A4 | Rev: 1.0 | Date: Monday, March 13, 2023 | Sheet: 3 of 3
