Fred-Guo0422/H93_LDCU_EOL_TESTER/document/H93_LDCU/H93-LDCU_产品假连接器原理图/L-J8.pdf

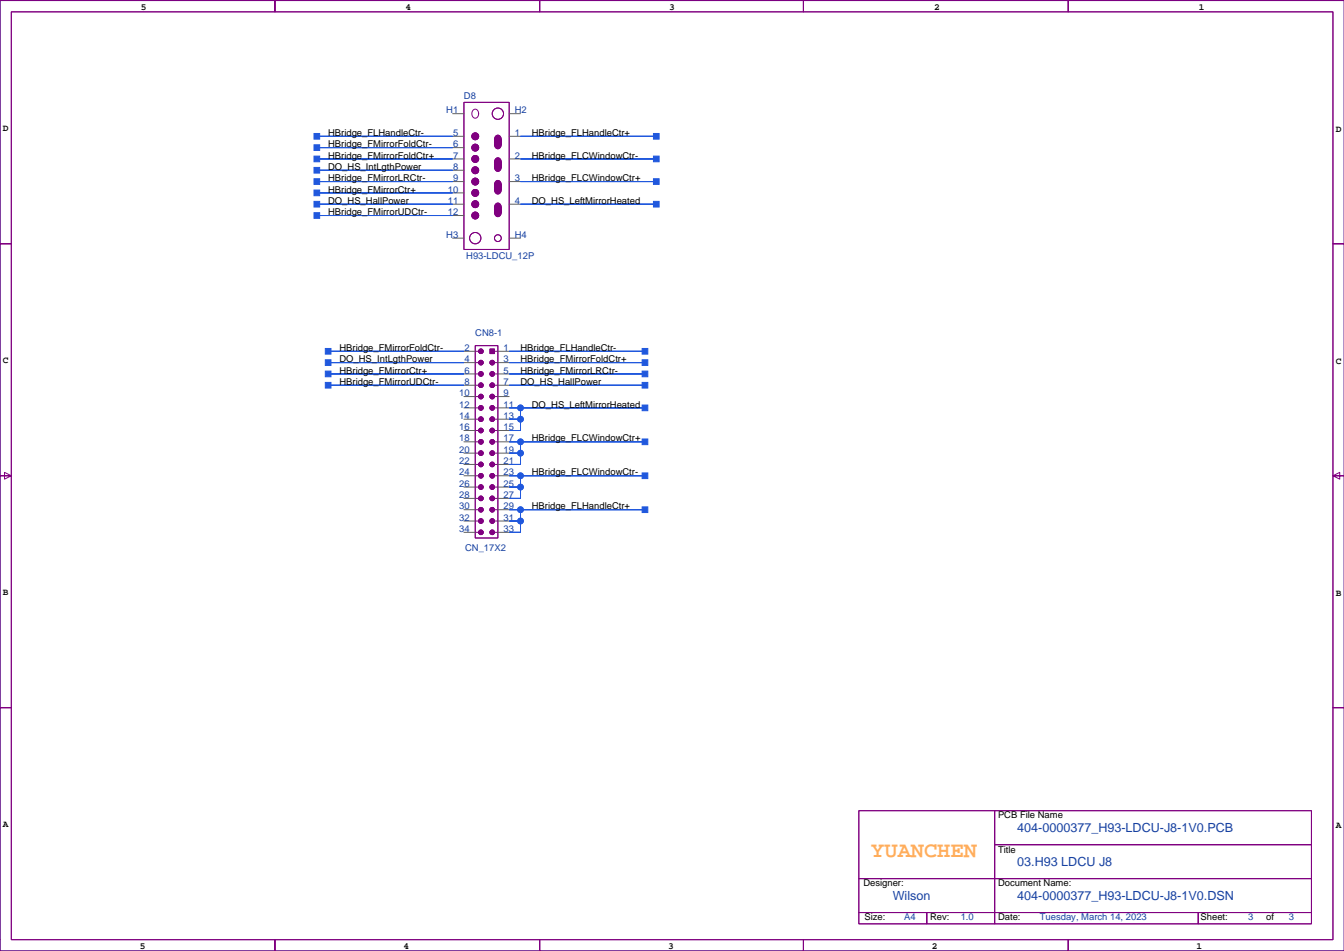
[picture p44: page 1]
Designer:; Rev:; Date:; Sheet:; Document Name:; Size:; Title; Tuesday, March 14, 2023; Wilson; 03.H93 LDCU J8; 404-0000377_H93-LDCU-J8-1V0.DSN; H93-LDCU_12P; HBridge_FLCWindowCtr-; HBridge_FLCWindowCtr+; HBridge_FLHandleCtr+; DO_HS_LeftMirrorHeated; HBridge_FLHandleCtr-; HBridge_FMirrorFoldCtr-; HBridge_FMirrorFoldCtr+; DO_HS_IntLgthPower; HBridge_FMirrorLRCtr-; HBridge_FMirrorCtr+; DO_HS_HallPower; HBridge_FMirrorUDCtr-; YUANCHEN

PCB File Name
404-0000377_H93-LDCU-J8-1V0.PCB
