Fred-Guo0422/H93_LDCU_EOL_TESTER/document/H93_LDCU/H93-LDCU_产品假连接器原理图/L-J9.pdf

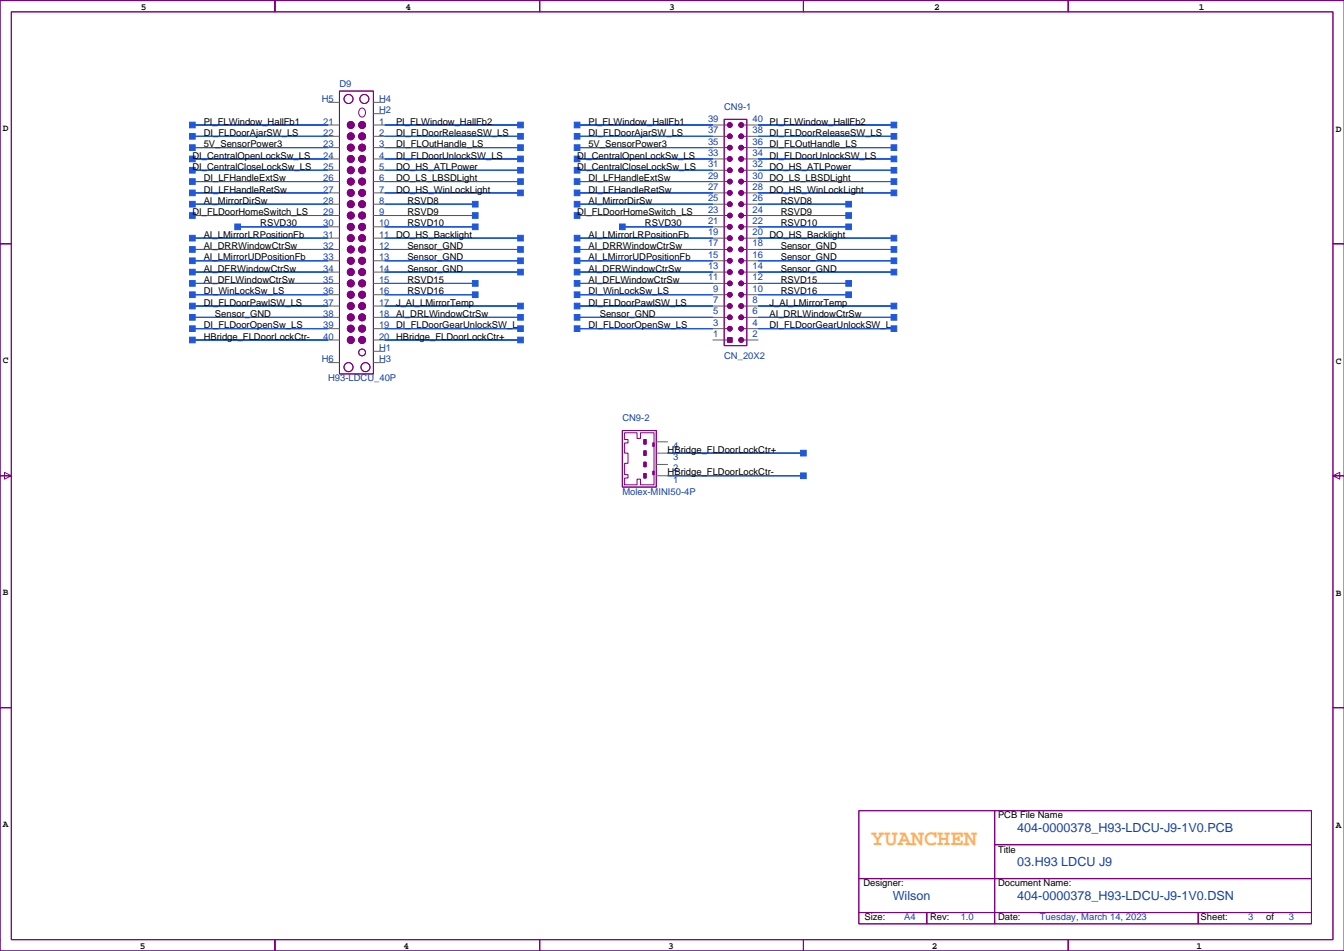
[picture p45: page 1]
Title; 03.H93 LDCU J9; H93-LDCU_40P; Molex-MINI50-4P; RSVD15; RSVD10; DI_LFHandleExtSw; DI_FLOutHandle_LS; Sensor_GND; Sensor_GND Sensor_GND Sensor_GND; DI_FLDoorGearUnlockSW_L; AI_MirrorDirSw; AI_DRLWindowCtrSw; DI_CentralCloseLockSw_LS; PI_FLWindow_HallFb2; J_AI_LMirrorTemp; PI_FLWindow_HallFb1; DI_FLDoorOpenSw_LS; DI_CentralOpenLockSw_LS; DI_FLDoorPawlSW_LS; DO_HS_Backlight; DO_HS_WinLockLight; 5V_SensorPower3; DI_WinLockSw_LS; DO_LS_LBSDLight; DI_FLDoorAjarSW_LS; DI_FLDoorHomeSwitch_LS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

PCB File Name
404-0000378_H93-LDCU-J9-1V0.PCB

Designer: Wilson | Document Name: 404-0000378_H93-LDCU-J9-1V0.DSN

Size: A4 | Rev: 1.0 | Date: Tuesday, March 14, 2023 | Sheet: 3 of 3
