Fred-Guo0422/H93_LDCU_EOL_TESTER/document/H93_LDCU/H93-LDCU_产品假连接器原理图/H93-LDCU.pdf

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

PCB File Name
404-0000370_H93-LDCU-J1-1V0.PCB

Designer: Wilson | Document Name: 404-0000370_H93-LDCU-J1-1V0.DSN

Size: A4 | Rev: | Date: Sunday, March 12, 2023 | Sheet: of 3

Title; Tuesday, March 14, 2023; 404-0000377_H93-LDCU-J11-1V0.DSN; 03.H93 LDCU J11; Molex-MINI50-4P; H93-LDCU_2P; RSVD1; RSVD2; YUANCHEN

PCB File Name
404-0000377_H93-LDCU-J11-1V0.PCB

Title; Monday, March 13, 2023; 404-0000371_H93-LDCU-J2-1V0.DSN; 03.H93 LDCU J2; H93-LDCU_52P; DI_RLDoorPawlSW_LS; AI_ASCtrSw; DI_RLDoorAjarSW_LS; AI_DrvSeatAdjSwFrntHei; DO_HS_IntLgthPower; HBridge_RSHCCtr-; DO_HS_ReverseLamp; DO_HS_LampLimpHomeOut; AI_AbatVentOpenSw_LS; AI_DrvSeatAdjSwSld; PI_DrvSeatHeightHALLFb; RSVD28; PI_ChargeHVIL_Fb; DI_RLDoorGearHomeSW_LS; PI_AbatVentHALLFb; RSVD29; DI_RLOutHandleSW_LS; AI_DrvSeatAdjSwHei; AI_SRLAbatVentSw; PI_RLWindow_HallFb1; PI_RLWindow_HallFb2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

PCB File Name
404-0000371_H93-LDCU-J2-1V0.PCB

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

PCB File Name
404-0000372_H93-LDCU-J3-1V0.PCB

404-0000372_H93-LDCU-J3-1V0.DSN

A4 | | Sunday, March 12, 2023 | 3

Title; Wednesday, March 15, 2023; 03.H93 LDCU J4; 404-0000373_H93-LDCU-J4-1V0.DSN; H93-LDCU_25P; HBridge_FLCinchMotorCtr-; HBridge_FLCinchMotorCtr+; Hbridge_RLWindowCtr-; Hbridge_EPBCtr-; Hbridge_RLWindowCtr+; Hbridge_EPBCtr+; DO_HS_IMSPower; SteeringWheelHeatedReturn; DO_HS_BrakeLamp; DO_HS_Backlight; Hbridge_DrvSeatHei+; HBridge_RearAbatVentCtr-; DO_HS_ATLPower; HBridge_RearAbatVentCtr+; DO_HS_MainPowerWake3; Sensor_GND; HBridge_RLHandleCtr+; HBridge_RLDoorLockCtr+; HBridge_RLHandleCtr-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

PCB File Name
404-0000373_H93-LDCU-J4-1V0.PCB

Title; 404-0000374_H93-LDCU-J5-1V0.DSN; 03.H93 LDCU J5; H93-LDCU_52P; PO_LS_TLTopLight; RSVD22; PO_ChargeHVILOut; RSVD19; ICANL; ICANH; PO_LS_TrunkLight; AI_ChargeDirectTemp4; DO_HS_IMS_Heated; RSVD13; AI_ChargeTemp3; UWBCANL; UWBCANH; PCANH; DI_RLChildLockOrDoorOpen; LIN_RFR; PO_LS_FRTopLight; PO_LS_FLTopLight; AI_PDUTempSensor2; PO_LS_RLTopLight; DI_FRTopLightSw_LS; PO_LS_FMTopLight; RSVD18; Sensor_GND; PCANL; LIN_PWS; AI_ChargeTemp2; AI_ChargeDirectTemp1; AI_AccPositionSensor1; RSVD33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

PCB File Name
404-0000374_H93-LDCU-J5-1V0.PCB

Title; 404-0000375_H93-LDCU-J6-1V0.DSN; 03.H93 LDCU J6; H93-LDCU_12P; PO_HS_SteeringWheelHeated; PI_ESCCUForwardBackward; PO_LS_LFootLight; 5V_SensorPower1; Hbridge_ESCCUCom+; PI_ESCCUpDown_HallFb; Sensor_GND; Sensor_GND Sensor_GND; Hbridge_ESCCUUpDown+; AI_GearShift_N2; SteeringWheelHeatedReturn; RSVD7; RSVD8; YUANCHEN

PCB File Name
404-0000375_H93-LDCU-J6-1V0.PCB

Title; 404-0000376_H93-LDCU-J7-1V0.DSN; 03.H93 LDCU J7; H93-LDCU_20P; AI_InCarTempSensor; AI_AtmosphericPressSensor; AI_SteeringWheelTemp; AI_GearShift_P2; DO_HS_ATLPower; DO_HS_Backlight; RSVD4; DO_HS_SWSPower; RSVD5; AI_GearShift_P1; DO_HS_IntLgthPower; DO_HS_HallPower; AI_GearShift_D1; AI_GearShift_D2; AI_GearShift_N1; AI_GearShift_R1; RSVD6; Sensor_GND; Sensor_GND Sensor_GND; YUANCHEN

PCB File Name
404-0000376_H93-LDCU-J7-1V0.PCB

Title; Tuesday, March 14, 2023; 03.H93 LDCU J8; 404-0000377_H93-LDCU-J8-1V0.DSN; H93-LDCU_12P; HBridge_FLCWindowCtr-; HBridge_FLCWindowCtr+; HBridge_FLHandleCtr+; DO_HS_LeftMirrorHeated; HBridge_FLHandleCtr-; HBridge_FMirrorFoldCtr-; HBridge_FMirrorFoldCtr+; DO_HS_IntLgthPower; HBridge_FMirrorLRCtr-; HBridge_FMirrorCtr+; DO_HS_HallPower; HBridge_FMirrorUDCtr-; YUANCHEN

PCB File Name
404-0000377_H93-LDCU-J8-1V0.PCB

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

PCB File Name
404-0000378_H93-LDCU-J9-1V0.PCB

404-0000378_H93-LDCU-J9-1V0.DSN

A4 | | Tuesday, March 14, 2023 | 3
