Fred-Guo0422/H93_LDCU_EOL_TESTER/document/New folder/负载箱图纸/H93-RDCU.pdf

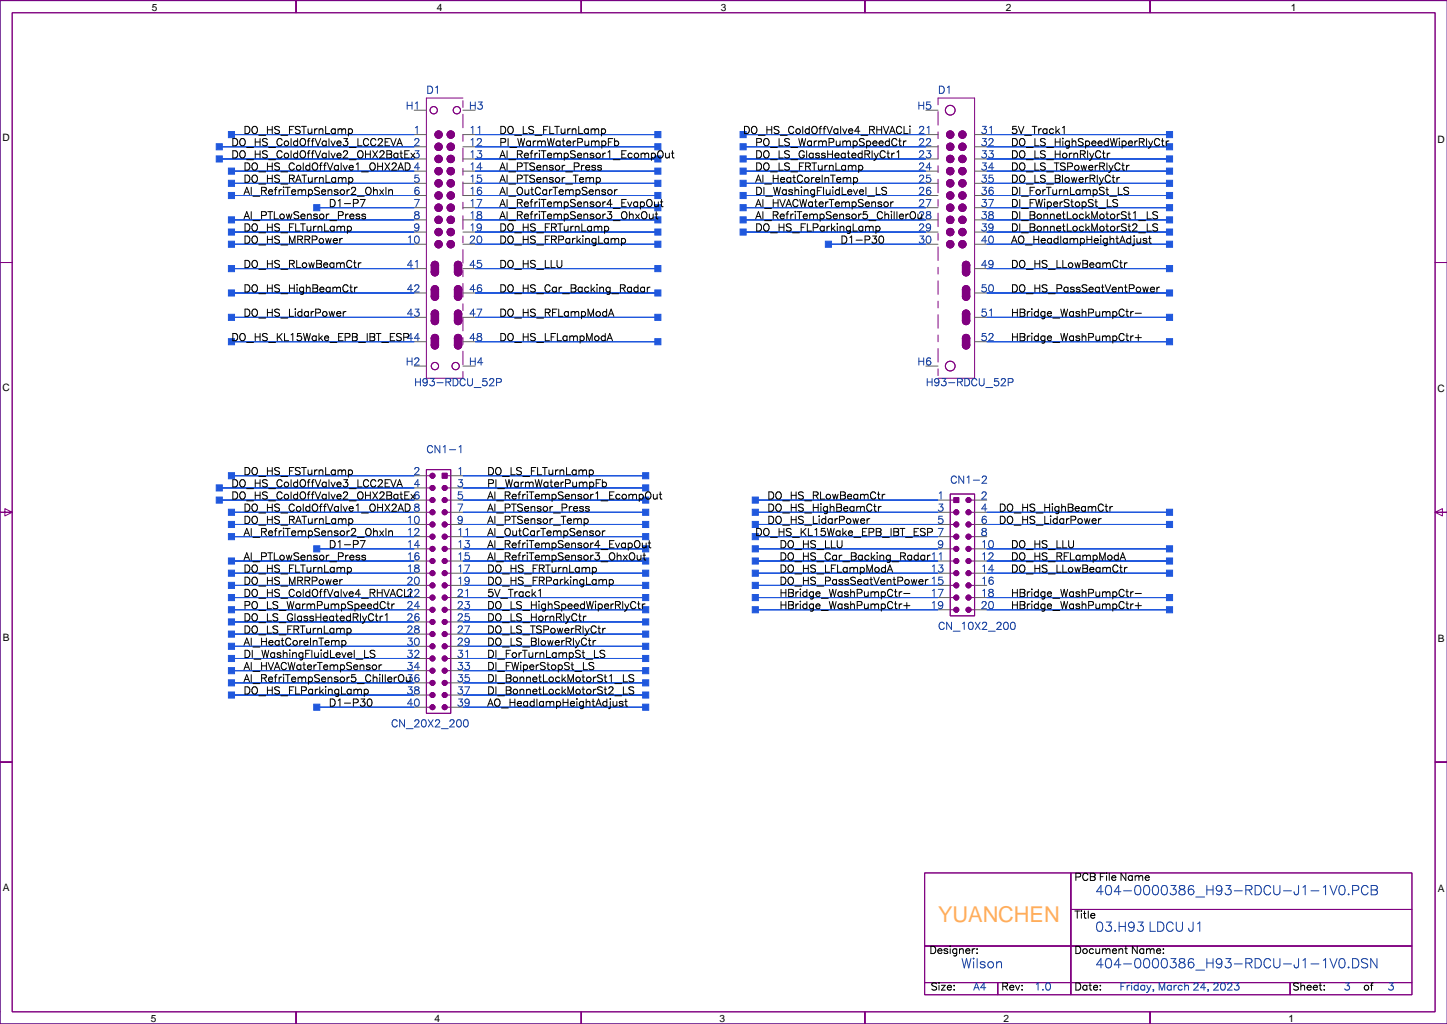
[picture p46: page 1]
Designer:; Rev:; Date:; Sheet:; Document Name:; Size:; Title; Friday, March 24, 2023; Wilson; 03.H93 LDCU J1; 404-0000386_H93-RDCU-J1-1V0.DSN; H93-RDCU_52P; PI_WarmWaterPumpFb; DI_BonnetLockMotorSt2_LS; DI_BonnetLockMotorSt1_LS; AI_HeatCoreInTemp; DO_LS_FLTurnLamp; DO_HS_ColdOffValve4_RHVACLi; DO_HS_FRParkingLamp; 5V_Track1; PO_LS_WarmPumpSpeedCtr; DO_HS_MRRPower; DO_HS_FRTurnLamp; DI_FWiperStopSt_LS; DO_HS_FLTurnLamp; AI_RefriTempSensor3_OhxOut; AI_RefriTempSensor4_EvapOut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

PCB File Name
404-0000386_H93-RDCU-J1-1V0.PCB

PCB File Name
404-0000386_H93-RDCU-J1-1V0.PCB

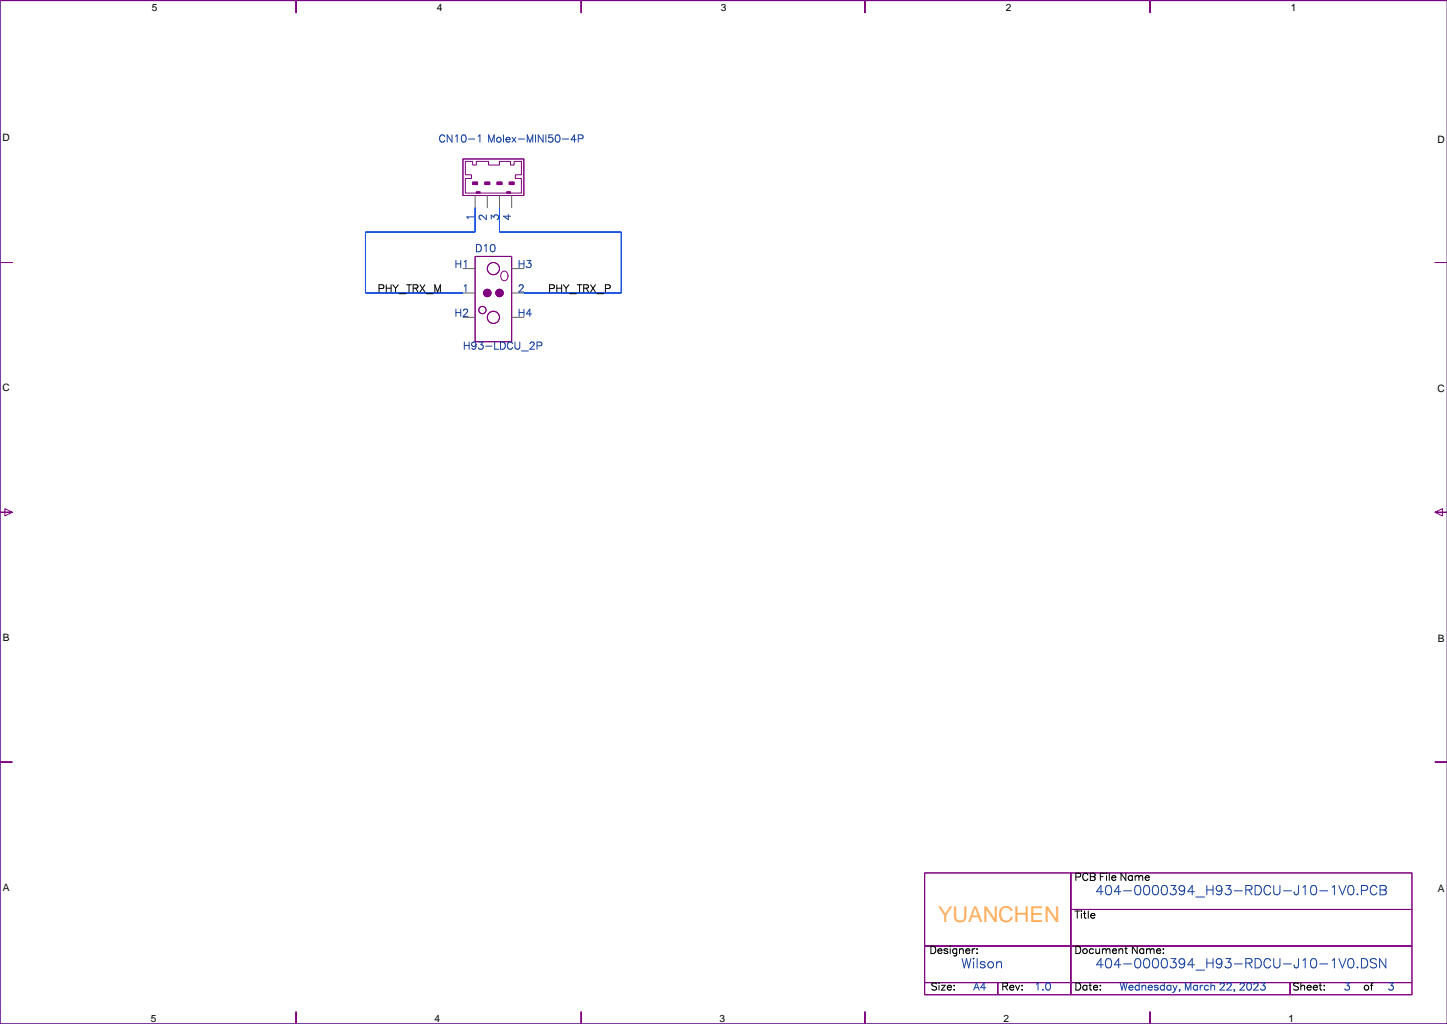
[picture p47: page 3]
Title; Wednesday, March 22, 2023; 404-0000394_H93-RDCU-J10-1V0.DSN; CN10-1 Molex-MINI50-4P; H93-LDCU_2P; PHY_TRX_M; PHY_TRX_P; YUANCHEN

PCB File Name
404-0000394_H93-RDCU-J10-1V0.PCB

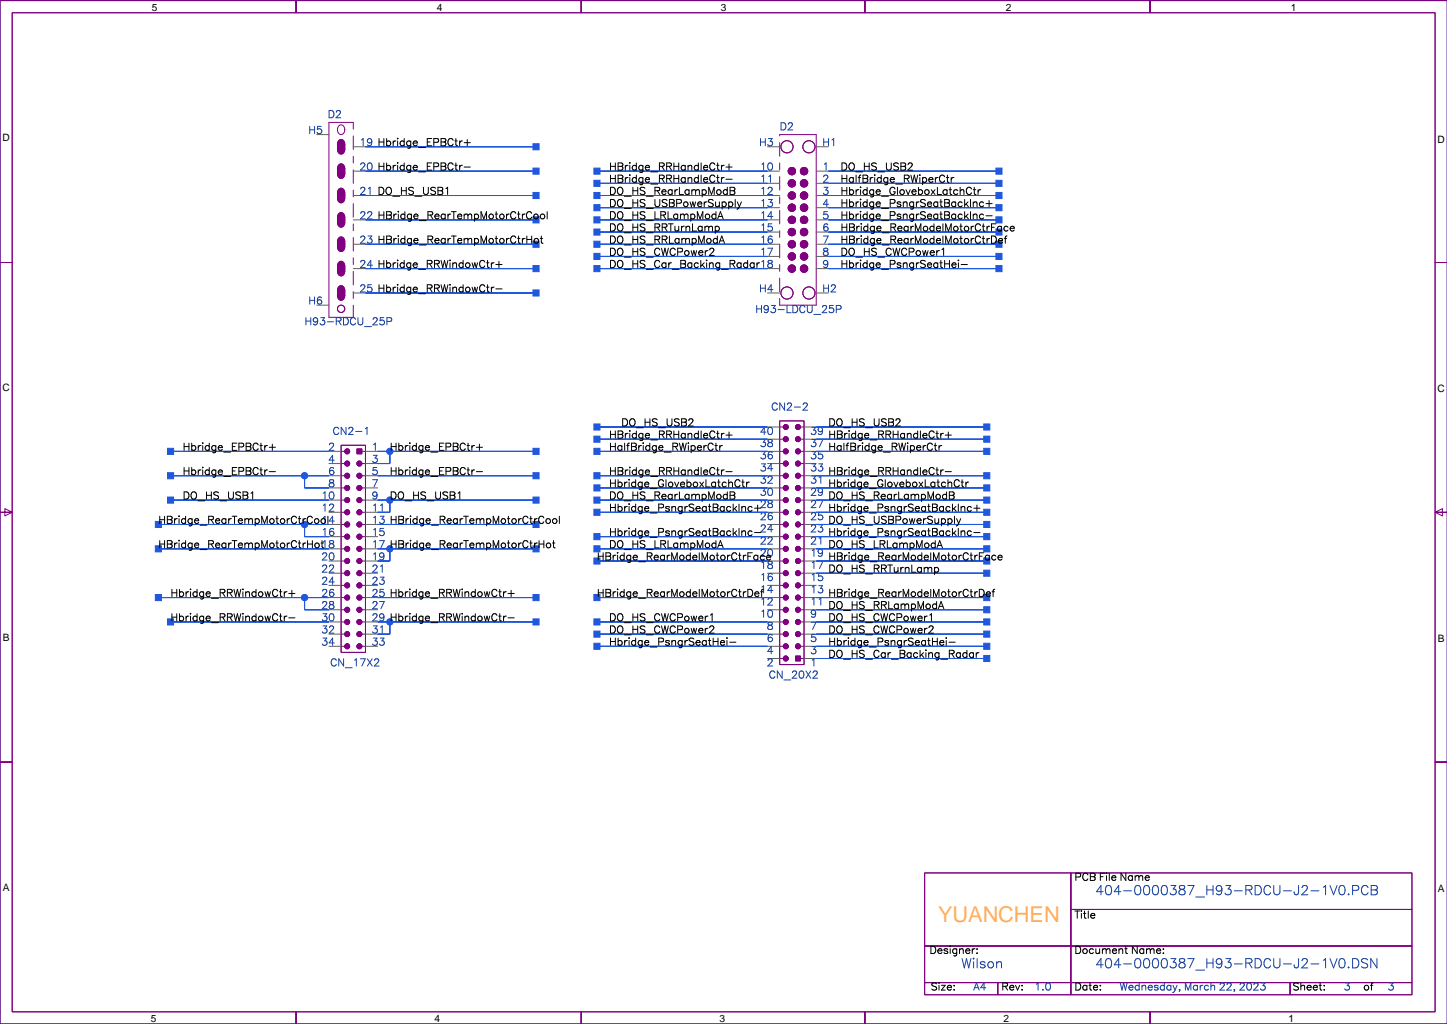
[picture p48: page 4]
Title; 404-0000387_H93-RDCU-J2-1V0.DSN; H93-RDCU_25P; H93-LDCU_25P; Hbridge_EPBCtr+; Hbridge_EPBCtr-; DO_HS_USB1; HBridge_RearTempMotorCtrCool; HBridge_RearTempMotorCtrHot; Hbridge_RRWindowCtr+; Hbridge_RRWindowCtr-; HBridge_RearModelMotorCtrDef; DO_HS_CWCPower2; Hbridge_PsngrSeatHei-; DO_HS_RRTurnLamp; DO_HS_USBPowerSupply; Hbridge_PsngrSeatBackInc-; DO_HS_CWCPower1; Hbridge_PsngrSeatBackInc+; Hbridge_GloveboxLatchCtr; HalfBridge_RWiperCtr; HBridge_RearModelMotorCtrFace; DO_HS_USB2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

PCB File Name
404-0000387_H93-RDCU-J2-1V0.PCB

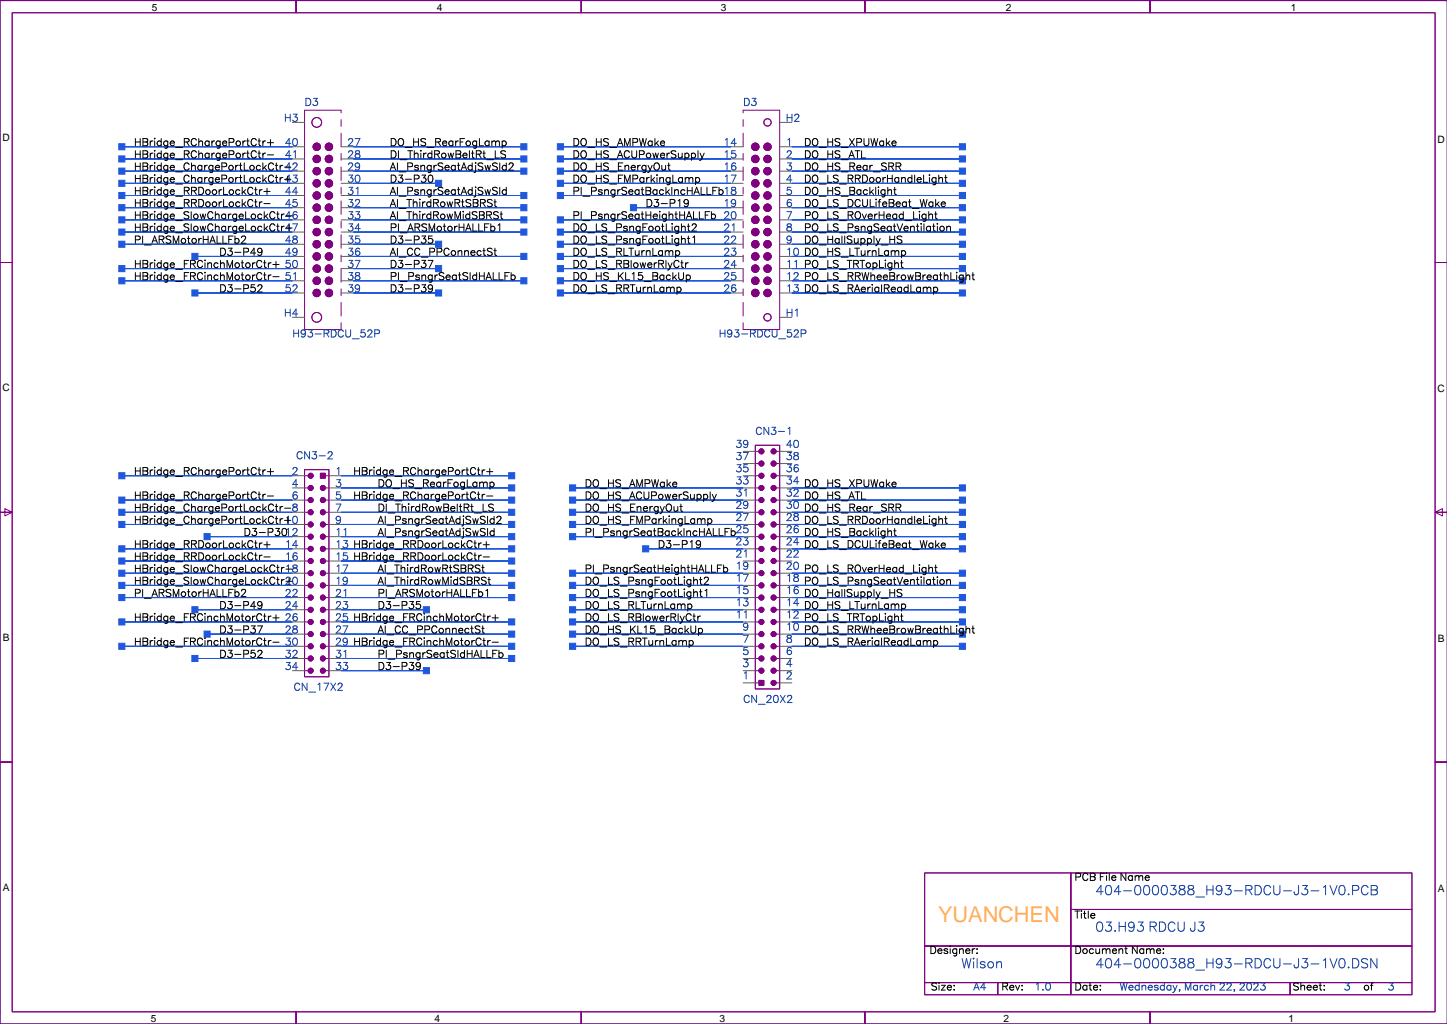
[picture p49: page 5]
Title; 404-0000388_H93-RDCU-J3-1V0.DSN; 03.H93 RDCU J3; H93-RDCU_52P; PO_LS_ROverHead_Light; PO_LS_RRWheeBrowBreathLight; DO_HS_LTurnLamp; DO_HallSupply_HS; PO_LS_PsngSeatVentilation; PO_LS_TRTopLight; DO_HS_Rear_SRR; DO_LS_RRDoorHandleLight; DO_HS_ATL; DO_HS_Backlight; DO_LS_DCULifeBeat_Wake; DO_HS_XPUWake; DO_HS_AMPWake; PI_PsngrSeatBackIncHALLFb; DO_HS_FMParkingLamp; DO_HS_EnergyOut; DO_HS_ACUPowerSupply; DO_LS_RRTurnLamp; DO_HS_KL15_BackUp; DO_LS_PsngFootLight1; DO_LS_RLTurnLamp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

PCB File Name
404-0000388_H93-RDCU-J3-1V0.PCB

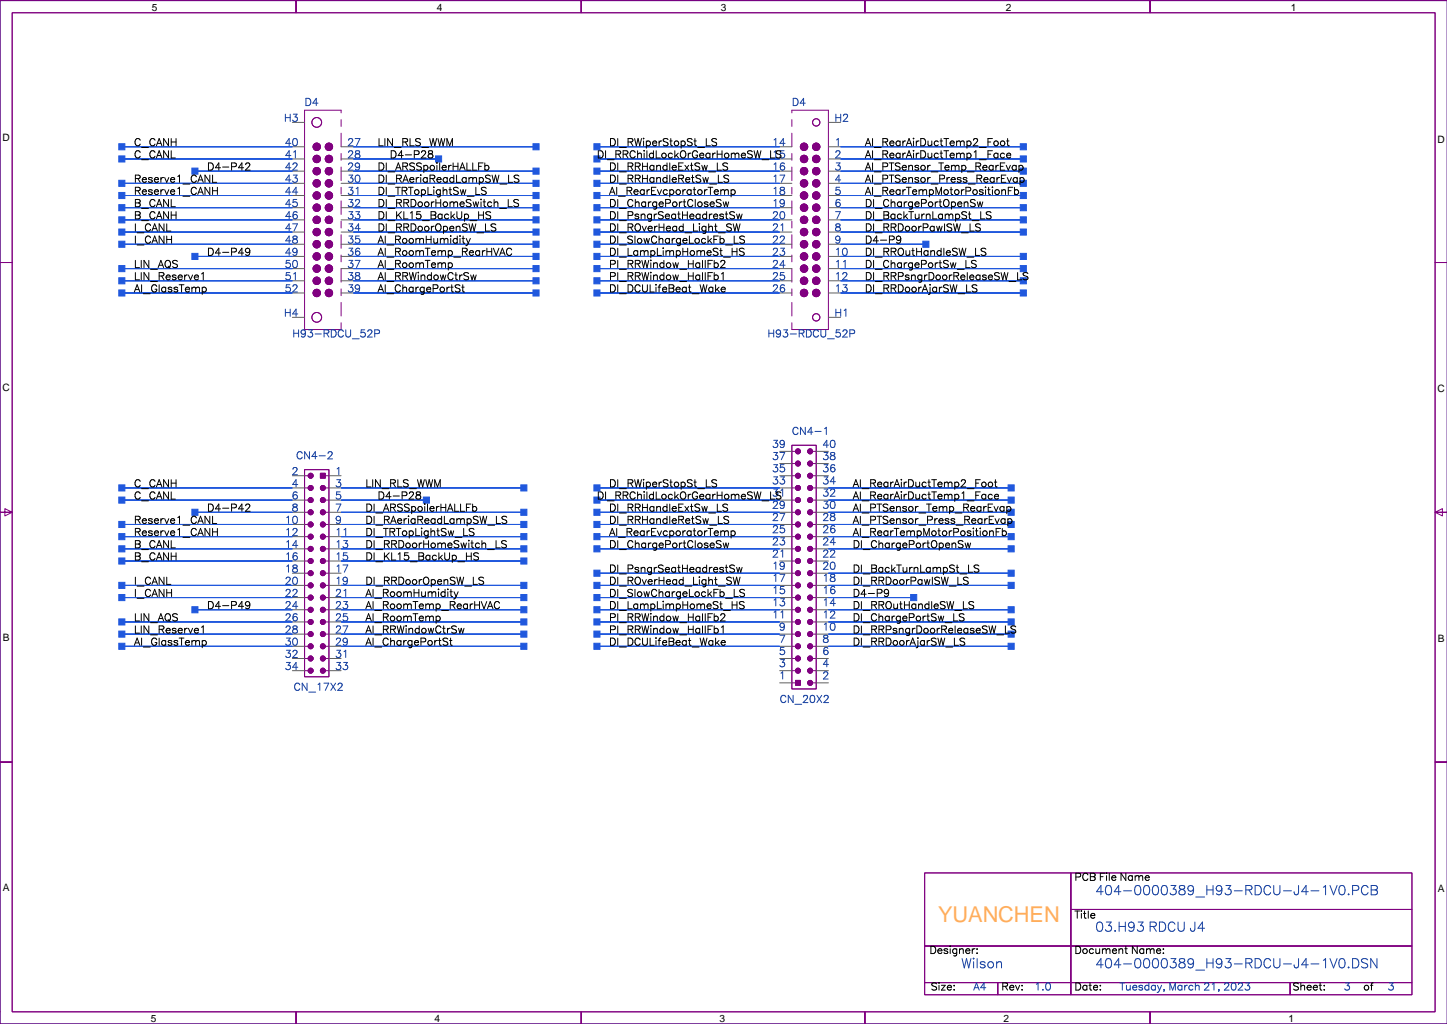
[picture p50: page 6]
Title; Tuesday, March 21, 2023; 404-0000389_H93-RDCU-J4-1V0.DSN; 03.H93 RDCU J4; H93-RDCU_52P; AI_PTSensor_Press_RearEvap; AI_RearAirDuctTemp2_Foot; DI_ChargePortOpenSw; AI_PTSensor_Temp_RearEvap; AI_RearAirDuctTemp1_Face; AI_RearTempMotorPositionFb; DI_BackTurnLampSt_LS; DI_RRDoorPawlSW_LS; DI_RRDoorAjarSW_LS; DI_ChargePortSw_LS; DI_RROutHandleSW_LS; DI_RRPsngrDoorReleaseSW_LS; DI_RRHandleRetSw_LS; DI_RRHandleExtSw_LS; DI_RRChildLockOrGearHomeSW_LS; DI_RWiperStopSt_LS; DI_ChargePortCloseSw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

PCB File Name
404-0000389_H93-RDCU-J4-1V0.PCB

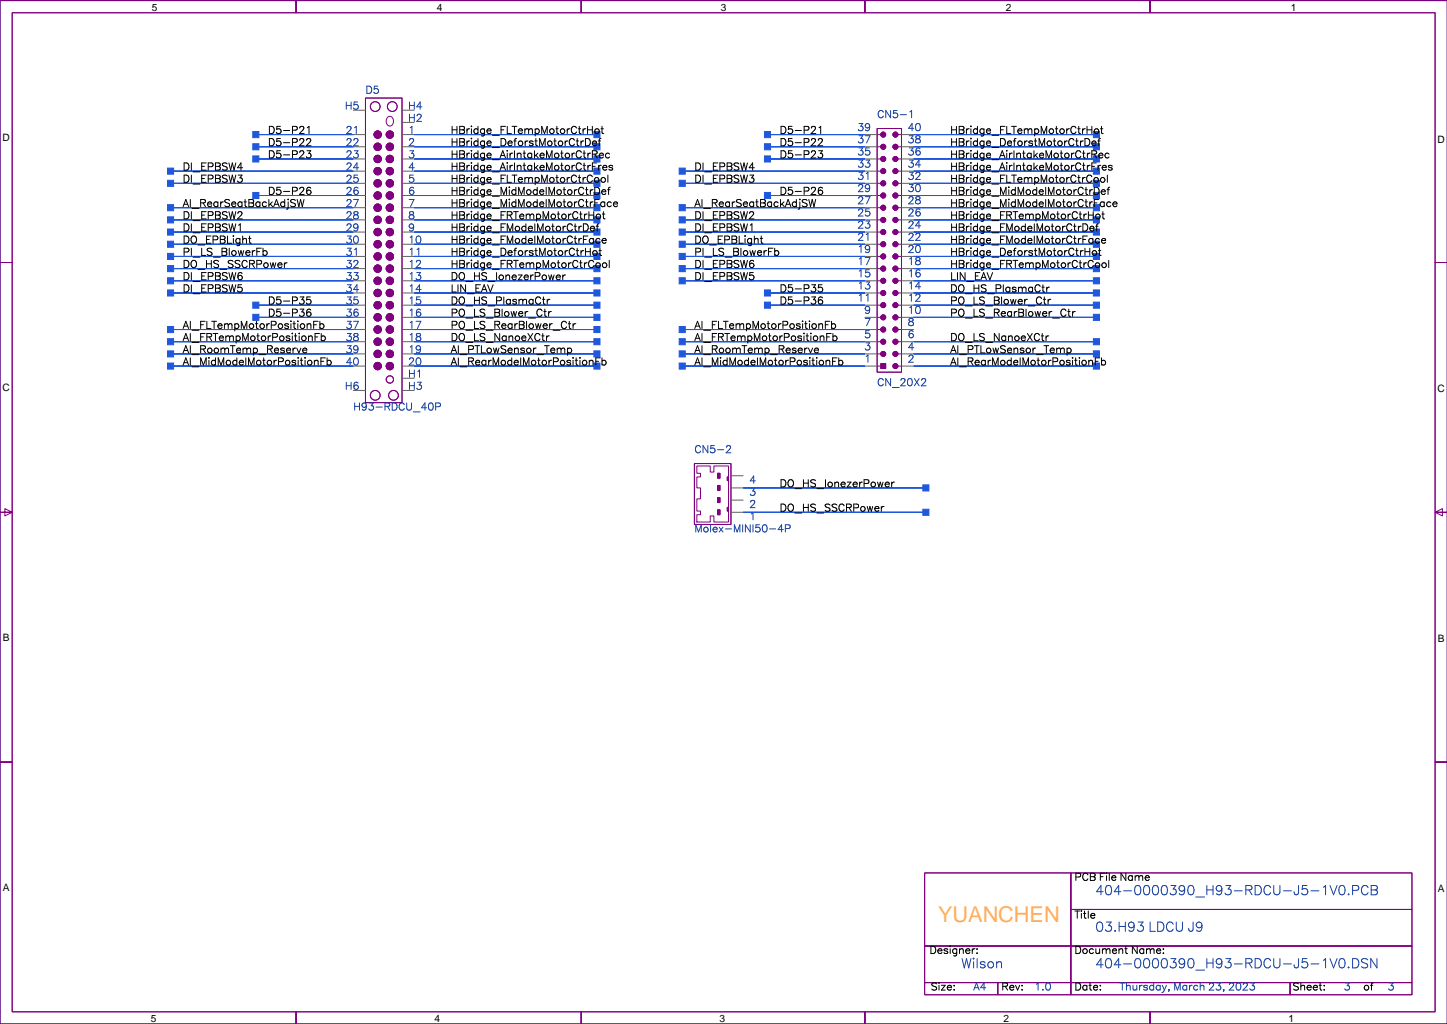
[picture p51: page 7]
Title; Thursday, March 23, 2023; 03.H93 LDCU J9; 404-0000390_H93-RDCU-J5-1V0.DSN; H93-RDCU_40P; Molex-MINI50-4P; DO_HS_SSCRPower; DO_HS_IonezerPower; HBridge_FRTempMotorCtrHot; HBridge_FRTempMotorCtrCool; HBridge_DeforstMotorCtrHot; AI_FLTempMotorPositionFb; HBridge_FModelMotorCtrDef; HBridge_AirIntakeMotorCtrFres; HBridge_MidModelMotorCtrFace; DI_EPBSW1; HBridge_FModelMotorCtrFace; HBridge_MidModelMotorCtrDef; PI_LS_BlowerFb; AI_PTLowSensor_Temp; HBridge_DeforstMotorCtrDef; DO_LS_NanoeXCtr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

PCB File Name
404-0000390_H93-RDCU-J5-1V0.PCB

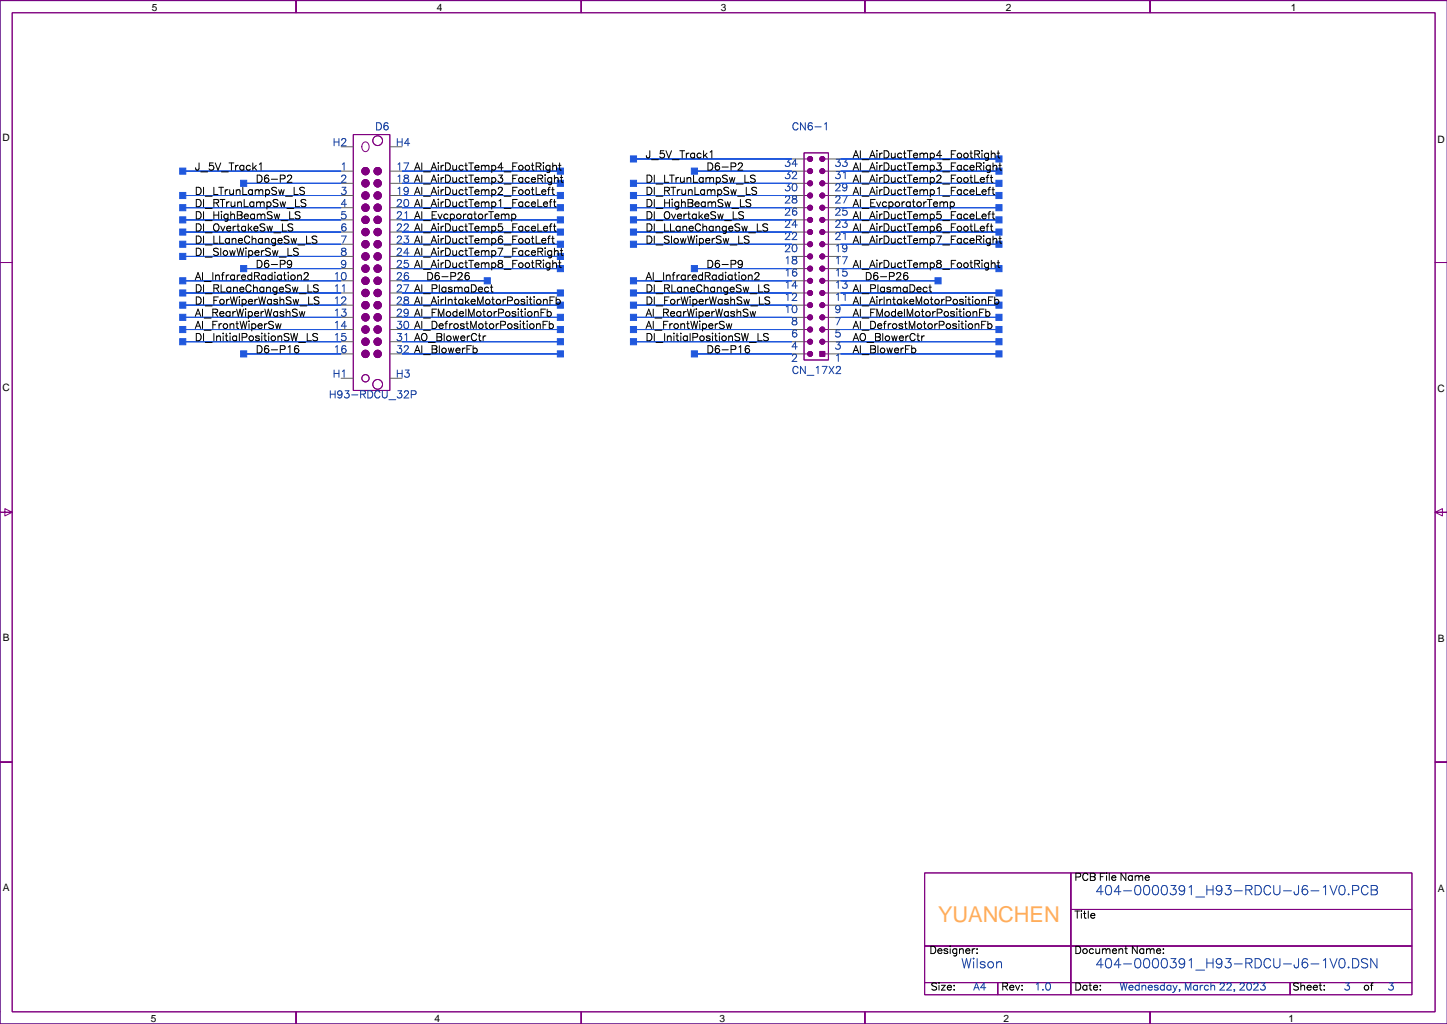
[picture p52: page 8]
Title; 404-0000391_H93-RDCU-J6-1V0.DSN; H93-RDCU_32P; DI_LTrunLampSw_LS; AI_AirDuctTemp4_FootRight; DI_InitialPositionSW_LS; DI_LLaneChangeSw_LS; AI_FrontWiperSw; DI_OvertakeSw_LS; AI_RearWiperWashSw; DI_HighBeamSw_LS; DI_ForWiperWashSw_LS; DI_RTrunLampSw_LS; DI_RLaneChangeSw_LS; J_5V_Track1; AI_PlasmaDect; AI_AirDuctTemp1_FaceLeft; AI_AirDuctTemp2_FootLeft; AI_AirDuctTemp3_FaceRight; AI_AirDuctTemp7_FaceRight; AI_AirDuctTemp8_FootRight; AI_AirDuctTemp6_FootLeft; AI_AirIntakeMotorPositionFb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

PCB File Name
404-0000391_H93-RDCU-J6-1V0.PCB

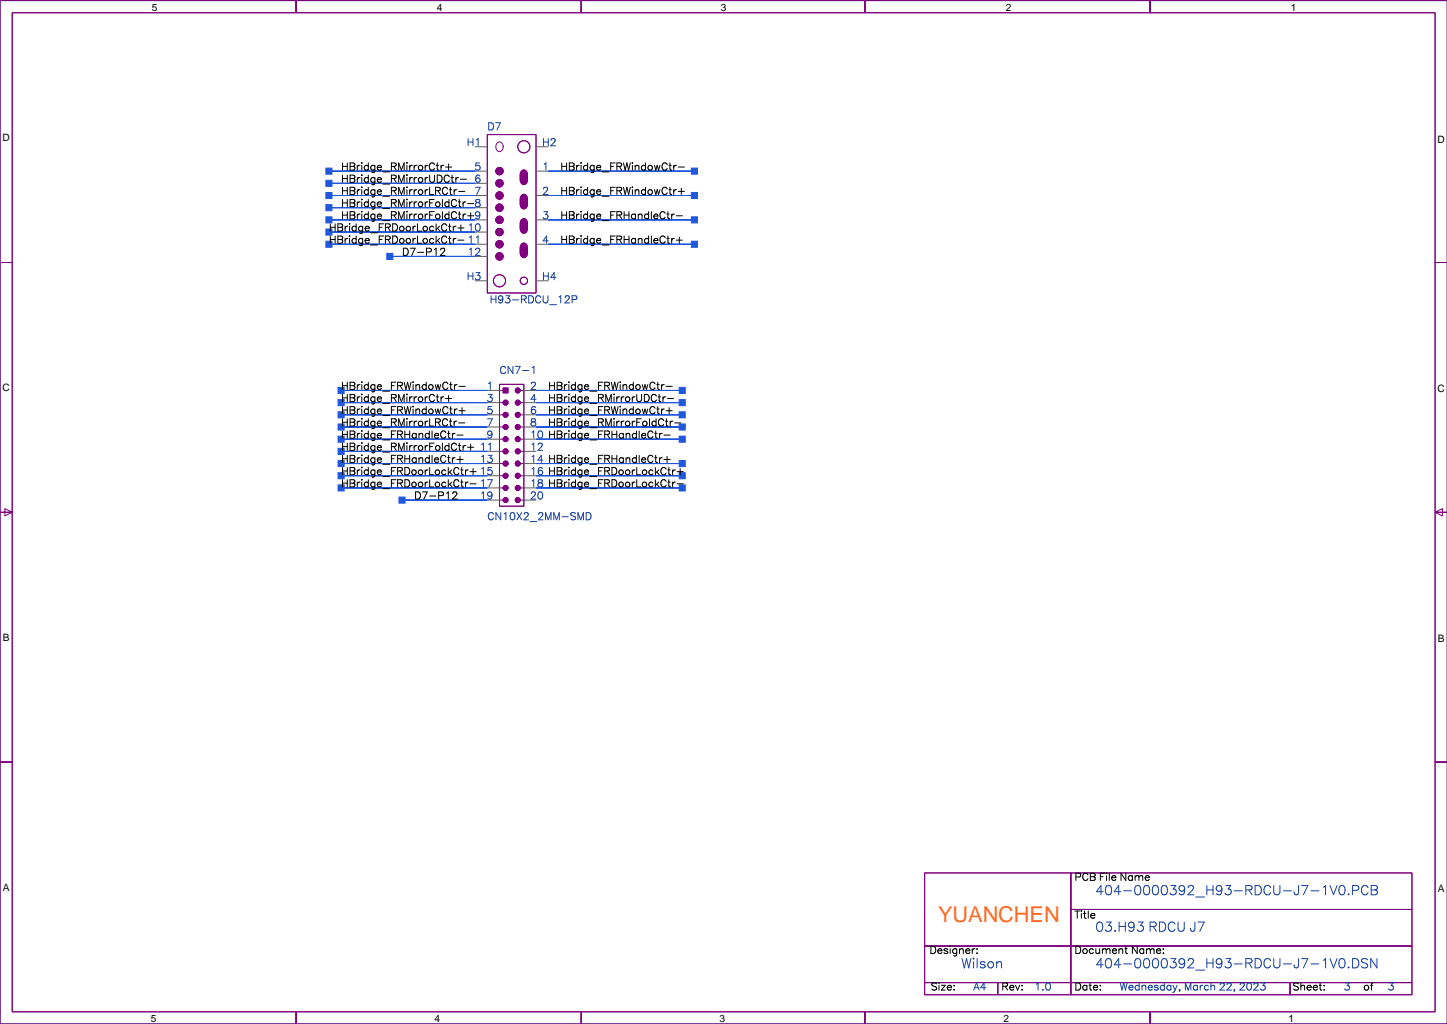
[picture p53: page 9]
Title 03.H93 RDCU J7; 404-0000392_H93-RDCU-J7-1V0.DSN; CN10X2_2MM-SMD; H93-RDCU_12P; HBridge_RMirrorFoldCtr-; HBridge_RMirrorUDCtr-; HBridge_FRWindowCtr+; HBridge_FRWindowCtr-; HBridge_FRDoorLockCtr+; HBridge_FRDoorLockCtr-; HBridge_RMirrorFoldCtr+; HBridge_RMirrorLRCtr-; HBridge_FRHandleCtr+; HBridge_RMirrorCtr+; HBridge_FRHandleCtr-; YUANCHEN

HBridge_FRDoorLockCtr+
HBridge_FRDoorLockCtr- | 11

PCB File Name
404-0000392_H93-RDCU-J7-1V0.PCB

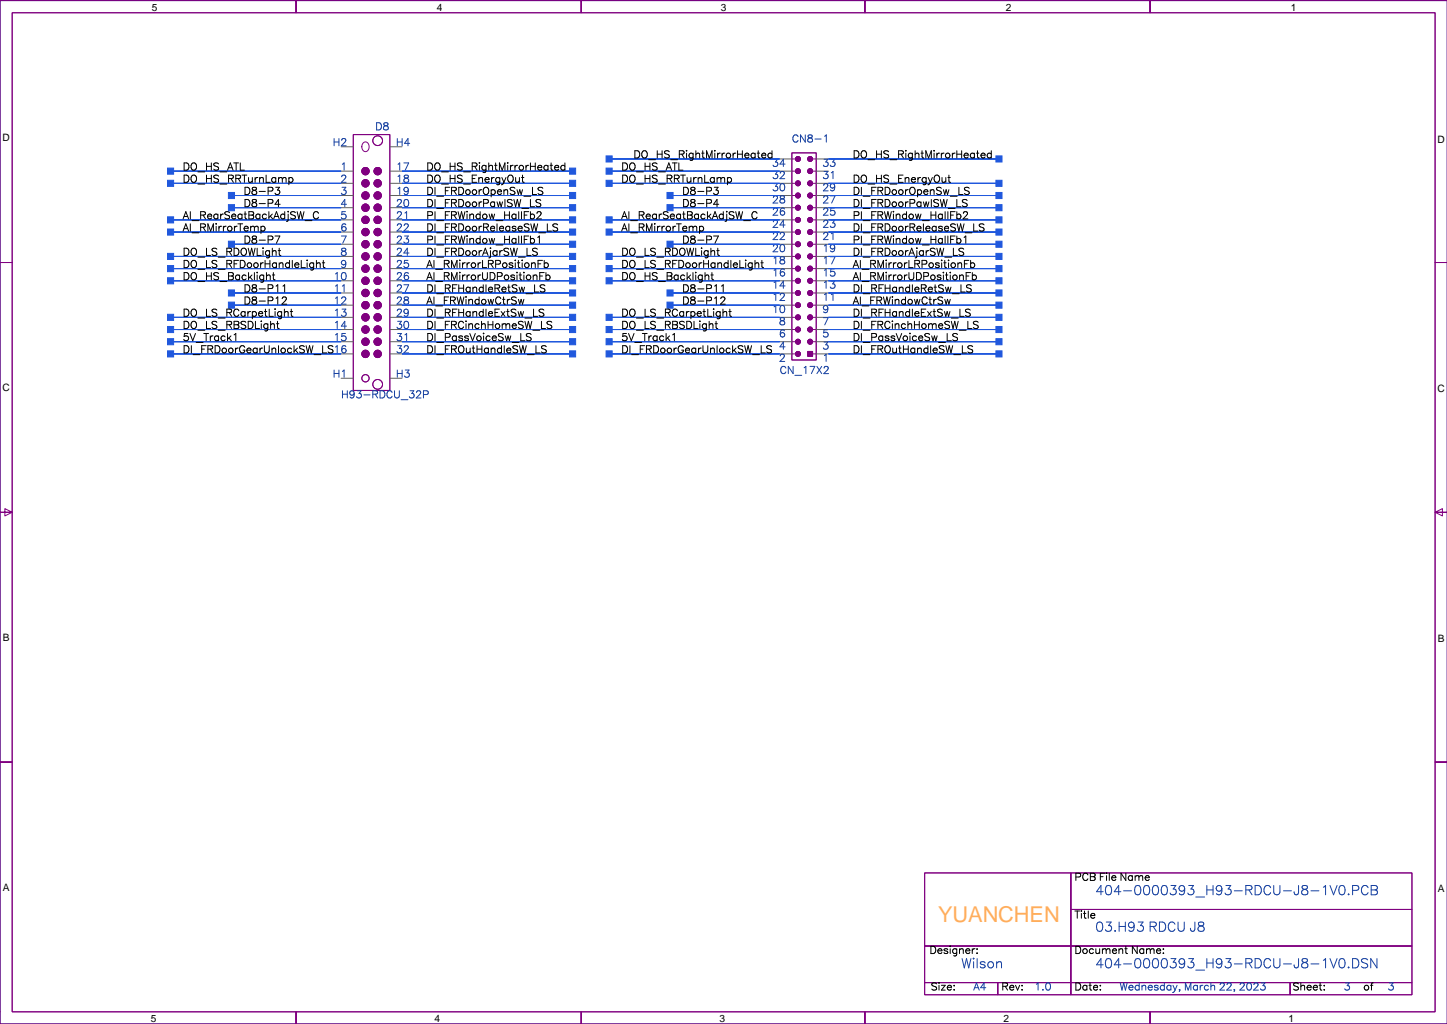
[picture p54: page 10]
Title; 404-0000393_H93-RDCU-J8-1V0.DSN; 03.H93 RDCU J8; H93-RDCU_32P; DI_FRDoorAjarSW_LS; DI_RFHandleRetSw_LS; DO_LS_RCarpetLight; PI_FRWindow_HallFb1; DO_LS_RBSDLight; DO_LS_RDOWLight; DI_FRDoorReleaseSW_LS; AI_RearSeatBackAdjSW_C; PI_FRWindow_HallFb2; 5V_Track1; AI_RMirrorTemp; DI_FRDoorGearUnlockSW_LS; DO_HS_RightMirrorHeated; DO_HS_RRTurnLamp; DI_FROutHandleSW_LS; DI_PassVoiceSw_LS; DI_FRCinchHomeSW_LS; DI_FRDoorPawlSW_LS; DI_RFHandleExtSw_LS; DI_FRDoorOpenSw_LS; DO_LS_RFDoorHandleLight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

PCB File Name
404-0000393_H93-RDCU-J8-1V0.PCB
