Fred-Guo0422/H93_LDCU_EOL_TESTER/document/H93_LDCU/H93-LDCU_产品假连接器原理图/包 1.pdf

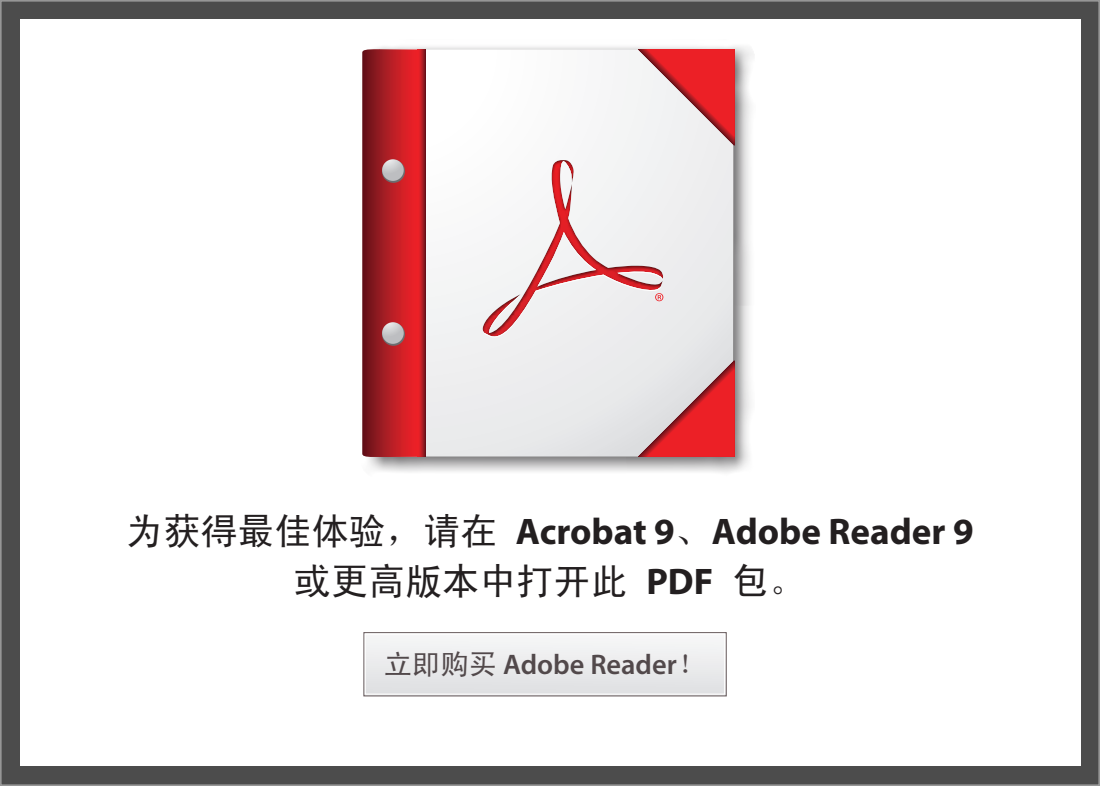
[picture p55: page 1]
或更高版本中打开此 PDF 包。

为获得最佳体验，请在 Acrobat 9、Adobe Reader 9

立即购买 Adobe Reader！ (http://www.adobe.com/go/reader_download_cn)
