Fred-Guo0422/H93_LDCU_EOL_TESTER/(list of files, drawings)

Other design files:
document/H93_LDCU/EOL_Fixture-LDCU/EOL_Fixture-LDRU/0_wiring drawing.SchDoc
document/H93_LDCU/EOL_Fixture-LDCU/EOL_Fixture-LDRU/1_wiring drawing.SchDoc
document/H93_LDCU/EOL_Fixture-LDCU/EOL_Fixture-LDRU/2_wiring drawing.SchDoc
document/H93_LDCU/EOL_Fixture-LDCU/EOL_Fixture-LDRU/3_wiring drawing.SchDoc
document/H93_LDCU/EOL_Fixture-LDCU/EOL_Fixture-LDRU/4_wiring drawing.SchDoc
document/H93_LDCU/EOL_Fixture-LDCU/EOL_Fixture-LDRU/YC0098_JPXP H93 EOL LDRU Fixture wiring drawing.PrjPcb
document/H93_LDCU/H93_LDCU_背板原理图/6_LDCU_connector board(V21_zb).PcbDoc
document/H93_LDCU/LoadBox-L-wiring drawing/LoadBox-L-wiring drawing/0_wiring drawing.SchDoc
document/H93_LDCU/LoadBox-L-wiring drawing/LoadBox-L-wiring drawing/1_wiring drawing.SchDoc
document/H93_LDCU/LoadBox-L-wiring drawing/LoadBox-L-wiring drawing/2_wiring drawing.SchDoc
document/H93_LDCU/LoadBox-L-wiring drawing/LoadBox-L-wiring drawing/3_wiring drawing.SchDoc
document/H93_LDCU/LoadBox-L-wiring drawing/LoadBox-L-wiring drawing/4_wiring drawing.SchDoc
document/H93_LDCU/LoadBox-L-wiring drawing/LoadBox-L-wiring drawing/5_wiring drawing.SchDoc
document/H93_LDCU/LoadBox-L-wiring drawing/LoadBox-L-wiring drawing/XP-LRCU-L LoadBox-wiring drawing.PrjPcb
document/H93_LDCU/YC0098 EOL basetester/0_wiring drawing.SchDoc
document/H93_LDCU/YC0098 EOL basetester/1_wiring drawing.SchDoc
document/H93_LDCU/YC0098 EOL basetester/2_wiring drawing.SchDoc
document/H93_LDCU/YC0098 EOL basetester/3_wiring drawing.SchDoc
document/H93_LDCU/YC0098 EOL basetester/4_wiring drawing.SchDoc
document/H93_LDCU/YC0098 EOL basetester/5_wiring drawing.SchDoc
document/H93_LDCU/YC0098 EOL basetester/YC0098_JPXP H93 EOL BASE Tester wiring drawing.PrjPcb
