Fred-Guo0422/H93_LDCU_EOL_TESTER/(commit log)

2023-03-29 Update 20230329
    [H93_LDCU_V1.4_0327.xlsx]
2023-03-30 Update 230330
    [H93_LDCU_V1.4_0327.xlsx]
2023-03-31 Update 20230331
    [H93_LDCU_V1.4_0327.xlsx]
2023-04-01 Update 0401
    [H93_LDCU_V1.4_0327.xlsx]
2023-04-03 Updata 0403
    [H93_LDCU_V1.4_0327.xlsx, H93_LDCU_V1.4_0403.xlsx]
2023-04-19 Update 0418
    [H93_LDCU_Debug_Testlist.xls, H93_LDCU_V1.4_0403.xlsx, H93_LDCU_V1.4_0406.xlsx, H93_LDCU_V1.4_0408.xlsx, H93_LDCU_V1.4_0408_.xlsx, H93_LDCU_V1.4_0416.xlsx, H93左域EOL设备负载信息V1.4-20230216.xlsx, Report 4-8-2023 15-57-33.xlsx]
2023-04-19 1，增加内部采集 2，增加 write Possess ID
    [H93_LDCU_V1.4_0416.xlsx]
